eSpark-Backup/colebenson-smartmotors/Design-Files-v3.4/LSS_Bottom_Board_v3.4/Renderings/Isometric_View.PNG

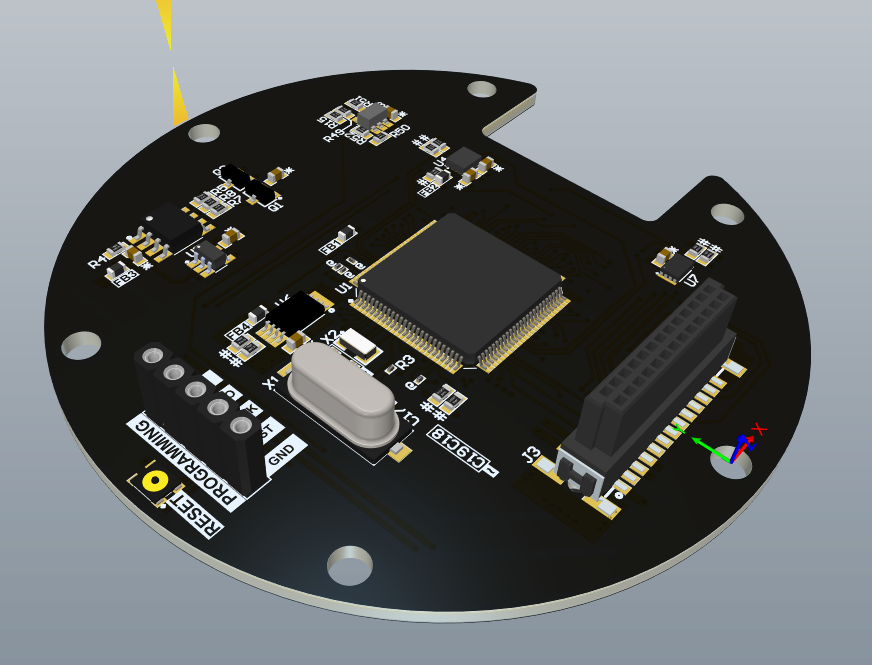
Design-Files-v3.4/LSS_Bottom_Board_v3.4/Renderings/Isometric_View.PNG
