eSpark-Backup/colebenson-smartmotors/Documents/Client-Shared-Files/Sharing-13042021/LSS Pro Board - CAN ICs Selection.pdf

Manufacturer Part Number | Manufacturer | Number of
| | Drivers/Receivers | DuplexData Rate | Voltage - Supply | Receiver Hysteresis | Supplier Device Package | Link
SN65HVD230DR | Texas Instruments | 1/1 | Half | 3V ~ 3.6V | 100mV | 8-SOIC | https://www.digikey.com/product-detail/en/texas-instruments/SN65HVD230DR/296-11654-1-ND/404366
L9616-TR | STMicroelectronics | 1/1 | Half | 4.5V ~ 5.5V | 150mV | 8-SOIC | https://www.digikey.ca/en/products/detail/stmicroelectronics/L9616-TR/715975
TJA1050T/CM,118 | NXP USA Inc. | 1/1 | Half | 4.75V ~ 5.25V | 70mV | 8-SOIC | https://www.digikey.com/products/en/integrated-circuits-ics/interface-drivers-receivers-transceivers/710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
MCP2551-E/SN | Microchip Technology | 1/1 | Half | 4.5V ~ 5.5V | 200mV | 8-SOIC | https://www.digikey.ca/en/products/detail/microchip-technology/MCP2551-E%2FSN/509446?productid=509446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
MAX3051ESA+T | Maxim Integrated | 1/1 | Half | 3.14V ~ 3.47V | 20mV | 8-SOIC | https://www.digikey.ca/en/products/detail/maxim-integrated/MAX3051ESA%2BT/5402433?productid=5402433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
