eSpark-Backup/colebenson-smartmotors/Documents/Client-Shared-Files/Sharing-04042021/JK42HS34-1334 PPM graph .pdf

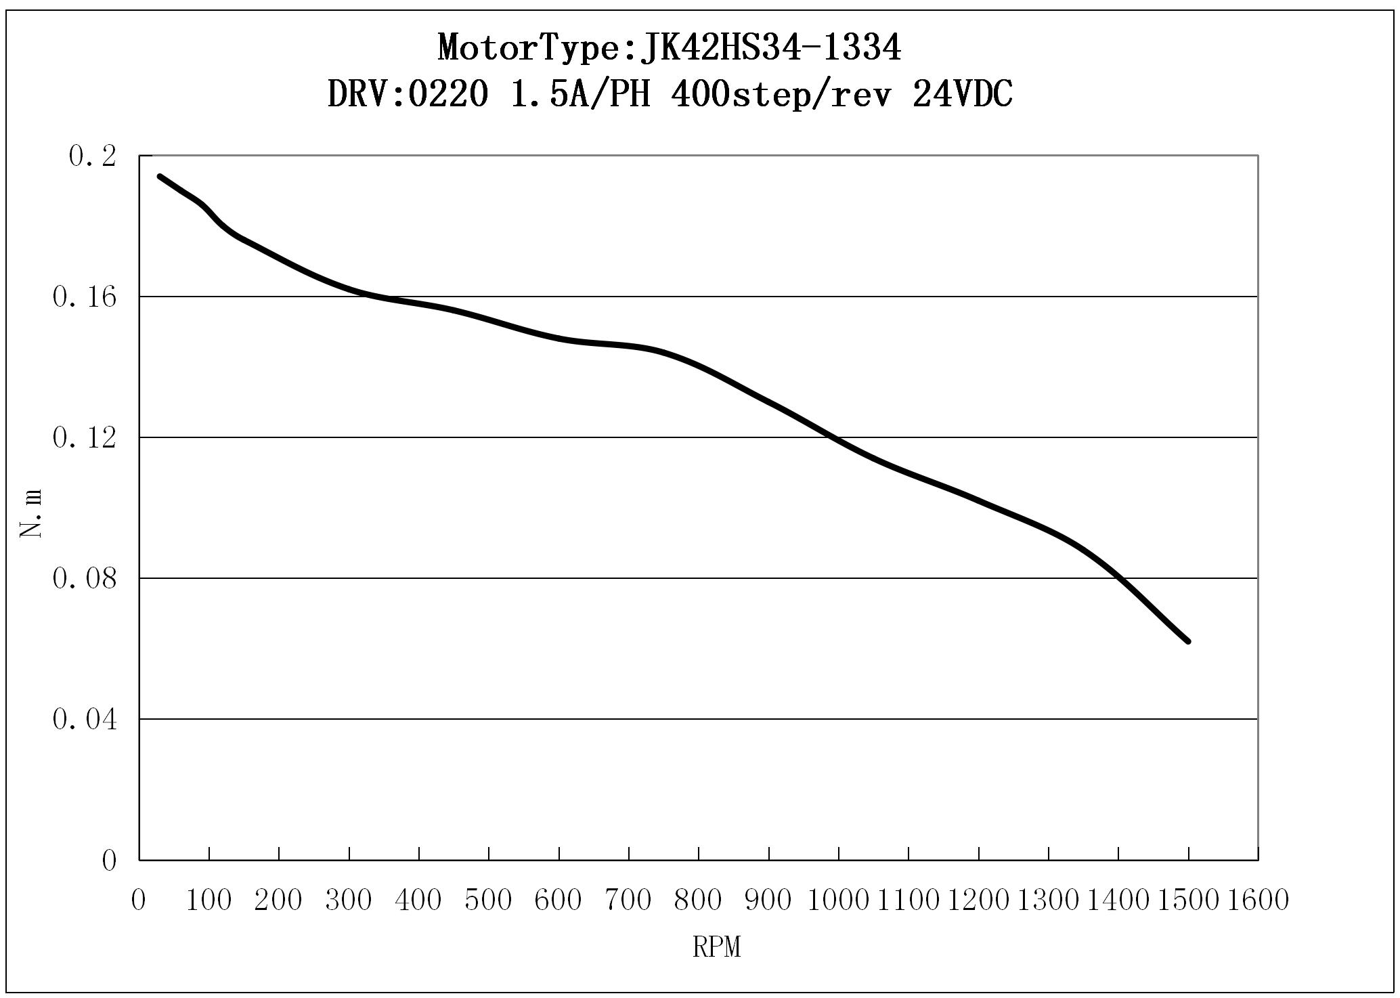
[picture p9: page 1]
