eSpark-Backup/colebenson-smartmotors/Documents/Client-Shared-Files/Sharing-04042021/JK42HS34-1334 torque graph.pdf

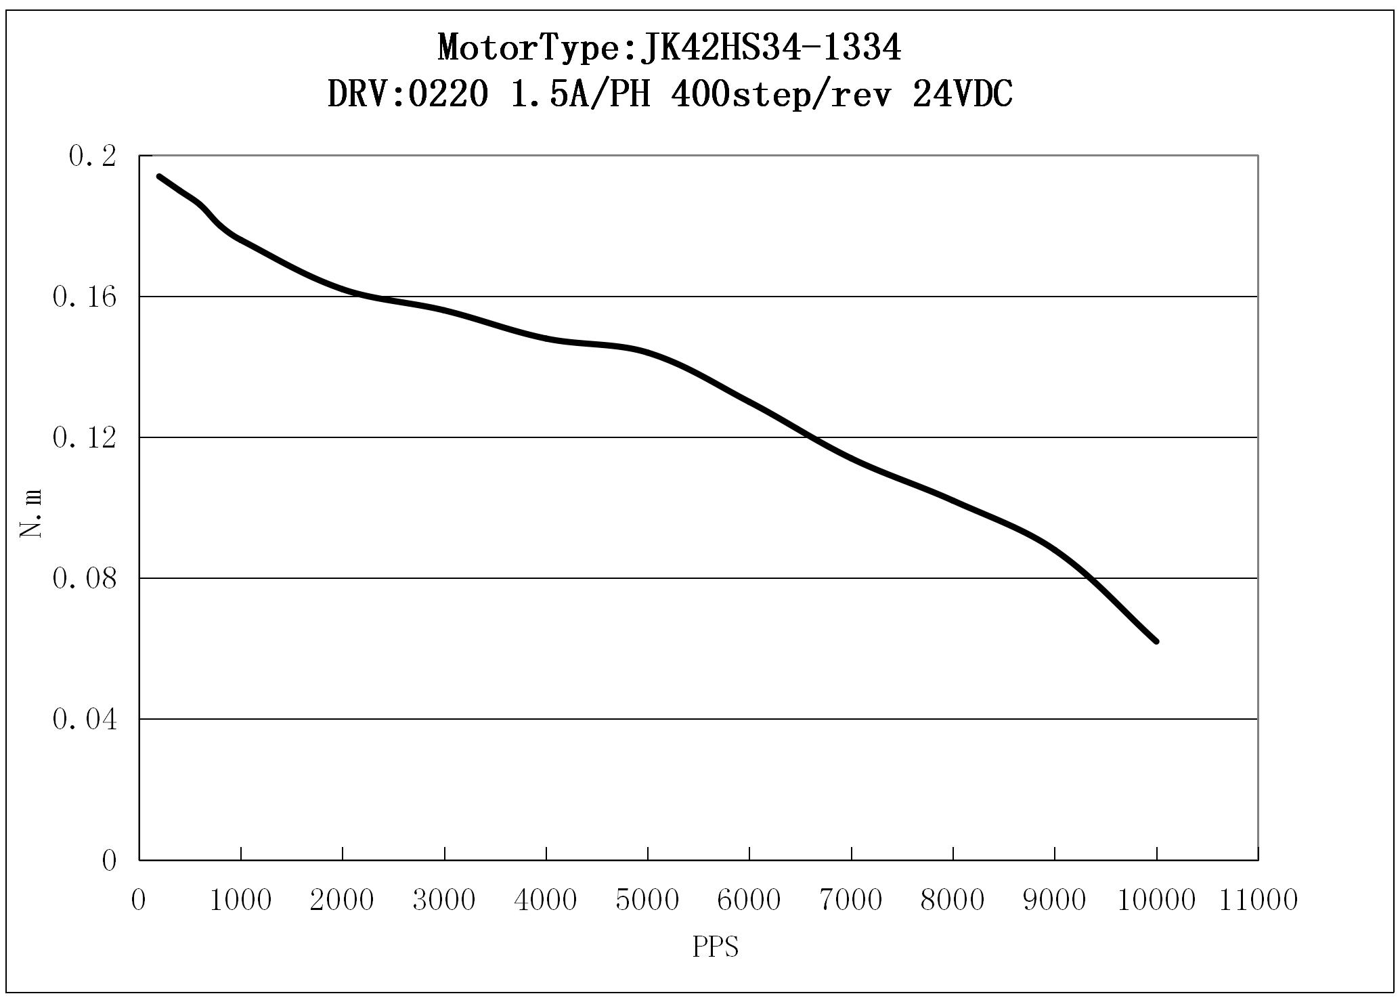
[picture p10: page 1]
