eSpark-Backup/colebenson-smartmotors/Deliverables/SM_Bottom Board/_Renderings/2D_Top_View.PNG

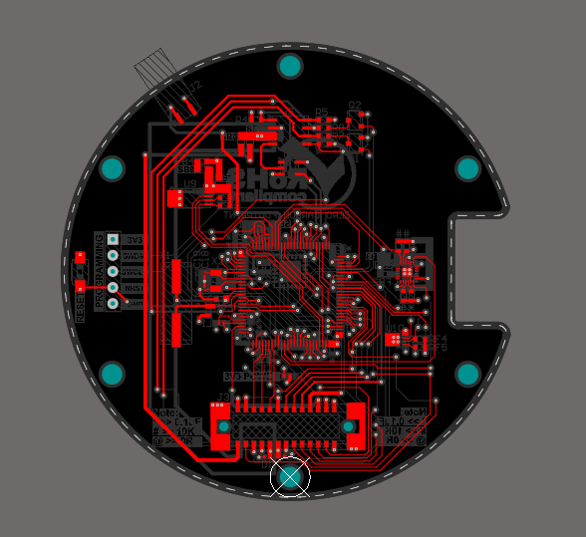
Deliverables/SM_Bottom Board/_Renderings/2D_Top_View.PNG
