eSpark-Backup/colebenson-smartmotors/Deliverables/SM_Bottom Board/_Renderings/3D_Bottom_View.PNG

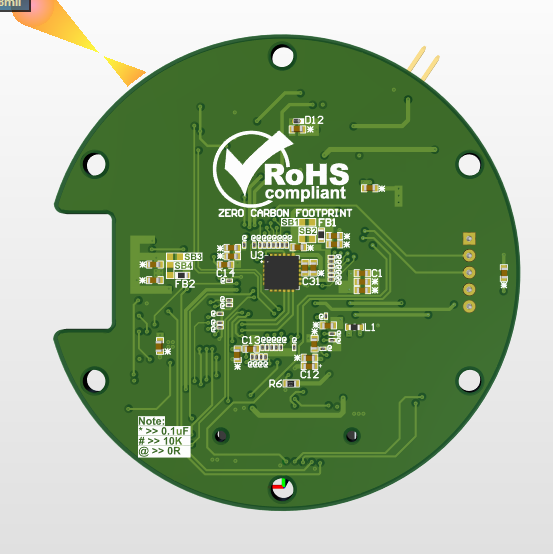
Deliverables/SM_Bottom Board/_Renderings/3D_Bottom_View.PNG
