eSpark-Backup/colebenson-smartmotors/Deliverables/SM_Bottom Board/_Renderings/3D_Isometric.jpg

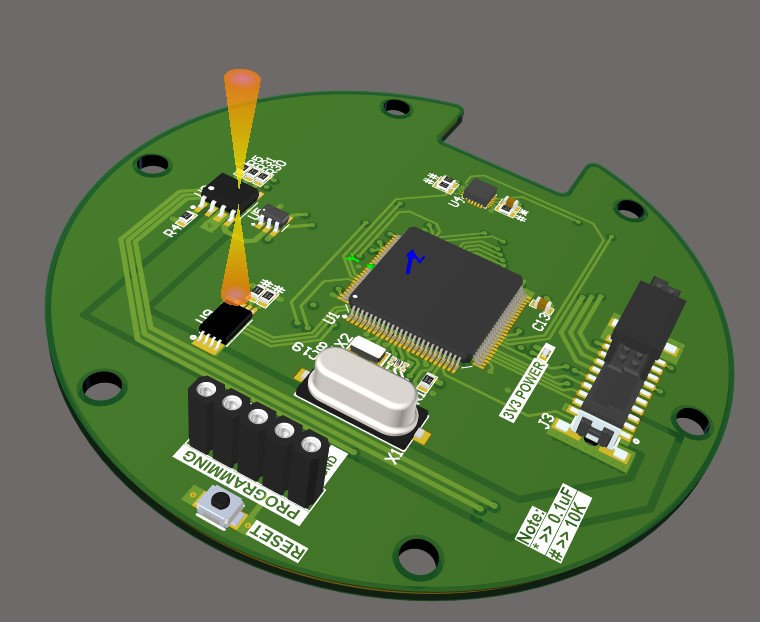
Deliverables/SM_Bottom Board/_Renderings/3D_Isometric.jpg
