eSpark-Backup/colebenson-smartmotors/Deliverables/SM_Bottom Board/_Renderings/3D_Top_View.PNG

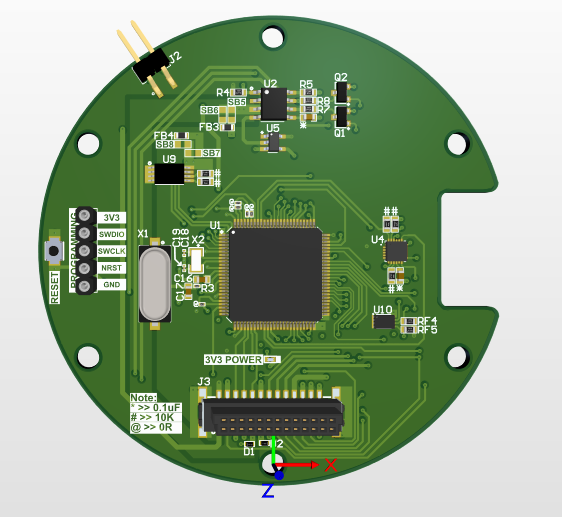
Deliverables/SM_Bottom Board/_Renderings/3D_Top_View.PNG
