eSpark-Backup/colebenson-smartmotors/Deliverables/SM_Bottom Board/_Renderings/GND Plane.jpg

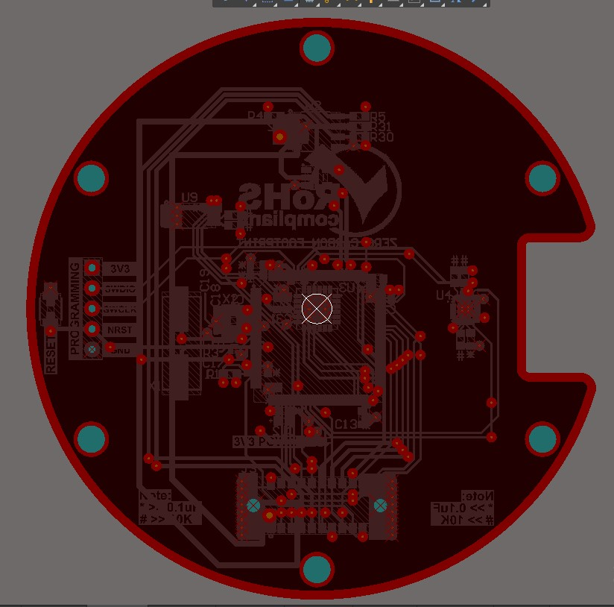
Deliverables/SM_Bottom Board/_Renderings/GND Plane.jpg
