eSpark-Backup/colebenson-smartmotors/Deliverables/SM_Bottom Board/_Renderings/Isometric_View.PNG

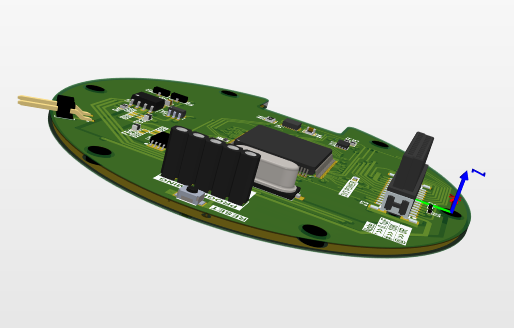
Deliverables/SM_Bottom Board/_Renderings/Isometric_View.PNG
