eSpark-Backup/colebenson-smartmotors/Deliverables/SM_Bottom Board/_Renderings/Top Layer.jpg

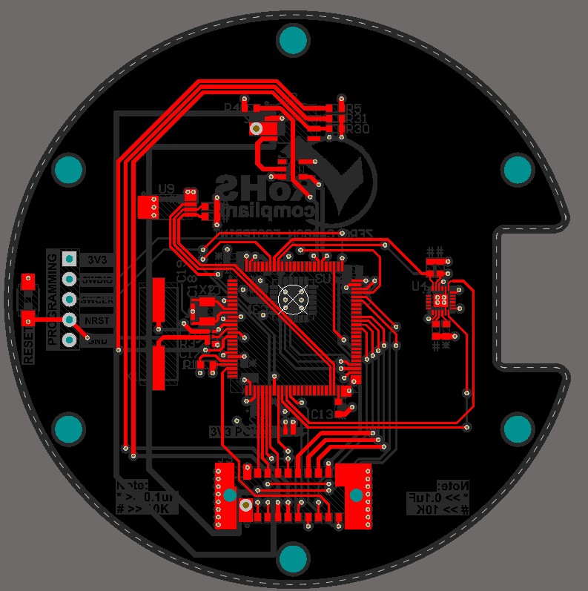
Deliverables/SM_Bottom Board/_Renderings/Top Layer.jpg
