eSpark-Backup/colebenson-smartmotors/Deliverables/SM_Top Board/_Renderings/2D_Top.jpg

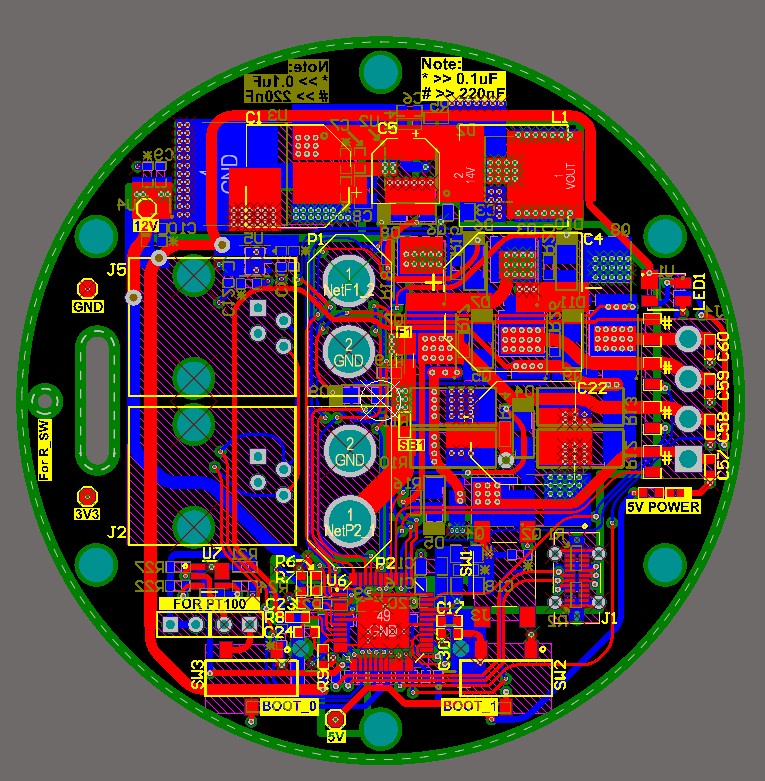
Deliverables/SM_Top Board/_Renderings/2D_Top.jpg
