eSpark-Backup/colebenson-smartmotors/Deliverables/SM_Top Board/_Renderings/3D_Back Edge.jpg

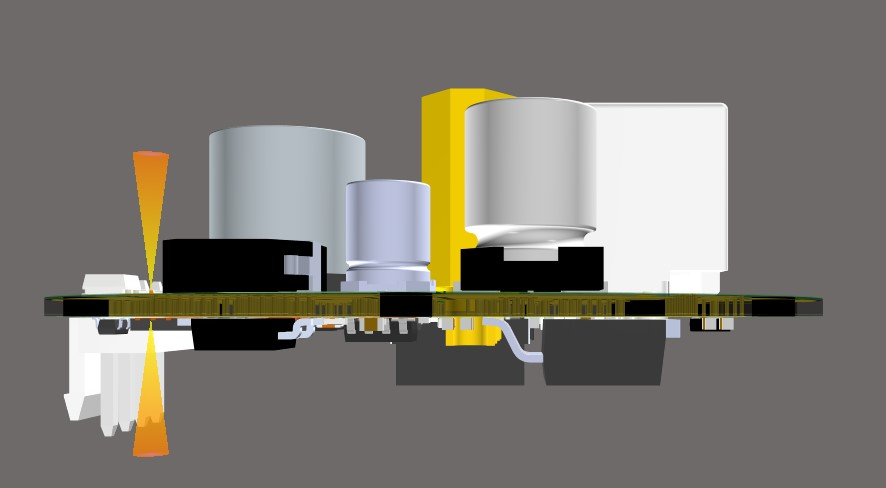
Deliverables/SM_Top Board/_Renderings/3D_Back Edge.jpg
