eSpark-Backup/colebenson-smartmotors/Deliverables/SM_Top Board/_Renderings/3D_Bottom_View.PNG

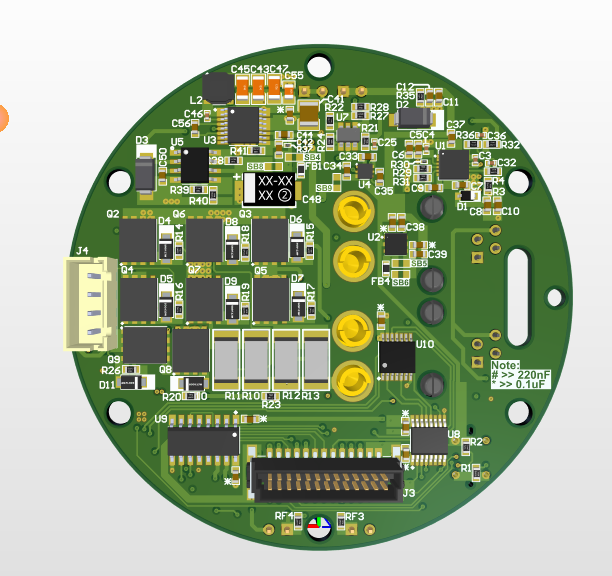
Deliverables/SM_Top Board/_Renderings/3D_Bottom_View.PNG
