eSpark-Backup/colebenson-smartmotors/Deliverables/SM_Top Board/_Renderings/3D_Isometric.jpg

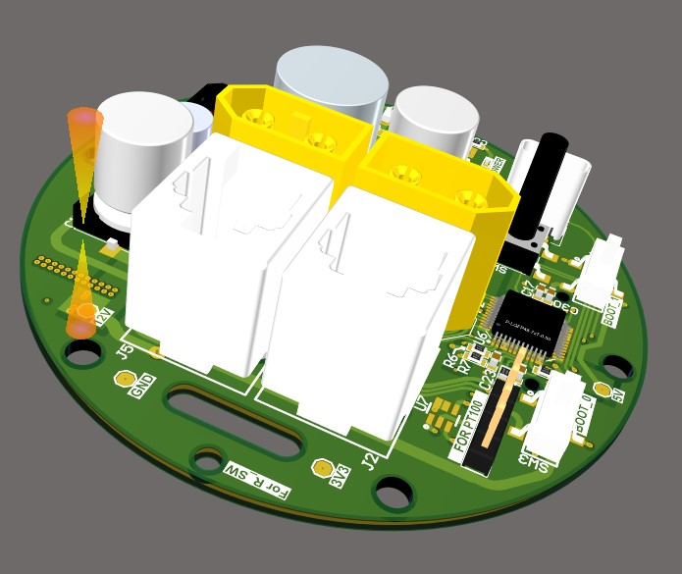
Deliverables/SM_Top Board/_Renderings/3D_Isometric.jpg
