eSpark-Backup/colebenson-smartmotors/Deliverables/SM_Top Board/_Renderings/Bottom_Layer.jpg

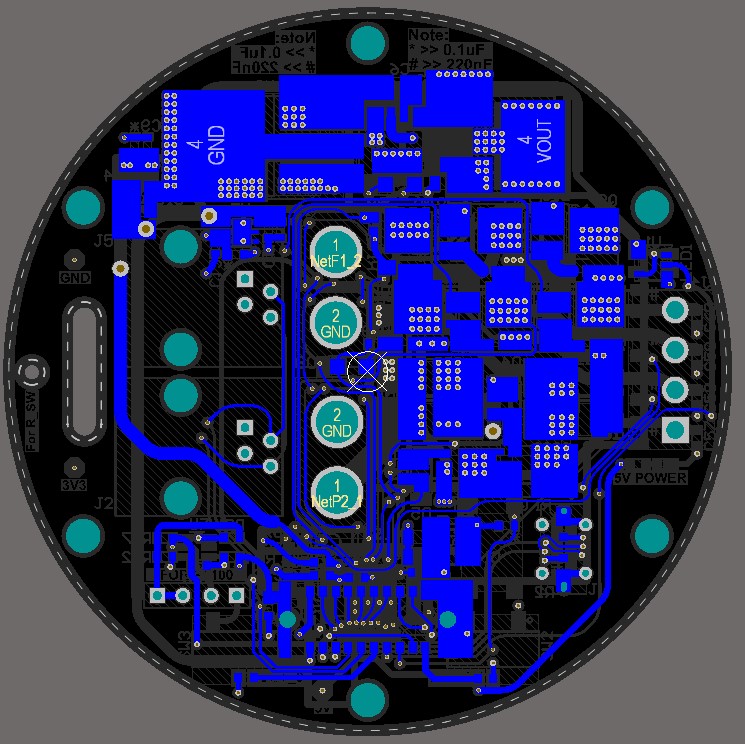
Deliverables/SM_Top Board/_Renderings/Bottom_Layer.jpg
