eSpark-Backup/colebenson-smartmotors/Deliverables/SM_Top Board/_Renderings/Power Plane.jpg

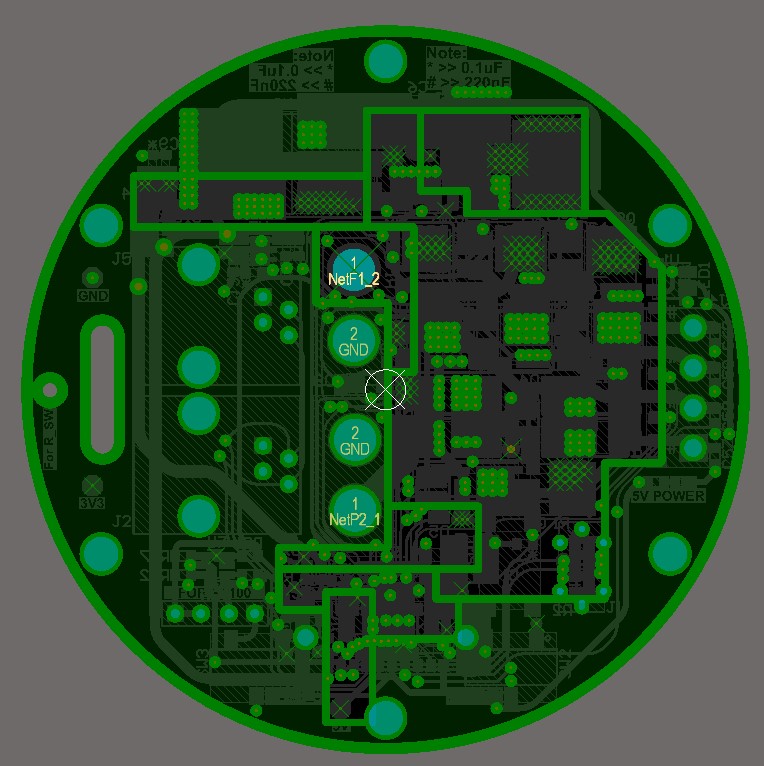
Deliverables/SM_Top Board/_Renderings/Power Plane.jpg
