eSpark-Backup/colebenson-smartmotors/Deliverables/SM_Top Board/_Renderings/Top_Layer.jpg

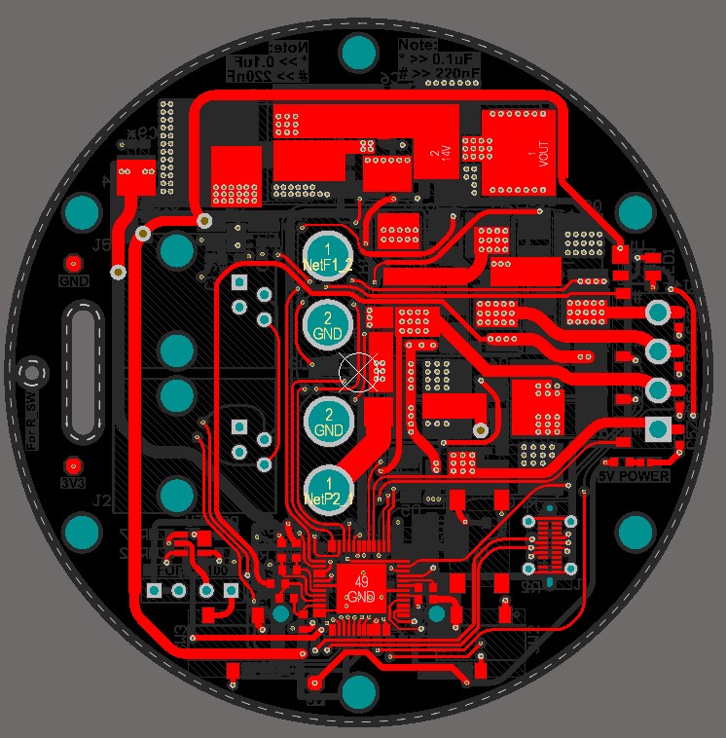
Deliverables/SM_Top Board/_Renderings/Top_Layer.jpg
