eSpark-Backup/colebenson-smartmotors/Design-Files-v3.4/LSS_Sub_Board_v1.1/Renderings/3D_Bottom_View.PNG.png

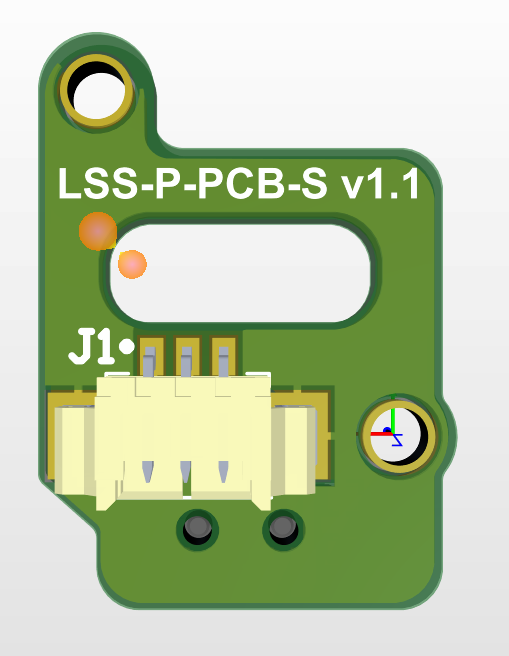
Design-Files-v3.4/LSS_Sub_Board_v1.1/Renderings/3D_Bottom_View.PNG.png
