eSpark-Backup/colebenson-smartmotors/Design-Files-v3.4/LSS_Top_Board_v3.4/Renderings/2D_Bottom_Layer.PNG

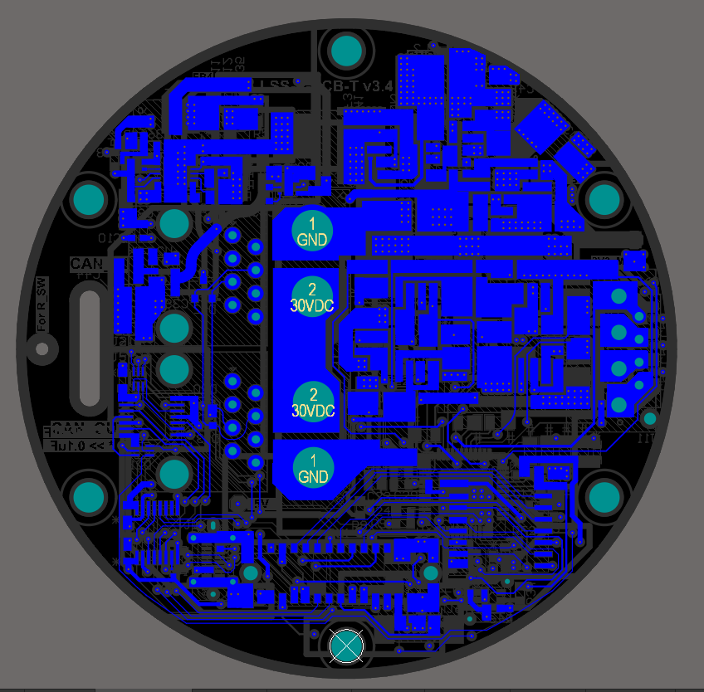
Design-Files-v3.4/LSS_Top_Board_v3.4/Renderings/2D_Bottom_Layer.PNG
