eSpark-Backup/colebenson-smartmotors/Design-Files-v3.4/LSS_Top_Board_v3.4/Renderings/2D_Ground Layer.PNG

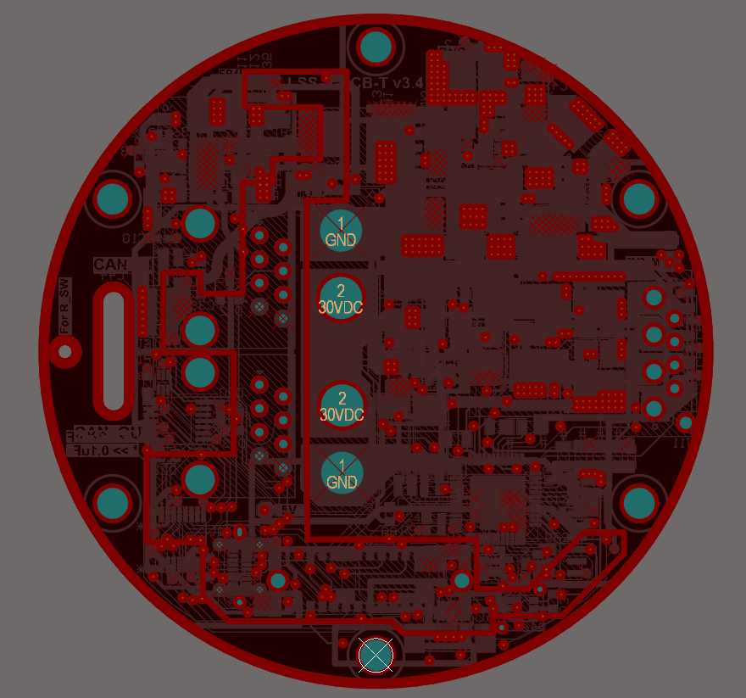
Design-Files-v3.4/LSS_Top_Board_v3.4/Renderings/2D_Ground Layer.PNG
