eSpark-Backup/colebenson-smartmotors/Documents/Client-Shared-Files/Encoder-NoiseCharts/encoder_graph_30V.jpg

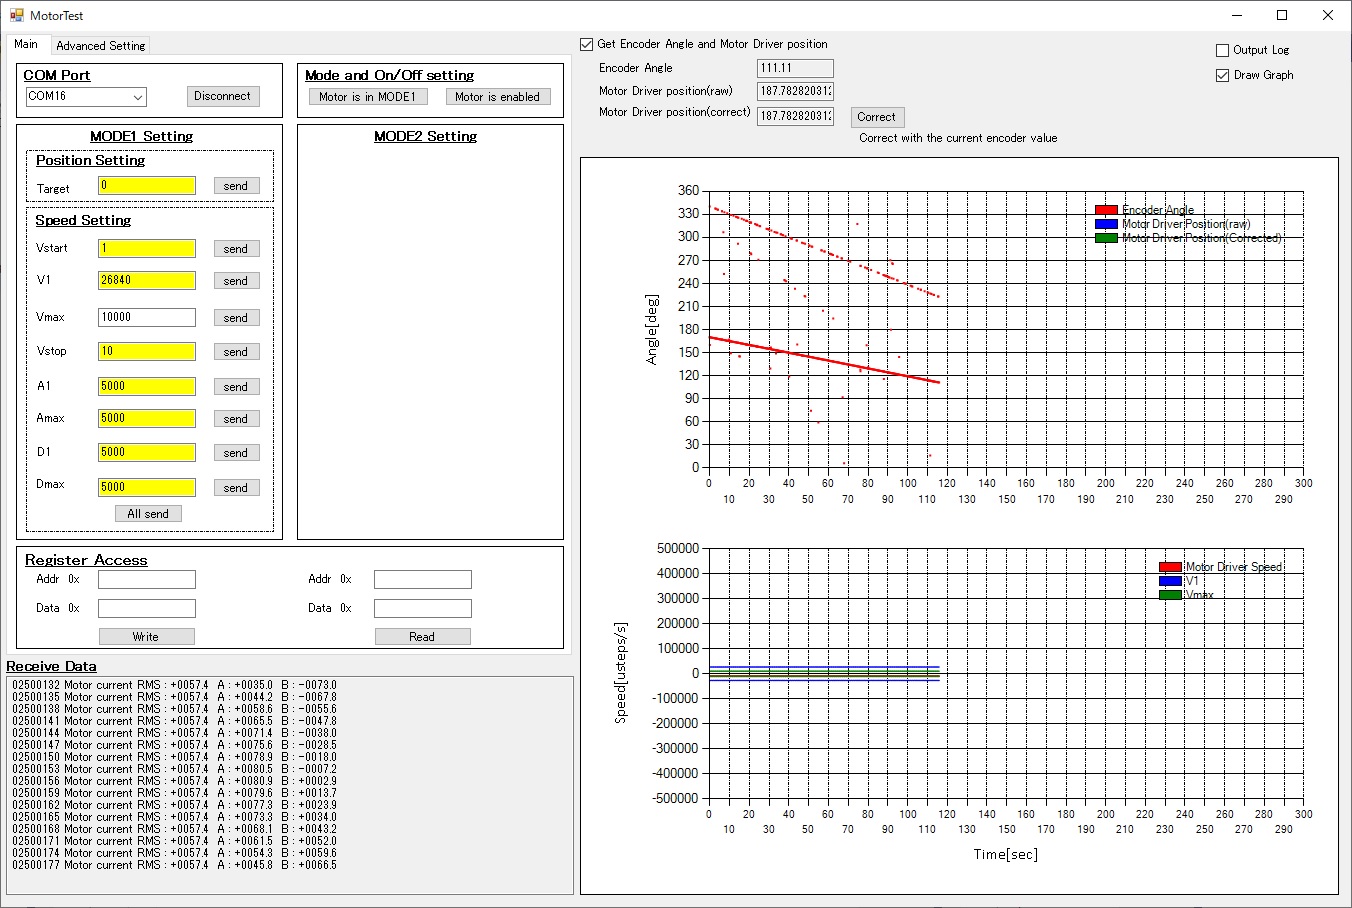
Documents/Client-Shared-Files/Encoder-NoiseCharts/encoder_graph_30V.jpg
