eSpark-Backup/colebenson-smartmotors/Documents/Client-Shared-Files/Sharing-13042021/PRO-PCB-V2 - Incomplete/ele-side-view.png

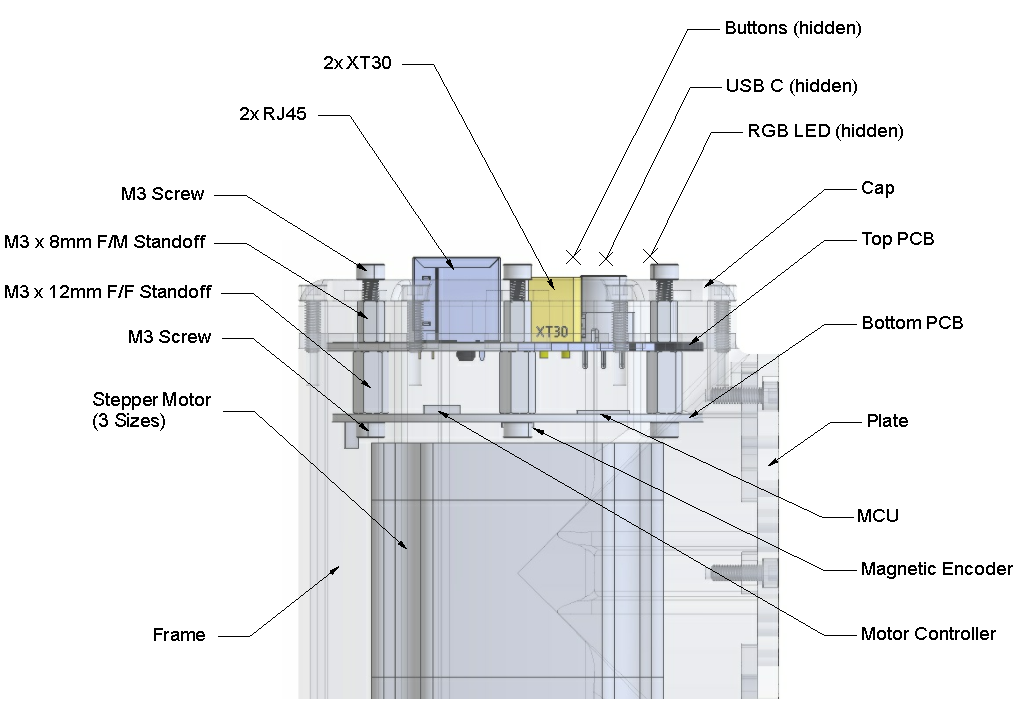
Documents/Client-Shared-Files/Sharing-13042021/PRO-PCB-V2 - Incomplete/ele-side-view.png
