eSpark-Backup/colebenson-smartmotors/Documents/Dev-Shared-Files/Datasheets_Mars/Gyroscoope/Supply voltage query..jpg

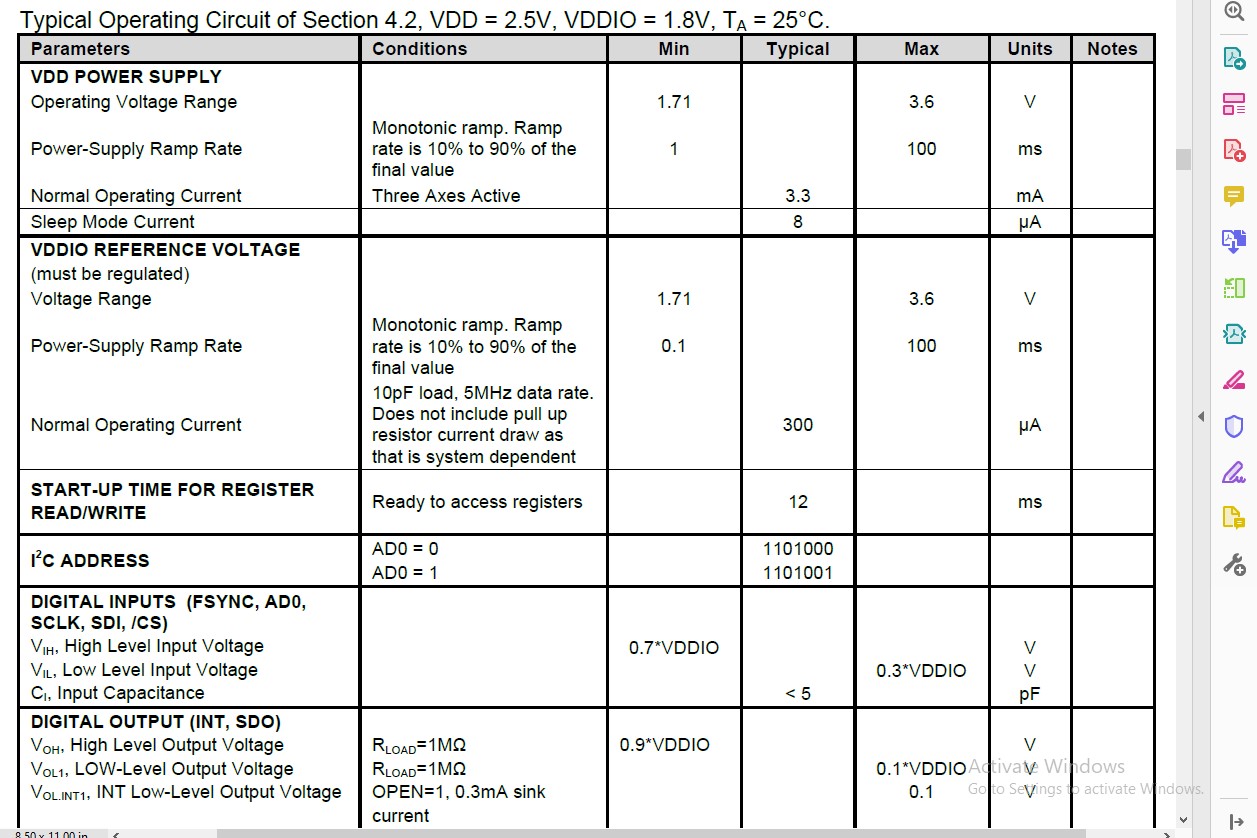
Documents/Dev-Shared-Files/Datasheets_Mars/Gyroscoope/Supply voltage query..jpg
