eSpark-Backup/colebenson-smartmotors/Deliverables/SM_Bottom Board/_BOM/SM_Bottom_PCB.xlsx

Comment | Description | Designator | Footprint | LibRef | Quantity | Case/Package | Manufacturer | Manufacturer Part Number | Package
4.7UF | CAP CER 4.7UF 25V X5R 0603 | C1 | Cap0603 | CL10A475KA8NQNC | 1 | 0603 | Samsung | CL10A475KA8NQNC
0.1UF | Cap Ceramic 0.1uF 50VDC X7R 10% SMD 0603 Paper T/R | C2, C3, C4, C5, C6, C7, C8, C9, C10, C11, C15, C20, C32, C33, C34, C35, C36, C37, C50 | Cap0603 | CL10B104KB8NNNC | 19 | 0603 | Samsung | CL10B104KB8NNNC
1uF | CAP TANT 1UF 20% 25V 0603 | C12 | F981E105MMA | F981E105MMA | 1 | 0603 | Kyocera AVX | F981E105MMA
2.2uF | CAP, 2.2µF, 35V, 10%, X5R, 0603 | C13, C14 | Cap 0603 | GRM188R6YA225KA12D | 2 | 0603 | Murata | GRM188R6YA225KA12D
10pF | CAP CER 10PF 25V C0G 0201 | C16, C17, C18, C19 | CAP 0201 | CGA1A2C0G1E100D030BA | 4 | 0201 | TDK | CGA1A2C0G1E100D030BA
10uF' | CAP CER 10UF 25V X5R 0603 | C31 | Cap0603 | CL10A106MA8NRNC | 1 | 0603 | Samsung | CL10A106MA8NRNC
ESD9L5.0ST5G | TVS DIODE 5V 9.8V SOD923 | D12 | SOD-923 | ESD9L5.0ST5G | 1 | SOD-923-2 | ON Semiconductor | ESD9L5.0ST5G
M55-6012042R | CONN RCPT 1.27MM DUAL SMD 20POS | J3 | M55-6012042R | M55-6012042R | 1 |  | Harwin | M55-6012042R
FBMH1608HL121-TV | Ferrite Beads 120Ohm 25% 100MHz 1.2A 0.13Ohm DCR 0603 Automotive T/R | L1 | IND 0603 | FBMH1608HL121-TV | 1 | 0603 | Taiyo Yuden | FBMH1608HL121-TV
XZVG68W-2 | LED GREEN CLEAR CHIP SMD | LED1 | LED 0402 | XZVG68W-2 | 1 | 0402 | SunLED | XZVG68W-2
TSW-105-17-T-S | CONN HEADER VERT 5POS 2.54MM | P1 | Header 5 | Header 5 pin | 1 |  | Samtec | TSW-105-17-T-S
100R | RES SMD 100 OHM 1% 1/10W 0603 | R1 | Res0603 | RC0603FR-07100RL | 1 | 0603 | Yageo | RC0603FR-07100RL
10K | RES SMD 10K Ohm 1% 1/10W 0603 | R2, R27, RF1, RF2, RF3 | Res0603 | RC0603FR-0710KL | 5 | 0603 | Yageo | RC0603FR-0710KL
806R | Res Thick Film 0201 806 Ohm 1% 1/20W ±200ppm/°C Molded SMD SMD Paper T/R | R3 | Res-0201 | RMCF0201FT806R | 1 | 0201 | Stackpole Electronics | RMCF0201FT806R
1K | RES SMD 1K 0.1W 0603 75 V, Thick Film | R4, R5 | Res0603 | RC0603JR-071KL | 2 | 0603 | Yageo | RC0603JR-071KL
470R | RES SMD 470 OHM 50 V, 0603 100 mW, 1%, | R6 | Res0603 | RC0603FR-07470RL | 1 | 0603 | Yageo | RC0603FR-07470RL
120R | RES SMD 120OHM 0.1W 0603 5%( | R30, R31 | Res0603 | RC0603JR-07120RL | 2 | 0603 | Yageo | RC0603JR-07120RL
K2-1827SR-A3DW-06 | ? EasyEDA Model Description SPST 50mA @ 12VDC Vertical Round Button 3*2.1mm Tactile Switches RoHS | SW1 | K2-1827SR-A3DW-06 | K2-1827SR-A3DW-06 | 1 |  | Korean Hroparts Elec |  | 3*2.1mm
STM32F407VGT7TR | IC MCU 32BIT 1MB FLASH 100LQFP | U1 | LQFP-100 | STM32F407VGT7TR | 1 | LQFP | STMicroelectronics | STM32F407VGT7TR
SN65HVDA1040BQDRQ1 | IC TRANSCEIVER 1/1 8SOIC | U2 | SOIC-8 | SN65HVDA1040BQDRQ1 | 1 |  | Texas Instruments | SN65HVDA1040BQDRQ1
AEAT-8800-Q24 | ROTARY ENCODER MAGNETIC 4096PPR | U3 | QFN-24 | AEAT-8800-Q24 | 1 |  | Broadcom Avago | AEAT-8800-Q24
ICM-20649 | WIDE-FULL SCALE RANGE 6-AXIS MEM | U4 | 24-QFN (3x3) | ICM-20649 | 1 | QFN | TDK InvenSense | ICM-20649
SN74LV1T34DBVR | IC BUF NON-INVERT 5.5V SOT23-5 | U5 | SOT-23-5 | SN74LV1T34DBVR | 1 | SOT-23-5 | Texas Instruments | SN74LV1T34DBVR
MCP9805-BE/ST | IC SENSOR THERMAL 3.0V 8TSSOP | U9 | 8-TSSOP | MCP9805-BE/ST | 1 | TSSOP | Microchip | MCP9805-BE/ST
20MHz | CRYSTAL 20.0000MHZ 18PF SMD | X1 | HCM4920000000ABJT | HCM4920000000ABJT | 1 |  | CITIZEN | HCM4920000000ABJT
ECS-.327-7-34B-C-TR | Crystals 32.768KHz 7pF | X2 | ECS-.327-7-34B-C-TR | ECS-.327-7-34B-C-TR | 1 | SMD/SMT | ECS International | ECS-.327-7-34B-C-TR
