eSpark-Backup/colebenson-smartmotors/Deliverables/SM_Bottom Board/_BOM/Altium_Generated_BOM.xlsx

Comment | Description | Designator | Footprint | LibRef | Quantity | Manufacturer
4.7UF | CAP CER 4.7UF 25V X5R 0603 | C1 | Cap0603 | CL10A475KA8NQNC | 1 | Samsung
0.1UF | Cap Ceramic 0.1uF 50VDC X7R 10% SMD 0603 Paper T/R | C2, C3, C4, C5, C6, C7, C8, C9, C10, C11, C15, C20, C32, C33, C34, C35, C36, C37, C50 | Cap0603 | CL10B104KB8NNNC | 19 | Samsung | same parts
1uF | CAP TANT 1UF 20% 25V 0603 | C12 | F981E105MMA | F981E105MMA | 1 | Kyocera AVX
2.2uF | CAP, 2.2µF, 35V, 10%, X5R, 0603 | C13, C14 | Cap 0603 | GRM188R6YA225KA12D | 2 | Murata
30pF | CAP 30pF NP0 0603 50 V ±5 % SMD | C16, C17 | Cap 0603 | CC0603JRNPO9BN300 | 2 | Yageo
10pF | CAP CER 10PF 25V C0G 0201 | C18, C19 | CAP 0201 | CGA1A2C0G1E100D030BA | 2 | TDK
10uF | CAP CER 10UF 25V X5R 0603 | C31 | Cap0603 | CL10A106MA8NRNC | 1 | Samsung
0.1uF | Cap Ceramic 0.1uF 50VDC X7R 10% SMD 0603 Paper T/R | CF1 | Cap 0603 | CL10B104KB8NNNC | 1 | Samsung
AZ6225-01F.R7GR | Bidirectional 2.5V 3.5V 5V 20A (8/20us) DFN1006P2E TVS RoHS | D1, D2 | AZ6225-01F.R7GR | AZ6225-01F.R7GR | 2 | AMAZING
ESD9L5.0ST5G | TVS DIODE 5V 9.8V SOD923 | D12 | SOD-923 | ESD9L5.0ST5G | 1 | ON Semiconductor
MPZ1608S121ATDH5 | Ferrite Beads Multi-Layer 120Ohm 25% 100MHz 2A 45mOhm DCR 0603 Automotive T/R | FB1, FB2, FB3, FB4 | MPZ1608S121ATDH5 | MPZ1608S121ATDH5 | 4 | TDK
MH254RS-11-02-1000 | 3A Surface Mount Header 1x2 SMD,P=2.54mm Pin Headers ROHS | J2 | MH254RS-11-02-1000 | MH254RS-11-02-1000 | 1 | XFCN
M55-6012642R | CONN RCPT 26POS 0.05 GOLD SMD | J3 | M55-6012642R | M55-6012642R | 1 | Harwin
FBMH1608HL121-TV | Ferrite Beads 120Ohm 25% 100MHz 1.2A 0.13Ohm DCR 0603 Automotive T/R | L1 | IND 0603 | FBMH1608HL121-TV | 1 | Taiyo Yuden
XZVG68W-2 | LED GREEN CLEAR CHIP SMD | LED1 | LED 0402 | XZVG68W-2 | 1 | SunLED
SMC-1-05-1-GT | MACHINE PIN SOCKET 5P 2.54MM PIT | P1 | SMC-1-05-1-GT | SMC-1-05-1-GT | 1 | Adam Equipment
MMBT2222A-7-F | TRANS NPN 40V 0.6A SMD SOT23-3 | Q1, Q2 | SOT-23 | MMBT2222A-7-F | 2 | Diodes
0R | RES SMD 0 OHM JUMPER 1/20W 0201 | R1, R9, R10, R11, R12, R13, R14, R15, R16, R17, R18, R19, R20, R21, R22, R23, R24, R25, R26, R28, R29, R30, R31, R32, R33, R34, R35, R36, R37, R38, R39, R40, R41, R42, R43, R44, R45, R46, R47, R48 | Res-0201 | RC0201JR-070RL | 40 | Yageo
10K | RES SMD 10K Ohm 1% 1/10W 0603 | R2, R27, RF1, RF2, RF3, RF4, RF5 | Res0603 | RC0603FR-0710KL | 7 | Yageo
806R | Res Thick Film 0201 806 Ohm 1% 1/20W ±200ppm/°C Molded SMD SMD Paper T/R | R3 | Res-0201 | RMCF0201FT806R | 1 | Stackpole Electronics
1K | RES SMD 1K 0.1W 0603 75 V, Thick Film | R4, R5 | Res0603 | RC0603JR-071KL | 2 | Yageo
470R | RES SMD 470 OHM 50 V, 0603 100 mW, 1%, | R6 | Res0603 | RC0603FR-07470RL | 1 | Yageo
57R6 | RES SMD 57.6 OHM 1% 1/10W 0603 | R7, R8 | Res0603 | RC0603FR-0757R6L | 2 | Yageo
Solder Bridge | Solder Bridge ON | SB1, SB2, SB3, SB4, SB5, SB6, SB7, SB8 | Solder Bridge | Solder Bridge | 8
B3U-1000P | SWITCH TACTILE SPST-NO 0.05A 12V | SW1 | B3U-1000P | B3U-1000P | 1 | Omron
STM32F407VGT7TR | IC MCU 32BIT 1MB FLASH 100LQFP | U1 | LQFP-100 | STM32F407VGT7TR | 1 | STMicroelectronics
SN65HVDA1040BQDRQ1 | IC TRANSCEIVER 1/1 8SOIC | U2 | SOIC-8 | SN65HVDA1040BQDRQ1 | 1 | Texas Instruments
AEAT-8800-Q24 | ROTARY ENCODER MAGNETIC 4096PPR | U3 | QFN-24 | AEAT-8800-Q24 | 1 | Broadcom Avago
ICM-20649 | WIDE-FULL SCALE RANGE 6-AXIS MEM | U4 | 24-QFN (3x3) | ICM-20649 | 1 | TDK InvenSense
SN74LV1T34DBVR | IC BUF NON-INVERT 5.5V SOT23-5 | U5 | SOT-23-5 | SN74LV1T34DBVR | 1 | Texas Instruments
MCP9805-BE/ST | IC SENSOR THERMAL 3.0V 8TSSOP | U9 | 8-TSSOP | MCP9805-BE/ST | 1 | Microchip
CAT24C32HU4I-GT3 | IC EEPROM 32KBIT I2C 1MHZ 8UDFN | U10 | 8-UDFN-EP (2x3) | CAT24C32HU4I-GT3 | 1 | ON Semiconductor
20MHz | CRYSTAL 20.0000MHZ 18PF SMD | X1 | HCM4920000000ABJT | HCM4920000000ABJT | 1 | CITIZEN
ECS-.327-7-34B-C-TR | Crystals 32.768KHz 7pF | X2 | ECS-.327-7-34B-C-TR | ECS-.327-7-34B-C-TR | 1 | ECS International
