eSpark-Backup/colebenson-smartmotors/Deliverables/SM_Top Board/_BOM/Altium_Generated_BOM.xlsx

Comment | Description | Designator | Footprint | Quantity | Manufacturer | LibRef
220uF | CAP ALUM 220UF 20% 50V SMD | C1 | UCD1H221MNL1GS | 1 | Nichicon | UCD1H221MNL1GS
0.1uF | Cap Ceramic 0.1uF 50VDC X7R 10% SMD 0603 Paper T/R | C2, C13, C51, C52, C53, C54, C61, CF1, CF2 | Cap 0603 | 9 | Samsung | CL10B104KB8NNNC
10nF | CAP CER 10000PF 25V X7R 0402 | C3 | Cap 0402 | 1 | Yageo | CC0402KRX7R8BB103
0.47uF | CAP CER 0.47UF 50V X5R 0402 | C4, C46 | Cap 0402 | 2 | Taiyo Yuden | UMK105ABJ474KV-F
2.2uF | CAP, 2.2µF, 35V, 10%, X5R, 0603 | C5, C6, C14, C23, C24, C29, C34, C35, C56 | Cap 0603 | 9 | Murata | GRM188R6YA225KA12D
1uF | CAP CER 1UF 25V X5R 0603 | C7 | Cap 0603 | 1 | Yageo | CC0603KRX5R8BB105
10uF | CAP CER 10UF 25V X5R 0603 | C8, C10, C11, C12 | Cap 0603 | 4 | Samsung | CL10A106MA8NRNC
82nF | CAP CER 0.082UF 50V X7R 0603 | C9 | Cap 0603 | 1 | Yageo | CC0603KRX7R9BB823
0.1uF | CAP CER 0.1UF 100V X7R 0603 | C15, C20, C40 | Cap 0603 | 3 | Yageo | CC0603KRX7R0BB104
220nF | Cap Ceramic 0.22uF 100V X7R 10% SMD 0805 125°C Embossed T/R | C16, C18, C19, C21 | Cap0805 | 4 | Kyocera AVX | 08051C224K4T2A
22nF | 0603 .022uF 100volts X7R 10% T=0.8mm | C17 | Cap 0603 | 1 | TDK | CGA3E2X7R2A223K080AA
220uF | 220uF ±20% 63V 10mm 14.5mm 1.2A 100kHz 10000hrs 105℃ -55℃~+105℃ SMD,10x14.5mm Aluminum Electrolytic Capacitors - SMD RoHS | C22 | VKME1451J221MV | 1 | Ymin | VKME1451J221MV
0.1UF | CAP CER 0.1UF 50V X7R 0402 | C25, C32 | Cap 0402 | 2 | Samsung | CL05B104KB54PNC
220nF | CAP CER 220nF 35V 0805 | C26, C27, C28, C31 | Cap0805 | 4 | Taiyo Yuden | GMK212BJ224KGHT
0.47uF | CAP CER 0.47uF 50V X7R 0603 | C30 | Cap 0603 | 1 | Taiyo Yuden | UMK107B7474KA-TR
4.7UF | CAP CER 4.7UF 25V X5R 0603 | C33, C38, C39 | Cap 0603 | 3 | Samsung | CL10A475KA8NQNC
1000pF | CAP CER 1000PF 100V X7R 0402 | C36 | Cap 0402 | 1 | Wurth Electronics | 885012205080
2.2nF | CAP CER 2200PF 50V X7R 0603 | C37 | Cap 0603 | 1 | Yageo | CC0603KRX7R9BB222
4.7uF | CAP CER 4.7UF 100V X7S 1210 | C41 | Cap1210 | 1 | Taiyo Yuden | HMK325C7475KN-TE
68pF | Surface Mount Ceramic Multilayer Capacitor 68pF 5% C0G 50V 0603 Paper T/R | C42 | Cap 0603 | 1 | Yageo | CC0603JRNPO9BN680
47uF | CAP CER 1206 47 uF 25 V ±20 % Tol. X5R | C43, C45, C47 | Cap1206 | 3 | Murata | GRM31CR61E476ME44L
20nF | CAP CER 0.02uF 50V X7R 10% SMD 0603 125°C Paper T/R | C44 | Cap 0603 | 1 | Yageo | CC0603KRX7R9BB203
100uF | CAP TANT 100UF 20% 25V 2917 | C48 | CAP- 2917 | 1 | Kyocera AVX | TAJE107M025RNJ
470uF | 470uF ±20% 50V 12.5mm 13.5mm 1000hrs 105℃ -40℃~+105℃ SMD,12.5x13.5mm Aluminum Electrolytic Capacitors - SMD RoHS | C49 | VT1H471MI135000CE0 | 1 | Changzhou Huawei Elec | VT1H471MI135000CE0
470pF | CAP CER 470pF 10% X7R 50V 0603 SMD | C50 | Cap 0603 | 1 | Yageo | CC0603KRX7R9BB471
1uF | CAP CER 1UF 100V X7S 0805 | C55 | Cap0805 | 1 | TDK | C2012X7S2A105K125AB
1nF | CAP CER 1nF 100V X7R 0603 | C57, C58, C59, C60 | Cap 0603 | 4 | Samsung | CL10B102KC8NNNC
CUS10S30,H3F | Diode Schottky 30V 1A Surface Mount USC | D1 | CUS10S30,H3F | 1 | Toshiba | CUS10S30,H3F
SSL110A | 500μA@100V 100V Single 600mV@1A 1A SMA Schottky Barrier Diodes (SBD) ROHS | D2 | SMA | 1 | Yangzhou | SSL110A
SS24A | 40V 500mV@2A 2A SMA(DO-214AC) Schottky Barrier Diodes (SBD) ROHS | D3 | SMA | 1 | Yangzhou | SS24A
PMEG3010ER,115 | DIODE SCHOTTKY 30V 1A SOD123W | D4, D5, D6, D7, D8, D9, D10, D11 | SOD-123W | 8 | Nexperia | PMEG3010ER,115
0685H9150-01 | FUSE BOARD MNT 15A 125VAC 32VDC | F1 | 0685H9150-01 | 1 | Bel | 0685H9150-01
MPZ1608S121ATDH5 | Ferrite Beads Multi-Layer 120Ohm 25% 100MHz 2A 45mOhm DCR 0603 Automotive T/R | FB1, FB2, FB3, FB4 | MPZ1608S121ATDH5 | 4 | TDK | MPZ1608S121ATDH5
MC-318 | Receptacle USB - Type C 24 - SMD USB Connectors ROHS | J1 | MC-318 | 1 | SOFNG | MC-318
5520425-2 | Conn RJ-25 F 6 POS 2.54mm Solder ST Thru-Hole 4 Terminal 1 Port Tray Cat 3 | J2, J5 | 5520425-2 | 2 | TE Connectivity | 5520425-2
M55-7012642R | CONN HEADER SMD 26POS 1.27MM | J3 | M55-7012642R | 1 | Harwin | M55-7012642R
B4B-XH-A(LF)(SN) | CONN HEADER VERT 4POS 2.5MM | J4 | B4B-XH-A(LF)(SN) | 1 | JST | B4B-XH-A(LF)(SN)
220uH | Inductor Power Shielded Wirewound 220uH 20% 1KHz Ferrite 1.3A 310mOhm DCR Blister T/R | L1 | SLF12575T-221M1R3-PF | 1 | TDK | SLF12575T-221M1R3-PF
15uH | 1A 15uH ±20% 190mΩ SMD Power Inductors ROHS | L2 | MPIT4018-150M-LF | 1 | microgate | MPIT4018-150M-LF
LTST-G683GEBW | Standard LEDs - SMD SMD LED Red/Grn/Blue 625/1550/260 mcd | LED1 | LTST-G683GEBW | 1 | Vishay Lite-On | LTST-G683GEBW
XZVG68W-2 | LED GREEN CLEAR CHIP SMD | LED2 | LED 0402 | 1 | SunLED | XZVG68W-2
PRT-10474 | XT60 CONNECTORS MALE/FEMALE PAIR | P1, P2 | PRT-10474 | 2 | SparkFun | PRT-10474
Test Point | Test Point ON | P3, P4, P5, P6 | TEST POINT | 4 |  | TEST POINT
61300211121 | CONN HEADER VERT 2POS 2.54MM | P7, P8, P9, P10 | HDR1X2 | 4 | Wurth Electronics | Header 1x2
BSC072N08NS5ATMA1 | MOSFET N-CH 80V 74A 8TDSON | Q2, Q3, Q4, Q5, Q6, Q7, Q8, Q9 | 8-PowerTDFN | 8 | Infineon | BSC072N08NS5ATMA1
5.1K | RES SMD 5.1K OHM 5% 1/10W 0603 | R1, R2 | Res0603 | 2 | Yageo | RC0603JR-075K1L
3.9K | Res 0603 3.9K Ohm 1% 0.1W(1/10W) ±100ppm/°C Pad SMD T/R | R3 | Res0603 | 1 | Yageo | RC0603FR-073K9L
2K | RES SMD 2K OHM 1% 1/10W 0603 | R4, R35, R39 | Res0603 | 3 | Yageo | RC0603FR-072KL
0R | RES SMD 0R, 1%, 0.1W, 0603 | R5, R32 | Res0603 | 2 | Yageo | RC0603FR-070RL
47R | RES SMD 47OHM 0.1W 0603 | R6, R7, R8, R9 | Res0603 | 4 | Yageo | RC0603FR-0747RL
33m | 0.033Ω ±1% 2W ±1800ppm/°C 2512 Low Resistors & Current Sense Resistors - Surface Mount RoHS | R10, R11, R12, R13 | RES 2512 | 4 | Ever Ohms Tech | CRH2512FR033E04Z
150R | RES SMD 150OHM 1/10W 0603 | R14, R15, R16, R17, R18, R19, R20, R26 | Res0603 | 8 | Yageo | RC0603FR-07150RL
3.01K | RES SMD 3.01K OHM 1% 1/10W 0603 | R21 | Res0603 | 1 | Panasonic | ERJ3EKF3011V
11K | RES SMD 11K, 1%, 0.1W, 0603 | R22 | Res0603 | 1 | Yageo | RC0603FR-0711KL
2R2 | RES SMD 2.2OHM 0603 | R23 | Res0603 | 1 | Panasonic | ERJ3GEYJ2R2V
12.4K | RES SMD 12.4K OHM 1% 1/10W 0603 | R24 | Res0603 | 1 | Yageo | RC0603FR-0712K4L
143R | RES SMD 143 OHM 1% 1/10W 0603 | R25 | Res0603 | 1 | Panasonic | ERJ-3EKF1430V
11.8K | RES SMD 11.8K OHM 1% 1/10W 0603 | R27 | Res0603 | 1 | Yageo | AC0603FR-0711K8L
105K | RES SMD 105K OHM 1% 1/10W 0603 | R28 | Res0603 | 1 | Yageo | RC0603FR-07105KL
127K | RES SMD 127K OHM 1% 1/10W 0603 | R29 | Res0603 | 1 | Yageo | RT0603FRE07127KL
10K | RES SMD 10K OHM 1% 1/20W 0201 | R30 | Res-0201 | 1 | Yageo | RC0201FR-0710KL
301K | RES SMD 301K OHM 0.1% 1/10W 0603 | R31 | Res0603 | 1 | Yageo | RT0603BRE07301KL
240R | Res Thick Film 0603 240 Ohm 1% 1/10W +/-100ppm/ßC Molded SMD Paper T/R | R33, R34 | Res0603 | 2 | Yageo | RC0603FR-07240RL
51.1K | Res SMD 0603 51.1K Ohm 0.1% 1/10W | R36 | Res0603 | 1 | Panasonic | ERA3AEB5112V
1M | RES SMD 1M OHM 1% 1/20W 0201 | R37 | Res-0201 | 1 | Yageo | RC0201FR-071ML
90.9K | Res SMD 0603 90.9K Ohm 1% 1/10W | R38 | Res0603 | 1 | Panasonic | ERJ3EKF9092V
1.2K | ±1% 1/10W Thick Film Resistors 75V ±100ppm/℃ -55℃~+155℃ 1.2kΩ 0603 Chip Resistor - Surface Mount ROHS | R40 | Res0603 | 1 | UNI-ROYAL | 0603WAF1201T5E
0.33R | ±1% 1/10W Thick Film Resistors 75V ±600ppm/℃ -55℃~+155℃ 0.33Ω 0603 Chip Resistor - Surface Mount ROHS | R41 | Res0603 | 1 | RALEC | RTT03R330FTP
10K | RES SMD 10K Ohm 1% 1/10W 0603 | RF1, RF2, RF3, RF4 | Res0603 | 4 | Yageo | RC0603FR-0710KL
Solder Bridge | Solder Bridge ON | SB1, SB2, SB3, SB4, SB5, SB6, SB7, SB8, SB9, SB10, SB11 | Solder Bridge | 11 |  | Solder Bridge
Tactile Switch 13mm Actuator | Memontary Tactile Push Button Switch 6X6X4.3 / 4.5 / 5/6/7/8/9/10 / 13mm SMD | SW1 | Tactile Switch 13mm Actuator | 1 | WIN ELEC-TECH CO., LTD | Tactile Switch 13mm Actuator
750314597 | XFRMR ISOL BUCK DC/DC CONV SMD | T1 | 750314597 | 1 | Wurth Electronics Midcom | 750314597
LM5160ADNTR | IC REG BUCK FLYBCK ADJ 12WSON | U1 | LM5160ADNTR | 1 | Texas Instruments | LM5160ADNTR
NCP708MU330TAG | IC REG LINEAR 3.3V 1A 6UDFN | U2 | 6-UDFN (3x3) | 1 | ON Semiconductor | NCP708MU330TAG
LM43603PWPR | 3.5V to 36V, 3A Synchronous Step-Down Voltage Converter 16-HTSSOP -40 to 125 | U3 | HTSSOP-16 | 1 | Texas Instruments | LM43603PWPR
TPS60150DRVR | IC REG CHARGE PUMP 5V 140MA 6SON | U4 | TPS60150DRVR | 1 | Texas Instruments | TPS60150DRVR
MC34063ADR | 1.5-A boost, buck, inverting switching regulator, operation from 0°C to 70°C 8-SOIC 0 to 70 | U5 | SOIC-8 | 1 | Texas Instruments | MC34063ADR
TMC5160A-TA-T | IC MTR DRVR BIPOLAR 8-60V 48TQFP | U6 | 48-tqfp-ep (7x7) | 1 | Trinamic | TMC5160A-TA-T
MAX4236EUT+T | IC OPAMP GP 1.7MHZ RRO SOT23-6 | U7 | SOT-23-6 | 1 | Maxim | MAX4236EUT+T
ISO7741QDBQQ1 | DGTL ISO 3000VRMS 4CH 16SSOP | U8 | ISO7741QDBQQ1 | 1 | Texas Instruments | ISO7741QDBQQ1
MAX14850ASE+ | DGTL ISO 600VRMS 6CH GP 16SOIC | U9 | MAX14850ASE+ | 1 | Maxim | MAX14850ASE+
SN74LVTH125PWR | IC BUS BUFFER TRI-ST QD 14TSSOP | U10 | SN74LVTH125PWR | 1 | Texas Instruments | SN74LVTH125PWR
