eSpark-Backup/colebenson-smartmotors/Documents/Client-Shared-Files/Sharing-13042021/LSS Pro Board  - BOM & Cost-incomplete.xlsx

Sheet: LSS Pro V0.2 BOM DK vs LCSC (Wo
LSS Pro Board V0.2 |  |  |  |  |  |  |  |  | 1 | 100
Part | QTY/Bd | MF SKU | Digikey SKU | Value | Manufacturer | Package | Description | Digikey | Unit Price (USD) | 100qty Price (USD) | Total Unit Price (USD) | Total 100qty Price (USD) | LCSC | Unit Price (USD) | 100qty Price (USD) | Total Unit Price (USD) | Total 100qty Price (USD) | Diff (DK-LCSC) | Chosen Source | ROHS | 100qty Price (USD) | Total 100qty Price (USD) | Packaging | Qty ordered | Order Note
Top PCB
 | 2 | A-2014-2S-4-N-R | AE10399-ND | - | Assmann WSW Components | - | CONN MOD JACK 8P8C VERT SHIELDED | https://www.digikey.ca/en/products/detail/assmann-wsw-components/A-2014-2S-4-N-R/2183650
 | 1 | 10132328-10011LF | 609-5380-1-ND | - | Amphenol ICC (FCI) | - | CONN RCPT USB3.1 TYPEC 24POS SMD | https://www.digikey.ca/en/products/detail/amphenol-icc-fci/10132328-10011LF/8555651
 | 1 | D6R90 F2 LFS | 401-1995-ND | - | C&K | - | SWITCH PUSH SPST-NO 0.1A 32V | https://www.digikey.ca/en/products/detail/c-k/D6R90-F2-LFS/1466352
Bottom PCB
U1 | 1 | STM32F413VGT6 | 497-17009-ND | - | STMicroelectronics | LQFP-100 | IC MCU 32BIT 1MB FLASH 100LQFP | https://www.digikey.ca/product-detail/en/stmicroelectronics/STM32F413VGT6/497-17009-ND/6564701 | 11.15 | 8.34 | 11.15 | 834.00 | - | - | - | - | - | - | https://www.digikey.ca/product-detail/en/stmicroelectronics/STM32F413VGT6/497-17009-ND/6564701 | TRUE | 8.34 | 834.00 | Tray |  | 0 stock DK/LCSC
U2 | 1 | AEAT-8800-Q24 | 516-3787-ND | - | Broadcom Limited | QFN-24 | ROTARY ENCODER MAGNETIC 4096PPR | https://www.digikey.ca/product-detail/en/broadcom-limited/AEAT-8800-Q24/516-3787-ND/6681014 | 8.00 | 5.99 | 8.00 | 599.00 | - | - | - | - | - | - | https://www.digikey.ca/product-detail/en/broadcom-limited/AEAT-8800-Q24/516-3787-ND/6681014 | TRUE | 5.99 | 599.00 | CT
U3 | 1 | POWERSTEP01 | 497-15441-ND | - | STMicroelectronics | VFQFPN-89 | IC MTR DRV BIPLR 3.3/5V 89VFQFPN | https://www.digikey.ca/product-detail/en/stmicroelectronics/POWERSTEP01/497-15441-ND/5237153 | 10.71 | 7.65 | 10.71 | 765.00 | https://lcsc.com/product-detail/Motor-Drivers_STMicroelectronics-POWERSTEP01_C80192.html | 10.35 | 8.49 | 10.35 | 849.00 | -84.00 | https://www.digikey.ca/product-detail/en/stmicroelectronics/POWERSTEP01/497-15441-ND/5237153 | TRUE | 7.65 | 765.00 | Tray
U4 | 1 | ICM-20600 | 1428-1147-1-ND | - | TDK InvenSense | LGA-14 | LOW-POWER, HIGH-PERFORMANCE INTE | https://www.digikey.ca/product-detail/en/tdk-invensense/ICM-20600/1428-1147-1-ND/9602942 | 3.70 | 2.01 | 3.70 | 201.00 | https://lcsc.com/product-detail/Motion-Sensors-Accelerometers_TDK-InvenSense-ICM-20600_C124140.html | 1.42 | 0.93 | 1.42 | 93.00 | 108.00 | https://lcsc.com/product-detail/Motion-Sensors-Accelerometers_TDK-InvenSense-ICM-20600_C124140.html | TRUE | 0.93 | 93.00 | CT
U5, U6 | 2 | SN74LVC1G126DCKR | 296-11606-1-ND | - | Texas Instruments | SC-70-5 | IC BUF NON-INVERT 5.5V SC70-5 | https://www.digikey.ca/product-detail/en/texas-instruments/SN74LVC1G126DCKR/296-11606-1-ND/385745 | 0.29 | 0.12 | 0.58 | 25.00 | https://lcsc.com/product-detail/Logic-Buffers-Drivers-Receivers-Transceivers_Texas-Instruments-SN74LVC1G126DCKR_C88039.html | 0.07 | 0.05 | 0.14 | 10.48 | 14.52 | https://lcsc.com/product-detail/Logic-Buffers-Drivers-Receivers-Transceivers_Texas-Instruments-SN74LVC1G126DCKR_C88039.html | TRUE | 0.05 | 10.48 | CT
PS1 | 1 | TS30042-M050QFNR | TS30042-M050QFNRCT-ND | - | Semtech Corporation | VFQFN-16 | IC REG BUCK 5V 2A 16QFN | https://www.digikey.ca/product-detail/en/semtech-corporation/TS30042-M050QFNR/TS30042-M050QFNRCT-ND/6605537 | 1.51 | 1.03 | 1.51 | 102.60 | - | - | - | - | - | - | https://www.digikey.ca/product-detail/en/semtech-corporation/TS30042-M050QFNR/TS30042-M050QFNRCT-ND/6605537 | TRUE | 1.03 | 102.60 | CT
PS2, PS3 | 2 | AP7361C-33E-13 | AP7361C-33E-13DICT-ND | - | Diodes Incorporated | SOT-223 | IC REG LINEAR 3.3V 1A SOT223 | https://www.digikey.ca/product-detail/en/diodes-incorporated/AP7361C-33E-13/AP7361C-33E-13DICT-ND/5638331 | 0.58 | 0.34 | 1.16 | 68.28 | https://lcsc.com/product-detail/Linear-Voltage-Regulators_Diodes-Incorporated-AP7361C-33E-13_C500795.html | 0.64 | 0.60 | 1.29 | 120.59 | -52.31 | https://www.digikey.ca/product-detail/en/diodes-incorporated/AP7361C-33E-13/AP7361C-33E-13DICT-ND/5638331 | TRUE | 0.34 | 68.28 | CT
PS4 | 1 | REF3133AIDBZR | 296-41483-1-ND | - | Texas Instruments | SOT-23-3 | IC VREF SERIES 3.3V SOT23-3 | https://www.digikey.ca/product-detail/en/texas-instruments/REF3133AIDBZR/296-41483-1-ND/5222876 | 2.57 | 1.74 | 2.57 | 174.20 | - | - | - | - | - | - | https://www.digikey.ca/product-detail/en/texas-instruments/REF3133AIDBZR/296-41483-1-ND/5222876 | TRUE | 1.74 | 174.20 | CT
D1 | 1 | PMEG4030ER,115 | 1727-5313-1-ND | - | Nexperia USA Inc. | SOD-123W | DIODE SCHOTTKY 40V 3A SOD123W | https://www.digikey.ca/product-detail/en/nexperia-usa-inc/PMEG4030ER115/1727-5313-1-ND/2676789 | 0.45 | 0.16 | 0.45 | 15.95 | https://lcsc.com/product-detail/Schottky-Barrier-Diodes-SBD_Nexperia-PMEG4030ER-115_C389355.html | 0.09 | 0.07 | 0.09 | 6.86 | 9.09 | https://lcsc.com/product-detail/Schottky-Barrier-Diodes-SBD_Nexperia-PMEG4030ER-115_C389355.html | TRUE | 0.07 | 6.86 | CT
D2 | 1 | ESDA6V1BC6 | 497-6635-1-ND | - | STMicroelectronics | SOT-23-6 | TVS DIODE 5V SOT23-6 | https://www.digikey.ca/product-detail/en/stmicroelectronics/ESDA6V1BC6/497-6635-1-ND/1865413 | 0.37 | 0.17 | 0.37 | 17.23 | - | - | - | - | - | - | https://www.digikey.ca/product-detail/en/stmicroelectronics/ESDA6V1BC6/497-6635-1-ND/1865413 | TRUE | 0.17 | 17.23 | CT
D3 | 1 | BAR43SFILM | 497-2515-1-ND | - | STMicroelectronics | SOT-23-3 | DIODE ARRAY SCHOTTKY 30V SOT23-3 | https://www.digikey.ca/product-detail/en/stmicroelectronics/BAR43SFILM/497-2515-1-ND/603897 | 0.37 | 0.12 | 0.37 | 12.23 | - | - | - | - | - | - | https://www.digikey.ca/product-detail/en/stmicroelectronics/BAR43SFILM/497-2515-1-ND/603897 | TRUE | 0.12 | 12.23 | CT
Temp | 1 | NTCLE203E3472GB0 | BC2457-ND | 4.7k | Vishay BC Components | Bead | THERM NTC 4.7KOHM 3977K BEAD | https://www.digikey.ca/product-detail/en/vishay-bc-components/NTCLE203E3472GB0/BC2457-ND/2230785 | 1.45 | 0.77 | 1.45 | 77.02 | - | - | - | - | - | - | https://www.digikey.ca/product-detail/en/vishay-bc-components/NTCLE203E3472GB0/BC2457-ND/2230785 | TRUE | 0.77 | 77.02 | Bulk
BUSY | 1 | LTST-C191KRKT | 160-1447-1-ND | Red | Lite-On Inc. | LED0603 | LED RED CLEAR SMD | https://www.digikey.ca/product-detail/en/lite-on-inc/LTST-C191KRKT/160-1447-1-ND/386836 | 0.26 | 0.09 | 0.26 | 9.00 | https://lcsc.com/product-detail/Light-Emitting-Diodes-LED_Lite-On-LTST-C191KRKT_C125099.html | - | 0.02 | - | 1.70 | 7.30 | https://lcsc.com/product-detail/Light-Emitting-Diodes-LED_Lite-On-LTST-C191KRKT_C125099.html | TRUE | 0.02 | 1.70 | CT
FLAG | 1 | LTST-C194TBKT | 160-1837-1-ND | Blue | Lite-On Inc. | LED0603 | LED BLUE CLEAR SMD | https://www.digikey.ca/product-detail/en/lite-on-inc/LTST-C194TBKT/160-1837-1-ND/2356236 | 0.42 | 0.14 | 0.42 | 13.50 | https://lcsc.com/product-detail/Light-Emitting-Diodes-LED_blue_C99290.html | - | 0.02 | - | 2.32 | 11.18 | https://lcsc.com/product-detail/Light-Emitting-Diodes-LED_blue_C99290.html | TRUE | 0.02 | 2.32 | CT
PWR | 1 | 5988070107F | 350-2035-1-ND | Green | Dialight | LED0603 | LED GREEN CLEAR 0603 SMD | https://www.digikey.ca/product-detail/en/dialight/5988070107F/350-2035-1-ND/1291339 | 0.42 | 0.13 | 0.42 | 13.00 | https://lcsc.com/product-detail/Light-Emitting-Diodes-LED_Lite-On-LTST-C191KGKT_C125098.html | - | 0.02 | - | 1.85 | 11.15 | https://lcsc.com/product-detail/Light-Emitting-Diodes-LED_Lite-On-LTST-C191KGKT_C125098.html | TRUE | 0.02 | 1.85 | CT
LED1, LED2, LED3, LED4, LED5, LED6 | 6 | WS2812B | 1528-1104-ND | RGB | Worldsemi | LED5050 | ADDRESS LED DISCR SER RGB | https://www.digikey.ca/product-detail/en/sparkfun-electronics/COM-16346/1568-COM-16346-ND/11630211 | - | 0.50 | - | 300.00 | https://lcsc.com/product-detail/Light-Emitting-Diodes-LED_Worldsemi-WS2812B-B_C114586.html | 0.10 | 0.07 | 0.60 | 44.46 | 255.54 | https://lcsc.com/product-detail/Light-Emitting-Diodes-LED_Worldsemi-WS2812B-B_C114586.html | TRUE | 0.07 | 44.46 | CT
Q1 | 1 | BSS138 | BSS138CT-ND | - | ON Semiconductor | SOT-23-3 | MOSFET N-CH 50V 220MA SOT-23 | https://www.digikey.ca/product-detail/en/on-semiconductor/BSS138/BSS138CT-ND/244294 | 0.26 | 0.09 | 0.26 | 8.76 | https://lcsc.com/product-detail/MOSFET_MDD-Microdiode-Electronics-BSS138_C427380.html | 0.01 | 0.01 | 0.01 | 1.50 | 7.26 | https://lcsc.com/product-detail/MOSFET_MDD-Microdiode-Electronics-BSS138_C427380.html | TRUE | 0.01 | 1.50 | CT
S1 | 1 | TL3342F160QG/TR | EG2531CT-ND | - | E-Switch | - | SWITCH TACTILE SPST-NO 0.05A 12V | https://www.digikey.ca/product-detail/en/e-switch/TL3342F160QG-TR/EG2531CT-ND/379004 | 0.65 | 0.52 | 0.65 | 51.98 | https://lcsc.com/product-detail/Tactile-Switches_SOFNG-TS-1187-1816_C183614.html | - | 0.04 | - | 4.15 | 47.83 | https://lcsc.com/product-detail/Tactile-Switches_SOFNG-TS-1187-1816_C183614.html | TRUE | 0.04 | 4.15 | CT
Y1 | 1 | NX3215SA-32.768KHZ-EXS00A-MU00525 | 644-1386-1-ND | 32.768KHz | NDK America, Inc. | 2-SMD, No Lead | CRYSTAL 32.768KHZ 6PF SMD | https://www.digikey.ca/product-detail/en/ndk-america-inc/NX3215SA-32.768KHZ-EXS00A-MU00525/644-1386-1-ND/9172114 | 0.68 | 0.50 | 0.68 | 49.74 | - | - | - | - | - | - | https://www.digikey.ca/product-detail/en/ndk-america-inc/NX3215SA-32.768KHZ-EXS00A-MU00525/644-1386-1-ND/9172114 | TRUE | 0.50 | 49.74 | CT
Y2 | 1 | NX3225SA-16.000M-STD-CRS-2 | 644-1129-1-ND | 16MHz | NDK America, Inc. | 4-SMD, No Lead | CRYSTAL 16.0000MHZ 8PF SMD | https://www.digikey.ca/product-detail/en/ndk-america-inc/NX3225SA-16.000M-STD-CRS-2/644-1129-1-ND/1788484 | 1.06 | 0.77 | 1.06 | 77.33 | - | - | - | - | - | - | https://www.digikey.ca/product-detail/en/ndk-america-inc/NX3225SA-16.000M-STD-CRS-2/644-1129-1-ND/1788484 | TRUE | 0.77 | 77.33 | CT
J1, J2 | 2 | XT30-M | - | - | Amass | - | XT30 MALE CONN | https://www.tme.eu/en/details/xt30u-m/dc-power-connectors/amass/ | 0.78 | 0.45 | 1.56 | 90.00 | - | - | - | - | - | - | https://www.tme.eu/en/details/xt30u-m/dc-power-connectors/amass/ | TRUE | 0.45 | 90.00 | Bulk |  | Not available from DK
J3 | 1 | 651005136421 | 732-2735-ND | - | Wurth Electronics Inc. | - | CONN RCPT USB2.0 MINI B VERT | https://www.digikey.ca/products/en?keywords=651005136421 | 2.97 | 2.22 | 2.97 | 221.80 | - | - | - | - | - | - | https://www.digikey.ca/products/en?keywords=651005136421 | TRUE | 2.22 | 221.80 | Tray
J4 | 1 | JST-XH-4 | - | - | JST | - | JST XH 4PIN CONN 2.54MM PITCH |  |  |  |  |  |  |  |  |  |  |  |  | FALSE |  |  |  |  | 2.54mm version N/A
L1 | 1 | 744774047 | 732-1266-1-ND | 4.7µH | Wurth Electronics Inc. | - | FIXED IND 4.7UH 3A 71 MOHM SMD | https://www.digikey.ca/product-detail/en/wurth-electronics-inc/744774047/732-1266-1-ND/1639327 | 1.76 | 1.40 | 1.76 | 140.00 | https://lcsc.com/product-detail/Power-Inductors_COILMX-MSA54-4R7M_C396410.html | 0.10 | 0.07 | 0.10 | 7.05 | 132.95 | https://lcsc.com/product-detail/Power-Inductors_COILMX-MSA54-4R7M_C396410.html | TRUE | 0.07 | 7.05 | CT
L2 | 1 | MI0603L301R-10 | 240-2374-1-ND | 300 Ohms @ 100MHz | Laird-Signal Integrity Products | L0603 | FERRITE BEAD 300 OHM 0603 1LN | https://www.digikey.ca/product-detail/en/laird-signal-integrity-products/MI0603L301R-10/240-2374-1-ND/806734 | 0.19 | 0.09 | 0.19 | 8.55 | - | - | - | - | - | - | https://www.digikey.ca/product-detail/en/laird-signal-integrity-products/MI0603L301R-10/240-2374-1-ND/806734 | TRUE | 0.09 | 8.55 | CT
L3 | 1 | FBMH1608HL601-T | 587-1737-1-ND | 600 Ohms @ 100MHz | Taiyo Yuden | L0603 | FERRITE BEAD 600 OHM 0603 1LN | https://www.digikey.ca/product-detail/en/taiyo-yuden/FBMH1608HL601-T/587-1737-1-ND/1147062 | 0.11 | 0.05 | 0.11 | 5.23 | https://lcsc.com/product-detail/Ferrite-Beads_Murata-Electronics_BLM18AG601SN1D_Murata-Electronics-BLM18AG601SN1D_C19330.html | 0.01 | 0.01 | 0.01 | 0.83 | 4.40 | https://lcsc.com/product-detail/Ferrite-Beads_Murata-Electronics_BLM18AG601SN1D_Murata-Electronics-BLM18AG601SN1D_C19330.html | TRUE | 0.01 | 0.83 | CT
C1, C4, C21, C27, C28, C30, C37, C38, C42, C46, C47, C49, C50, C52, C53, C55, C56, C57, C59 | 19 | CC0603KRX7R7BB104 | 311-1088-1-ND | 100nF | Yageo | C0603 | CAP CER 0.1UF 16V X7R 0603 | https://www.digikey.ca/product-detail/en/yageo/CC0603KRX7R7BB104/311-1088-1-ND/302998 | 0.10 | 0.02 | 1.90 | 44.46 | https://lcsc.com/product-detail/Multilayer-Ceramic-Capacitors-MLCC-SMD-SMT_Walsin-Tech-Corp-0603B104K160CT_C80516.html | 0.01 | 0.01 | 0.10 | 9.50 | 34.96 | https://lcsc.com/product-detail/Multilayer-Ceramic-Capacitors-MLCC-SMD-SMT_Walsin-Tech-Corp-0603B104K160CT_C80516.html | TRUE | 0.01 | 9.50 | CT
C2 | 1 | C1608X7S0J106M080AC | 445-9104-1-ND | 10uF | TDK Corporation | C0603 | CAP CER 10UF 6.3V X7S 0603 | https://www.digikey.ca/product-detail/en/tdk-corporation/C1608X7S0J106M080AC/445-9104-1-ND/3661624 | 0.55 | 0.26 | 0.55 | 25.62 | https://lcsc.com/product-detail/Multilayer-Ceramic-Capacitors-MLCC-SMD-SMT_SAMSUNG_CL10A106MQ8NNNC_10uF-106-20-6-3V_C1691.html | 0.01 | 0.01 | 0.01 | 1.45 | 24.17 | https://lcsc.com/product-detail/Multilayer-Ceramic-Capacitors-MLCC-SMD-SMT_SAMSUNG_CL10A106MQ8NNNC_10uF-106-20-6-3V_C1691.html | TRUE | 0.01 | 1.45 | CT
C3 | 1 | GCM21BR72A473KA37L | 490-4969-1-ND | 47nF | Murata Electronics North America | C0805 | CAP CER 0.047UF 100V X7R 0805 | https://www.digikey.ca/product-detail/en/murata-electronics-north-america/GCM21BR72A473KA37L/490-4969-1-ND/1765288 | 0.29 | 0.11 | 0.29 | 11.42 | https://lcsc.com/product-detail/Others_TDK-C2012X7R2A473KT0L0U_C342507.html | 0.03 | 0.03 | 0.03 | 2.57 | 8.85 | https://lcsc.com/product-detail/Others_TDK-C2012X7R2A473KT0L0U_C342507.html | TRUE | 0.03 | 2.57 | CT
C5, C6, C19, C23 | 4 | LMK212AC6106MD-T | 587-6337-1-ND | 10uF | Taiyo Yuden | C0805 | CAP CER 10UF 10V X6S 0805 | https://www.digikey.ca/product-detail/en/taiyo-yuden/LMK212AC6106MD-T/587-6337-1-ND/9949923 | 0.26 | 0.10 | 1.04 | 40.00 | - | - | - | - | - | - | https://www.digikey.ca/product-detail/en/taiyo-yuden/LMK212AC6106MD-T/587-6337-1-ND/9949923 | TRUE | 0.10 | 40.00 | CT
C7,C14 | 2 | GRM188R71E474KA12D | 490-3291-1-ND | 0.47uF | Murata Electronics | C0603 | CAP CER 0.47UF 25V X7R 0603 | https://www.digikey.ca/product-detail/en/murata-electronics/GRM188R71E474KA12D/490-3291-1-ND/702832 | 0.27 | 0.09 | 0.54 | 18.40 | - | - | - | - | - | - | https://www.digikey.ca/product-detail/en/murata-electronics/GRM188R71E474KA12D/490-3291-1-ND/702832 | TRUE | 0.09 | 18.40 | CT
C8 | 1 | CL31A106MBHNNNE | 1276-6736-1-ND | 10uF | Samsung Electro-Mechanics | C1206 | CAP CER 10UF 50V X5R 1206 | https://www.digikey.ca/product-detail/en/samsung-electro-mechanics/CL31A106MBHNNNE/1276-6736-1-ND/5961595 | 0.34 | 0.13 | 0.34 | 13.00 | https://lcsc.com/product-detail/New-Arrivals_Taiyo-Yuden-UMK316BBJ106KL-T_C105175.html | 0.09 | 0.07 | 0.09 | 7.00 | 6.00 | https://lcsc.com/product-detail/New-Arrivals_Taiyo-Yuden-UMK316BBJ106KL-T_C105175.html | TRUE | 0.07 | 7.00 | CT
C9, C25 | 2 | CC0603KPX7R9BB104 | 311-3567-1-ND | 0.1uF | Yageo | C0603 | CAP CER 0.1UF 50V X7R 0603 | https://www.digikey.ca/product-detail/en/yageo/CC0603KPX7R9BB104/311-3567-1-ND/7648494 | 0.10 | 0.01 | 0.20 | 2.96 | - | - | - | - | - | - | https://www.digikey.ca/product-detail/en/yageo/CC0603KPX7R9BB104/311-3567-1-ND/7648494 | TRUE | 0.01 | 2.96 | CT
C10, C11 | 2 | EEE-FK1J680UP | PCE4307CT-ND | 68uF | Panasonic Electronic Components | Radial, Can - SMD | CAP ALUM 68UF 20% 63V SMD | https://www.digikey.ca/product-detail/en/panasonic-electronic-components/EEE-FK1J680UP/PCE4307CT-ND/949813 | 0.72 | 0.36 | 1.44 | 72.48 | https://lcsc.com/product-detail/Others_PANASONIC-EEEFK1J680UP_C336251.html | 0.36 | 0.23 | 0.72 | 45.80 | 26.68 | https://lcsc.com/product-detail/Others_PANASONIC-EEEFK1J680UP_C336251.html | TRUE | 0.23 | 45.80 | CT
C12, C29, C36, C39 | 4 | C2012X5R1A226K125AB | 445-7664-1-ND | 22uF | TDK Corporation | C0805 | CAP CER 22UF 10V X5R 0805 | https://www.digikey.ca/product-detail/en/tdk-corporation/C2012X5R1A226K125AB/445-7664-1-ND/2733736 | 0.57 | 0.27 | 2.28 | 106.56 | https://lcsc.com/product-detail/Multilayer-Ceramic-Capacitors-MLCC-SMD-SMT_TDK_C2012X5R1A226KT000N_22uF-226-10-10V_C76634.html | 0.26 | 0.16 | 1.03 | 65.55 | 41.01 | https://lcsc.com/product-detail/Multilayer-Ceramic-Capacitors-MLCC-SMD-SMT_TDK_C2012X5R1A226KT000N_22uF-226-10-10V_C76634.html | TRUE | 0.16 | 65.55 | CT
C13, C18, C20, C24 | 4 | C0805C224K1RACAUTO | 399-6946-1-ND | 220nF | KEMET | C0805 | CAP CER 0.22UF 100V X7R 0805 | https://www.digikey.ca/product-detail/en/kemet/C0805C224K1RACAUTO/399-6946-1-ND/3314454 | 0.37 | 0.15 | 1.48 | 61.60 | https://lcsc.com/product-detail/Multilayer-Ceramic-Capacitors-MLCC-SMD-SMT_PSA-Prosperity-Dielectrics-FM21X224K101ECG_C382241.html | 0.04 | 0.03 | 0.16 | 11.62 | 49.98 | https://lcsc.com/product-detail/Multilayer-Ceramic-Capacitors-MLCC-SMD-SMT_PSA-Prosperity-Dielectrics-FM21X224K101ECG_C382241.html | TRUE | 0.03 | 11.62 | CT
C15 | 1 | GCJ188R72A104KA01D | 490-13420-1-ND | 0.1uF | Murata Electronics | C0603 | CAP CER 0.1UF 100V X7R 0603 | https://www.digikey.ca/product-detail/en/murata-electronics/GCJ188R72A104KA01D/490-13420-1-ND/6012292 | 0.24 | 0.09 | 0.24 | 9.30 | - | - | - | - | - | - | https://www.digikey.ca/product-detail/en/murata-electronics/GCJ188R72A104KA01D/490-13420-1-ND/6012292 | TRUE | 0.09 | 9.30 | CT
C16 | 1 | CL31B226KQHNNNE | 1276-3146-1-ND | 22uF | Samsung Electro-Mechanics | C1206 | CAP CER 22UF 6.3V X7R 1206 | https://www.digikey.ca/product-detail/en/samsung-electro-mechanics/CL31B226KQHNNNE/1276-3146-1-ND/3891232 | 0.46 | 0.22 | 0.46 | 21.60 | https://lcsc.com/product-detail/Others_Taiyo-Yuden_JMK316AB7226KLHT_Taiyo-Yuden-JMK316AB7226KLHT_C268007.html | 0.12 | 0.09 | 0.12 | 8.94 | 12.66 | https://lcsc.com/product-detail/Others_Taiyo-Yuden_JMK316AB7226KLHT_Taiyo-Yuden-JMK316AB7226KLHT_C268007.html | TRUE | 0.09 | 8.94 | CT
C17, C22 | 2 | C0603C104K9RAC7867 | 399-15351-1-ND | 100nF | KEMET | C0603 | CAP CER 0.1UF 6.3V X7R 0603 | https://www.digikey.ca/product-detail/en/kemet/C0603C104K9RAC7867/399-15351-1-ND/7386749 | 0.18 | 0.06 | 0.36 | 11.88 | - | - | - | - | - | - | https://www.digikey.ca/product-detail/en/kemet/C0603C104K9RAC7867/399-15351-1-ND/7386749 | TRUE | 0.06 | 11.88 | CT
C26 | 1 | C0402C223J4RAC7867 | 399-14435-1-ND | 0.022µF | KEMET | C0402 | CAP CER 0.022UF 16V X7R 0402 | https://www.digikey.ca/product-detail/en/kemet/C0402C223J4RAC7867/399-14435-1-ND/7103727 | 0.50 | 0.23 | 0.50 | 23.33 | - | - | - | - | - | - | https://www.digikey.ca/product-detail/en/kemet/C0402C223J4RAC7867/399-14435-1-ND/7103727 | TRUE | 0.23 | 23.33 | CT
C31, C41 | 2 | LMK212BJ105MD-T | 587-4918-1-ND | 1uF | Taiyo Yuden | C0805 | CAP CER 1UF 10V X5R 0805 | https://www.digikey.ca/product-detail/en/taiyo-yuden/LMK212BJ105MD-T/587-4918-1-ND/6563761 | 0.17 | 0.06 | 0.34 | 11.34 | - | - | - | - | - | - | https://www.digikey.ca/product-detail/en/taiyo-yuden/LMK212BJ105MD-T/587-4918-1-ND/6563761 | TRUE | 0.06 | 11.34 | CT
C32, C33 | 2 | CC0603BRNPO9BN2R0 | 311-3827-1-ND | 2pF | Yageo | C0603 | CAP CER 2PF 50V NPO 0603 | https://www.digikey.ca/product-detail/en/yageo/CC0603BRNPO9BN2R0/311-3827-1-ND/8024916 | 0.11 | 0.04 | 0.22 | 7.68 | - | - | - | - | - | - | https://www.digikey.ca/product-detail/en/yageo/CC0603BRNPO9BN2R0/311-3827-1-ND/8024916 | TRUE | 0.04 | 7.68 | CT
C34, C35 | 2 | CC0603BRNPO9BN4R7 | 399-16185-1-ND | 4.3pF | KEMET | C0603 | CAP CER RF 4.3PF 50V +/-0.1 PF C | https://www.digikey.ca/product-detail/en/kemet/CBR06C439B5GAC/399-16185-1-ND/7649770 | 0.26 | 0.10 | 0.52 | 20.48 | - | - | - | - | - | - | https://www.digikey.ca/product-detail/en/kemet/CBR06C439B5GAC/399-16185-1-ND/7649770 | TRUE | 0.10 | 20.48 | CT
C40, C43, C48 | 3 | JMK107B7105KA-T | 587-2834-1-ND | 1uF | Taiyo Yuden | C0603 | CAP CER 1UF 6.3V X7R 0603 | https://www.digikey.ca/product-detail/en/taiyo-yuden/JMK107B7105KA-T/587-2834-1-ND/2607801 | 0.11 | 0.04 | 0.33 | 11.16 | - | - | - | - | - | - | https://www.digikey.ca/product-detail/en/taiyo-yuden/JMK107B7105KA-T/587-2834-1-ND/2607801 | TRUE | 0.04 | 11.16 | CT
C44 | 1 | TAJA106K010RNJ | 478-1654-1-ND | 10uF | AVX Corporation | C1206 | CAP TANT 10UF 10% 10V 1206 | https://www.digikey.ca/product-detail/en/avx-corporation/TAJA106K010RNJ/478-1654-1-ND/564686 | 0.38 | 0.16 | 0.38 | 15.80 | - | - | - | - | - | - | https://www.digikey.ca/product-detail/en/avx-corporation/TAJA106K010RNJ/478-1654-1-ND/564686 | TRUE | 0.16 | 15.80 | CT
C45 | 1 | CC0603KRX7R9BB103 | 311-1085-1-ND | 10nF | Yageo | C0603 | CAP CER 10000PF 50V X7R 0603 | https://www.digikey.ca/product-detail/en/yageo/CC0603KRX7R9BB103/311-1085-1-ND/302995 | 0.10 | 0.02 | 0.10 | 1.81 | - | - | - | - | - | - | https://www.digikey.ca/product-detail/en/yageo/CC0603KRX7R9BB103/311-1085-1-ND/302995 | TRUE | 0.02 | 1.81 | CT
C51, C54, C58 | 3 | CL31B225KAHNNNE | 1276-1072-1-ND | 2.2uF | Samsung Electro-Mechanics | C1206 | CAP CER 2.2UF 25V X7R 1206 | https://www.digikey.ca/product-detail/en/samsung-electro-mechanics/CL31B225KAHNNNE/1276-1072-1-ND/3889158 | 0.24 | 0.08 | 0.72 | 25.08 | https://lcsc.com/product-detail/Multilayer-Ceramic-Capacitors-MLCC-SMD-SMT_Samsung-Electro-Mechanics-CL31B225KAHNNNE_C170102.html | 0.05 | 0.04 | 0.16 | 11.88 | 13.20 | https://lcsc.com/product-detail/Multilayer-Ceramic-Capacitors-MLCC-SMD-SMT_Samsung-Electro-Mechanics-CL31B225KAHNNNE_C170102.html | TRUE | 0.04 | 11.88 | CT
R1 | 1 | RNCP0603FTD10K0 | RNCP0603FTD10K0CT-ND | 10K | Stackpole Electronics Inc | R0603 | RES 10K OHM 1% 1/8W 0603 | https://www.digikey.ca/product-detail/en/stackpole-electronics-inc/RNCP0603FTD10K0/RNCP0603FTD10K0CT-ND/2240478 | 0.10 | 0.03 | 0.10 | 2.73 | - | - | - | - | - | - | https://www.digikey.ca/product-detail/en/stackpole-electronics-inc/RNCP0603FTD10K0/RNCP0603FTD10K0CT-ND/2240478 | TRUE | 0.03 | 2.73 | CT
R4, R6 | 2 | CRA2512-FZ-R100ELF | CRA2512-FZ-R100ELFCT-ND | 0.1 | Bourns Inc. | R2512 | RES 0.1 OHM 1% 3W 2512 | https://www.digikey.ca/product-detail/en/bourns-inc/CRA2512-FZ-R100ELF/CRA2512-FZ-R100ELFCT-ND/1775059 | 0.60 | 0.34 | 1.20 | 67.12 | - | - | - | - | - | - | https://www.digikey.ca/product-detail/en/bourns-inc/CRA2512-FZ-R100ELF/CRA2512-FZ-R100ELFCT-ND/1775059 | TRUE | 0.34 | 67.12 | CT
R5, R17, R18, R23 | 4 | RT0603BRD0710KL | YAG1236CT-ND | 10K | Yageo | R0603 | RES SMD 10K OHM 0.1% 1/10W 0603 | https://www.digikey.ca/product-detail/en/yageo/RT0603BRD0710KL/YAG1236CT-ND/4340589 | 0.36 | 0.12 | 1.44 | 47.64 | https://lcsc.com/product-detail/High-Precision-Low-TCR-SMD-Resistors_Resistor-Today-PTFR0603B10K0P9_C328421.html | 0.09 | 0.07 | 0.35 | 27.41 | 20.23 | https://lcsc.com/product-detail/High-Precision-Low-TCR-SMD-Resistors_Resistor-Today-PTFR0603B10K0P9_C328421.html | TRUE | 0.07 | 27.41 | CT
R7, R8 | 2 | ESR03EZPJ102 | RHM1.0KDCT-ND | 1K | Rohm Semiconductor | R0603 | RES SMD 1K OHM 5% 1/4W 0603 | https://www.digikey.ca/product-detail/en/rohm-semiconductor/ESR03EZPJ102/RHM1.0KDCT-ND/1762924 | 0.10 | 0.03 | 0.20 | 6.00 | https://lcsc.com/product-detail/Chip-Resistor-Surface-Mount_ROHM-Semicon-ESR03EZPJ102_C253329.html | - | 0.02 | - | 3.02 | 2.98 | https://lcsc.com/product-detail/Chip-Resistor-Surface-Mount_ROHM-Semicon-ESR03EZPJ102_C253329.html | TRUE | 0.02 | 3.02 | CT
R9, R10, R12, R25, R29, R30 | 6 | RC0603JR-070RL | 311-0.0GRCT-ND | 0 Ohms | Yageo | R0603 | RES SMD 0 OHM JUMPER 1/10W 0603 | https://www.digikey.ca/product-detail/en/yageo/RC0603JR-070RL/311-0.0GRCT-ND/729622 | 0.10 | 0.01 | 0.60 | 4.62 | - | - | - | - | - | - | https://www.digikey.ca/product-detail/en/yageo/RC0603JR-070RL/311-0.0GRCT-ND/729622 | TRUE | 0.01 | 4.62 | CT
R15 | 1 | RN73H1JTTD1003B25 | 2019-RN73H1JTTD1003B25CT-ND | 100K | KOA Speer Electronics, Inc. | R0603 | RES 100K OHM 0.1% 1/10W 0603 | https://www.digikey.ca/product-detail/en/koa-speer-electronics-inc/RN73H1JTTD1003B25/2019-RN73H1JTTD1003B25CT-ND/10706978 | 0.55 | 0.21 | 0.55 | 20.60 | https://lcsc.com/product-detail/High-Precision-Low-TCR-SMD-Resistors_YAGEO-RT0603BRD07100KL_C122538.html | - | 0.03 | - | 2.93 | 17.67 | https://lcsc.com/product-detail/High-Precision-Low-TCR-SMD-Resistors_YAGEO-RT0603BRD07100KL_C122538.html | TRUE | 0.03 | 2.93 | CT
R16 | 1 | RT0603BRD0722KL | YAG1592CT-ND | 22K | Yageo | R0603 | RES SMD 22K OHM 0.1% 1/10W 0603 | https://www.digikey.ca/product-detail/en/yageo/RT0603BRD0722KL/YAG1592CT-ND/5139040 | 0.36 | 0.12 | 0.36 | 11.91 | https://lcsc.com/product-detail/Chip-Resistor-Surface-Mount_YAGEO-RT0603BRD0722KL_C469656.html | - | 0.03 | - | 2.59 | 9.32 | https://lcsc.com/product-detail/Chip-Resistor-Surface-Mount_YAGEO-RT0603BRD0722KL_C469656.html | TRUE | 0.03 | 2.59 | CT
R19, R20 | 2 | CPF0603B22RE | A119957CT-ND | 22 | TE Connectivity Passive Product | R0603 | RES SMD 22 OHM 0.1% 1/16W 0603 | https://www.digikey.ca/product-detail/en/te-connectivity-passive-product/CPF0603B22RE/A119957CT-ND/4966555 | 0.49 | 0.18 | 0.98 | 36.66 | - | - | - | - | - | - | https://www.digikey.ca/product-detail/en/te-connectivity-passive-product/CPF0603B22RE/A119957CT-ND/4966555 | TRUE | 0.18 | 36.66 | CT
R21 | 1 | RC0603FR-07430KL | 311-430KHRCT-ND | 430K | Yageo | R0603 | RES SMD 430K OHM 1% 1/10W 0603 | https://www.digikey.ca/product-detail/en/yageo/RC0603FR-07430KL/311-430KHRCT-ND/730184 | 0.10 | 0.01 | 0.10 | 0.94 | - | - | - | - | - | - | https://www.digikey.ca/product-detail/en/yageo/RC0603FR-07430KL/311-430KHRCT-ND/730184 | TRUE | 0.01 | 0.94 | CT
R22 | 1 | RC0603FR-07620KL | 311-620KHRCT-ND | 620K | Yageo | R0603 | RES SMD 620K OHM 1% 1/10W 0603 | https://www.digikey.ca/product-detail/en/yageo/RC0603FR-07620KL/311-620KHRCT-ND/730285 | 0.10 | 0.01 | 0.10 | 0.94 | - | - | - | - | - | - | https://www.digikey.ca/product-detail/en/yageo/RC0603FR-07620KL/311-620KHRCT-ND/730285 | TRUE | 0.01 | 0.94 | CT
R24 | 1 | NTCS0805E3472JMT | BC2296DKR-ND | 4.7k | Vishay BC Components | R0805 | THERM NTC 4.7KOHM 3500K 0805 | https://www.digikey.ca/product-detail/en/vishay-bc-components/NTCS0805E3472JMT/BC2296DKR-ND/1801657 | 0.55 | 0.28 | 0.55 | 28.31 | - | - | - | - | - | - | https://www.digikey.ca/product-detail/en/vishay-bc-components/NTCS0805E3472JMT/BC2296DKR-ND/1801657 | TRUE | 0.28 | 28.31 | CT
R26, R28 | 2 | ERJ-2RKF4700X | P470LCT-ND | 470 | Panasonic Electronic Components | R0402 | RES SMD 470 OHM 1% 1/10W 0402 | https://www.digikey.ca/product-detail/en/panasonic-electronic-components/ERJ-2RKF4700X/P470LCT-ND/1746691 | 0.10 | 0.02 | 0.20 | 3.36 | - | - | - | - | - | - | https://www.digikey.ca/product-detail/en/panasonic-electronic-components/ERJ-2RKF4700X/P470LCT-ND/1746691 | TRUE | 0.02 | 3.36 | CT
R27 | 1 | MCS0402MC1001FE000 | MCS0402-1.00K-MFCT-ND | 1K | Vishay Beyschlag | R0402 | RES SMD 1K OHM 1% 1/10W 0402 | https://www.digikey.ca/product-detail/en/vishay-beyschlag/MCS0402MC1001FE000/MCS0402-1.00K-MFCT-ND/3883095 | 0.29 | 0.09 | 0.29 | 9.46 | - | - | - | - | - | - | https://www.digikey.ca/product-detail/en/vishay-beyschlag/MCS0402MC1001FE000/MCS0402-1.00K-MFCT-ND/3883095 | TRUE | 0.09 | 9.46 | CT
R31, R32 | 2 | RC0603FR-07137RL | 311-137HRCT-ND | 137 | Yageo | R0603 | RES SMD 137 OHM 1% 1/10W 0603 | https://www.digikey.ca/product-detail/en/yageo/RC0603FR-07137RL/311-137HRCT-ND/729885 | 0.10 | 0.01 | 0.20 | 1.88 | - | - | - | - | - | - | https://www.digikey.ca/product-detail/en/yageo/RC0603FR-07137RL/311-137HRCT-ND/729885 | TRUE | 0.01 | 1.88 | CT
 |  |  |  |  |  |  |  | Total Comp |  |  | 73.46 | 4678.53 |  |  |  |  |  |  | Total Comp |  |  | 3801.61
 |  |  |  |  |  |  |  | Total Comp/board |  |  | 73.46 | 46.79 |  |  |  |  |  |  | Total Comp/board |  |  | 38.02
 |  |  |  |  |  |  |  | PCB |  |  | 38.50 | 4.00 |  |  |  |  |  |  | PCB |  |  | 4.00
 |  |  |  |  |  |  |  | Total Cost |  |  | 111.96 | 50.79 |  |  |  |  |  |  | Total Cost |  |  | 42.02

Sheet: LSS Pro Programmer V0.2 BOM
LSS Pro Programmer V0.2 (CAN)
Part | QTY/Bd | MF SKU | Digikey SKU | Value | Manufacturer | Package | Description | Example
U1 | 1 | SN65HVD230DR | 296-11654-1-ND | - | Texas Instruments | 8-SOIC | IC TRANSCEIVER HALF 1/1 8SOIC | https://www.digikey.ca/en/products/detail/texas-instruments/SN65HVD230DR/404366
U2 | 1 | SN74CB3Q3306APWR | 296-15102-2-ND | - | Texas Instruments | 8-TSSOP | IC DUAL FET BUS SWITCH 8-TSSOP | https://www.digikey.ca/en/products/detail/texas-instruments/SN74CB3Q3306APWR/565601
D1 | 1 | NUP2105LT1G | NUP2105LT1GOSTR-ND | - | ON Semiconductor | SOT-23-3 | TVS DIODE 24V 44V SOT23-3 | https://www.digikey.ca/en/products/detail/on-semiconductor/NUP2105LT1G/1485001
R1, R2, R3 | 3 | RNCP0603FTD10K0 | RNCP0603FTD10K0CT-ND | 10K | Stackpole Electronics Inc | R0603 | RES 10K OHM 1% 1/8W 0603 | https://www.digikey.ca/product-detail/en/stackpole-electronics-inc/RNCP0603FTD10K0/RNCP0603FTD10K0CT-ND/2240478
R4, R5 | 2 | ERJ-3EKF3300V | P330HTR-ND | 330 | Panasonic Electronic Components | R0603 | RES SMD 330 OHM 1% 1/10W 0603 | https://www.digikey.ca/en/products/detail/panasonic-electronic-components/ERJ-3EKF3300V/1746374
R6 | 1 | RK73H2ATTD1100F | 2019-RK73H2ATTD1100FCT-ND | 110 | KOA Speer Electronics, Inc. | R0805 | RES 110 OHM 1% 1/4W 0805 | https://www.digikey.ca/product-detail/en/koa-speer-electronics-inc/RK73H2ATTD1100F/2019-RK73H2ATTD1100FCT-ND/10235449
R7 | 1 | RK73H2ATTD1200F | 2019-RK73H2ATTD1200FTR-ND | 120 | KOA Speer Electronics, Inc. | R0805 | RES 120 OHM 1% 1/4W 0805 | https://www.digikey.ca/en/products/detail/koa-speer-electronics-inc/RK73H2ATTD1200F/10233612
R8 | 1 | ESR03EZPF1001 | RHM1.00KADTR-ND | 1K | Rohm Semiconductor | R0603 | RES SMD 1K OHM 1% 1/4W 0603 | https://www.digikey.ca/en/products/detail/rohm-semiconductor/ESR03EZPF1001/1983428
C1, C2, C3, C4, C5 | 5 | CC0603KRX7R7BB104 | 311-1088-2-ND | 100nF | Yageo | C0603 | CAP CER 0.1UF 16V X7R 0603 | https://www.digikey.ca/en/products/detail/yageo/CC0603KRX7R7BB104/302998
J1 | 1 | PH2-06-UA | 2057-PH2-06-UA-ND | - | Adam Tech | - | CONN HEADER VERT 6POS 2.54MM | https://www.digikey.ca/en/products/detail/adam-tech/PH2-06-UA/9830396
J2 | 1 | 22035045 | WM18888-ND | - | Molex | - | CONN HEADER VERT 4POS 2.5MM | https://www.digikey.ca/en/products/detail/molex-llc/0022035045/403303
JTAG | 1 | 3020-20-0100-00 | 1175-1612-ND | - | CNC Tech | - | CONN HEADER VERT 20POS 2.54MM | https://www.digikey.ca/en/products/detail/cnc-tech/3020-20-0100-00/3441738
SW1 | 1 | 204-211ST | CT204211ST-ND | - | CTS Electrocomponents | - | SWITCH SLIDE DIP DPST 50MA 24V | https://www.digikey.ca/en/products/detail/cts-electrocomponents/204-211ST/267310
3V3/1, 3V3/2, 3V3/REF, 5V, AGND, CAN-RX, CAN-TX, GND1, GND2, JTDI, NRST, PST-SCK, PST-SDI, PST-SDO, RST, RX, SWCLK, SWDIO, SWO, TX | 20 | 0905-0-15-20-75-14-11-0 | ED9009-ND | - | Mill-Max Manufacturing Corp. | - | CONTACT SPRING LOADED SMD GOLD | https://www.digikey.ca/products/en?keywords=ED9009-ND
Black Test Point | 3 | 5001 | 36-5001-ND | - | Keystone Electronics | - | PC TEST POINT MINIATURE BLACK | https://www.digikey.ca/product-detail/en/keystone-electronics/5001/36-5001-ND/255327
Red Test Point | 17 | 5000 | 36-5000-ND | - | Keystone Electronics | - | PC TEST POINT MINIATURE RED | https://www.digikey.ca/product-detail/en/keystone-electronics/5000/36-5000-ND/255326

Sheet: LSS Pro V0.1 BOM DK vs LCSC
LSS Pro Board V0.1 |  |  |  |  |  |  |  |  | 1 | 100
Part | QTY/Bd | MF SKU | Digikey SKU | Value | Manufacturer | Package | Description | Digikey | Unit Price (USD) | 100qty Price (USD) | Total Unit Price (USD) | Total 100qty Price (USD) | LCSC | Unit Price (USD) | 100qty Price (USD) | Total Unit Price (USD) | Total 100qty Price (USD) | Diff (DK-LCSC) | Chosen Source | ROHS | 100qty Price (USD) | Total 100qty Price (USD) | Packaging | Qty ordered | Order Note
U1 | 1 | STM32F413VGT6 | 497-17009-ND | - | STMicroelectronics | LQFP-100 | IC MCU 32BIT 1MB FLASH 100LQFP | https://www.digikey.ca/product-detail/en/stmicroelectronics/STM32F413VGT6/497-17009-ND/6564701 | 11.15 | 8.34 | 11.15 | 834.00 | - | - | - | - | - | - | https://www.digikey.ca/product-detail/en/stmicroelectronics/STM32F413VGT6/497-17009-ND/6564701 | TRUE | 8.34 | 834.00 | Tray |  | 0 stock DK/LCSC
U2 | 1 | AEAT-8800-Q24 | 516-3787-ND | - | Broadcom Limited | QFN-24 | ROTARY ENCODER MAGNETIC 4096PPR | https://www.digikey.ca/product-detail/en/broadcom-limited/AEAT-8800-Q24/516-3787-ND/6681014 | 8.00 | 5.99 | 8.00 | 599.00 | - | - | - | - | - | - | https://www.digikey.ca/product-detail/en/broadcom-limited/AEAT-8800-Q24/516-3787-ND/6681014 | TRUE | 5.99 | 599.00 | CT
U3 | 1 | POWERSTEP01 | 497-15441-ND | - | STMicroelectronics | VFQFPN-89 | IC MTR DRV BIPLR 3.3/5V 89VFQFPN | https://www.digikey.ca/product-detail/en/stmicroelectronics/POWERSTEP01/497-15441-ND/5237153 | 10.71 | 7.65 | 10.71 | 765.00 | https://lcsc.com/product-detail/Motor-Drivers_STMicroelectronics-POWERSTEP01_C80192.html | 10.35 | 8.49 | 10.35 | 849.00 | -84.00 | https://www.digikey.ca/product-detail/en/stmicroelectronics/POWERSTEP01/497-15441-ND/5237153 | TRUE | 7.65 | 765.00 | Tray
U4 | 1 | ICM-20600 | 1428-1147-1-ND | - | TDK InvenSense | LGA-14 | LOW-POWER, HIGH-PERFORMANCE INTE | https://www.digikey.ca/product-detail/en/tdk-invensense/ICM-20600/1428-1147-1-ND/9602942 | 3.70 | 2.01 | 3.70 | 201.00 | https://lcsc.com/product-detail/Motion-Sensors-Accelerometers_TDK-InvenSense-ICM-20600_C124140.html | 1.42 | 0.93 | 1.42 | 93.00 | 108.00 | https://lcsc.com/product-detail/Motion-Sensors-Accelerometers_TDK-InvenSense-ICM-20600_C124140.html | TRUE | 0.93 | 93.00 | CT
U5, U6 | 2 | SN74LVC1G126DCKR | 296-11606-1-ND | - | Texas Instruments | SC-70-5 | IC BUF NON-INVERT 5.5V SC70-5 | https://www.digikey.ca/product-detail/en/texas-instruments/SN74LVC1G126DCKR/296-11606-1-ND/385745 | 0.29 | 0.12 | 0.58 | 25.00 | https://lcsc.com/product-detail/Logic-Buffers-Drivers-Receivers-Transceivers_Texas-Instruments-SN74LVC1G126DCKR_C88039.html | 0.07 | 0.05 | 0.14 | 10.48 | 14.52 | https://lcsc.com/product-detail/Logic-Buffers-Drivers-Receivers-Transceivers_Texas-Instruments-SN74LVC1G126DCKR_C88039.html | TRUE | 0.05 | 10.48 | CT
PS1 | 1 | TS30042-M050QFNR | TS30042-M050QFNRCT-ND | - | Semtech Corporation | VFQFN-16 | IC REG BUCK 5V 2A 16QFN | https://www.digikey.ca/product-detail/en/semtech-corporation/TS30042-M050QFNR/TS30042-M050QFNRCT-ND/6605537 | 1.51 | 1.03 | 1.51 | 102.60 | - | - | - | - | - | - | https://www.digikey.ca/product-detail/en/semtech-corporation/TS30042-M050QFNR/TS30042-M050QFNRCT-ND/6605537 | TRUE | 1.03 | 102.60 | CT
PS2, PS3 | 2 | AP7361C-33E-13 | AP7361C-33E-13DICT-ND | - | Diodes Incorporated | SOT-223 | IC REG LINEAR 3.3V 1A SOT223 | https://www.digikey.ca/product-detail/en/diodes-incorporated/AP7361C-33E-13/AP7361C-33E-13DICT-ND/5638331 | 0.58 | 0.34 | 1.16 | 68.28 | https://lcsc.com/product-detail/Linear-Voltage-Regulators_Diodes-Incorporated-AP7361C-33E-13_C500795.html | 0.64 | 0.60 | 1.29 | 120.59 | -52.31 | https://www.digikey.ca/product-detail/en/diodes-incorporated/AP7361C-33E-13/AP7361C-33E-13DICT-ND/5638331 | TRUE | 0.34 | 68.28 | CT
PS4 | 1 | REF3133AIDBZR | 296-41483-1-ND | - | Texas Instruments | SOT-23-3 | IC VREF SERIES 3.3V SOT23-3 | https://www.digikey.ca/product-detail/en/texas-instruments/REF3133AIDBZR/296-41483-1-ND/5222876 | 2.57 | 1.74 | 2.57 | 174.20 | - | - | - | - | - | - | https://www.digikey.ca/product-detail/en/texas-instruments/REF3133AIDBZR/296-41483-1-ND/5222876 | TRUE | 1.74 | 174.20 | CT
D1 | 1 | PMEG4030ER,115 | 1727-5313-1-ND | - | Nexperia USA Inc. | SOD-123W | DIODE SCHOTTKY 40V 3A SOD123W | https://www.digikey.ca/product-detail/en/nexperia-usa-inc/PMEG4030ER115/1727-5313-1-ND/2676789 | 0.45 | 0.16 | 0.45 | 15.95 | https://lcsc.com/product-detail/Schottky-Barrier-Diodes-SBD_Nexperia-PMEG4030ER-115_C389355.html | 0.09 | 0.07 | 0.09 | 6.86 | 9.09 | https://lcsc.com/product-detail/Schottky-Barrier-Diodes-SBD_Nexperia-PMEG4030ER-115_C389355.html | TRUE | 0.07 | 6.86 | CT
D2 | 1 | ESDA6V1BC6 | 497-6635-1-ND | - | STMicroelectronics | SOT-23-6 | TVS DIODE 5V SOT23-6 | https://www.digikey.ca/product-detail/en/stmicroelectronics/ESDA6V1BC6/497-6635-1-ND/1865413 | 0.37 | 0.17 | 0.37 | 17.23 | - | - | - | - | - | - | https://www.digikey.ca/product-detail/en/stmicroelectronics/ESDA6V1BC6/497-6635-1-ND/1865413 | TRUE | 0.17 | 17.23 | CT
D3 | 1 | BAR43SFILM | 497-2515-1-ND | - | STMicroelectronics | SOT-23-3 | DIODE ARRAY SCHOTTKY 30V SOT23-3 | https://www.digikey.ca/product-detail/en/stmicroelectronics/BAR43SFILM/497-2515-1-ND/603897 | 0.37 | 0.12 | 0.37 | 12.23 | - | - | - | - | - | - | https://www.digikey.ca/product-detail/en/stmicroelectronics/BAR43SFILM/497-2515-1-ND/603897 | TRUE | 0.12 | 12.23 | CT
Temp | 1 | NTCLE203E3472GB0 | BC2457-ND | 4.7k | Vishay BC Components | Bead | THERM NTC 4.7KOHM 3977K BEAD | https://www.digikey.ca/product-detail/en/vishay-bc-components/NTCLE203E3472GB0/BC2457-ND/2230785 | 1.45 | 0.77 | 1.45 | 77.02 | - | - | - | - | - | - | https://www.digikey.ca/product-detail/en/vishay-bc-components/NTCLE203E3472GB0/BC2457-ND/2230785 | TRUE | 0.77 | 77.02 | Bulk
BUSY | 1 | LTST-C191KRKT | 160-1447-1-ND | Red | Lite-On Inc. | LED0603 | LED RED CLEAR SMD | https://www.digikey.ca/product-detail/en/lite-on-inc/LTST-C191KRKT/160-1447-1-ND/386836 | 0.26 | 0.09 | 0.26 | 9.00 | https://lcsc.com/product-detail/Light-Emitting-Diodes-LED_Lite-On-LTST-C191KRKT_C125099.html | - | 0.02 | - | 1.70 | 7.30 | https://lcsc.com/product-detail/Light-Emitting-Diodes-LED_Lite-On-LTST-C191KRKT_C125099.html | TRUE | 0.02 | 1.70 | CT
FLAG | 1 | LTST-C194TBKT | 160-1837-1-ND | Blue | Lite-On Inc. | LED0603 | LED BLUE CLEAR SMD | https://www.digikey.ca/product-detail/en/lite-on-inc/LTST-C194TBKT/160-1837-1-ND/2356236 | 0.42 | 0.14 | 0.42 | 13.50 | https://lcsc.com/product-detail/Light-Emitting-Diodes-LED_blue_C99290.html | - | 0.02 | - | 2.32 | 11.18 | https://lcsc.com/product-detail/Light-Emitting-Diodes-LED_blue_C99290.html | TRUE | 0.02 | 2.32 | CT
PWR | 1 | 5988070107F | 350-2035-1-ND | Green | Dialight | LED0603 | LED GREEN CLEAR 0603 SMD | https://www.digikey.ca/product-detail/en/dialight/5988070107F/350-2035-1-ND/1291339 | 0.42 | 0.13 | 0.42 | 13.00 | https://lcsc.com/product-detail/Light-Emitting-Diodes-LED_Lite-On-LTST-C191KGKT_C125098.html | - | 0.02 | - | 1.85 | 11.15 | https://lcsc.com/product-detail/Light-Emitting-Diodes-LED_Lite-On-LTST-C191KGKT_C125098.html | TRUE | 0.02 | 1.85 | CT
LED1, LED2, LED3, LED4, LED5, LED6 | 6 | WS2812B | 1528-1104-ND | RGB | Worldsemi | LED5050 | ADDRESS LED DISCR SER RGB | https://www.digikey.ca/product-detail/en/sparkfun-electronics/COM-16346/1568-COM-16346-ND/11630211 | - | 0.50 | - | 300.00 | https://lcsc.com/product-detail/Light-Emitting-Diodes-LED_Worldsemi-WS2812B-B_C114586.html | 0.10 | 0.07 | 0.60 | 44.46 | 255.54 | https://lcsc.com/product-detail/Light-Emitting-Diodes-LED_Worldsemi-WS2812B-B_C114586.html | TRUE | 0.07 | 44.46 | CT
Q1 | 1 | BSS138 | BSS138CT-ND | - | ON Semiconductor | SOT-23-3 | MOSFET N-CH 50V 220MA SOT-23 | https://www.digikey.ca/product-detail/en/on-semiconductor/BSS138/BSS138CT-ND/244294 | 0.26 | 0.09 | 0.26 | 8.76 | https://lcsc.com/product-detail/MOSFET_MDD-Microdiode-Electronics-BSS138_C427380.html | 0.01 | 0.01 | 0.01 | 1.50 | 7.26 | https://lcsc.com/product-detail/MOSFET_MDD-Microdiode-Electronics-BSS138_C427380.html | TRUE | 0.01 | 1.50 | CT
S1 | 1 | TL3342F160QG/TR | EG2531CT-ND | - | E-Switch | - | SWITCH TACTILE SPST-NO 0.05A 12V | https://www.digikey.ca/product-detail/en/e-switch/TL3342F160QG-TR/EG2531CT-ND/379004 | 0.65 | 0.52 | 0.65 | 51.98 | https://lcsc.com/product-detail/Tactile-Switches_SOFNG-TS-1187-1816_C183614.html | - | 0.04 | - | 4.15 | 47.83 | https://lcsc.com/product-detail/Tactile-Switches_SOFNG-TS-1187-1816_C183614.html | TRUE | 0.04 | 4.15 | CT
Y1 | 1 | NX3215SA-32.768KHZ-EXS00A-MU00525 | 644-1386-1-ND | 32.768KHz | NDK America, Inc. | 2-SMD, No Lead | CRYSTAL 32.768KHZ 6PF SMD | https://www.digikey.ca/product-detail/en/ndk-america-inc/NX3215SA-32.768KHZ-EXS00A-MU00525/644-1386-1-ND/9172114 | 0.68 | 0.50 | 0.68 | 49.74 | - | - | - | - | - | - | https://www.digikey.ca/product-detail/en/ndk-america-inc/NX3215SA-32.768KHZ-EXS00A-MU00525/644-1386-1-ND/9172114 | TRUE | 0.50 | 49.74 | CT
Y2 | 1 | NX3225SA-16.000M-STD-CRS-2 | 644-1129-1-ND | 16MHz | NDK America, Inc. | 4-SMD, No Lead | CRYSTAL 16.0000MHZ 8PF SMD | https://www.digikey.ca/product-detail/en/ndk-america-inc/NX3225SA-16.000M-STD-CRS-2/644-1129-1-ND/1788484 | 1.06 | 0.77 | 1.06 | 77.33 | - | - | - | - | - | - | https://www.digikey.ca/product-detail/en/ndk-america-inc/NX3225SA-16.000M-STD-CRS-2/644-1129-1-ND/1788484 | TRUE | 0.77 | 77.33 | CT
J1, J2 | 2 | XT30-M | - | - | Amass | - | XT30 MALE CONN | https://www.tme.eu/en/details/xt30u-m/dc-power-connectors/amass/ | 0.78 | 0.45 | 1.56 | 90.00 | - | - | - | - | - | - | https://www.tme.eu/en/details/xt30u-m/dc-power-connectors/amass/ | TRUE | 0.45 | 90.00 | Bulk |  | Not available from DK
J3 | 1 | 651005136421 | 732-2735-ND | - | Wurth Electronics Inc. | - | CONN RCPT USB2.0 MINI B VERT | https://www.digikey.ca/products/en?keywords=651005136421 | 2.97 | 2.22 | 2.97 | 221.80 | - | - | - | - | - | - | https://www.digikey.ca/products/en?keywords=651005136421 | TRUE | 2.22 | 221.80 | Tray
J4 | 1 | JST-XH-4 | - | - | JST | - | JST XH 4PIN CONN 2.54MM PITCH |  |  |  |  |  |  |  |  |  |  |  |  | FALSE |  |  |  |  | 2.54mm version N/A
L1 | 1 | 744774047 | 732-1266-1-ND | 4.7µH | Wurth Electronics Inc. | - | FIXED IND 4.7UH 3A 71 MOHM SMD | https://www.digikey.ca/product-detail/en/wurth-electronics-inc/744774047/732-1266-1-ND/1639327 | 1.76 | 1.40 | 1.76 | 140.00 | https://lcsc.com/product-detail/Power-Inductors_COILMX-MSA54-4R7M_C396410.html | 0.10 | 0.07 | 0.10 | 7.05 | 132.95 | https://lcsc.com/product-detail/Power-Inductors_COILMX-MSA54-4R7M_C396410.html | TRUE | 0.07 | 7.05 | CT
L2 | 1 | MI0603L301R-10 | 240-2374-1-ND | 300 Ohms @ 100MHz | Laird-Signal Integrity Products | L0603 | FERRITE BEAD 300 OHM 0603 1LN | https://www.digikey.ca/product-detail/en/laird-signal-integrity-products/MI0603L301R-10/240-2374-1-ND/806734 | 0.19 | 0.09 | 0.19 | 8.55 | - | - | - | - | - | - | https://www.digikey.ca/product-detail/en/laird-signal-integrity-products/MI0603L301R-10/240-2374-1-ND/806734 | TRUE | 0.09 | 8.55 | CT
L3 | 1 | FBMH1608HL601-T | 587-1737-1-ND | 600 Ohms @ 100MHz | Taiyo Yuden | L0603 | FERRITE BEAD 600 OHM 0603 1LN | https://www.digikey.ca/product-detail/en/taiyo-yuden/FBMH1608HL601-T/587-1737-1-ND/1147062 | 0.11 | 0.05 | 0.11 | 5.23 | https://lcsc.com/product-detail/Ferrite-Beads_Murata-Electronics_BLM18AG601SN1D_Murata-Electronics-BLM18AG601SN1D_C19330.html | 0.01 | 0.01 | 0.01 | 0.83 | 4.40 | https://lcsc.com/product-detail/Ferrite-Beads_Murata-Electronics_BLM18AG601SN1D_Murata-Electronics-BLM18AG601SN1D_C19330.html | TRUE | 0.01 | 0.83 | CT
C1, C4, C21, C27, C28, C30, C37, C38, C42, C46, C47, C49, C50, C52, C53, C55, C56, C57, C59 | 19 | CC0603KRX7R7BB104 | 311-1088-1-ND | 100nF | Yageo | C0603 | CAP CER 0.1UF 16V X7R 0603 | https://www.digikey.ca/product-detail/en/yageo/CC0603KRX7R7BB104/311-1088-1-ND/302998 | 0.10 | 0.02 | 1.90 | 44.46 | https://lcsc.com/product-detail/Multilayer-Ceramic-Capacitors-MLCC-SMD-SMT_Walsin-Tech-Corp-0603B104K160CT_C80516.html | 0.01 | 0.01 | 0.10 | 9.50 | 34.96 | https://lcsc.com/product-detail/Multilayer-Ceramic-Capacitors-MLCC-SMD-SMT_Walsin-Tech-Corp-0603B104K160CT_C80516.html | TRUE | 0.01 | 9.50 | CT
C2 | 1 | C1608X7S0J106M080AC | 445-9104-1-ND | 10uF | TDK Corporation | C0603 | CAP CER 10UF 6.3V X7S 0603 | https://www.digikey.ca/product-detail/en/tdk-corporation/C1608X7S0J106M080AC/445-9104-1-ND/3661624 | 0.55 | 0.26 | 0.55 | 25.62 | https://lcsc.com/product-detail/Multilayer-Ceramic-Capacitors-MLCC-SMD-SMT_SAMSUNG_CL10A106MQ8NNNC_10uF-106-20-6-3V_C1691.html | 0.01 | 0.01 | 0.01 | 1.45 | 24.17 | https://lcsc.com/product-detail/Multilayer-Ceramic-Capacitors-MLCC-SMD-SMT_SAMSUNG_CL10A106MQ8NNNC_10uF-106-20-6-3V_C1691.html | TRUE | 0.01 | 1.45 | CT
C3 | 1 | GCM21BR72A473KA37L | 490-4969-1-ND | 47nF | Murata Electronics North America | C0805 | CAP CER 0.047UF 100V X7R 0805 | https://www.digikey.ca/product-detail/en/murata-electronics-north-america/GCM21BR72A473KA37L/490-4969-1-ND/1765288 | 0.29 | 0.11 | 0.29 | 11.42 | https://lcsc.com/product-detail/Others_TDK-C2012X7R2A473KT0L0U_C342507.html | 0.03 | 0.03 | 0.03 | 2.57 | 8.85 | https://lcsc.com/product-detail/Others_TDK-C2012X7R2A473KT0L0U_C342507.html | TRUE | 0.03 | 2.57 | CT
C5, C6, C19, C23 | 4 | LMK212AC6106MD-T | 587-6337-1-ND | 10uF | Taiyo Yuden | C0805 | CAP CER 10UF 10V X6S 0805 | https://www.digikey.ca/product-detail/en/taiyo-yuden/LMK212AC6106MD-T/587-6337-1-ND/9949923 | 0.26 | 0.10 | 1.04 | 40.00 | - | - | - | - | - | - | https://www.digikey.ca/product-detail/en/taiyo-yuden/LMK212AC6106MD-T/587-6337-1-ND/9949923 | TRUE | 0.10 | 40.00 | CT
C7,C14 | 2 | GRM188R71E474KA12D | 490-3291-1-ND | 0.47uF | Murata Electronics | C0603 | CAP CER 0.47UF 25V X7R 0603 | https://www.digikey.ca/product-detail/en/murata-electronics/GRM188R71E474KA12D/490-3291-1-ND/702832 | 0.27 | 0.09 | 0.54 | 18.40 | - | - | - | - | - | - | https://www.digikey.ca/product-detail/en/murata-electronics/GRM188R71E474KA12D/490-3291-1-ND/702832 | TRUE | 0.09 | 18.40 | CT
C8 | 1 | CL31A106MBHNNNE | 1276-6736-1-ND | 10uF | Samsung Electro-Mechanics | C1206 | CAP CER 10UF 50V X5R 1206 | https://www.digikey.ca/product-detail/en/samsung-electro-mechanics/CL31A106MBHNNNE/1276-6736-1-ND/5961595 | 0.34 | 0.13 | 0.34 | 13.00 | https://lcsc.com/product-detail/New-Arrivals_Taiyo-Yuden-UMK316BBJ106KL-T_C105175.html | 0.09 | 0.07 | 0.09 | 7.00 | 6.00 | https://lcsc.com/product-detail/New-Arrivals_Taiyo-Yuden-UMK316BBJ106KL-T_C105175.html | TRUE | 0.07 | 7.00 | CT
C9, C25 | 2 | CC0603KPX7R9BB104 | 311-3567-1-ND | 0.1uF | Yageo | C0603 | CAP CER 0.1UF 50V X7R 0603 | https://www.digikey.ca/product-detail/en/yageo/CC0603KPX7R9BB104/311-3567-1-ND/7648494 | 0.10 | 0.01 | 0.20 | 2.96 | - | - | - | - | - | - | https://www.digikey.ca/product-detail/en/yageo/CC0603KPX7R9BB104/311-3567-1-ND/7648494 | TRUE | 0.01 | 2.96 | CT
C10, C11 | 2 | EEE-FK1J680UP | PCE4307CT-ND | 68uF | Panasonic Electronic Components | Radial, Can - SMD | CAP ALUM 68UF 20% 63V SMD | https://www.digikey.ca/product-detail/en/panasonic-electronic-components/EEE-FK1J680UP/PCE4307CT-ND/949813 | 0.72 | 0.36 | 1.44 | 72.48 | https://lcsc.com/product-detail/Others_PANASONIC-EEEFK1J680UP_C336251.html | 0.36 | 0.23 | 0.72 | 45.80 | 26.68 | https://lcsc.com/product-detail/Others_PANASONIC-EEEFK1J680UP_C336251.html | TRUE | 0.23 | 45.80 | CT
C12, C29, C36, C39 | 4 | C2012X5R1A226K125AB | 445-7664-1-ND | 22uF | TDK Corporation | C0805 | CAP CER 22UF 10V X5R 0805 | https://www.digikey.ca/product-detail/en/tdk-corporation/C2012X5R1A226K125AB/445-7664-1-ND/2733736 | 0.57 | 0.27 | 2.28 | 106.56 | https://lcsc.com/product-detail/Multilayer-Ceramic-Capacitors-MLCC-SMD-SMT_TDK_C2012X5R1A226KT000N_22uF-226-10-10V_C76634.html | 0.26 | 0.16 | 1.03 | 65.55 | 41.01 | https://lcsc.com/product-detail/Multilayer-Ceramic-Capacitors-MLCC-SMD-SMT_TDK_C2012X5R1A226KT000N_22uF-226-10-10V_C76634.html | TRUE | 0.16 | 65.55 | CT
C13, C18, C20, C24 | 4 | C0805C224K1RACAUTO | 399-6946-1-ND | 220nF | KEMET | C0805 | CAP CER 0.22UF 100V X7R 0805 | https://www.digikey.ca/product-detail/en/kemet/C0805C224K1RACAUTO/399-6946-1-ND/3314454 | 0.37 | 0.15 | 1.48 | 61.60 | https://lcsc.com/product-detail/Multilayer-Ceramic-Capacitors-MLCC-SMD-SMT_PSA-Prosperity-Dielectrics-FM21X224K101ECG_C382241.html | 0.04 | 0.03 | 0.16 | 11.62 | 49.98 | https://lcsc.com/product-detail/Multilayer-Ceramic-Capacitors-MLCC-SMD-SMT_PSA-Prosperity-Dielectrics-FM21X224K101ECG_C382241.html | TRUE | 0.03 | 11.62 | CT
C15 | 1 | GCJ188R72A104KA01D | 490-13420-1-ND | 0.1uF | Murata Electronics | C0603 | CAP CER 0.1UF 100V X7R 0603 | https://www.digikey.ca/product-detail/en/murata-electronics/GCJ188R72A104KA01D/490-13420-1-ND/6012292 | 0.24 | 0.09 | 0.24 | 9.30 | - | - | - | - | - | - | https://www.digikey.ca/product-detail/en/murata-electronics/GCJ188R72A104KA01D/490-13420-1-ND/6012292 | TRUE | 0.09 | 9.30 | CT
C16 | 1 | CL31B226KQHNNNE | 1276-3146-1-ND | 22uF | Samsung Electro-Mechanics | C1206 | CAP CER 22UF 6.3V X7R 1206 | https://www.digikey.ca/product-detail/en/samsung-electro-mechanics/CL31B226KQHNNNE/1276-3146-1-ND/3891232 | 0.46 | 0.22 | 0.46 | 21.60 | https://lcsc.com/product-detail/Others_Taiyo-Yuden_JMK316AB7226KLHT_Taiyo-Yuden-JMK316AB7226KLHT_C268007.html | 0.12 | 0.09 | 0.12 | 8.94 | 12.66 | https://lcsc.com/product-detail/Others_Taiyo-Yuden_JMK316AB7226KLHT_Taiyo-Yuden-JMK316AB7226KLHT_C268007.html | TRUE | 0.09 | 8.94 | CT
C17, C22 | 2 | C0603C104K9RAC7867 | 399-15351-1-ND | 100nF | KEMET | C0603 | CAP CER 0.1UF 6.3V X7R 0603 | https://www.digikey.ca/product-detail/en/kemet/C0603C104K9RAC7867/399-15351-1-ND/7386749 | 0.18 | 0.06 | 0.36 | 11.88 | - | - | - | - | - | - | https://www.digikey.ca/product-detail/en/kemet/C0603C104K9RAC7867/399-15351-1-ND/7386749 | TRUE | 0.06 | 11.88 | CT
C26 | 1 | C0402C223J4RAC7867 | 399-14435-1-ND | 0.022µF | KEMET | C0402 | CAP CER 0.022UF 16V X7R 0402 | https://www.digikey.ca/product-detail/en/kemet/C0402C223J4RAC7867/399-14435-1-ND/7103727 | 0.50 | 0.23 | 0.50 | 23.33 | - | - | - | - | - | - | https://www.digikey.ca/product-detail/en/kemet/C0402C223J4RAC7867/399-14435-1-ND/7103727 | TRUE | 0.23 | 23.33 | CT
C31, C41 | 2 | LMK212BJ105MD-T | 587-4918-1-ND | 1uF | Taiyo Yuden | C0805 | CAP CER 1UF 10V X5R 0805 | https://www.digikey.ca/product-detail/en/taiyo-yuden/LMK212BJ105MD-T/587-4918-1-ND/6563761 | 0.17 | 0.06 | 0.34 | 11.34 | - | - | - | - | - | - | https://www.digikey.ca/product-detail/en/taiyo-yuden/LMK212BJ105MD-T/587-4918-1-ND/6563761 | TRUE | 0.06 | 11.34 | CT
C32, C33 | 2 | CC0603BRNPO9BN2R0 | 311-3827-1-ND | 2pF | Yageo | C0603 | CAP CER 2PF 50V NPO 0603 | https://www.digikey.ca/product-detail/en/yageo/CC0603BRNPO9BN2R0/311-3827-1-ND/8024916 | 0.11 | 0.04 | 0.22 | 7.68 | - | - | - | - | - | - | https://www.digikey.ca/product-detail/en/yageo/CC0603BRNPO9BN2R0/311-3827-1-ND/8024916 | TRUE | 0.04 | 7.68 | CT
C34, C35 | 2 | CC0603BRNPO9BN4R7 | 399-16185-1-ND | 4.3pF | KEMET | C0603 | CAP CER RF 4.3PF 50V +/-0.1 PF C | https://www.digikey.ca/product-detail/en/kemet/CBR06C439B5GAC/399-16185-1-ND/7649770 | 0.26 | 0.10 | 0.52 | 20.48 | - | - | - | - | - | - | https://www.digikey.ca/product-detail/en/kemet/CBR06C439B5GAC/399-16185-1-ND/7649770 | TRUE | 0.10 | 20.48 | CT
C40, C43, C48 | 3 | JMK107B7105KA-T | 587-2834-1-ND | 1uF | Taiyo Yuden | C0603 | CAP CER 1UF 6.3V X7R 0603 | https://www.digikey.ca/product-detail/en/taiyo-yuden/JMK107B7105KA-T/587-2834-1-ND/2607801 | 0.11 | 0.04 | 0.33 | 11.16 | - | - | - | - | - | - | https://www.digikey.ca/product-detail/en/taiyo-yuden/JMK107B7105KA-T/587-2834-1-ND/2607801 | TRUE | 0.04 | 11.16 | CT
C44 | 1 | TAJA106K010RNJ | 478-1654-1-ND | 10uF | AVX Corporation | C1206 | CAP TANT 10UF 10% 10V 1206 | https://www.digikey.ca/product-detail/en/avx-corporation/TAJA106K010RNJ/478-1654-1-ND/564686 | 0.38 | 0.16 | 0.38 | 15.80 | - | - | - | - | - | - | https://www.digikey.ca/product-detail/en/avx-corporation/TAJA106K010RNJ/478-1654-1-ND/564686 | TRUE | 0.16 | 15.80 | CT
C45 | 1 | CC0603KRX7R9BB103 | 311-1085-1-ND | 10nF | Yageo | C0603 | CAP CER 10000PF 50V X7R 0603 | https://www.digikey.ca/product-detail/en/yageo/CC0603KRX7R9BB103/311-1085-1-ND/302995 | 0.10 | 0.02 | 0.10 | 1.81 | - | - | - | - | - | - | https://www.digikey.ca/product-detail/en/yageo/CC0603KRX7R9BB103/311-1085-1-ND/302995 | TRUE | 0.02 | 1.81 | CT
C51, C54, C58 | 3 | CL31B225KAHNNNE | 1276-1072-1-ND | 2.2uF | Samsung Electro-Mechanics | C1206 | CAP CER 2.2UF 25V X7R 1206 | https://www.digikey.ca/product-detail/en/samsung-electro-mechanics/CL31B225KAHNNNE/1276-1072-1-ND/3889158 | 0.24 | 0.08 | 0.72 | 25.08 | https://lcsc.com/product-detail/Multilayer-Ceramic-Capacitors-MLCC-SMD-SMT_Samsung-Electro-Mechanics-CL31B225KAHNNNE_C170102.html | 0.05 | 0.04 | 0.16 | 11.88 | 13.20 | https://lcsc.com/product-detail/Multilayer-Ceramic-Capacitors-MLCC-SMD-SMT_Samsung-Electro-Mechanics-CL31B225KAHNNNE_C170102.html | TRUE | 0.04 | 11.88 | CT
R1 | 1 | RNCP0603FTD10K0 | RNCP0603FTD10K0CT-ND | 10K | Stackpole Electronics Inc | R0603 | RES 10K OHM 1% 1/8W 0603 | https://www.digikey.ca/product-detail/en/stackpole-electronics-inc/RNCP0603FTD10K0/RNCP0603FTD10K0CT-ND/2240478 | 0.10 | 0.03 | 0.10 | 2.73 | - | - | - | - | - | - | https://www.digikey.ca/product-detail/en/stackpole-electronics-inc/RNCP0603FTD10K0/RNCP0603FTD10K0CT-ND/2240478 | TRUE | 0.03 | 2.73 | CT
R4, R6 | 2 | CRA2512-FZ-R100ELF | CRA2512-FZ-R100ELFCT-ND | 0.1 | Bourns Inc. | R2512 | RES 0.1 OHM 1% 3W 2512 | https://www.digikey.ca/product-detail/en/bourns-inc/CRA2512-FZ-R100ELF/CRA2512-FZ-R100ELFCT-ND/1775059 | 0.60 | 0.34 | 1.20 | 67.12 | - | - | - | - | - | - | https://www.digikey.ca/product-detail/en/bourns-inc/CRA2512-FZ-R100ELF/CRA2512-FZ-R100ELFCT-ND/1775059 | TRUE | 0.34 | 67.12 | CT
R5, R17, R18, R23 | 4 | RT0603BRD0710KL | YAG1236CT-ND | 10K | Yageo | R0603 | RES SMD 10K OHM 0.1% 1/10W 0603 | https://www.digikey.ca/product-detail/en/yageo/RT0603BRD0710KL/YAG1236CT-ND/4340589 | 0.36 | 0.12 | 1.44 | 47.64 | https://lcsc.com/product-detail/High-Precision-Low-TCR-SMD-Resistors_Resistor-Today-PTFR0603B10K0P9_C328421.html | 0.09 | 0.07 | 0.35 | 27.41 | 20.23 | https://lcsc.com/product-detail/High-Precision-Low-TCR-SMD-Resistors_Resistor-Today-PTFR0603B10K0P9_C328421.html | TRUE | 0.07 | 27.41 | CT
R7, R8 | 2 | ESR03EZPJ102 | RHM1.0KDCT-ND | 1K | Rohm Semiconductor | R0603 | RES SMD 1K OHM 5% 1/4W 0603 | https://www.digikey.ca/product-detail/en/rohm-semiconductor/ESR03EZPJ102/RHM1.0KDCT-ND/1762924 | 0.10 | 0.03 | 0.20 | 6.00 | https://lcsc.com/product-detail/Chip-Resistor-Surface-Mount_ROHM-Semicon-ESR03EZPJ102_C253329.html | - | 0.02 | - | 3.02 | 2.98 | https://lcsc.com/product-detail/Chip-Resistor-Surface-Mount_ROHM-Semicon-ESR03EZPJ102_C253329.html | TRUE | 0.02 | 3.02 | CT
R9, R10, R12, R25, R29, R30 | 6 | RC0603JR-070RL | 311-0.0GRCT-ND | 0 Ohms | Yageo | R0603 | RES SMD 0 OHM JUMPER 1/10W 0603 | https://www.digikey.ca/product-detail/en/yageo/RC0603JR-070RL/311-0.0GRCT-ND/729622 | 0.10 | 0.01 | 0.60 | 4.62 | - | - | - | - | - | - | https://www.digikey.ca/product-detail/en/yageo/RC0603JR-070RL/311-0.0GRCT-ND/729622 | TRUE | 0.01 | 4.62 | CT
R15 | 1 | RN73H1JTTD1003B25 | 2019-RN73H1JTTD1003B25CT-ND | 100K | KOA Speer Electronics, Inc. | R0603 | RES 100K OHM 0.1% 1/10W 0603 | https://www.digikey.ca/product-detail/en/koa-speer-electronics-inc/RN73H1JTTD1003B25/2019-RN73H1JTTD1003B25CT-ND/10706978 | 0.55 | 0.21 | 0.55 | 20.60 | https://lcsc.com/product-detail/High-Precision-Low-TCR-SMD-Resistors_YAGEO-RT0603BRD07100KL_C122538.html | - | 0.03 | - | 2.93 | 17.67 | https://lcsc.com/product-detail/High-Precision-Low-TCR-SMD-Resistors_YAGEO-RT0603BRD07100KL_C122538.html | TRUE | 0.03 | 2.93 | CT
R16 | 1 | RT0603BRD0722KL | YAG1592CT-ND | 22K | Yageo | R0603 | RES SMD 22K OHM 0.1% 1/10W 0603 | https://www.digikey.ca/product-detail/en/yageo/RT0603BRD0722KL/YAG1592CT-ND/5139040 | 0.36 | 0.12 | 0.36 | 11.91 | https://lcsc.com/product-detail/Chip-Resistor-Surface-Mount_YAGEO-RT0603BRD0722KL_C469656.html | - | 0.03 | - | 2.59 | 9.32 | https://lcsc.com/product-detail/Chip-Resistor-Surface-Mount_YAGEO-RT0603BRD0722KL_C469656.html | TRUE | 0.03 | 2.59 | CT
R19, R20 | 2 | CPF0603B22RE | A119957CT-ND | 22 | TE Connectivity Passive Product | R0603 | RES SMD 22 OHM 0.1% 1/16W 0603 | https://www.digikey.ca/product-detail/en/te-connectivity-passive-product/CPF0603B22RE/A119957CT-ND/4966555 | 0.49 | 0.18 | 0.98 | 36.66 | - | - | - | - | - | - | https://www.digikey.ca/product-detail/en/te-connectivity-passive-product/CPF0603B22RE/A119957CT-ND/4966555 | TRUE | 0.18 | 36.66 | CT
R21 | 1 | RC0603FR-07430KL | 311-430KHRCT-ND | 430K | Yageo | R0603 | RES SMD 430K OHM 1% 1/10W 0603 | https://www.digikey.ca/product-detail/en/yageo/RC0603FR-07430KL/311-430KHRCT-ND/730184 | 0.10 | 0.01 | 0.10 | 0.94 | - | - | - | - | - | - | https://www.digikey.ca/product-detail/en/yageo/RC0603FR-07430KL/311-430KHRCT-ND/730184 | TRUE | 0.01 | 0.94 | CT
R22 | 1 | RC0603FR-07620KL | 311-620KHRCT-ND | 620K | Yageo | R0603 | RES SMD 620K OHM 1% 1/10W 0603 | https://www.digikey.ca/product-detail/en/yageo/RC0603FR-07620KL/311-620KHRCT-ND/730285 | 0.10 | 0.01 | 0.10 | 0.94 | - | - | - | - | - | - | https://www.digikey.ca/product-detail/en/yageo/RC0603FR-07620KL/311-620KHRCT-ND/730285 | TRUE | 0.01 | 0.94 | CT
R24 | 1 | NTCS0805E3472JMT | BC2296DKR-ND | 4.7k | Vishay BC Components | R0805 | THERM NTC 4.7KOHM 3500K 0805 | https://www.digikey.ca/product-detail/en/vishay-bc-components/NTCS0805E3472JMT/BC2296DKR-ND/1801657 | 0.55 | 0.28 | 0.55 | 28.31 | - | - | - | - | - | - | https://www.digikey.ca/product-detail/en/vishay-bc-components/NTCS0805E3472JMT/BC2296DKR-ND/1801657 | TRUE | 0.28 | 28.31 | CT
R26, R28 | 2 | ERJ-2RKF4700X | P470LCT-ND | 470 | Panasonic Electronic Components | R0402 | RES SMD 470 OHM 1% 1/10W 0402 | https://www.digikey.ca/product-detail/en/panasonic-electronic-components/ERJ-2RKF4700X/P470LCT-ND/1746691 | 0.10 | 0.02 | 0.20 | 3.36 | - | - | - | - | - | - | https://www.digikey.ca/product-detail/en/panasonic-electronic-components/ERJ-2RKF4700X/P470LCT-ND/1746691 | TRUE | 0.02 | 3.36 | CT
R27 | 1 | MCS0402MC1001FE000 | MCS0402-1.00K-MFCT-ND | 1K | Vishay Beyschlag | R0402 | RES SMD 1K OHM 1% 1/10W 0402 | https://www.digikey.ca/product-detail/en/vishay-beyschlag/MCS0402MC1001FE000/MCS0402-1.00K-MFCT-ND/3883095 | 0.29 | 0.09 | 0.29 | 9.46 | - | - | - | - | - | - | https://www.digikey.ca/product-detail/en/vishay-beyschlag/MCS0402MC1001FE000/MCS0402-1.00K-MFCT-ND/3883095 | TRUE | 0.09 | 9.46 | CT
R31, R32 | 2 | RC0603FR-07137RL | 311-137HRCT-ND | 137 | Yageo | R0603 | RES SMD 137 OHM 1% 1/10W 0603 | https://www.digikey.ca/product-detail/en/yageo/RC0603FR-07137RL/311-137HRCT-ND/729885 | 0.10 | 0.01 | 0.20 | 1.88 | - | - | - | - | - | - | https://www.digikey.ca/product-detail/en/yageo/RC0603FR-07137RL/311-137HRCT-ND/729885 | TRUE | 0.01 | 1.88 | CT
 |  |  |  |  |  |  |  | Total Comp |  |  | 73.46 | 4678.53 |  |  |  |  |  |  | Total Comp |  |  | 3801.61
 |  |  |  |  |  |  |  | Total Comp/board |  |  | 73.46 | 46.79 |  |  |  |  |  |  | Total Comp/board |  |  | 38.02
 |  |  |  |  |  |  |  | PCB |  |  | 38.50 | 4.00 |  |  |  |  |  |  | PCB |  |  | 4.00
 |  |  |  |  |  |  |  | Total Cost |  |  | 111.96 | 50.79 |  |  |  |  |  |  | Total Cost |  |  | 42.02

Sheet: LSS Pro V0.1 PnP
LSS Pro Board V0.1
Part | Description | Package | Location | Tape Width (mm) | Tape Pitch (mm) | Tape Height (mm) | Cartridge Output Height (mm) | Head | Feeder Number |  | #Used feeders | #Available feeders | #Remaining feeders
U1 | IC MCU 32BIT 1MB FLASH 100LQFP | LQFP-100 | Top | Tray | - | - | - | 2 | 60 | # Top | 79
U3 | IC MTR DRV BIPLR 3.3/5V 89VFQFPN | VFQFPN-89 | Top | Tray | - | - | - | 2 | 61 | # Top 8mm | 22 | 22 | 0
L1 | FIXED IND 4.7UH 3A 71 MOHM SMD | - | Top | Tray | - | - | - | 2 | 63 | # Top 12mm | 4 | 4 | 0
U4 | LOW-POWER, HIGH-PERFORMANCE INTE | LGA-14 | Top | 12 | 8 | 1.1 | 1.5 | 1 | 24 | # Top 16mm | 1 | 2 | 1
U5 | IC BUF NON-INVERT 5.5V SC70-5 | SC-70-5 | Top | 8 | 4 | 1.4 | 2.5 | 1 | 1 | # Top 24mm | 0 | 1 | 1
U6 | IC BUF NON-INVERT 5.5V SC70-5 | SC-70-5 | Top |  |  |  |  |  | 1 | # Bottom | 6
PS1 | IC REG BUCK 5V 2A 16QFN | VFQFN-16 | Top | 12 | 8 | 1 | 1.5 | 1 | 23 | # Bottom 8mm | 0
PS2 | IC REG LINEAR 3.3V 1A SOT223 | SOT-223 | Top | 12 | 12 | 1.6 | 2.5 | 1 | 25 | # Bottom 12mm | 0
PS3 | IC REG LINEAR 3.3V 1A SOT223 | SOT-224 | Top |  |  |  |  |  | 25 | # Bottom 16mm | 0
PS4 | IC VREF SERIES 3.3V SOT23-3 | SOT-23-3 | Top | 8 | 4 | 1 | 1.5 | 1 | 2 | # Bottom 24mm | 0
D1 | DIODE SCHOTTKY 40V 3A SOD123W | SOD-123W | Top | 8 | 4 | 1.1 | 1.5 | 1 | 3 | Head 1 | 503
D2 | TVS DIODE 5V SOT23-6 | SOT-23-6 | Top | 8 | 4 | 1.45 | 1.5 | 1 | 4 | Head 2 | 506
D3 | DIODE ARRAY SCHOTTKY 30V SOT23-3 | SOT-23-3 | Top | 8 | 4 | 1.4 | 1.5 | 1 | 5
BUSY | LED RED CLEAR SMD | LED0603 | Top | 8 | 4 | 0.85 | 1.5 | 1 | 6
FLAG | LED BLUE CLEAR SMD | LED0603 | Top | 8 | 4 | 0.85 | 1.5 | 1 | 7
PWR | LED GREEN CLEAR 0603 SMD | LED0603 | Top | 8 | 4 | 0.85 | 1.5 | 1 | 8
LED1 | ADDRESS LED DISCR SER RGB | LED5050 | Top | 16 | 8 | 1.6 | 2.5 | 2 | 27
LED2 | ADDRESS LED DISCR SER RGB | LED5050 | Top |  |  |  |  |  | 27 |  |  | Resistor
LED3 | ADDRESS LED DISCR SER RGB | LED5050 | Top |  |  |  |  |  | 27 |  |  | Capacitor
LED4 | ADDRESS LED DISCR SER RGB | LED5050 | Top |  |  |  |  |  | 27 |  |  | IC's
LED5 | ADDRESS LED DISCR SER RGB | LED5050 | Top |  |  |  |  |  | 27 |  |  | Diodes
LED6 | ADDRESS LED DISCR SER RGB | LED5050 | Top |  |  |  |  |  | 27 |  |  | Other
Q1 | MOSFET N-CH 50V 220MA SOT-23 | SOT-23-3 | Top | 8 | 4 | 1 | 1.5 | 1 | 9
Y1 | CRYSTAL 32.768KHZ 6PF SMD | 2-SMD, No Lead | Top | 12 | 4 | 1 | 1.5 | 1 | 26
Y2 | CRYSTAL 16.0000MHZ 8PF SMD | 4-SMD, No Lead | Top | 8 | 4 | 1 | 1.5 | 1 | 10
C4 | CAP CER 0.1UF 16V X7R 0603 | C0603 | Top | 8 | 4 | 1.1 | 1.5 | 1 | 11
C21 | CAP CER 0.1UF 16V X7R 0603 | C0603 | Top |  |  |  |  |  | 11
C27 | CAP CER 0.1UF 16V X7R 0603 | C0603 | Top |  |  |  |  |  | 11
C28 | CAP CER 0.1UF 16V X7R 0603 | C0603 | Top |  |  |  |  |  | 11
C30 | CAP CER 0.1UF 16V X7R 0603 | C0603 | Top |  |  |  |  |  | 11
C37 | CAP CER 0.1UF 16V X7R 0603 | C0603 | Top |  |  |  |  |  | 11
C38 | CAP CER 0.1UF 16V X7R 0603 | C0603 | Top |  |  |  |  |  | 11
C42 | CAP CER 0.1UF 16V X7R 0603 | C0603 | Top |  |  |  |  |  | 11
C46 | CAP CER 0.1UF 16V X7R 0603 | C0603 | Top |  |  |  |  |  | 11
C47 | CAP CER 0.1UF 16V X7R 0603 | C0603 | Top |  |  |  |  |  | 11
C49 | CAP CER 0.1UF 16V X7R 0603 | C0603 | Top |  |  |  |  |  | 11
C50 | CAP CER 0.1UF 16V X7R 0603 | C0603 | Top |  |  |  |  |  | 11
C52 | CAP CER 0.1UF 16V X7R 0603 | C0603 | Top |  |  |  |  |  | 11
C53 | CAP CER 0.1UF 16V X7R 0603 | C0603 | Top |  |  |  |  |  | 11
C55 | CAP CER 0.1UF 16V X7R 0603 | C0603 | Top |  |  |  |  |  | 11
C56 | CAP CER 0.1UF 16V X7R 0603 | C0603 | Top |  |  |  |  |  | 11
C57 | CAP CER 0.1UF 16V X7R 0603 | C0603 | Top |  |  |  |  |  | 11
C59 | CAP CER 0.1UF 16V X7R 0603 | C0603 | Top |  |  |  |  |  | 11
C5 | CAP CER 10UF 10V X6S 0805 | C0805 | Top | 8 | 4 | 2 | 2.5 | 1 | 12
C6 | CAP CER 10UF 10V X6S 0805 | C0805 | Top |  |  |  |  |  | 12
C19 | CAP CER 10UF 10V X6S 0805 | C0805 | Top |  |  |  |  |  | 12
C23 | CAP CER 10UF 10V X6S 0805 | C0805 | Top |  |  |  |  |  | 12
C12 | CAP CER 22UF 10V X5R 0805 | C0805 | Top | 8 | 4 | 2 | 2.5 | 1 | 13
C29 | CAP CER 22UF 10V X5R 0805 | C0805 | Top |  |  |  |  |  | 13
C36 | CAP CER 22UF 10V X5R 0805 | C0805 | Top |  |  |  |  |  | 13
C39 | CAP CER 22UF 10V X5R 0805 | C0805 | Top |  |  |  |  |  | 13
C13 | CAP CER 0.22UF 100V X7R 0805 | C0805 | Top | 8 | 4 | 2 | 2.5 | 1 | 14
C18 | CAP CER 0.22UF 100V X7R 0805 | C0805 | Top |  |  |  |  |  | 14
C20 | CAP CER 0.22UF 100V X7R 0805 | C0805 | Top |  |  |  |  |  | 14
C24 | CAP CER 0.22UF 100V X7R 0805 | C0805 | Top |  |  |  |  |  | 14
C40 | CAP CER 1UF 6.3V X7R 0603 | C0603 | Top | 8 | 4 | 1.1 | 1.5 | 1 | 15
C43 | CAP CER 1UF 6.3V X7R 0603 | C0603 | Top |  |  |  |  |  | 15
C48 | CAP CER 1UF 6.3V X7R 0603 | C0603 | Top |  |  |  |  |  | 15
C51 | CAP CER 2.2UF 25V X7R 1206 | C1206 | Top | 8 | 4 | 2.05 | 2.5 | 1 | 16
C54 | CAP CER 2.2UF 25V X7R 1206 | C1206 | Top |  |  |  |  |  | 16
C58 | CAP CER 2.2UF 25V X7R 1206 | C1206 | Top |  |  |  |  |  | 16
R5 | RES SMD 10K OHM 0.1% 1/10W 0603 | R0603 | Top | 8 | 4 | 0.95 | 1.5 | 1 | 17
R17 | RES SMD 10K OHM 0.1% 1/10W 0603 | R0603 | Top |  |  |  |  |  | 17
R18 | RES SMD 10K OHM 0.1% 1/10W 0603 | R0603 | Top |  |  |  |  |  | 17
R23 | RES SMD 10K OHM 0.1% 1/10W 0603 | R0603 | Top |  |  |  |  |  | 17
R7 | RES SMD 1K OHM 5% 1/4W 0603 | R0603 | Top | 8 | 4 | 0.95 | 1.5 | 1 | 18
R8 | RES SMD 1K OHM 5% 1/4W 0603 | R0603 | Top |  |  |  |  |  | 18
R9 | RES SMD 0 OHM JUMPER 1/10W 0603 | R0603 | Top | 8 | 4 | 0.95 | 1.5 | 1 | 19
R10 | RES SMD 0 OHM JUMPER 1/10W 0603 | R0603 | Top |  |  |  |  |  | 19
R12 | RES SMD 0 OHM JUMPER 1/10W 0603 | R0603 | Top |  |  |  |  |  | 19
R25 | RES SMD 0 OHM JUMPER 1/10W 0603 | R0603 | Top |  |  |  |  |  | 19
R29 | RES SMD 0 OHM JUMPER 1/10W 0603 | R0603 | Top |  |  |  |  |  | 19
R30 | RES SMD 0 OHM JUMPER 1/10W 0603 | R0603 | Top |  |  |  |  |  | 19
R31 | RES SMD 137 OHM 1% 1/10W 0603 | R0603 | Top | 8 | 4 | 0.95 | 1.5 | 1 | 20
R32 | RES SMD 137 OHM 1% 1/10W 0603 | R0603 | Top |  |  |  |  |  | 20
R19 | RES SMD 22 OHM 0.1% 1/16W 0603 | R0603 | Top | 8 | 4 | 0.95 | 1.5 | 1 | 21
R20 | RES SMD 22 OHM 0.1% 1/16W 0603 | R0603 | Top |  |  |  |  |  | 21
C31 | CAP CER 1UF 10V X5R 0805 | C0805 | Top | 8 | 4 | 2 | 2.5 |  | 22
C41 | CAP CER 1UF 10V X5R 0805 | C0805 | Top |  |  |  |  |  | 22
U2 | ROTARY ENCODER MAGNETIC 4096PPR | QFN-24 | Bottom | - | - | - | - | 1 | 62
C1 | CAP CER 0.1UF 16V X7R 0603 | C0603 | Bottom |  |  |  |  |  | 11
C46 | CAP CER 0.1UF 16V X7R 0603 | C0603 | Bottom |  |  |  |  |  | 11
C47 | CAP CER 0.1UF 16V X7R 0603 | C0603 | Bottom |  |  |  |  |  | 11
C59 | CAP CER 0.1UF 16V X7R 0603 | C0603 | Bottom |  |  |  |  |  | 11
C48 | CAP CER 1UF 6.3V X7R 0603 | C0603 | Bottom |  |  |  |  |  | 15

Sheet: LSS Pro Programmer V0.1 BOM
LSS Pro Programmer V0.1
Part | QTY/Bd | MF SKU | Digikey SKU | Value | Manufacturer | Package | Description | Example
JTAG | 1 | 302-S201 | ED10524-ND | - | On Shore Technology Inc | - | CONN HEADER VERT 20POS 2.54MM | https://www.digikey.ca/product-detail/en/on-shore-technology-inc/302-S201/ED10524-ND/2794235
3V3/1, 3V3/2, 3V3/REF, 5V, AGND, CAN-RX, CAN-TX, GND1, GND2, JTDI, NRST, PST-SCK, PST-SDI, PST-SDO, RST, RX, SWCLK, SWDIO, SWO, TX | 20 | 0905-0-15-20-75-14-11-0 | ED9009-ND | - | Mill-Max Manufacturing Corp. | - | CONTACT SPRING LOADED SMD GOLD | https://www.digikey.ca/products/en?keywords=ED9009-ND
R1, R2, R3 | 3 | RNCP0603FTD10K0 | RNCP0603FTD10K0CT-ND | 10K | Stackpole Electronics Inc | C0603 | RES 10K OHM 1% 1/8W 0603 | https://www.digikey.ca/product-detail/en/stackpole-electronics-inc/RNCP0603FTD10K0/RNCP0603FTD10K0CT-ND/2240478
 | 3 | 5001 | 36-5001-ND | - | Keystone Electronics | - | PC TEST POINT MINIATURE BLACK | https://www.digikey.ca/product-detail/en/keystone-electronics/5001/36-5001-ND/255327
 | 17 | 5000 | 36-5000-ND | - | Keystone Electronics | - | PC TEST POINT MINIATURE RED | https://www.digikey.ca/product-detail/en/keystone-electronics/5000/36-5000-ND/255326

Sheet: Pro Skin Prototype V0.1 BOM
Pro Skin Prototype V0.1
Part | QTY/Bd | MF SKU | Digikey SKU | Value | Manufacturer | Package | Description | Example
IC1 | 1 | 74HC595D | 74HC595DCT-ND | - | Toshiba Semiconductor and Storage | SO-16 | IC SHIFT REGISTER 8BIT 16SOP | https://www.digikey.ca/product-detail/en/toshiba-semiconductor-and-storage/74HC595D/74HC595DCT-ND/5879972
IC2 | 1 | 74HC4051D | 74HC4051DCT-ND | - | Toshiba Semiconductor and Storage | SO-16 | IC MUX 8:1 4 OHM 16SOIC | https://www.digikey.ca/product-detail/en/toshiba-semiconductor-and-storage/74HC4051D/74HC4051DCT-ND/6109125
R1, R2, R3, R4 | 4 | ERJ-3EKF2000V | P200HCT-ND | 200 | Panasonic Electronic Components | R0603 | RES SMD 200 OHM 1% 1/10W 0603 | https://www.digikey.ca/product-detail/en/panasonic-electronic-components/ERJ-3EKF2000V/P200HCT-ND/198240
C1, C2, C3, C4, C5, C6, C7 | 7 | CC0603KRX7R7BB104 | 311-1088-1-ND | 100nF | Yageo | C0603 | CAP CER 0.1UF 16V X7R 0603 | https://www.digikey.ca/product-detail/en/yageo/CC0603KRX7R7BB104/311-1088-1-ND/302998
D1, D2, D3, D4 | 4 | MMSD4148T1G | MMSD4148T1GOSCT-ND | - | ON Semiconductor | SOD-123 | DIODE GEN PURP 100V 200MA SOD123 | https://www.digikey.ca/product-detail/en/on-semiconductor/MMSD4148T1G/MMSD4148T1GOSCT-ND/1121611
J1, J2 | 2 | 527460671 | WM7977CT-ND | - | Molex | - | CONN FFC BOTTOM 6POS 0.50MM R/A | https://www.digikey.ca/product-detail/en/molex/0527460671/WM7977CT-ND/2074166

Sheet: 4.5-40V to 5V3.3V Breakout BOM
4.5-40V to 5V/3.3V Breakout BOM
Part | QTY/Bd | MF SKU | Digikey SKU | Value | Manufacturer | Package | Description | Example
IC1,IC2 | 2 | XC6222B331MR-G | 893-1143-1-ND | - | Torex Semiconductor Ltd | SOT-25 | IC REG LINEAR 3.3V 700MA SOT25 | https://www.digikey.ca/product-detail/en/torex-semiconductor-ltd/XC6222B331MR-G/893-1143-1-ND/2138334
C3 | 1 | CL10B104KB8NNNC | 1276-1000-1-ND | 0.1uF | TDK Corporation | C0603 | CAP CER 0.1UF 50V X7R 0603 | https://www.digikey.ca/product-detail/en/samsung-electro-mechanics/CL10B104KB8NNNC/1276-1000-1-ND/3889086
C1,C8 | 2 | GRJ155R60J106ME11D | 490-13211-1-ND | 10uF | Murata Electronics | C0402 | CAP CER 10UF 6.3V X5R 0402 | https://www.digikey.com/product-detail/en/murata-electronics-north-america/GRJ155R60J106ME11D/490-13211-1-ND/5877419
C4 | 1 | CL31A106MBHNNNE | 1276-6736-1-ND | 10uF | Samsung Electro-Mechanics | C1206 | CAP CER 10UF 50V X5R 1206 | https://www.digikey.com/product-detail/en/samsung-electro-mechanics/CL31A106MBHNNNE/1276-6736-1-ND/5961595
C7 | 1 | C0402C223J4RAC7867 | 399-14435-1-ND | 0.022µF | KEMET | C0402 | CAP CER 0.022UF 16V X7R 0402 | https://www.digikey.ca/product-detail/en/kemet/C0402C223J4RAC7867/399-14435-1-ND/7103727
C5,C6 | 2 | C2012X5R1A226K125AB | 445-7664-1-ND | 22uF | TDK Corporation | C0805 | CAP CER 22UF 10V X5R 0805 | https://www.digikey.ca/product-detail/en/tdk-corporation/C2012X5R1A226K125AB/445-7664-1-ND/2733736
C2,C9 | 2 | GRM155R60J475ME47D | 490-5915-1-ND | 4.7uF | Murata Electronics | C0402 | CAP CER 4.7UF 6.3V X5R 0402 | https://www.digikey.com/product-detail/en/murata-electronics-north-america/GRM155R60J475ME47D/490-5915-1-ND/3719860
L1 | 1 | 744774047 | 732-1266-1-ND | 4.7µH | Wurth Electronics Inc. | - | FIXED IND 4.7UH 3A 71 MOHM SMD | https://www.digikey.ca/product-detail/en/wurth-electronics-inc/744774047/732-1266-1-ND/1639327
D1 | 1 | PMEG4030ER,115 | 1727-5313-1-ND | - | Nexperia USA Inc | SW-123W | DIODE SCHOTTKY 40V 3A SOD123W | https://www.digikey.ca/product-detail/en/nexperia-usa-inc/PMEG4030ER115/1727-5313-1-ND/2676789
U1 | 1 | TS30042-M050QFNR | TS30042-M050QFNRCT-ND | - | Semtech Corporation | QFN-16 | IC REG BUCK 5V 2A 16QFN | https://www.digikey.ca/product-detail/en/semtech-corporation/TS30042-M050QFNR/TS30042-M050QFNRCT-ND/6605537

Sheet: Sheet8
4.5-40V to 5V/3.3V Breakout BOM
Part | QTY/Bd | MF SKU | Digikey SKU | Value | Manufacturer | Package | Description | Example
U1 | 1 | TS30042-M050QFNR | TS30042-M050QFNRCT-ND | - | Semtech Corporation | QFN-16 | IC REG BUCK 5V 2A 16QFN | https://www.digikey.ca/product-detail/en/semtech-corporation/TS30042-M050QFNR/TS30042-M050QFNRCT-ND/6605537
U2 | 1 | TLV75733PDBVR | 296-50414-1-ND | - | Texas Instruments | SOT-23-5 | IC REG LINEAR 3.3V 1A SOT23-5 | https://www.digikey.ca/product-detail/en/texas-instruments/TLV75733PDBVR/296-50414-1-ND/9685553
U3 | 1 | AP7361C-33E-13 | AP7361C-33E-13DICT-ND | - | Diodes Incorporated | SOT-223 | IC REG LINEAR 3.3V 1A SOT223 | https://www.digikey.ca/product-detail/en/diodes-incorporated/AP7361C-33E-13/AP7361C-33E-13DICT-ND/5638331
U4 | 1 | AP2114H-3.3TRG1 | AP2114H-3.3TRG1DICT-ND | - | Diodes Incorporated | SOT-223 | IC REG LINEAR 3.3V 1A SOT223 | https://www.digikey.ca/product-detail/en/diodes-incorporated/AP2114H-3.3TRG1/AP2114H-3.3TRG1DICT-ND/4505142
U5 | 1 | TLV1117LV33DCYR | 296-28778-1-ND | - | Texas Instruments | SOT-223-4 | IC REG LINEAR 3.3V 1A SOT223-4 | https://www.digikey.ca/product-detail/en/texas-instruments/TLV1117LV33DCYR/296-28778-1-ND/2666520
U6 | 1 | REF3133AIDBZR | 296-41483-1-ND | - | Texas Instruments | SOT-23-3 | IC VREF SERIES 3.3V SOT23-3 | https://www.digikey.ca/product-detail/en/texas-instruments/REF3133AIDBZR/296-41483-1-ND/5222876
D1 | 1 | PMEG4030ER,115 | 1727-5313-1-ND | - | Nexperia USA Inc | SW-123W | DIODE SCHOTTKY 40V 3A SOD123W | https://www.digikey.ca/product-detail/en/nexperia-usa-inc/PMEG4030ER115/1727-5313-1-ND/2676789
L1 | 1 | 744774047 | 732-1266-1-ND | 4.7µH | Wurth Electronics Inc. | - | FIXED IND 4.7UH 3A 71 MOHM SMD | https://www.digikey.ca/product-detail/en/wurth-electronics-inc/744774047/732-1266-1-ND/1639327
L2* | 1 | BLM18PG121SN1D | 490-1037-1-ND | 120 Ohms @ 100MHz | Murata Electronics | L0603 | FERRITE BEAD 120 OHM 0603 1LN | https://www.digikey.ca/product-detail/en/murata-electronics-north-america/BLM18PG121SN1D/490-1037-1-ND/584485
L2* | 1 | MI0603L301R-10 | 240-2374-1-ND | 300 Ohms @ 100MHz | Laird-Signal Integrity | L0603 | FERRITE BEAD 300 OHM 0603 1LN | https://www.digikey.ca/product-detail/en/laird-signal-integrity-products/MI0603L301R-10/240-2374-1-ND/806734
L2* | 1 | MPZ1608Y101BTD25 | 445-172899-1-ND | 100 Ohms @ 100MHz | TDK Corporation | L0603 | FERRITE BEAD 100 OHM 0603 1LN | https://www.digikey.ca/product-detail/en/tdk-corporation/MPZ1608Y101BTD25/445-172899-1-ND/5040530
C1 | 1 | CL31A106MBHNNNE | 1276-6736-1-ND | 10uF | Samsung Electro-Mechanics | C1206 | CAP CER 10UF 50V X5R 1206 | https://www.digikey.com/product-detail/en/samsung-electro-mechanics/CL31A106MBHNNNE/1276-6736-1-ND/5961595
C2 | 1 | CL10B104KB8NNNC | 1276-1000-1-ND | 0.1uF | TDK Corporation | C0603 | CAP CER 0.1UF 50V X7R 0603 | https://www.digikey.ca/product-detail/en/samsung-electro-mechanics/CL10B104KB8NNNC/1276-1000-1-ND/3889086
C3 | 1 | C0402C223J4RAC7867 | 399-14435-1-ND | 0.022µF | KEMET | C0402 | CAP CER 0.022UF 16V X7R 0402 | https://www.digikey.ca/product-detail/en/kemet/C0402C223J4RAC7867/399-14435-1-ND/7103727
C4, C5, C8, C9, C14, C17 | 6 | C2012X5R1A226K125AB | 445-7664-1-ND | 22uF | TDK Corporation | C0805 | CAP CER 22UF 10V X5R 0805 | https://www.digikey.ca/product-detail/en/tdk-corporation/C2012X5R1A226K125AB/445-7664-1-ND/2733736
C6, C7, C10, C11, C12, C13, C15, C16 | 8 | LMK212AC6106MD-T | 587-6337-1-ND | 10uF | Taiyo Yuden | C0805 | CAP CER 10UF 10V X6S 0805 | https://www.digikey.ca/product-detail/en/taiyo-yuden/LMK212AC6106MD-T/587-6337-1-ND/9949923
C18, C19 | 2 | LMK212BJ105MD-T | 587-4918-1-ND | 1uF | Taiyo Yuden | C0805 | CAP CER 1UF 10V X5R 0805 | https://www.digikey.ca/product-detail/en/taiyo-yuden/LMK212BJ105MD-T/587-4918-1-ND/6563761
TP1, TP3, TP5, TP7, TP9, TP11, TP13 | 7 | 5000 | 36-5000-ND | - | Keystone Electronics | - | PC TEST POINT MINIATURE RED | https://www.digikey.ca/product-detail/en/keystone-electronics/5000/36-5000-ND/255326
TP2, TP4, TP6, TP8, TP10, TP12, TP14 | 7 | 5001 | 36-5001-ND | - | Keystone Electronics | - | PC TEST POINT MINIATURE BLACK | https://www.digikey.ca/product-detail/en/keystone-electronics/5001/36-5001-ND/255327

Sheet: ICs - Power
LSS Pro
Part | MF SKU | Digikey Link | Description | Operating Voltage (V) | Max Current Consumption
U1 | STM32F413VGT6 | https://www.digikey.ca/product-detail/en/stmicroelectronics/STM32F413VGT6/497-17009-ND/6564701 | IC MCU 32BIT 1MB FLASH 100LQFP | 3.3 | 200
U2 | AEAT-8800-Q24 | https://www.digikey.ca/product-detail/en/broadcom-limited/AEAT-8800-Q24/516-3787-ND/6681014 | ROTARY ENCODER MAGNETIC 4096PPR | 3.3 | 25
U3 | powerSTEP01 | https://www.digikey.ca/product-detail/en/stmicroelectronics/POWERSTEP01/497-15441-ND/5237153 | IC MTR DRV BIPLR 3.3/5V 89VFQFPN | 3.3 | 125
U4 | ICM-20600 | https://www.digikey.ca/product-detail/en/tdk-invensense/ICM-20600/1428-1147-1-ND/9602942 | LOW-POWER, HIGH-PERFORMANCE IMU | 3.3 | 2.79
IC1-IC2 | SN74LVC1G126DCKR | https://www.digikey.ca/product-detail/en/texas-instruments/SN74LVC1G126DCKR/296-11606-1-ND/385745 | IC BUF NON-INVERT 5.5V SC70-5 | 3.3 | 100
IC-3 | SN65HVD230DR | https://www.digikey.com/product-detail/en/texas-instruments/SN65HVD230DR/296-11654-1-ND/404366 | IC TXRX CAN 1MBPS 3.3V 8SOIC | 3.3 | 200
LED1-10 | LTST-E263CEGBK | https://www.digikey.ca/product-detail/en/lite-on-inc/LTST-E263CEGBK/160-2263-1-ND/9556408 | ADDRESSABLE LED DISCRETE SERIAL | 5 | 200
 |  |  |  |  | 852.79

Sheet: Components Example
CAN Connector | https://www.digikey.com/products/en?keywords=347920040
 | https://www.molex.com/molex/products/part-detail/pcb_headers/0347920040
 | https://www.lucidarme.me/can-bus-connector-normalization/
 | https://www.artekcable.com/products/M12-t-coding-4-pin-male-female-panel-mount-connector.html
 | http://en.yonggui-sc.com/product/250A80f/
