eSpark-Backup/colebenson-smartmotors/Documents/Dev-Shared-Files/Change_Log_v3b.xlsx

TOP PCB
Component Name | Part Number / Designator | Changed To | Notes
3.8V-3.3V Regulator | NCP708MU330TAG | TLV75733PDBVR | Change done due to stock shortage of the original part
30V-12V Regulator | LM43603PWPR | BD9876AEFJ-E2 | Change done due to very high cost of the original part.
Motor Driving MOSFETs | BSC072N08NS5ATMA1 | AO4882-MS | Change done due to huge difference in price and more compact part
Digital Signal Isolator | ISO7741QDBQQ1 | ISO7221ADR | Changed to 2 x smaller digital isolators of same specs due to very high cost and low stock of original part
SPI Isolator | MAX14850ASE+ | ISO6761FDWR | Changed due to no stock of the original part
USB C Connector | MC-318 | MC-318FB | Changed due to incorrect datasheet of original part that caused connection issues
BOTTOM PCB
Component Name | Part Number / Designator | Changed To | Notes
Encoder | AEAT-8800-Q24 | TLE5012BE1000 | Changed because of no stock of original part
Microcontroller | STM32F407VET6 | STM32F407VGT6 | Changed because of no stock / high price of original part
Motion Sensor | ICM-20649 | LSM6DSLTR | Changed because of no stock / high price of original part
CAN Transceiver | SN65HVDA1040BQDRQ1 | SN65HVDA1040AQDRQ1 | Changed because of no stock of original part
