eSpark-Backup/colebenson-smartmotors/Documents/Dev-Shared-Files/Part Selection Motor CB.xlsx

S.No | Item Name | Description | Manufacturer | Manufacturer Part No. | Supplier | Re Link - 1 | Ref Link - 2 | Value | Qty | Electron's Remarks | Cole's Remarks
1 | uController | IC MCU 32BIT 1MB FLASH 100LQFP Speed 100MHz RAM Size 320K x 8 | STMicroelectronics | STM32F413VGT6 | Digikey (https://www.digikey.sg/product-detail/en/stmicroelectronics/STM32F413VGT6/497-17009-ND/6564701) | Git Help |  | -- | -- | Was used in previous design, not currently being used as per Cole's remarks. We need Arduino Boot Loader Supported Controller.
2 |  | IC MCU 32BIT 1MB FLASH 100LQFP Speed 168MHz RAM Size 192K x 8 | STMicroelectronics | STM32F407VGT7TR | Digikey (https://www.digikey.sg/product-detail/en/stmicroelectronics/STM32F407VGT7TR/STM32F407VGT7TR-ND/5268288) |  |  | -- | -- | Recommend from my side but its price break is on 1,000 Pieces. Arduino Boot Loader Support available. | OK
3 |  | IC MCU 32BIT 1MB FLASH 64LQFP Speed 168MHz RAM Size 192K x 8 | STMicroelectronics | STM32F405RGT7TR | Digikey (https://www.digikey.com/en/products/detail/stmicroelectronics/STM32F405RGT7TR/5268283) | Adafruit (https://www.adafruit.com/product/4382) | WaveShare (https://www.waveshare.com/wiki/Open405R-C) | -- | -- | Recommend from Sir Cole Side and also mine, having price break on Digikey but costly on LCSC. Boot Support Available. Development Board Available.
4 | Stepper Driver | IC MOTOR DRIVER PAR 36POWERSO Voltage - Supply 8V ~ 52V Voltage - Load 8V ~ 52V | STMicroelectronics | L6207PD013TR | Digikey (https://www.digikey.com/en/products/detail/stmicroelectronics/L6207PD013TR/715913) | -- | -- | -- | -- | Very Powerfiul IC but due to current rating issue, I have to drop it out. Support available for Arduino - Rough Search
5 |  | BOOSTER PACK DRIVER | Texas Instruments | DRV8711 | Digikey (https://www.digikey.com/en/products/detail/texas-instruments/BOOST-DRV8711/4972135) | -- |  | -- | -- | Popular and Arduino Library avaialble. There is a current limitation issue i.e. 4A so wa can't use this.
6 |  | IC MTR DRVR BIPOLAR 0-5.5V 64QFN | Toshiba Semiconductor | TB67S128FTG | Digikey (https://www.digikey.com/en/products/detail/toshiba-semiconductor-and-storage/TB67S128FTG-OEL/9351608) | -- | -- | -- | -- | Popolar Stepper motor Driver, its current is 5A which is not our key requirement.
7 |  | IC MTR DRV BIPLR 3.3/5V 89VFQFPN Voltage - Supply 3.3V, 5V Voltage - Load 85V (Max) | STMicroelectronics | POWERSTEP01 | Digikey (https://www.digikey.com/en/products/detail/stmicroelectronics/POWERSTEP01/5237153) | Arduino (https://www.arduino.cc/reference/en/libraries/ponoor-powerstep01-library/) | Meguno Link (https://www.megunolink.com/exclusive/powerstep01-10a-stepper-driver/) | -- | -- | Awesome IC, high Current Less components Arduino Library Support is available. Costly but this is the best package we are getting as our motors needs 7+ Ampere. Development Board Available
8 |  | IC PHOTO FULL BRIDE DR 28SOIC Voltage - Supply 3V ~ 7V, 8V ~ 14V | Texas Instruments | SM72295 | Digikey (https://www.digikey.com/en/products/detail/texas-instruments/SM72295-NOPB/2623178) | TI Support (https://www.ti.com/tool/TIDA-01227?ds_k=DYNAMIC+SEARCH+ADS&DCM=yes&gclsrc=a) |  | -- | -- | Custom Design. A lot of components will be used. Need to use Power MOSFET for creating H-Bridge.
9 | Encoder | ROTARY ENCODER MAGNETIC PROG Voltage - Supply 3V ~ 3.6V, 4.5V ~ 5.5V | ams | AS5047D-ATST | Digikey (https://www.digikey.com/en/products/detail/ams/AS5047D-ATST/4896031) | -- | -- | -- | -- | Easily available. SOIC Package available. Less programming support. Costly.
10 |  | ROTARY ENCODER MAGNETIC 4096PPR | Broadcom Limited | AEAT-8800-Q24 | Digikey (https://www.digikey.com/en/products/detail/broadcom-limited/AEAT-8800-Q24/6681014) | DigiKey Link (https://www.digikey.com/en/products/detail/mikroelektronika/MIKROE-3130/9644672) | Arduino (https://forum.arduino.cc/index.php?topic=321433.0) | -- | -- | Easily available - Not on LCSC. Evaluation Board Available, also attaching MikroE link for reference. Arduino Library Support.
11 |  | ROTARY ENCODER MAGNETIC | ams | AS5215OM-HMFP | Digikey (https://www.digikey.com/en/products/detail/ams/AS5215OM-HMFP/2333811) | -- | -- | -- | -- | Taking so much time to arrange the parts.
12 |  | ROTARY ENCODER MAGNETIC | ams | AS5134-ZSSM | Digikey (https://www.digikey.at/product-detail/en/ams/AS5134-ZSSM/AS5134-ZSSMCT-ND/7793474) | -- | -- | -- | -- | Alternate of AS5047D-ATST
13 | Motion Tracking | MEMS GYROSCOPE 3AXIS 16QFN | TDK InvenSense | ITG-3701 | Digikey (https://www.digikey.com/en/products/detail/tdk-invensense/ITG-3701/5015523) | -- | -- | -- | -- | Can't use this, it was given as alternative in Sir Cole's Doc. ITG-3701 is EOL (End of Life) and we will be unable to receive support and part.
14 |  | MOTION SENSOR | TDK InvenSense | ICM-42688-P | Digikey (https://www.digikey.com/en/products/detail/tdk-invensense/IAM-20680/8544624) | -- | -- | -- | -- | Awesome Motion Tracking - IC for our Robotic and IoT application, and also to monitor normal operation. Low cost as compare to Automotive one.
15 |  | AUTOMOTIVE QUALIFIED 6-AXIS INTE | TDK InvenSense | IAM-20680 | Digikey (https://www.digikey.com/en/products/detail/tdk-invensense/IAM-20680/8544624) | -- | -- | -- | -- | Dedicated Motion Tracking IC for Automotive Application but costly. This one is expensive and I am not gonna recommend for our motors but it will save battery Juice.
16 |  |  |  | IIM-46230 |  | -- | -- | -- | -- | Ready made module, should be considered for bigger Robots
17 |  | LOW-POWER, HIGH-PERFORMANCE INTE | TDK InvenSense | ICM-20600 | Digikey (https://www.digikey.com/en/products/detail/tdk-invensense/ICM-20600/8544628) | -- | -- | -- | -- | Nice and simple. Do our needful. Low cost. Available on LCSC.
18 | IC || Power | 40V 2A SOP-8_150mail DC-DC Converters RoHS | XLSEMI | XL1509-5.0E1 | Lcsc (https://lcsc.com/product-detail/DC-DC-Converters_XLSEMI-XL1509-5-0E1_C61063.html) | -- | -- | -- | -- | First Stage will be Switching Regulator to drop down/ step down the voltage safely. Low Cost and Reliable, less parts. Also able to bear 40V.
19 |  | IC REG LINEAR 1.8V 200MA 4XDFN | ON Semiconductor | NCP707BMX180TCG | Digikey (https://www.digikey.com.au/product-detail/en/rochester-electronics-llc/NCP707BMX180TCG/2156-NCP707BMX180TCG-OS-ND/13441377) | -- | -- | -- | -- | As per requirement.
20 |  | IC REG LINEAR 3.3V 1A 6UDFN | ON Semiconductor | NCP708MU330TAG | Digikey (https://www.digikey.com/en/products/detail/on-semiconductor/NCP708MU330TAG/5404559) | -- | -- | -- | -- | 500mA output 3.3V Regulator, power will be calculated later and finalized as per need.
21 |  | IC REG LINEAR 3.3V 500MA 6DFN | STMicroelectronics | LD39050PU33R | Digikey (https://www.digikey.com/en/products/detail/stmicroelectronics/LD39050PU33R/2039876) | -- | -- | -- | -- | 1000mA output 3.3V Regulator, power will be calculated later and finalized as per need.
22 |  | IC REG LINEAR 5V 250MA 4XDFN | ON Semiconductor | NCP163AMX500TBG | Digikey (https://www.digikey.com/en/products/detail/on-semiconductor/NCP163AMX500TBG/6684806) | -- | -- | -- | -- | As per requirement.
23 |  | TBD | TBD | TBD | TBD | TBD | TBD | TBD | TBD | Smart Power Switch, was discussed on call with Sir Cole. Need final answer.
24 | IC || Sensor | SENSOR PRESSURE HUMIDITY TEMP | Bosch Sensortec | BME280 | Digikey (https://www.digikey.com/en/products/detail/bosch-sensortec/BME280/6136306) | -- | -- | -- | -- | For Monitoring PCB Temp and other parameters. | Why pressure and humidity? Should have two thermisters
25 | CAN Controllers | HIGH-SPEED CAN TRANSCEIVER WITH | NXP USA Inc. | TJA1441 | Digikey (https://www.digikey.bg/product-detail/en/nxp-usa-inc/TJA1441AT-0Z/568-TJA1441AT-0ZCT-ND/13691205) | -- | -- | -- | -- | CAN Transceiver IC, it has been decided that we go for uController but I am adding here for team review. | All info online indicates a separate CAN transceiver is needed
26 |  | IC TRANSCEIVER 1/1 8SOIC | Texas Instruments | SN65HVDA1040B-Q1 | Digikey (https://www.digikey.gr/product-detail/en/texas-instruments/SN65HVDA1040BQDRQ1/296-SN65HVDA1040BQDRQ1CT-ND/10715793) | -- | -- | -- | --
27 | Resistor | TBD | TBD | TBD | TBD | TBD | TBD | TBD | TBD | TBD
28 | Capacitor | TBD | TBD | TBD | TBD | TBD | TBD | TBD | TBD
29 | Inductor | TBD | TBD | TBD | TBD | TBD | TBD | TBD | TBD
30 | Ferrite Bead (Inductor) | TBD | TBD | TBD | TBD | TBD | TBD | TBD | TBD
31 | Transistor | TBD | TBD | TBD | TBD | TBD | TBD | TBD | TBD
32 | LED (Diode) | RGB LED | Gumstix | WS2812B-2020 | Mouser (https://eu.mouser.com/ProductDetail/Gumstix/PKG900000000994) | -- | -- | -- | -- | For Multipurpose Indication. | Gumstix is not an LED Mfr.
33 |  | Single Color LED | TBD | TBD | TBD | TBD | TBD | TBD | TBD | For power Display
34 | Button / Switch | TBD | TBD | TBD | TBD | TBD | TBD | TBD | 1 | Generic Switch for Multipurpose.
35 |  | TBD | TBD | TBD | TBD | TBD | TBD | TBD | 2 | It has to be decided whether we go for shorting Jumper or sliding switch for Boot Loading.
36 | Connector | XT30-Male | SparkFun Electronics | PRT-10474 | Digikey (https://www.digikey.in/product-detail/en/sparkfun-electronics/PRT-10474/1568-1816-ND/8258064) | -- | -- | -- | -- | For Power Input, Able to deliver 25A
37 |  | RJ45-Female | On Shore Technology Inc. | PJ012-8P8C1 | Digikey (https://www.digikey.com/en/products/detail/on-shore-technology-inc/PJ012-8P8C1/6566534) | -- | -- | -- | -- | We still have both options, can gor for JST, RJ45 or RJ11 for CAN Transmission. As per my understanding RJ45/RJ11 will be best. | RJ45
38 |  | JST- Male | JST Sales America Inc. | B6B-PH-K-S(LF)(SN) | Digikey (https://www.digikey.com/en/products/detail/jst-sales-america-inc/B6B-PH-K-S-LF-SN/926615) | -- | -- | -- | --
39 |  | USB C - Female | GCT | USB4151-GF-C | Digikey (https://www.digikey.com/en/products/detail/gct/USB4151-GF-C/12139043) | -- | -- | -- | 1 | For Programming Main controller using Arduino IDE.
40 | Motor | -- | -- | JK42HS34-1334TK-01A | -- | -- | -- | -- | -- | Already Decided by Core Team
41 |  | -- | -- | JK57HS51-4204 | -- | -- | -- | -- | --
42 |  | -- | -- | JK86HS100-7004 | -- | -- | -- | -- | --
