eSpark-Backup/colebenson-smartmotors/Documents/Client-Shared-Files/Sharing-13042021/LYN Pro - Electrical - 3D Parts-20210412T133957Z-001/LYN Pro - Electrical - 3D Parts/SKQGA.jpg

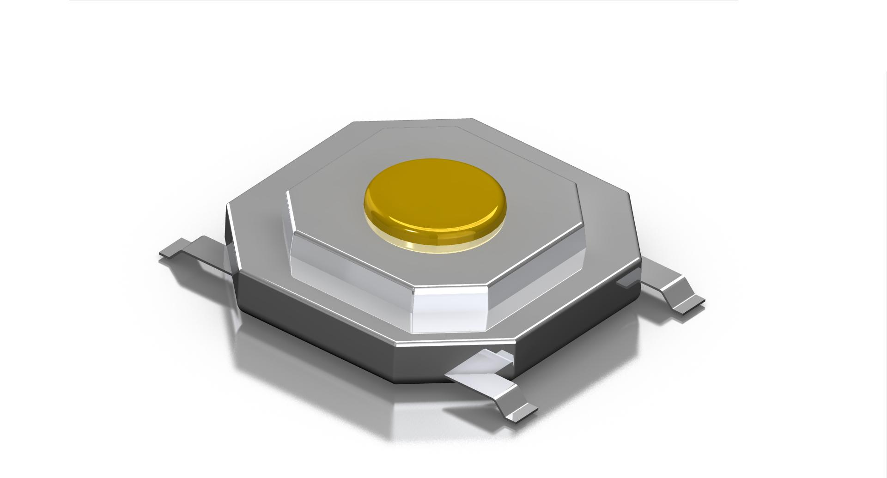
Documents/Client-Shared-Files/Sharing-13042021/LYN Pro - Electrical - 3D Parts-20210412T133957Z-001/LYN Pro - Electrical - 3D Parts/SKQGA.jpg
