eSpark-Backup/colebenson-smartmotors/Deliverables/SM_Bottom Board/_Suppoting Files/SM_Bottom_PCB.DXF

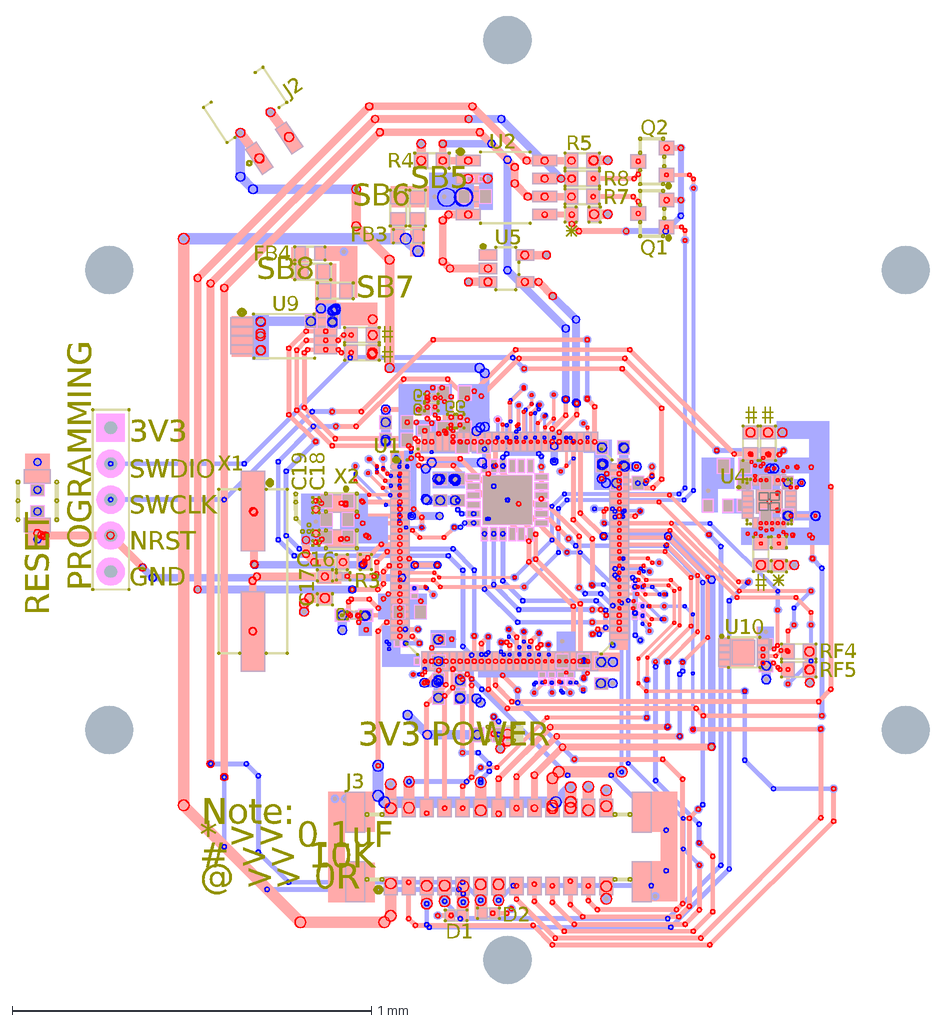
[picture p35: CAD file, 2022-04-01]
Deliverables/SM_Bottom Board/_Suppoting Files/SM_Bottom_PCB.DXF
@ >> 0R
NRST
SWCLK
* >> 0.1uF
# >> 10K
GND
PROGRAMMING
3V3
3V3 POWER
SWDIO
RESET
Note:
X2
X1
SB8
SB7
SB6
SB5
J3
FB4
FB3
J2
RF5
RF4
R7
R8
Q2
Q1
D2
D1
U10
U5
U2
U9
U4
U1
R5
R4
R3
C19
C18
C17
C16
