eSpark-Backup/colebenson-smartmotors/Deliverables/SM_Top Board/_Renderings/SM_Top_PCB.DXF

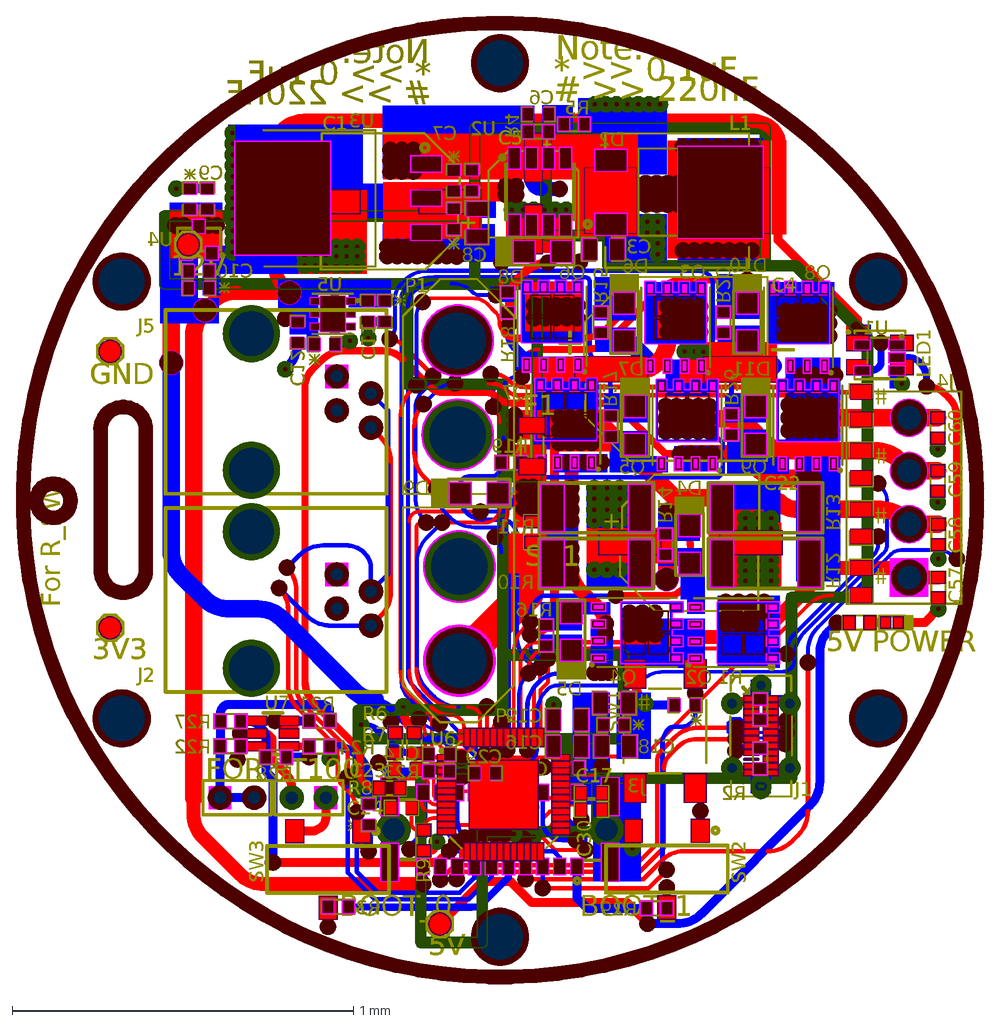
[picture p36: CAD file, 2022-04-07]
Deliverables/SM_Top Board/_Renderings/SM_Top_PCB.DXF
BOOT_0
5V
12V
3V3
FOR PT100
5V POWER
GND
# >> 220nF
* >> 0.1uF
For R_SW
BOOT_1
Note:
Q8
SW1
U5
J3
P2
R7
R6
C23
J4
C22
C1
U7
LED1
C5
C4
C3
C20
SW2
SW3
J5
J2
J1
L1
R29
U6
U4
U3
U2
U1
SB1
R28
R27
R26
R24
R23
R22
R21
R20
R19
R18
R17
R16
R15
R14
R13
R12
R11
R10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
