eSpark-Backup/colebenson-smartmotors/Deliverables/SM_Top Board/_Supporting Files/SM_Top_PCB.step

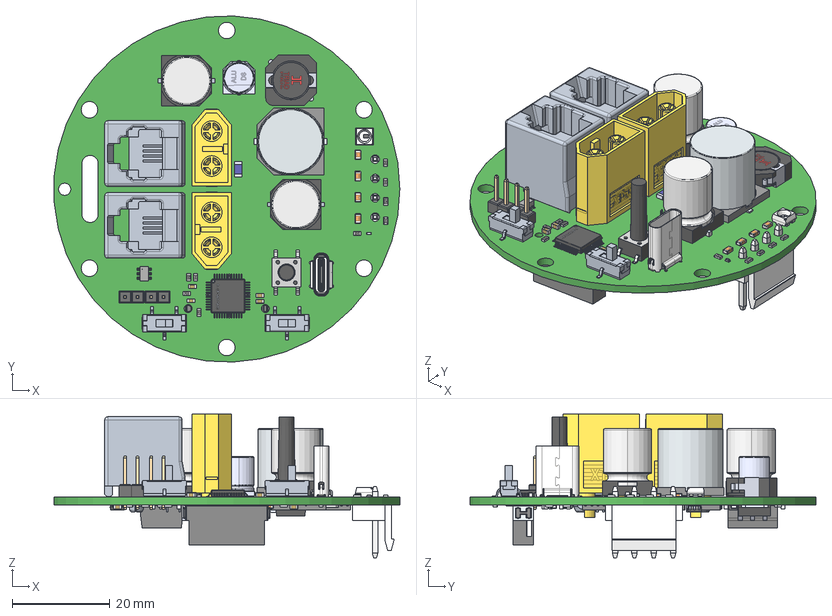
[picture p37: CAD file, 2021-07-02]
Deliverables/SM_Top Board/_Supporting Files/SM_Top_PCB.step
70.9 x 70.9 x 29.5 mm
Board
BODY-SON x 8
FRAME-DQH0008A x 8
switch
M55-70120_MOULD
M55-701_CONTACT x 20
M55-700_STRAP x 2
User_Library-XT60_male x 2
User_Library-RESC1608X05N x 29
User_Library-CAPC1608X09 x 22
PinVH x 4
B4P-body_white
vkme1451j221mv x 2
21-0058I_MXM
SMD_WS2812B_Mini
User_Library-CEL63D66S85H
Base
Pin1Fillet
Pin2Fillet
User_Library-0805_SMD_Capacitor x 10
User_Library-LED-0402
User_Library-Header1x2_Header1_1 x 4
c-5520425-2-c-3d x 2
Triad_Magnetics-AX104R-100
User_Library-P-LQFP48-7x7-0_50
CircuitWorks-SOT-23
NOPB
SOP-8L_DIO
SN74LV1T34DBVR
CircuitWorks-RESISTOR_2512 x 4
0685H9150-01
User_Library-SOD123W x 8
User_Library-TO252AA
