eSpark-Backup/colebenson-smartmotors/Design-Files-v3.4/LSS_Sub_Board_v1.1/Supporting Files/LSS-P-PCB-S v1.1.step

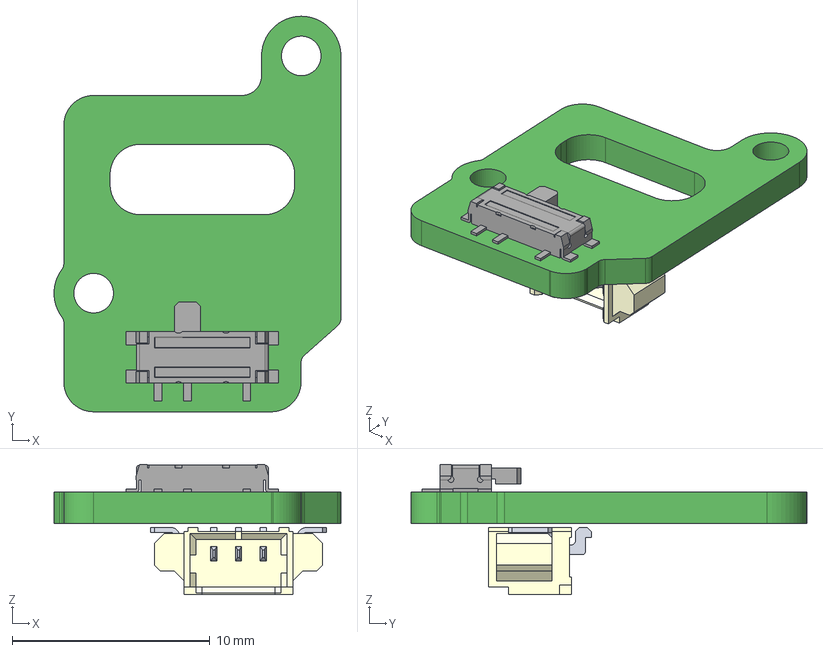
[picture p38: CAD file, 2024-06-21]
Design-Files-v3.4/LSS_Sub_Board_v1.1/Supporting Files/LSS-P-PCB-S v1.1.step
14.5 x 20.0 x 6.60 mm
asd
