eSpark-Backup/colebenson-smartmotors/Design-Files-v3.4/LSS_Top_Board_v3.4/Supporting Files/LSS-P-PCB-T v3.4.DXF

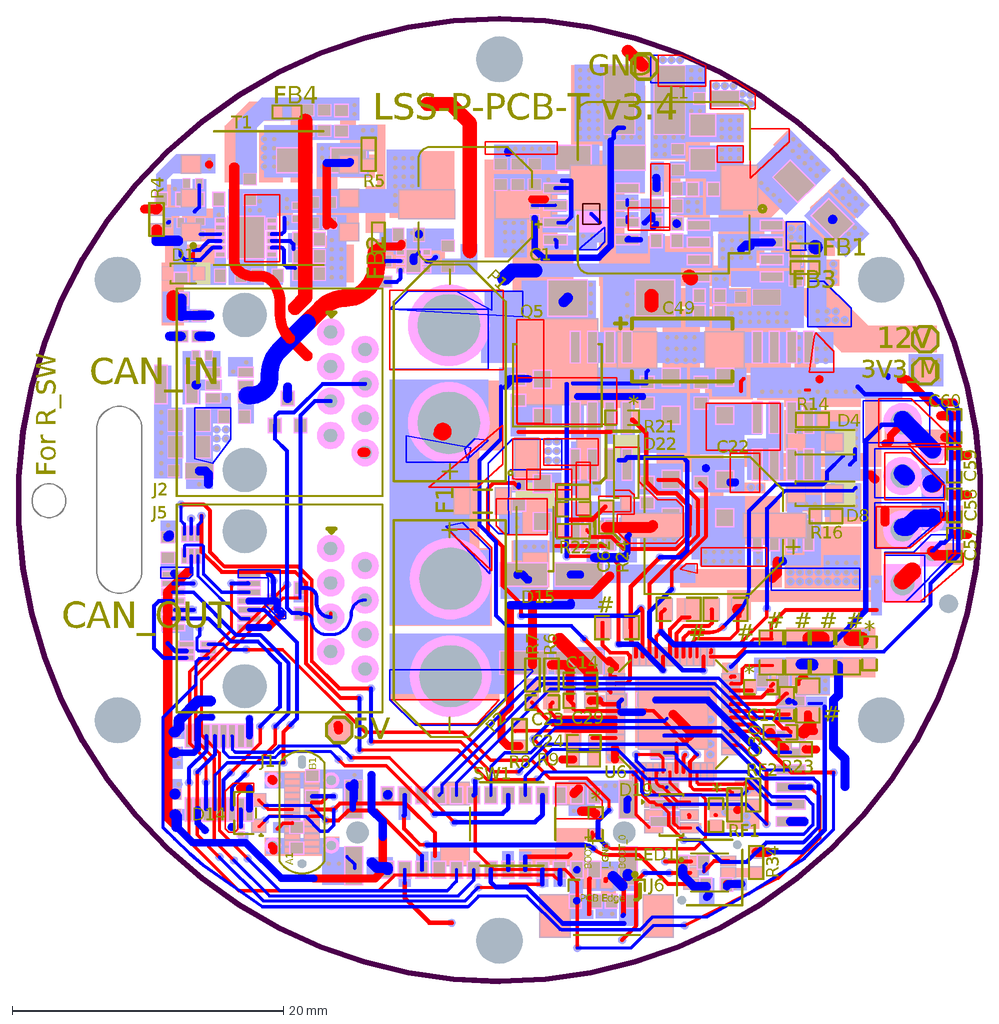
[picture p39: CAD file, 2024-06-21]
Design-Files-v3.4/LSS_Top_Board_v3.4/Supporting Files/LSS-P-PCB-T v3.4.DXF
For R_SW
I_GND
3V3_M
CAN_IN
5V
BOOT_1
GND
12V
CAN_OUT
BOOT_0
*
LSS-P-PCB-T v3.4
#
Q5
R21
R22
C62
D22
R24
D19
D15
D14
C49
PCB Edge
J6
D4
C1
LED1
SW1
R9
R34
R16
R14
J5
J2
A1
B1
J1
D8
F1
RF1
R6
R7
C14
C17
C22
C23
C24
C29
C30
C57
C58
C59
C60
D1
FB1
FB2
FB3
FB4
L1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
