eSpark-Backup/colebenson-smartmotors/Documents/Client-Shared-Files/PCB-Dimensions.dxf

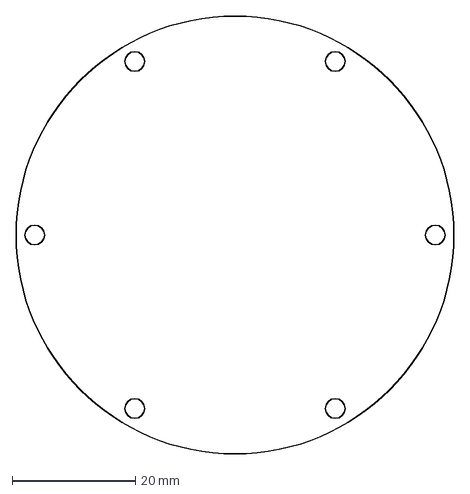
[picture p40: CAD file, 2021-07-02]
Documents/Client-Shared-Files/PCB-Dimensions.dxf
71.0 x 71.0 mm
