eSpark-Backup/colebenson-smartmotors/Documents/Client-Shared-Files/Sharing-04042021/Small-frame-v1.stp

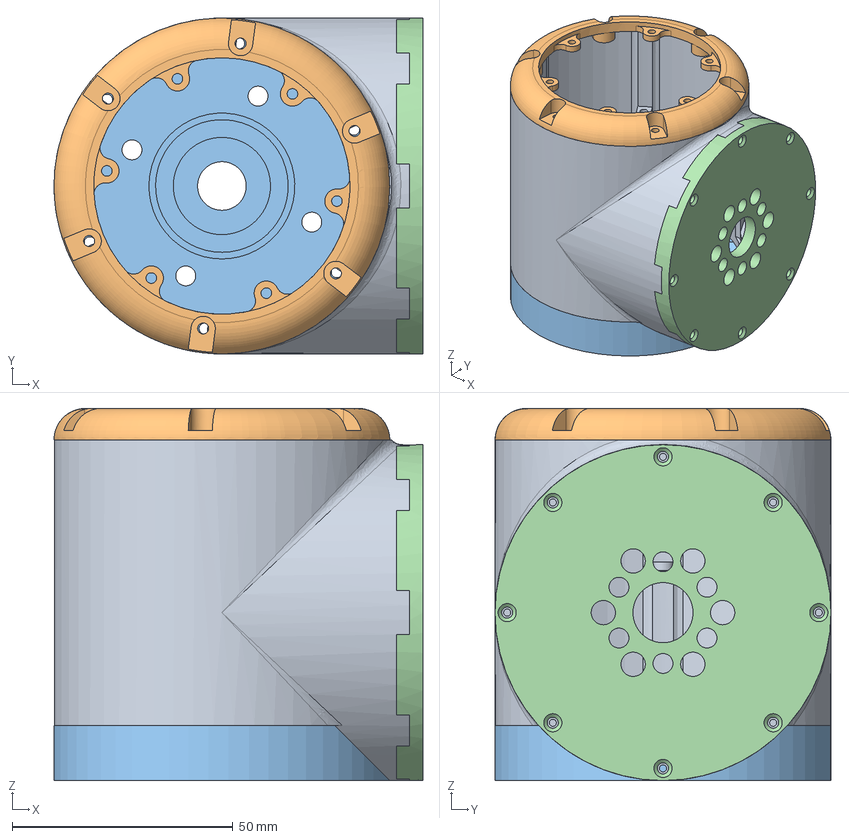
[picture p41: CAD file, 2021-07-02]
Documents/Client-Shared-Files/Sharing-04042021/Small-frame-v1.stp
83.5 x 76.0 x 84.2 mm
