eSpark-Backup/colebenson-smartmotors/Documents/Client-Shared-Files/Sharing-13042021/JK57HS51-4204TK.stp

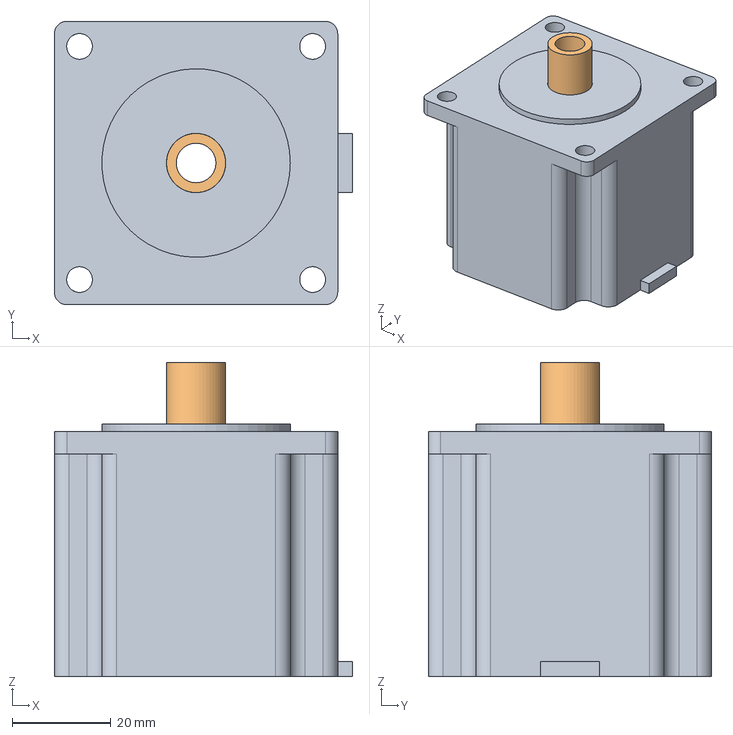
[picture p42: CAD file, 2021-07-02]
Documents/Client-Shared-Files/Sharing-13042021/JK57HS51-4204TK.stp
60.3 x 57.3 x 63.5 mm
