eSpark-Backup/colebenson-smartmotors/Documents/Client-Shared-Files/Sharing-04042021/Medium-frame-v1.stp

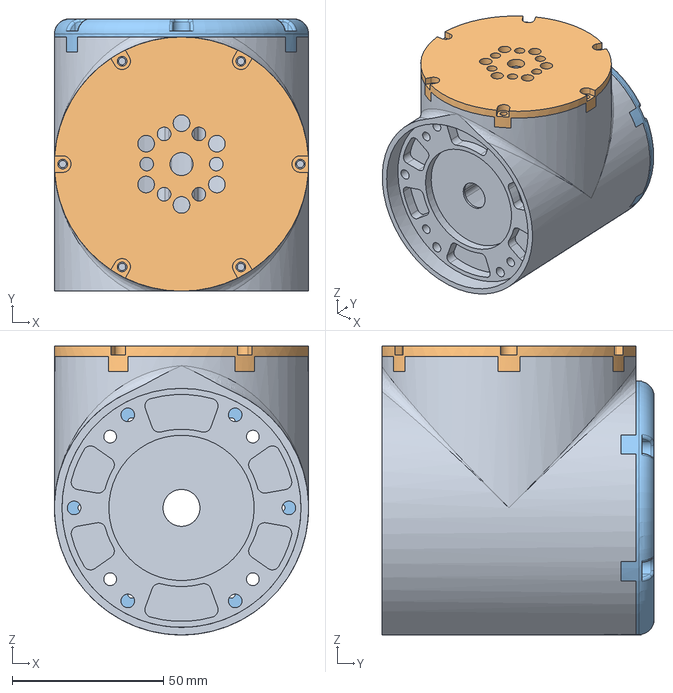
[picture p43: CAD file, 2021-07-02]
Documents/Client-Shared-Files/Sharing-04042021/Medium-frame-v1.stp
84.0 x 90.0 x 95.5 mm
