eSpark-Backup/colebenson-smartmotors/Documents/Client-Shared-Files/Sharing-13042021/JK86HS97-XXXX.stp

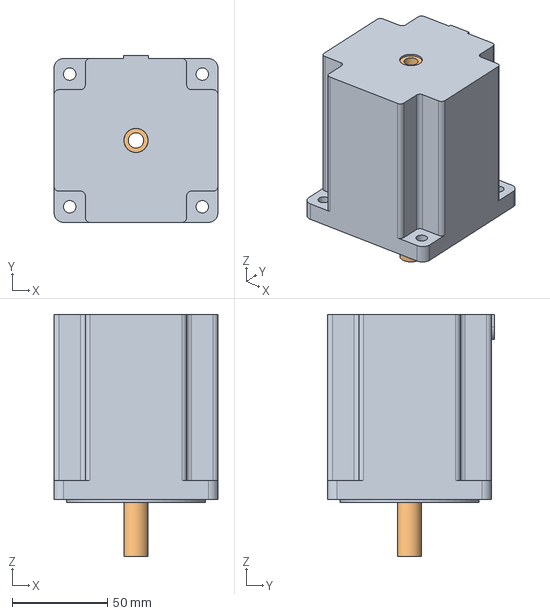
[picture p44: CAD file, 2021-07-02]
Documents/Client-Shared-Files/Sharing-13042021/JK86HS97-XXXX.stp
86.0 x 87.5 x 127.0 mm
