eSpark-Backup/colebenson-smartmotors/Documents/Client-Shared-Files/Sharing-13042021/LYN Pro - Electrical - 3D Parts-20210412T133957Z-001/LYN Pro - Electrical - 3D Parts/RESC0603 v2.step

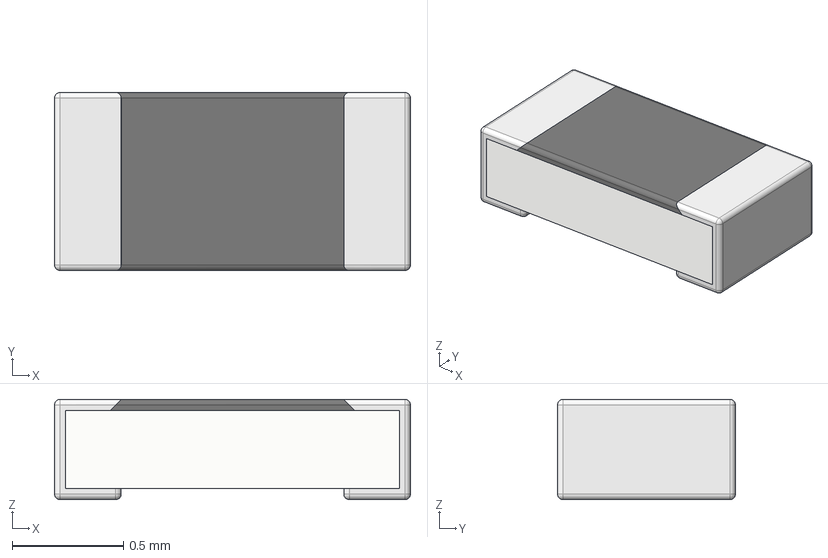
[picture p45: CAD file, 2021-07-02]
Documents/Client-Shared-Files/Sharing-13042021/LYN Pro - Electrical - 3D Parts-20210412T133957Z-001/LYN Pro - Electrical - 3D Parts/RESC0603 v2.step
1.60 x 0.8 x 0.45 mm
