eSpark-Backup/colebenson-smartmotors/Documents/Client-Shared-Files/Sharing-04042021/large-frame-v1.stp

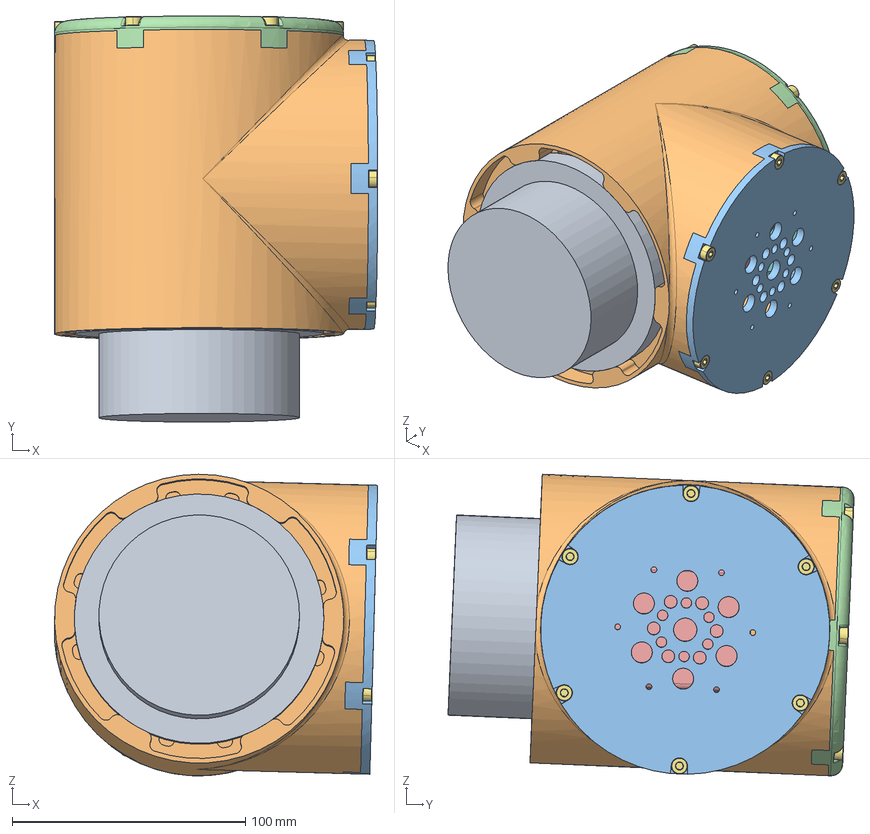
[picture p46: CAD file, 2021-07-02]
Documents/Client-Shared-Files/Sharing-04042021/large-frame-v1.stp
138.7 x 174.1 x 129.3 mm
