eSpark-Backup/colebenson-smartmotors/Documents/Client-Shared-Files/Sharing-13042021/JK42HS34-1334TK.stp

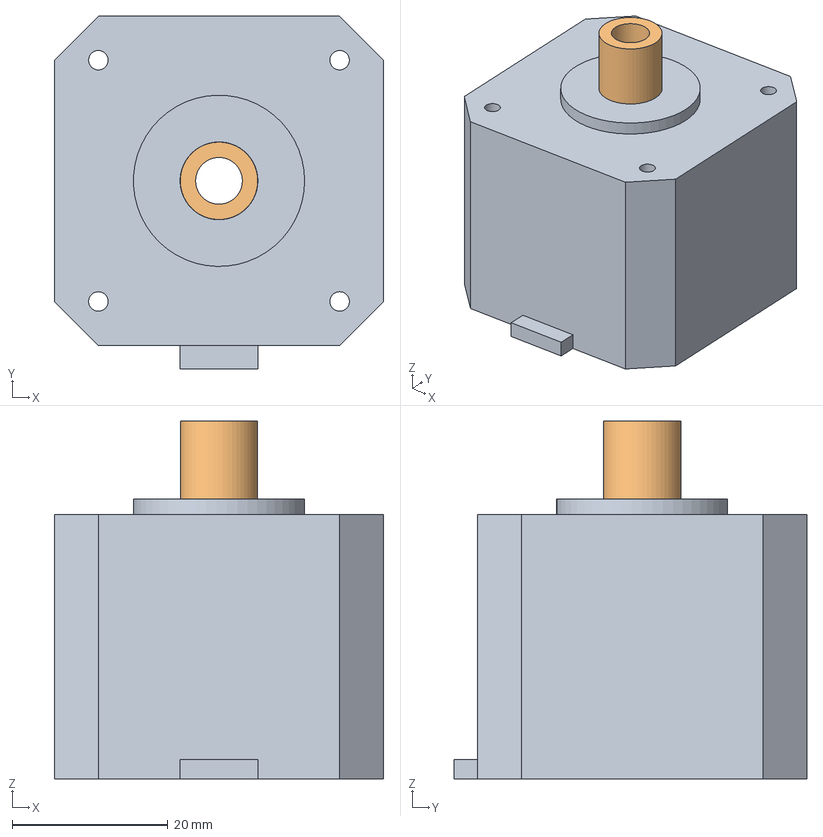
[picture p47: CAD file, 2021-07-02]
Documents/Client-Shared-Files/Sharing-13042021/JK42HS34-1334TK.stp
42.3 x 45.3 x 46.0 mm
