eSpark-Backup/colebenson-smartmotors/Documents/Client-Shared-Files/Sharing-13042021/LYN Pro - Electrical - 3D Parts-20210412T133957Z-001/LYN Pro - Electrical - 3D Parts/User Library-SOT23-3.step

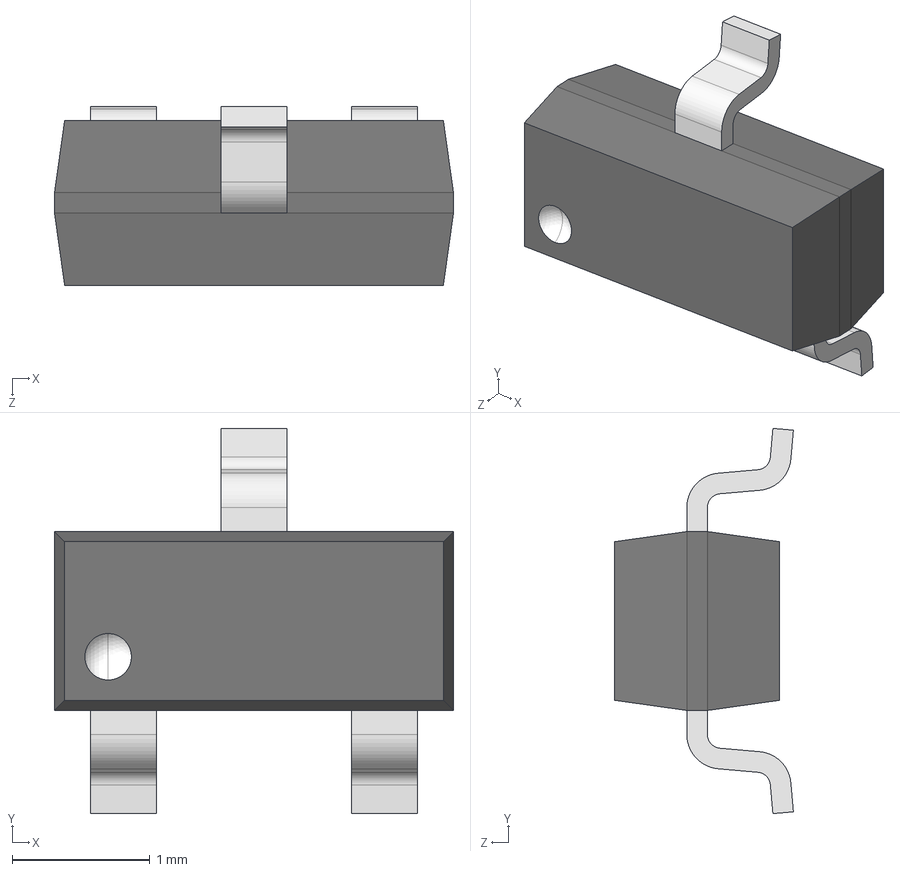
[picture p48: CAD file, 2021-07-02]
Documents/Client-Shared-Files/Sharing-13042021/LYN Pro - Electrical - 3D Parts-20210412T133957Z-001/LYN Pro - Electrical - 3D Parts/User Library-SOT23-3.step
2.90 x 2.80 x 1.30 mm
