eSpark-Backup/colebenson-smartmotors/Documents/Client-Shared-Files/Sharing-13042021/LYN Pro - Electrical - 3D Parts-20210412T133957Z-001/LYN Pro - Electrical - 3D Parts/skqga.stp

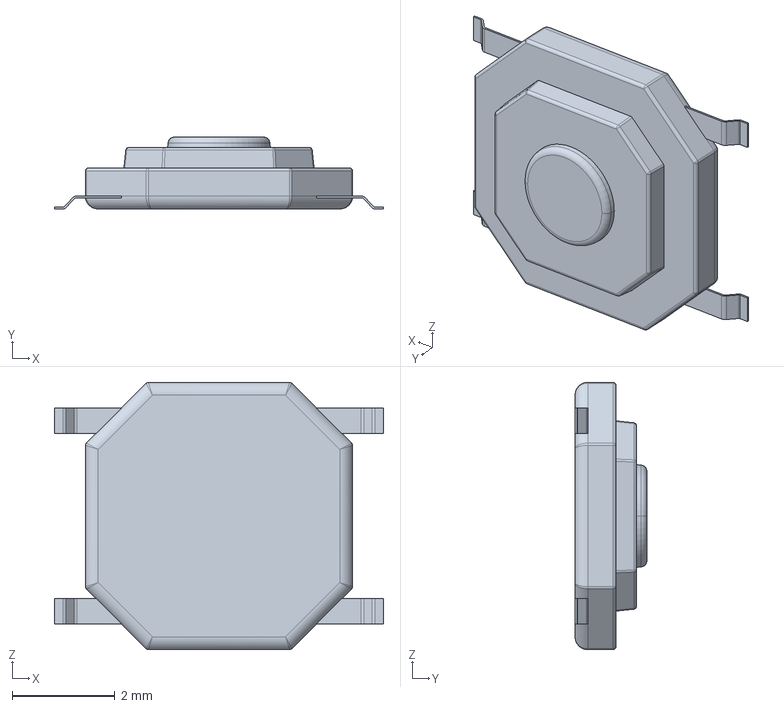
[picture p49: CAD file, 2021-07-02]
Documents/Client-Shared-Files/Sharing-13042021/LYN Pro - Electrical - 3D Parts-20210412T133957Z-001/LYN Pro - Electrical - 3D Parts/skqga.stp
6.40 x 1.40 x 5.20 mm
