eSpark-Backup/colebenson-smartmotors/Documents/Client-Shared-Files/Sharing-13042021/LYN Pro - Electrical - 3D Parts-20210412T133957Z-001/LYN Pro - Electrical - 3D Parts/Tactal Switch - SMD (12mmx12mmx6.0mm).stp

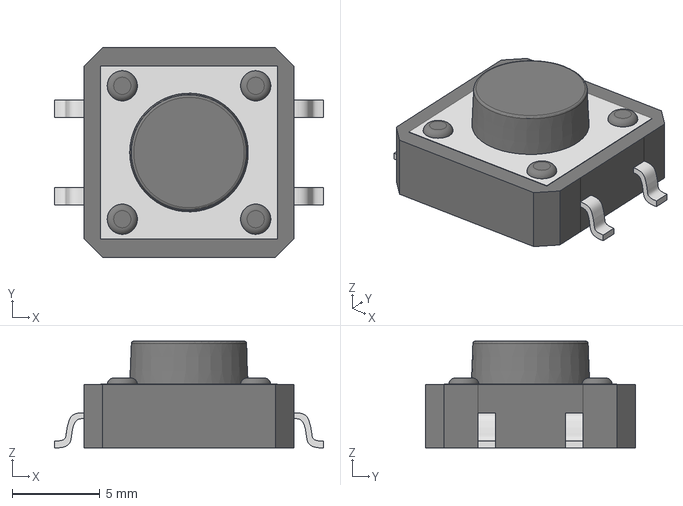
[picture p60: CAD file, 2021-07-02]
Documents/Client-Shared-Files/Sharing-13042021/LYN Pro - Electrical - 3D Parts-20210412T133957Z-001/LYN Pro - Electrical - 3D Parts/Tactal Switch - SMD (12mmx12mmx6.0mm).stp
15.4 x 12.0 x 6.10 mm
