eSpark-Backup/colebenson-smartmotors/Documents/Client-Shared-Files/Sharing-13042021/LYN Pro - Electrical - 3D Parts-20210412T133957Z-001/LYN Pro - Electrical - 3D Parts/User Library-POWERSTEP01.STEP

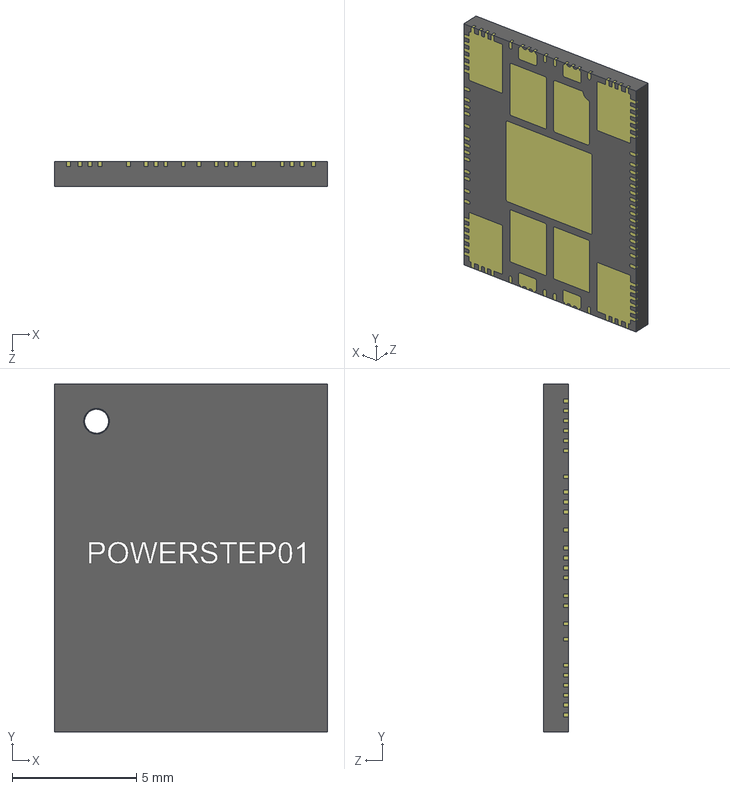
[picture p65: CAD file, 2021-07-02]
Documents/Client-Shared-Files/Sharing-13042021/LYN Pro - Electrical - 3D Parts-20210412T133957Z-001/LYN Pro - Electrical - 3D Parts/User Library-POWERSTEP01.STEP
11.0 x 14.0 x 1.00 mm
User Library-POWERSTEP01_Part_47178
User Library-POWERSTEP01_Part_47177
User Library-POWERSTEP01_Part_47176
User Library-POWERSTEP01_Part_47175
User Library-POWERSTEP01_Part_47174
User Library-POWERSTEP01_Part_47173
User Library-POWERSTEP01_Part_47172
User Library-POWERSTEP01_Part_47171
User Library-POWERSTEP01_Part_47170
User Library-POWERSTEP01_Part_47169
User Library-POWERSTEP01_Part_47168
User Library-POWERSTEP01_Part_47167
User Library-POWERSTEP01_Part_47166
User Library-POWERSTEP01_Part_47165
User Library-POWERSTEP01_Part_43539
User Library-POWERSTEP01_Part_43634
User Library-POWERSTEP01_Part_43728
User Library-POWERSTEP01_Part_43822
User Library-POWERSTEP01_Part_43916
User Library-POWERSTEP01_Part_44010
User Library-POWERSTEP01_Part_44104
User Library-POWERSTEP01_Part_44198
User Library-POWERSTEP01_Part_44292
User Library-POWERSTEP01_Part_44386
User Library-POWERSTEP01_Part_44480
User Library-POWERSTEP01_Part_44574
User Library-POWERSTEP01_Part_44668
User Library-POWERSTEP01_Part_44762
User Library-POWERSTEP01_Part_47164
User Library-POWERSTEP01_Part_44999
User Library-POWERSTEP01_Part_45094
User Library-POWERSTEP01_Part_45188
User Library-POWERSTEP01_Part_45282
User Library-POWERSTEP01_Part_45376
User Library-POWERSTEP01_Part_45470
User Library-POWERSTEP01_Part_45564
User Library-POWERSTEP01_Part_45658
User Library-POWERSTEP01_Part_45752
User Library-POWERSTEP01_Part_45846
User Library-POWERSTEP01_Part_45940
User Library-POWERSTEP01_Part_46128
User Library-POWERSTEP01_Part_47163
User Library-POWERSTEP01_Part_47162
User Library-POWERSTEP01_Part_47161
User Library-POWERSTEP01_Part_47160
User Library-POWERSTEP01_Part_47159
User Library-POWERSTEP01_Part_47158
User Library-POWERSTEP01_Part_47157
User Library-POWERSTEP01_Part_47156
User Library-POWERSTEP01_Part_167346
User Library-POWERSTEP01_Part_196605
