eSpark-Backup/colebenson-smartmotors/Documents/Client-Shared-Files/Sharing-13042021/LYN Pro - Electrical - 3D Parts-20210412T133957Z-001/LYN Pro - Electrical - 3D Parts/User Library-LQFP100-3.STEP

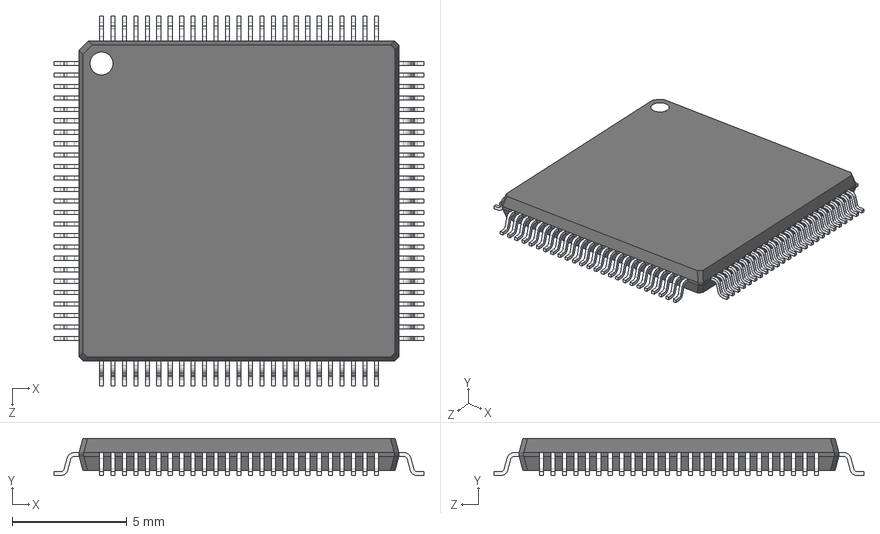
[picture p79: CAD file, 2021-07-02]
Documents/Client-Shared-Files/Sharing-13042021/LYN Pro - Electrical - 3D Parts-20210412T133957Z-001/LYN Pro - Electrical - 3D Parts/User Library-LQFP100-3.STEP
16.1 x 1.63 x 16.1 mm
User Library-LQFP100-3_case
User Library-LQFP100-3_pin x 100
User Library-LQFP100-3_circle
