eSpark-Backup/colebenson-smartmotors/(list of files, cad)

Other CAD files:
Deliverables/SM_Bottom Board/_Renderings/SM_Bottom_PCB.DWG
Documents/Client-Shared-Files/Sharing-13042021/LYN Pro - Electrical - 3D Parts-20210412T133957Z-001/LYN Pro - Electrical - 3D Parts/Keystone - 5001.FCStd
Documents/Client-Shared-Files/Sharing-13042021/LYN Pro - Electrical - 3D Parts-20210412T133957Z-001/LYN Pro - Electrical - 3D Parts/Keystone - 5000 (Red).step
Deliverables/SM_Top Board/_Supporting Files/SM_Top_PCB.DWG
Deliverables/SM_Top Board/_Supporting Files/SM_Top_PCB.DXF
Design-Files-v3.4/LSS_Sub_Board_v1.1/Supporting Files/LSS-P-PCB-S v1.1.DWG
Design-Files-v3.4/LSS_Sub_Board_v1.1/Supporting Files/LSS-P-PCB-S v1.1.DXF
Design-Files/LSS_Bottom_Board_v3.4/Supporting Files/LSS-P-PCB-B v3.4.step
Design-Files/LSS_Top_Board_v3.4/Supporting Files/LSS-P-PCB-T v3.4.DWG
Documents/Client-Shared-Files/PCB-dimensions.dwg
Documents/Client-Shared-Files/Sharing-13042021/LYN Pro - Electrical - 3D Parts-20210412T133957Z-001/LYN Pro - Electrical - 3D Parts/532611071.stp
Documents/Client-Shared-Files/Sharing-13042021/LYN Pro - Electrical - 3D Parts-20210412T133957Z-001/LYN Pro - Electrical - 3D Parts/533980371.stp
Documents/Client-Shared-Files/Sharing-13042021/LYN Pro - Electrical - 3D Parts-20210412T133957Z-001/LYN Pro - Electrical - 3D Parts/651005136421 (rev1).stp
Documents/Client-Shared-Files/Sharing-13042021/LYN Pro - Electrical - 3D Parts-20210412T133957Z-001/LYN Pro - Electrical - 3D Parts/M50-3530342.STEP
Documents/Client-Shared-Files/Sharing-13042021/LYN Pro - Electrical - 3D Parts-20210412T133957Z-001/LYN Pro - Electrical - 3D Parts/pogo_pin_P75-B1.x_t
