eSpark-Backup/colebenson-smartmotors/Documents/Client-Shared-Files/Fabrication Query/RB-Lci-17----EQ.xls

Sheet: 问客表
Engineer Questions
客户名称: | RB-Lci-17 |  | 制作人:
客户编号: |  |  | 工厂编号: | 1701A00963A0
 |  |  | 批准:
客户传真: |  |  | 日期:
项目 | Questions | Picture | Our suggestion |  | Answer
1 | As shown in Figure 1, the four holes at the arrow. There are no pads on the top line, but have copper on the bottom line. | FIG1 | A:Make TPH for these 4 holes, and add a pad with a single side 4MIL smaller than the hole in the top layer B :pls give the reasonable suggestion. |  | We don't need PTH for these 4 holes as these holes only provide mounting support for USB connector and 20-Pin Header. So don't add pad on top layer.
2 | Please check and confirm the working file . | FIG2
3 |  | FIG3
4 |  | FIG4
5 |  | FIG5
6 |  | FIG6
7 |  | FIG7
8 |  | FIG8
9 |  | FIG9
CUSTOMER SIGNATURE: DATE:

Sheet: Fig5
TOP层线路
inner1层
inner2层
BOT层线路
BOT层阻焊
