eSpark-Backup/colebenson-smartmotors/Documents/Dev-Shared-Files/Test Codes Information.xlsx

S.No | Test Conducted | Test Code Name | Description
1 | Power Testing of all Voltage Rails | Nil | Nil
2 | LED Testing | Nil | Basic GPIO Toggle Sketch
3 | UART over USB | Nil | Tested in all provided test codes for serial debugging
4 | EEPROM Communication Testing | CAT24C32HU4I-GT3_EEPROM.ino | EEPROM Read and Write Test
5 | Encoder Testing | AEAT-8800_magnetic_encoder.ino | Encoder data read and serial print
6 | Motion Sensor Testing | ICM20649_accel__gyro_and_temp.ino | Motion sensor data read and serial print
7 | Temperature Sensor Testing | MCP9805_Temperature_sensor_test.ino | Temperature read and serial print
8 | Stepper Drive Ramp Mode Testing | TMC5160-Ramp_Mode.ino | Stepper motor running in ramp mode using SPI
9 | Stepper Drive Step/Dir Mode Testing | TMC5160-Step_Dir.ino | Stepper motor running in step/dir mode
10 | CAN Bus Testing | STM32_CAN_Transceiver | CAN Bus basic data read/write using CAN to SPI External module as transceiver
