eSpark-Backup/colebenson-smartmotors/Deliverables/SM_Bottom Board/_Schematics/SM_Bottom_Board.pdf

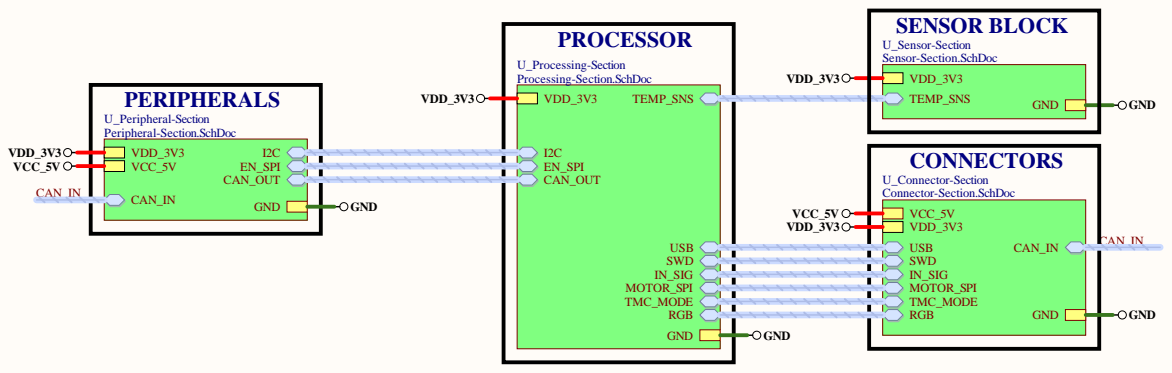
[picture p104: page 1]

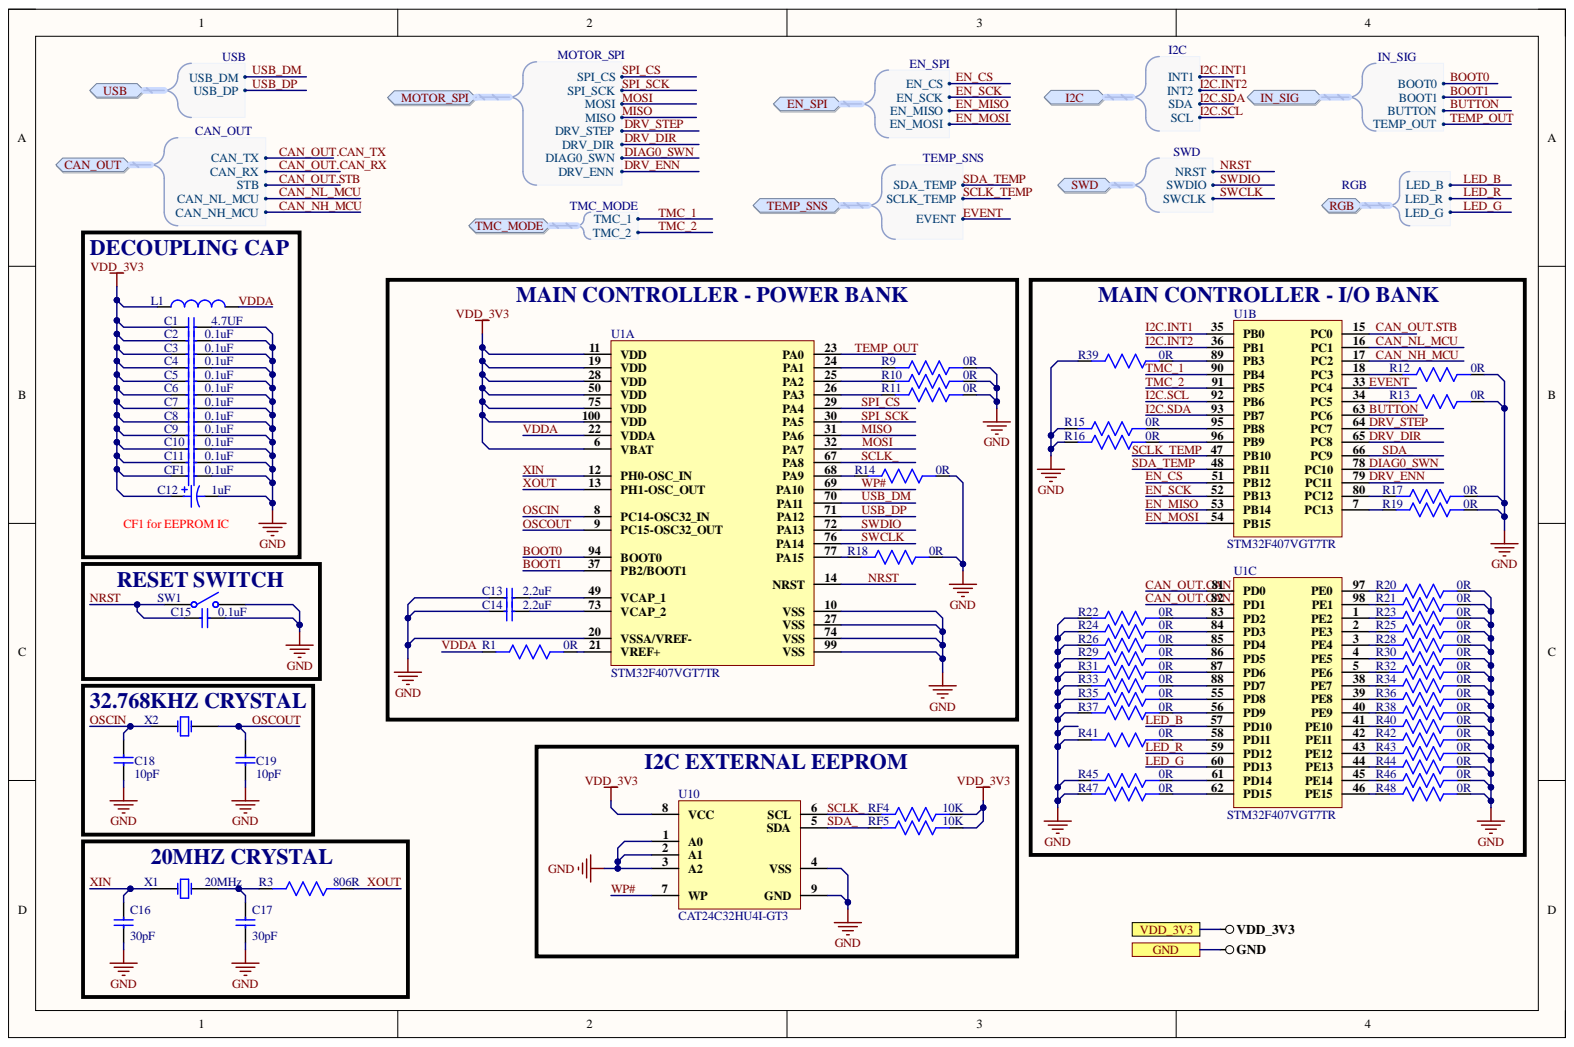
[picture p105: page 2]

USB USB USB_DP MOTOR_SPI TMC_MODE | I2C MOTOR_SPI IN_SIG EN_SPI EN_CS SPI_SCK EN_SCK INT2 IN_SIG BOOT1 MOSI EN_SCK I2C BOOT1 MOSI EN_SPI EN_MISO SDA BUTTON TMC_1 EVENT TMC_2

DECOUPLING CAP VDD_3V3 | L1 VDDA

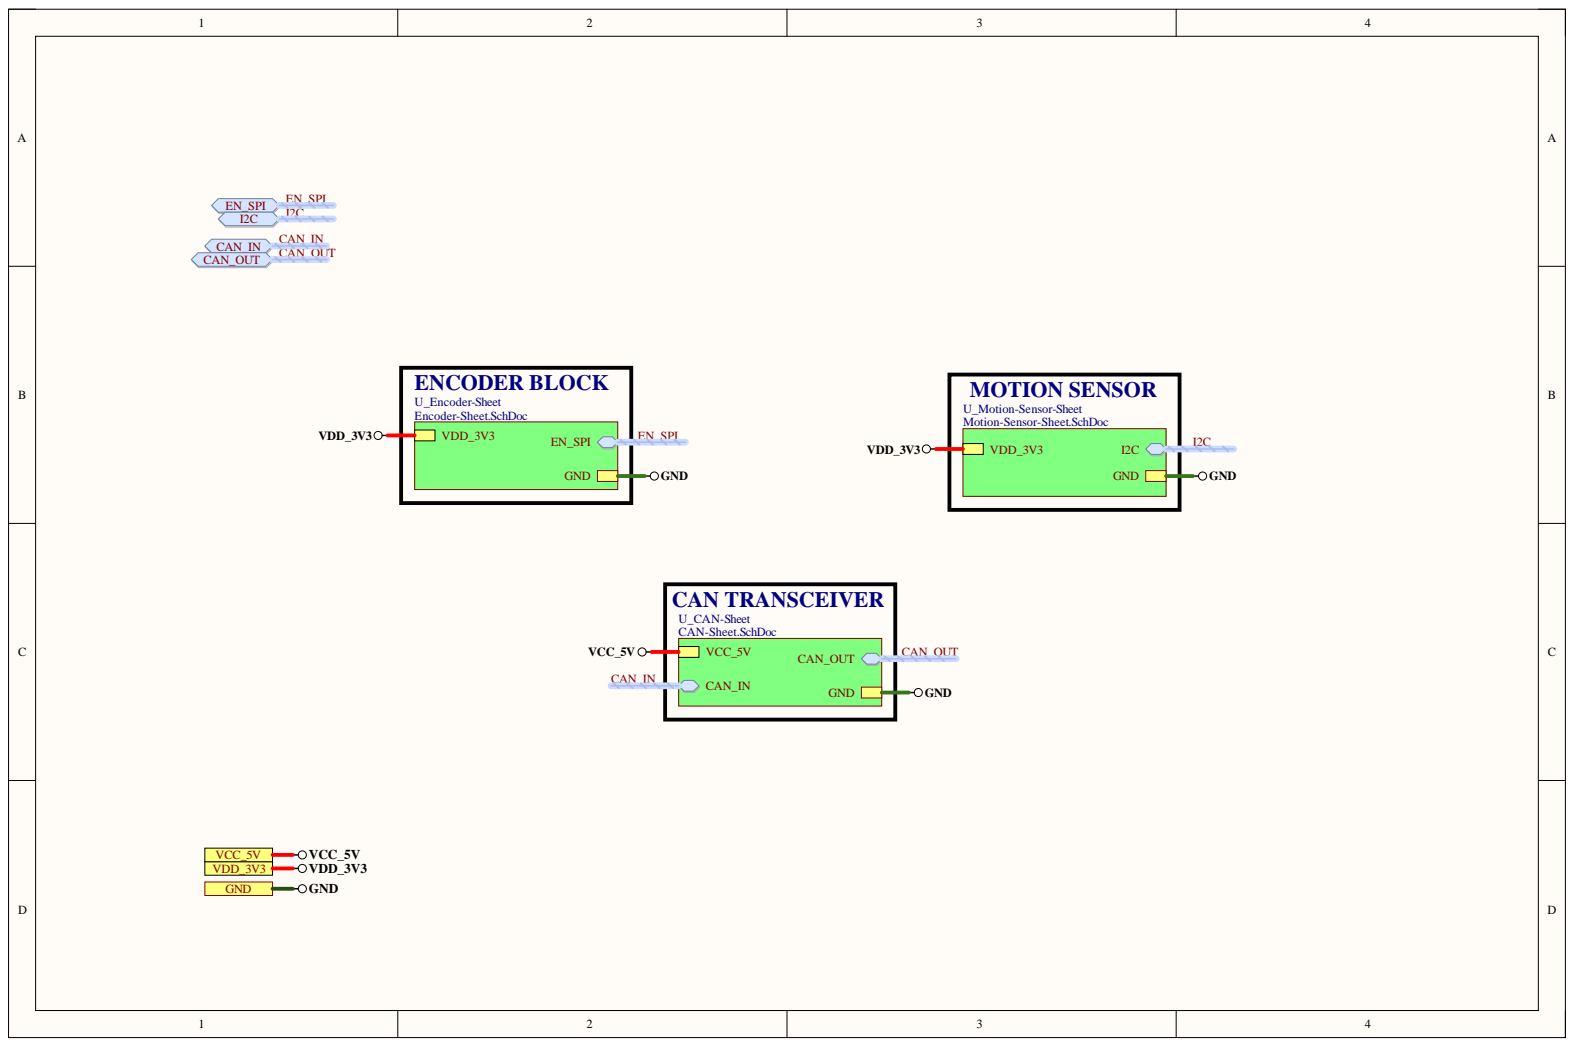
[picture p106: page 3]

U_Motion-Sensor-Sheet
Motion-Sensor-Sheet.SchDoc

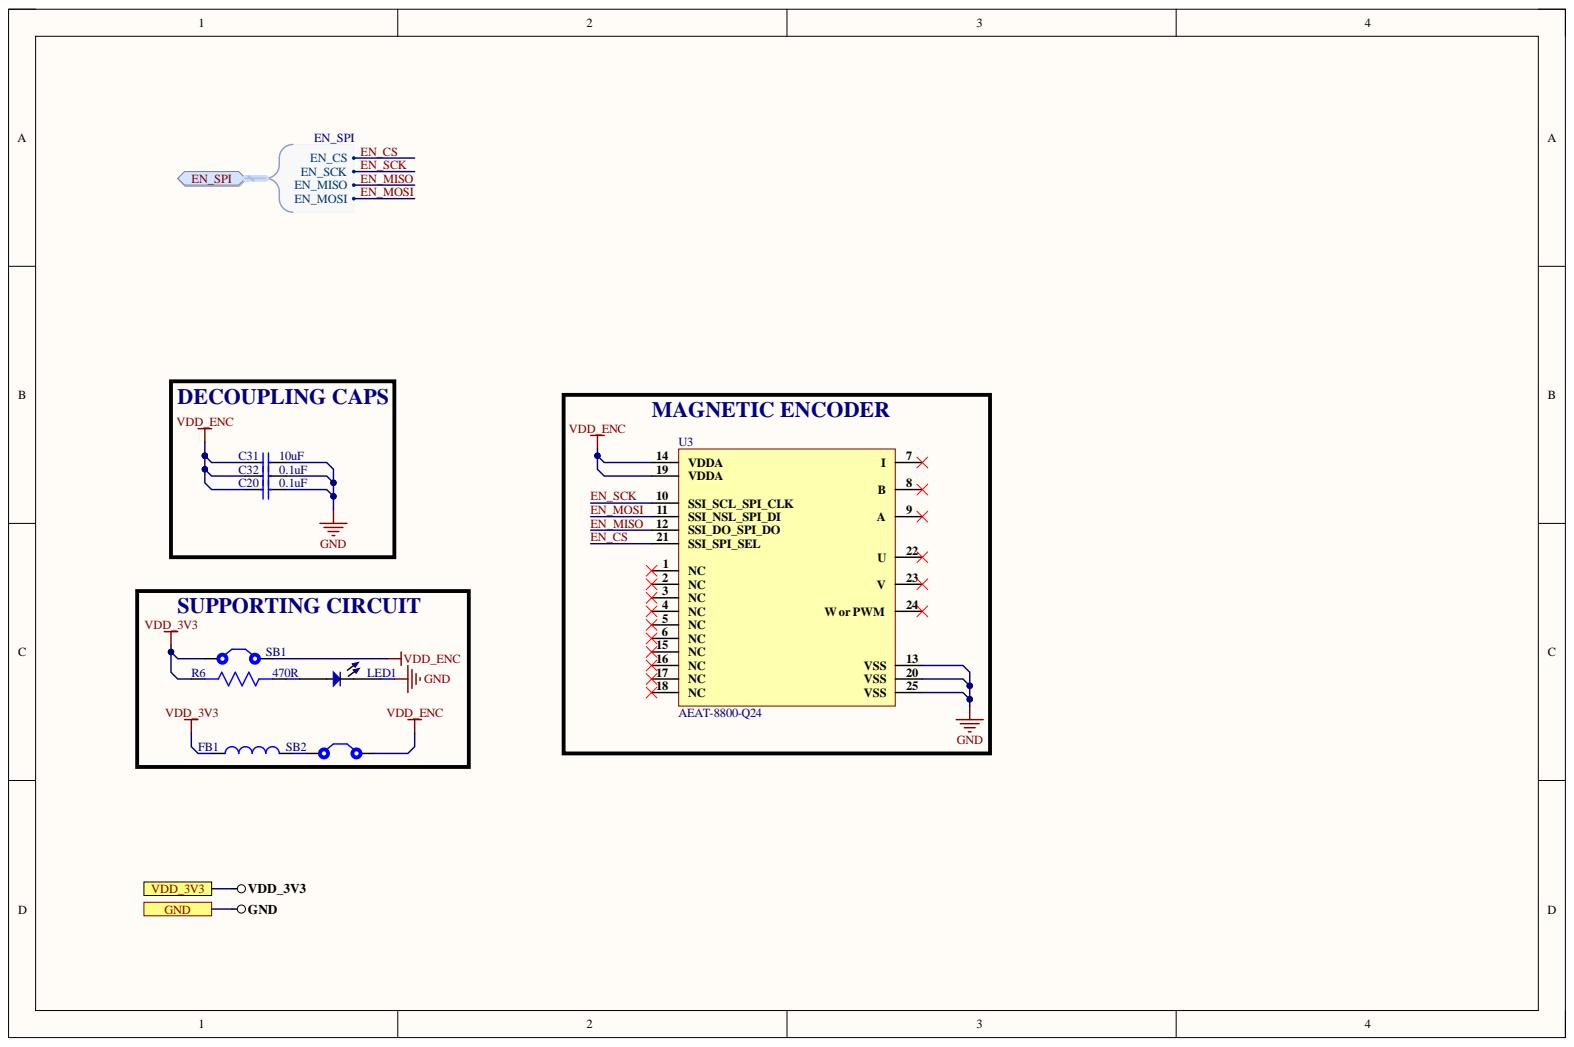
[picture p107: page 4]

MAGNETIC ENCODER DECOUPLING CAPS

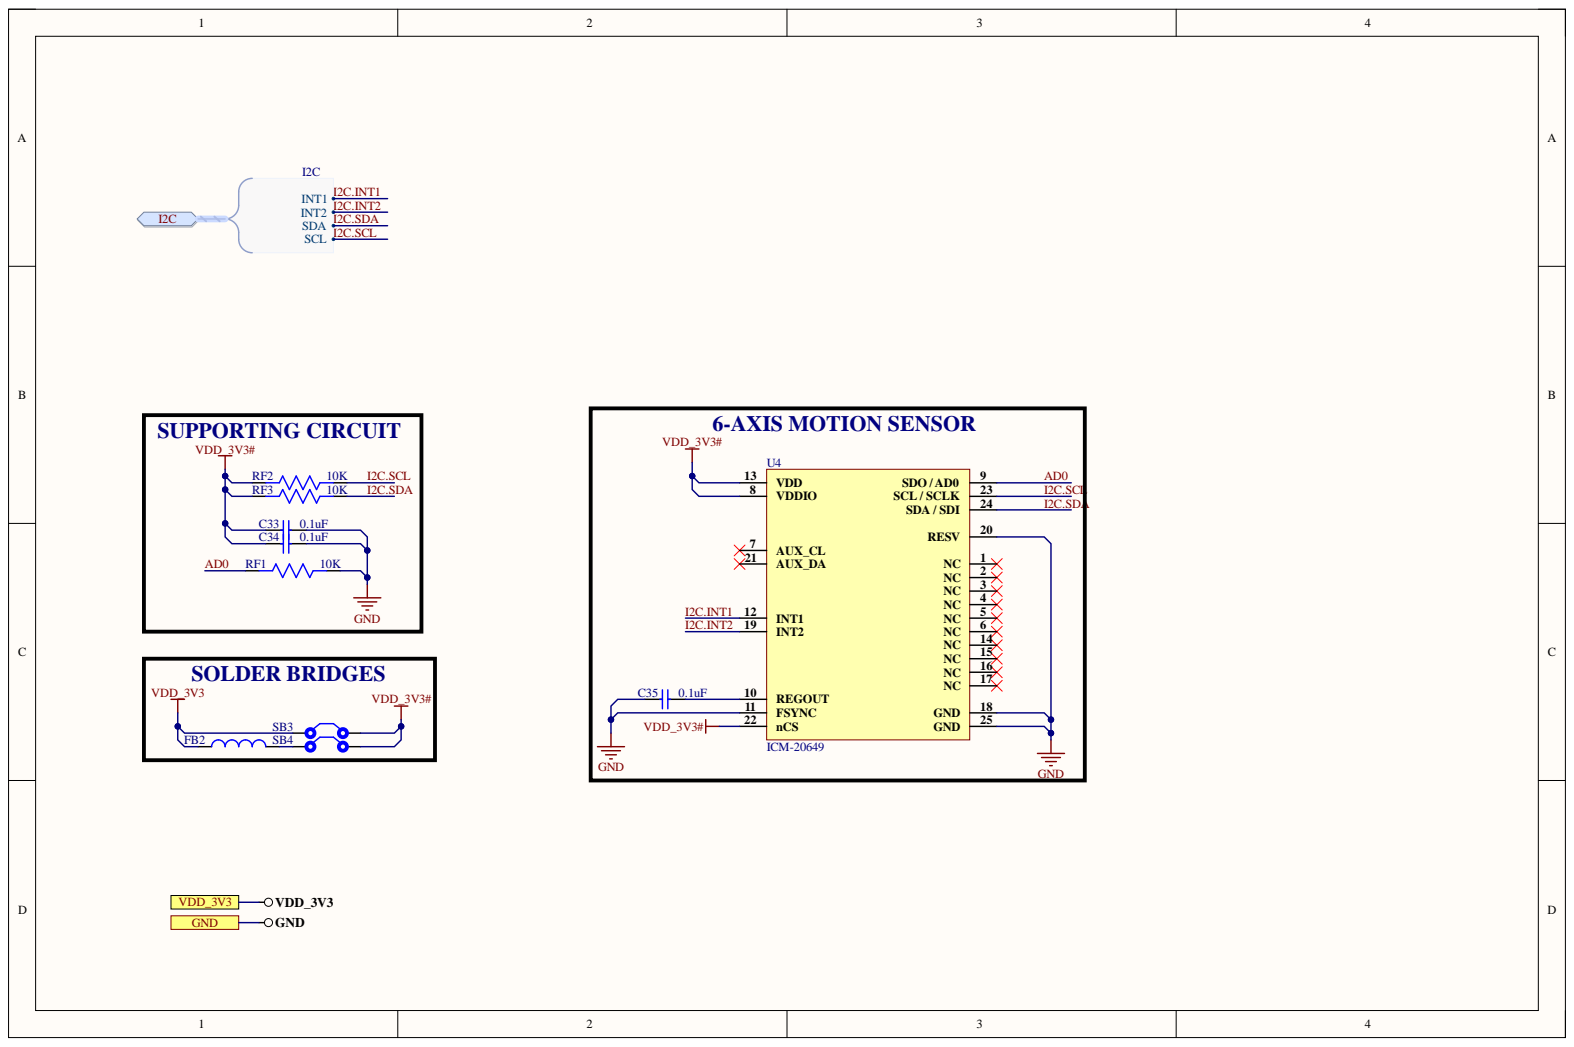
[picture p108: page 5]

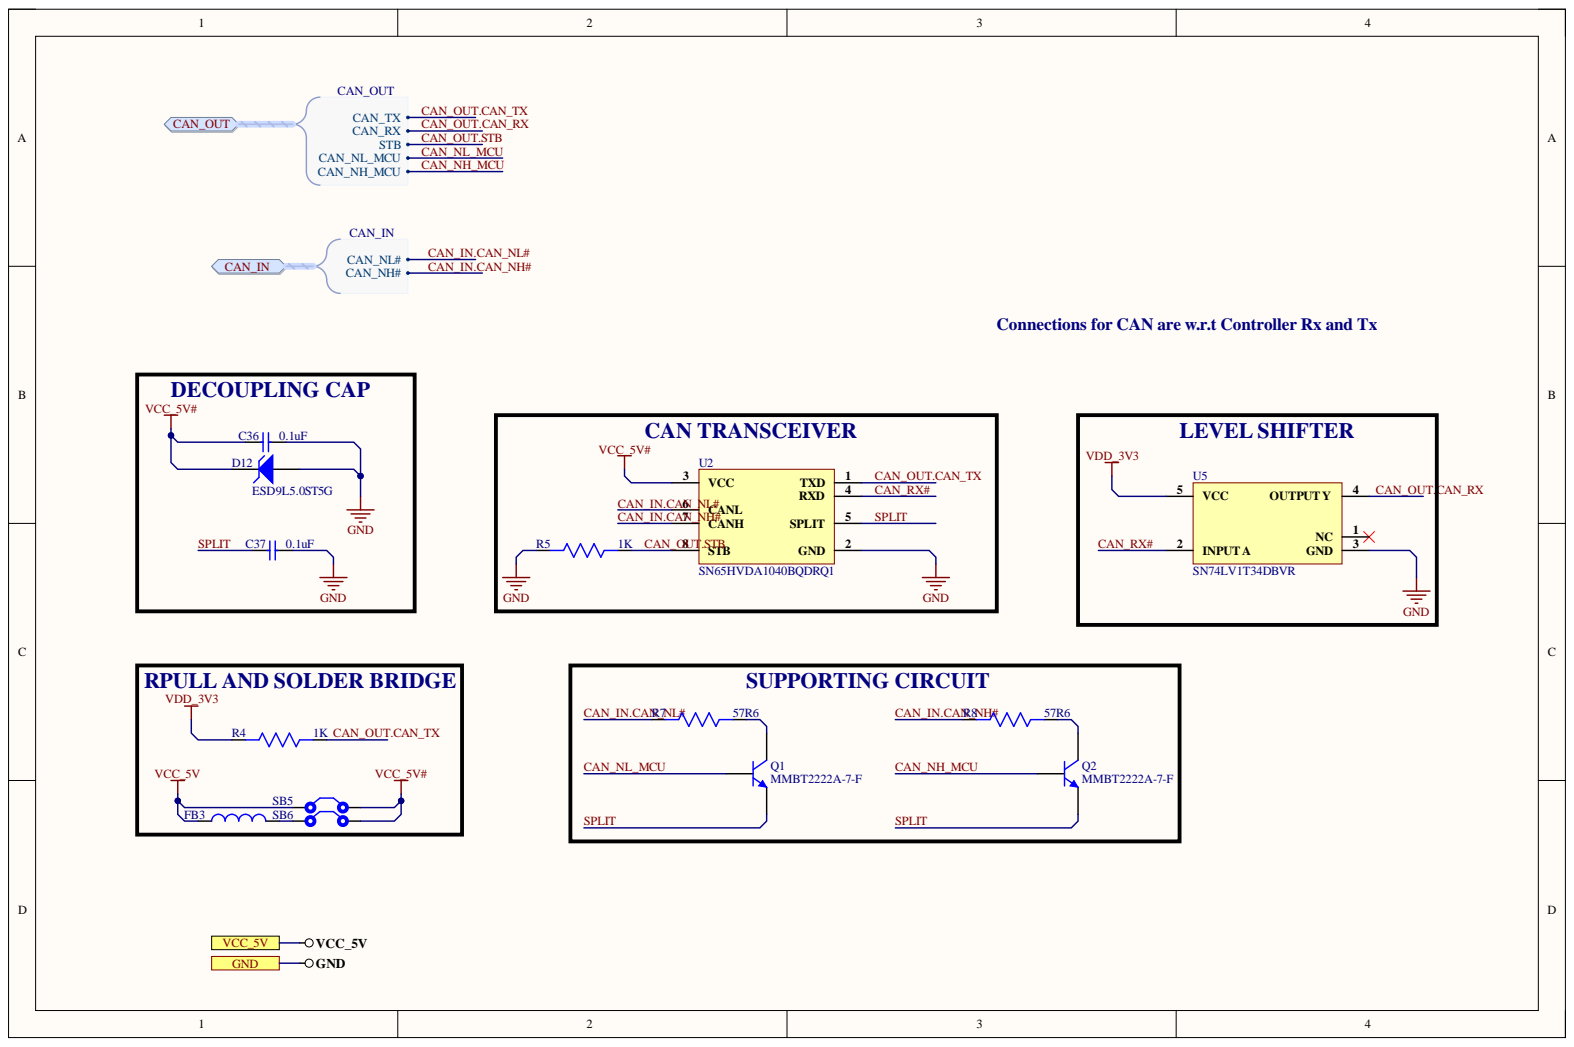
[picture p109: page 6]

Connections for CAN are w.r.t Controller Rx and Tx

RPULL AND SOLDER BRIDGE

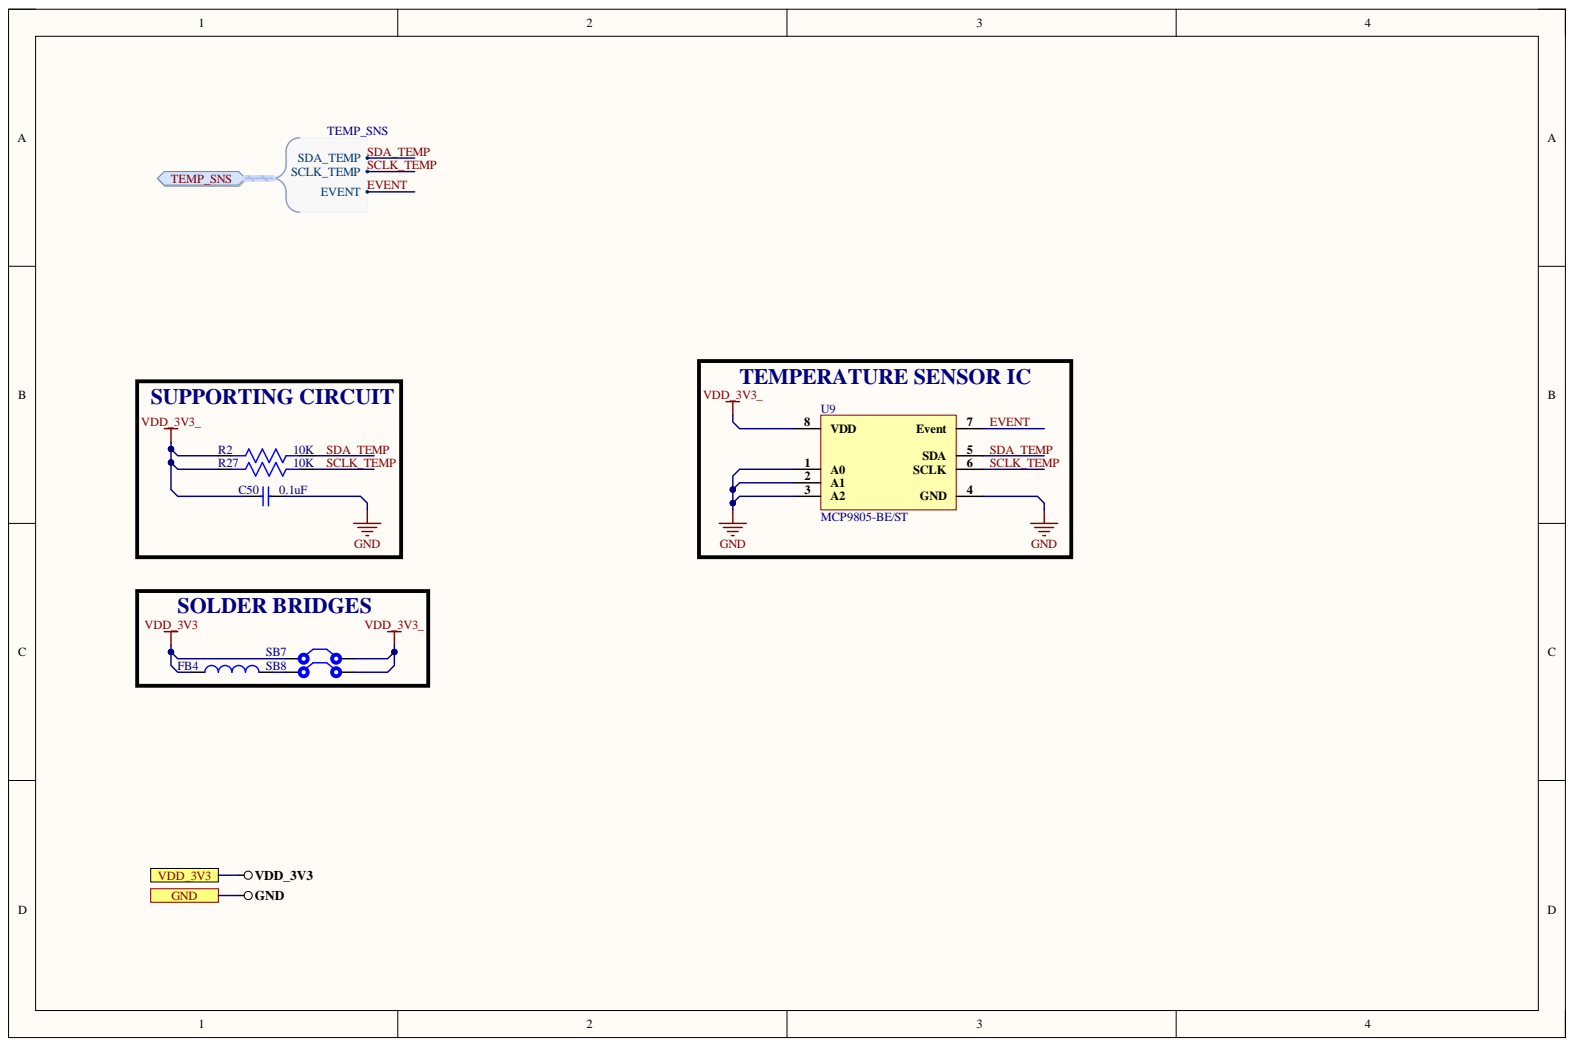
[picture p110: page 7]

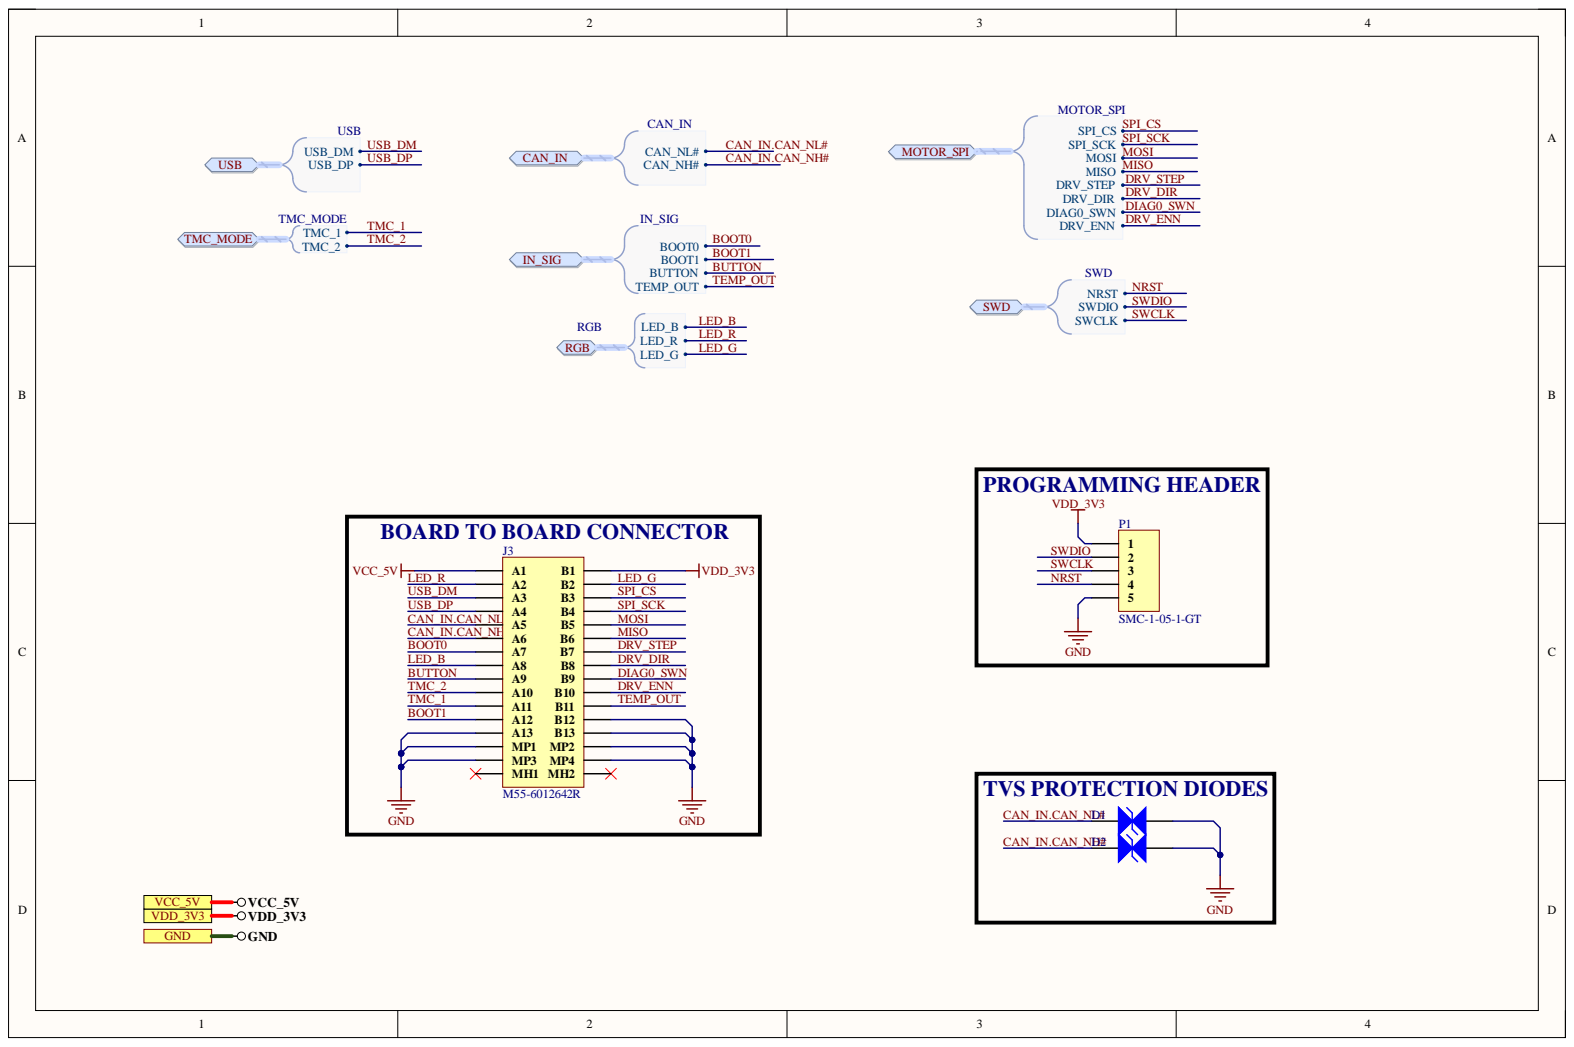
[picture p111: page 8]

BOARD TO BOARD CONNECTOR

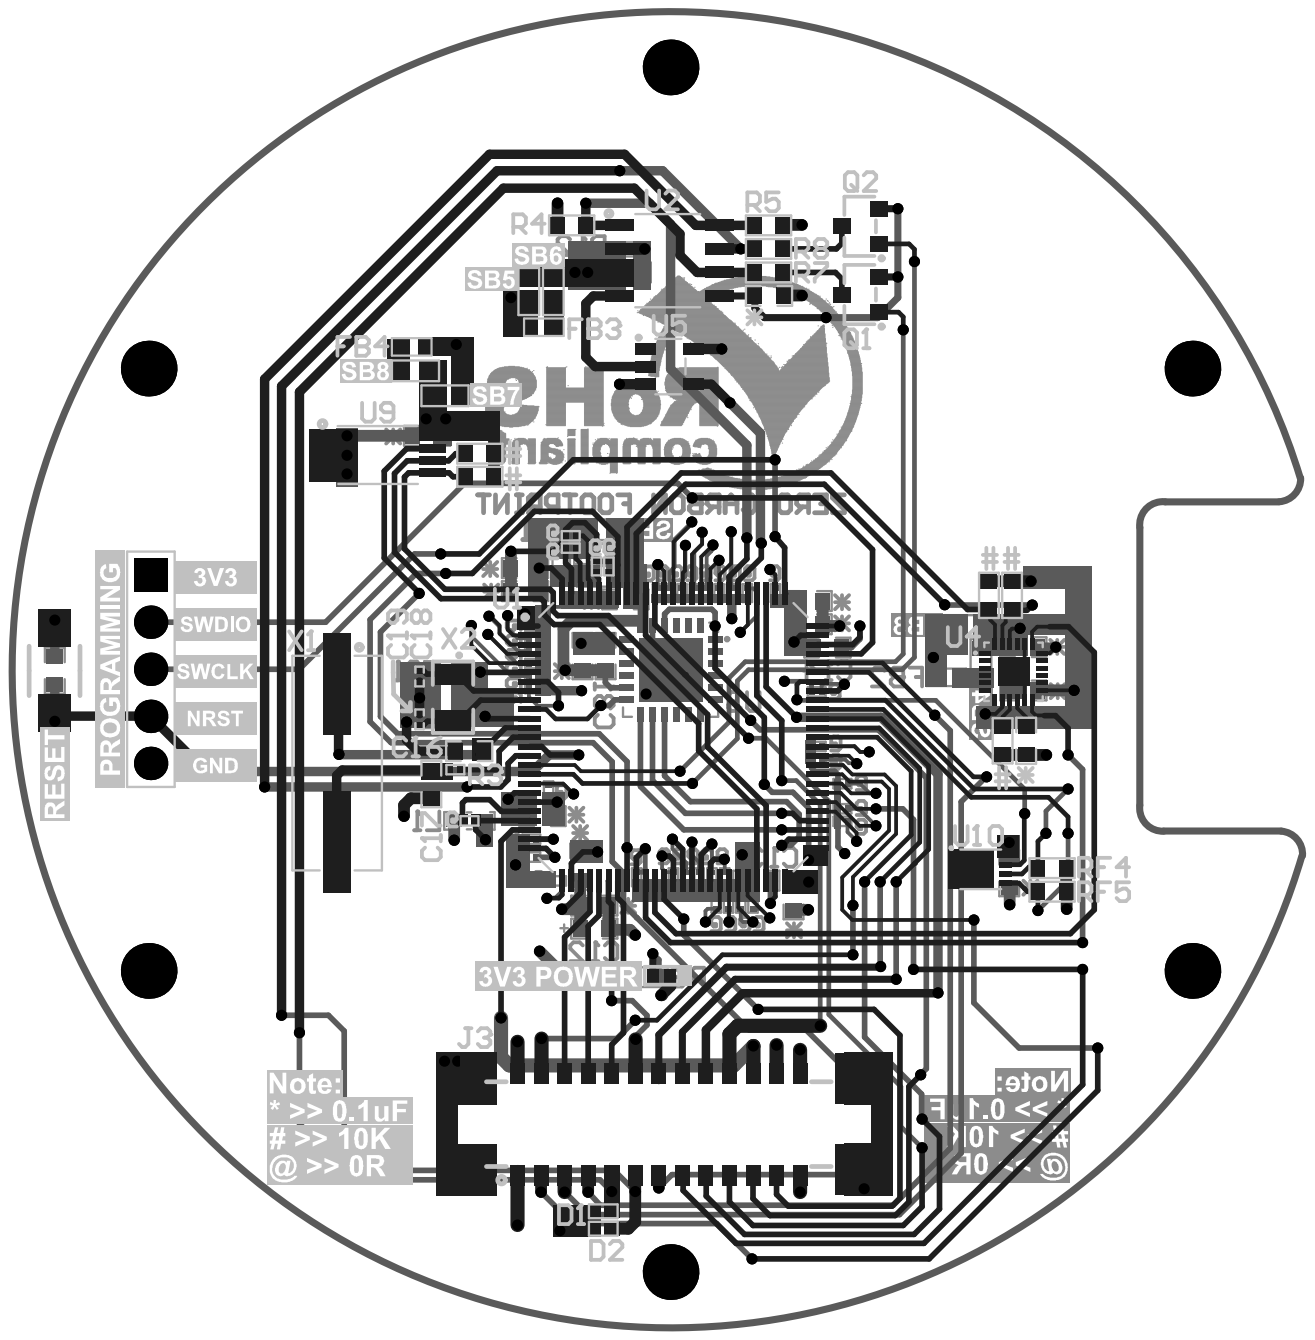
[picture p112: page 9]
