eSpark-Backup/colebenson-smartmotors/Deliverables/SM_Bottom Board/_Schematics/SM_Bottom_Board(Schematic).pdf

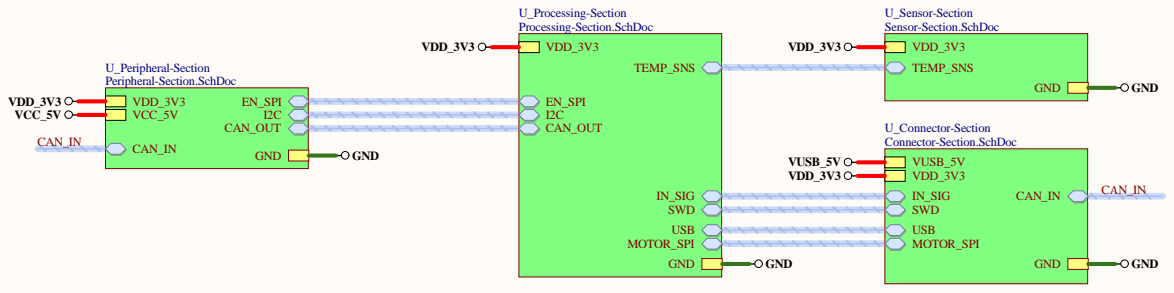
[picture p113: page 1]

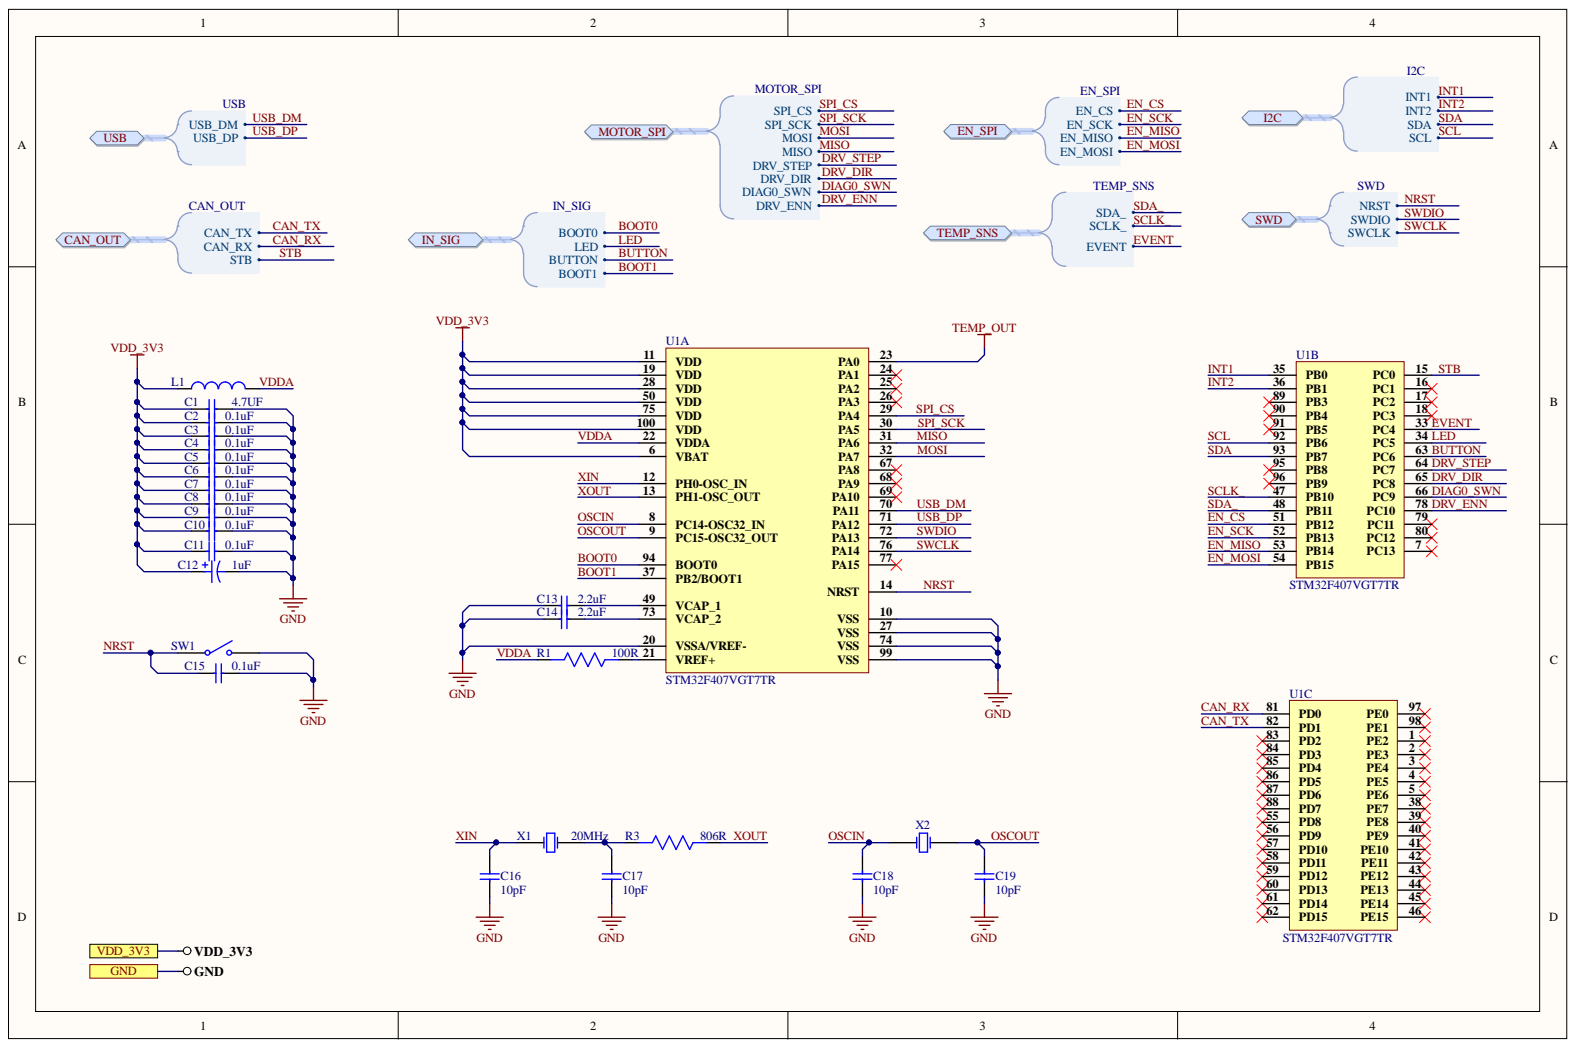
[picture p114: page 2]

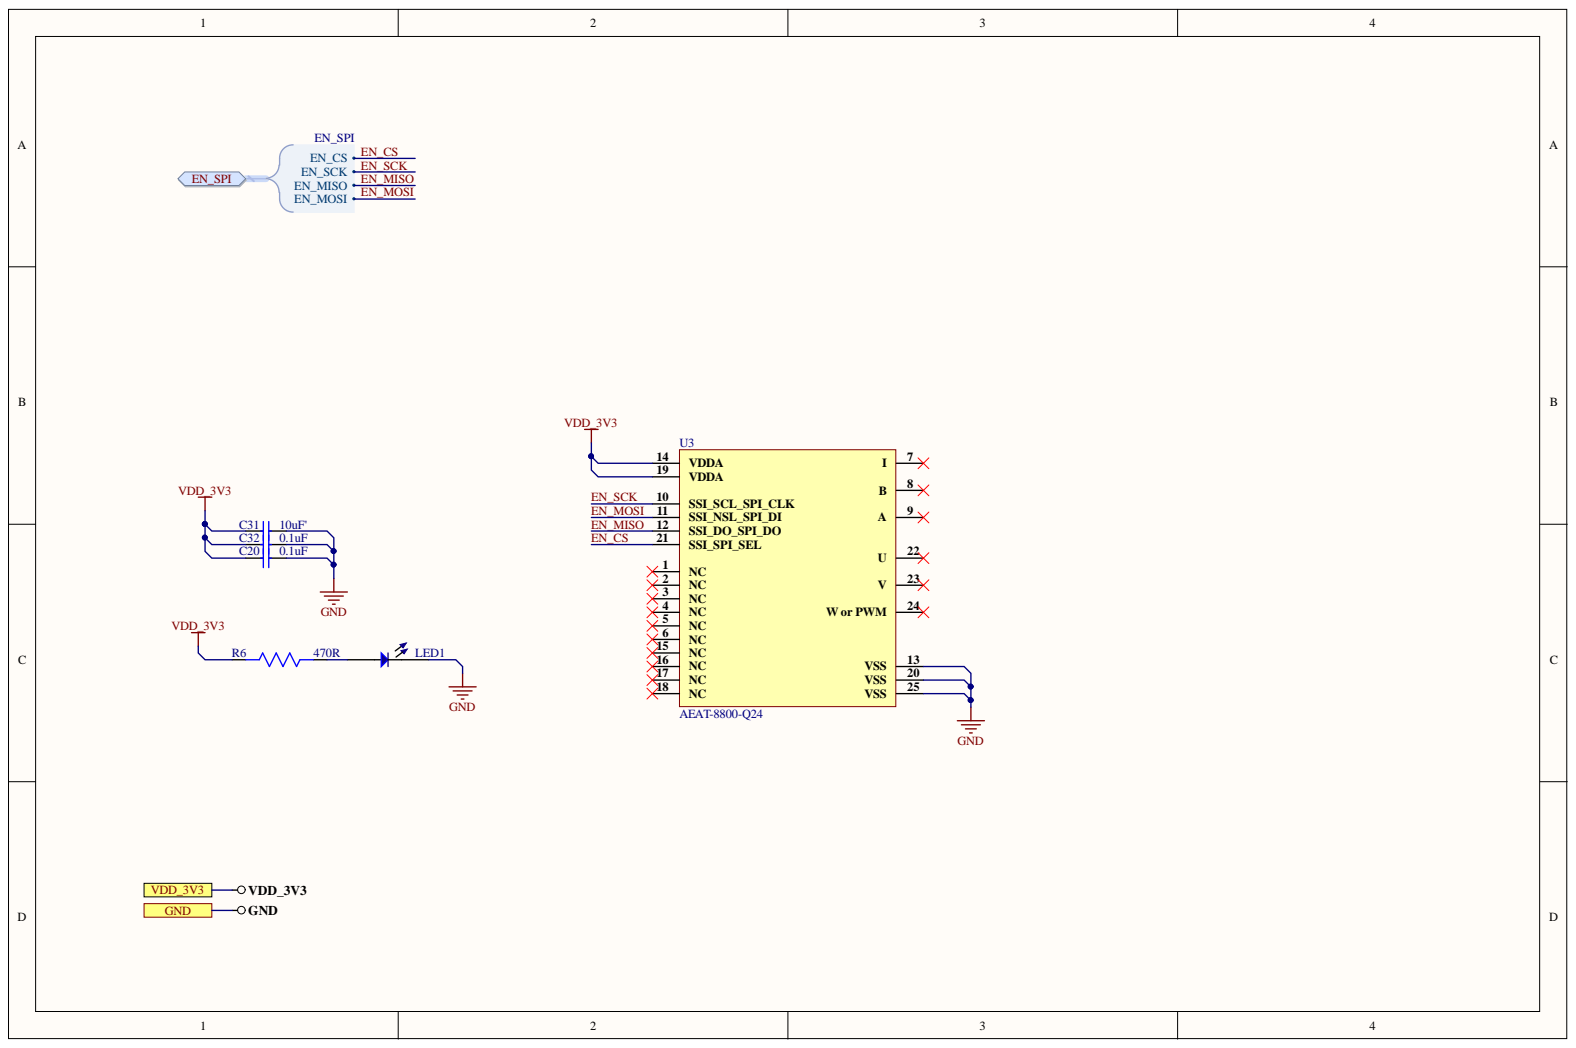
[picture p115: page 3]

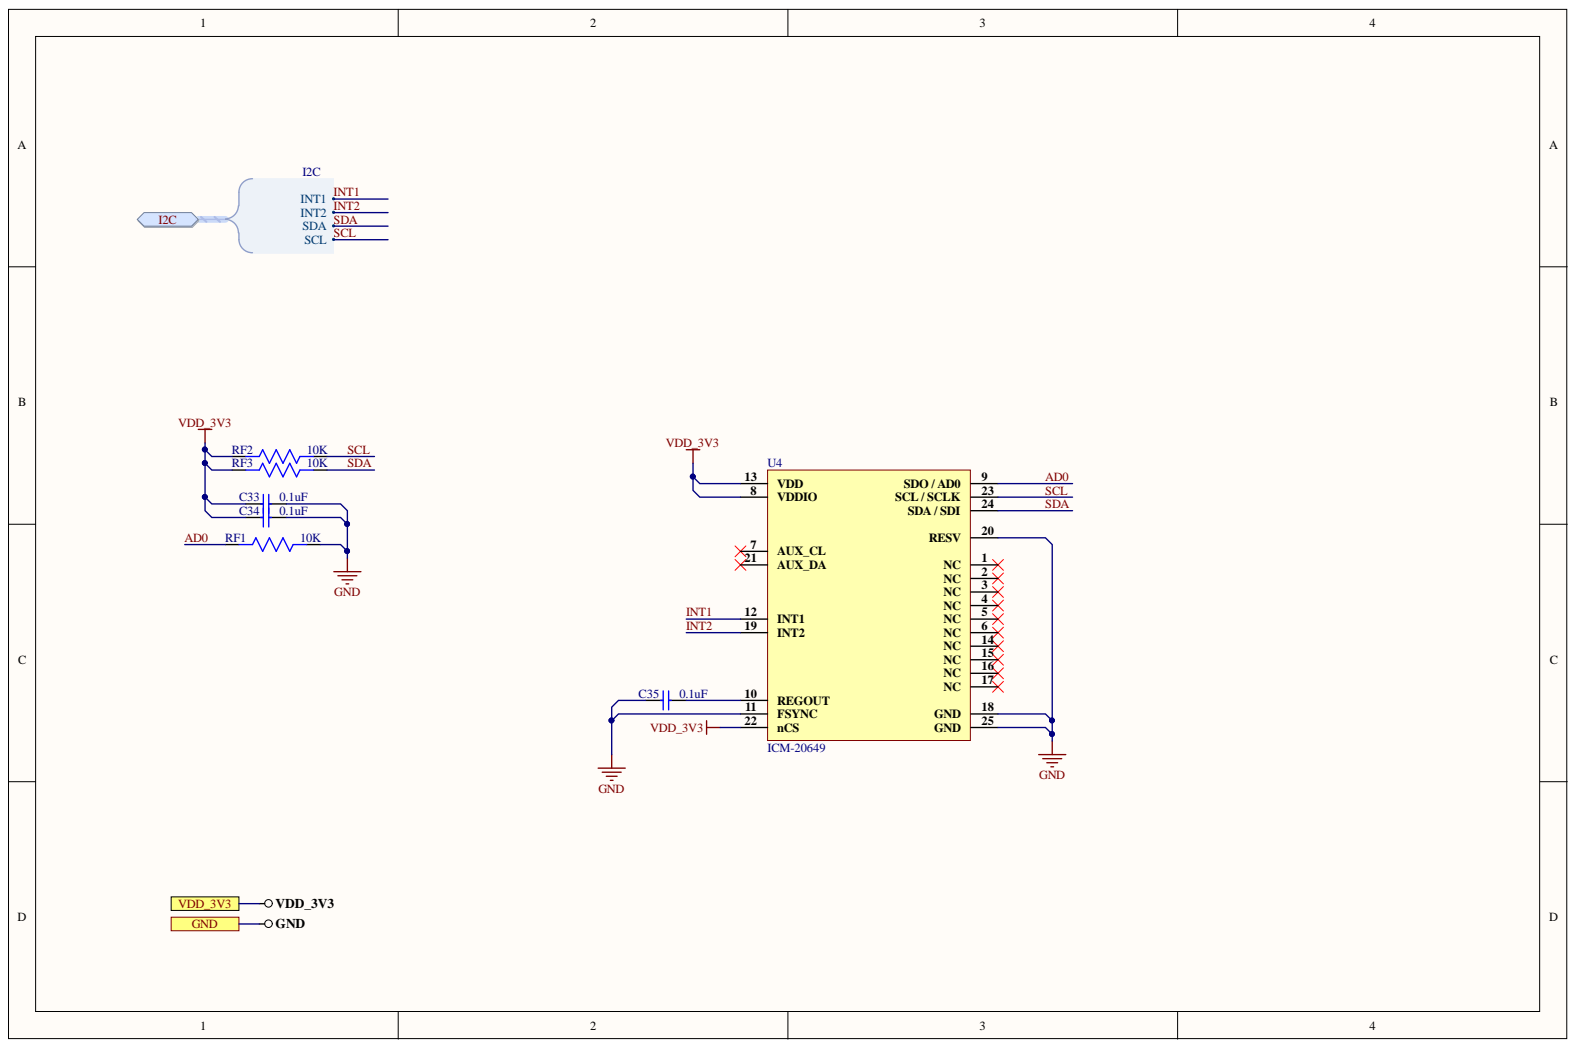
[picture p116: page 4]

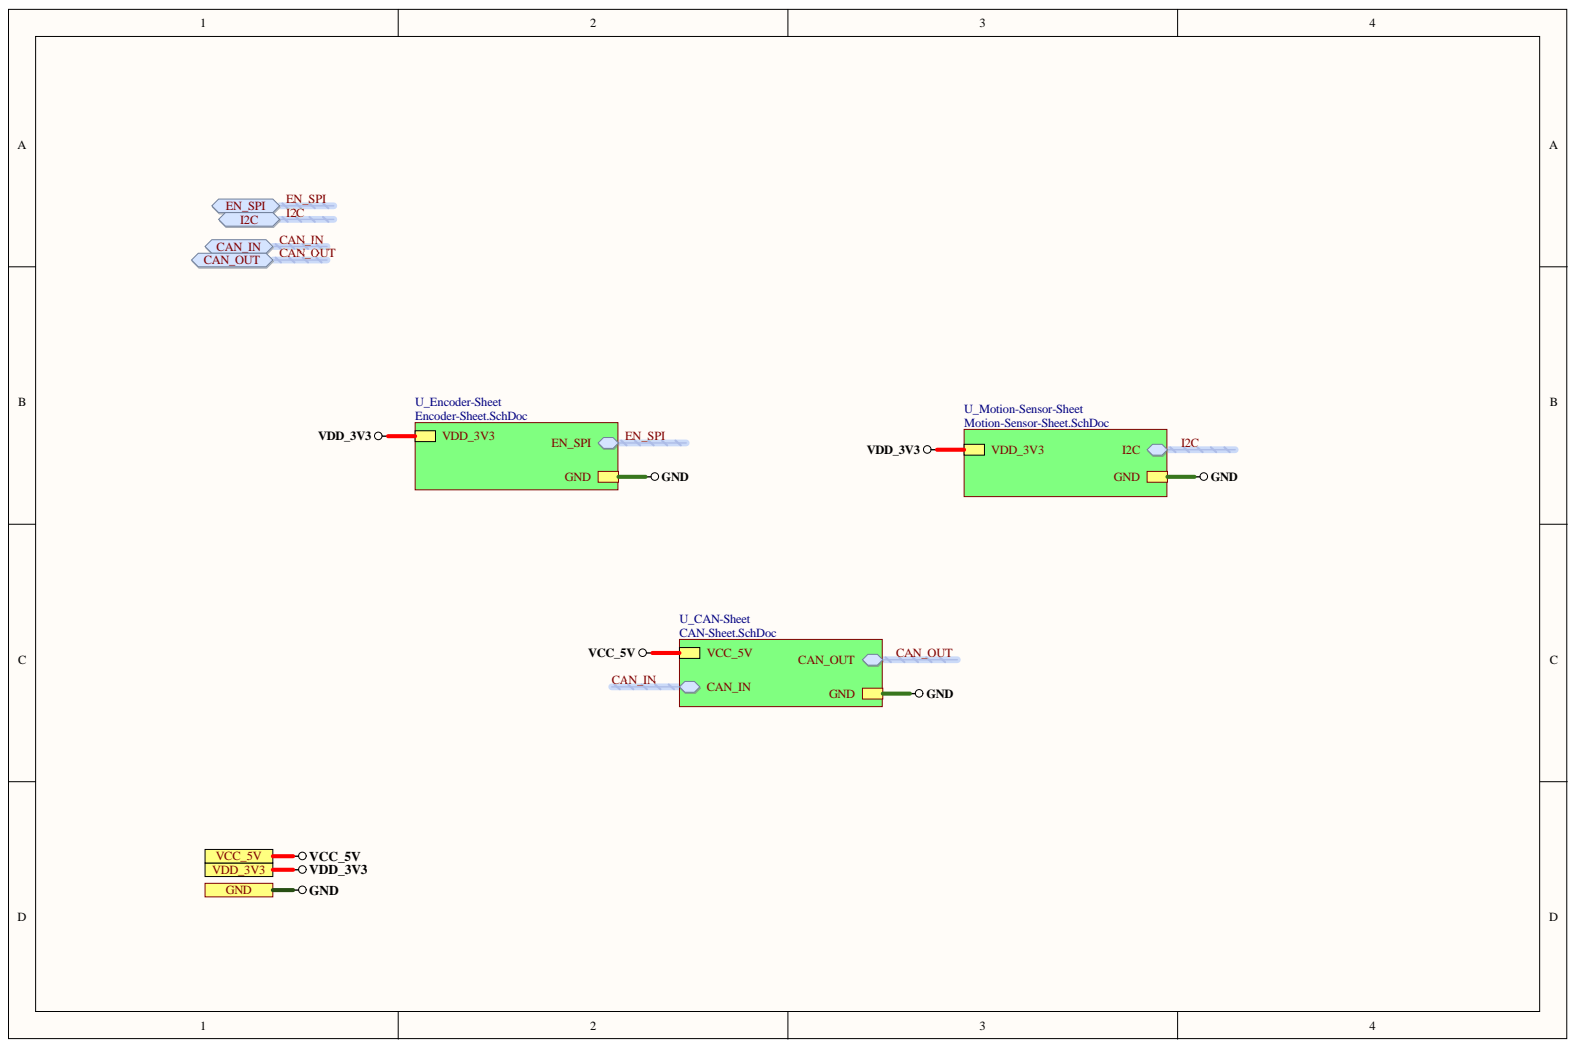
[picture p117: page 5]

U_Motion-Sensor-Sheet
Motion-Sensor-Sheet.SchDoc

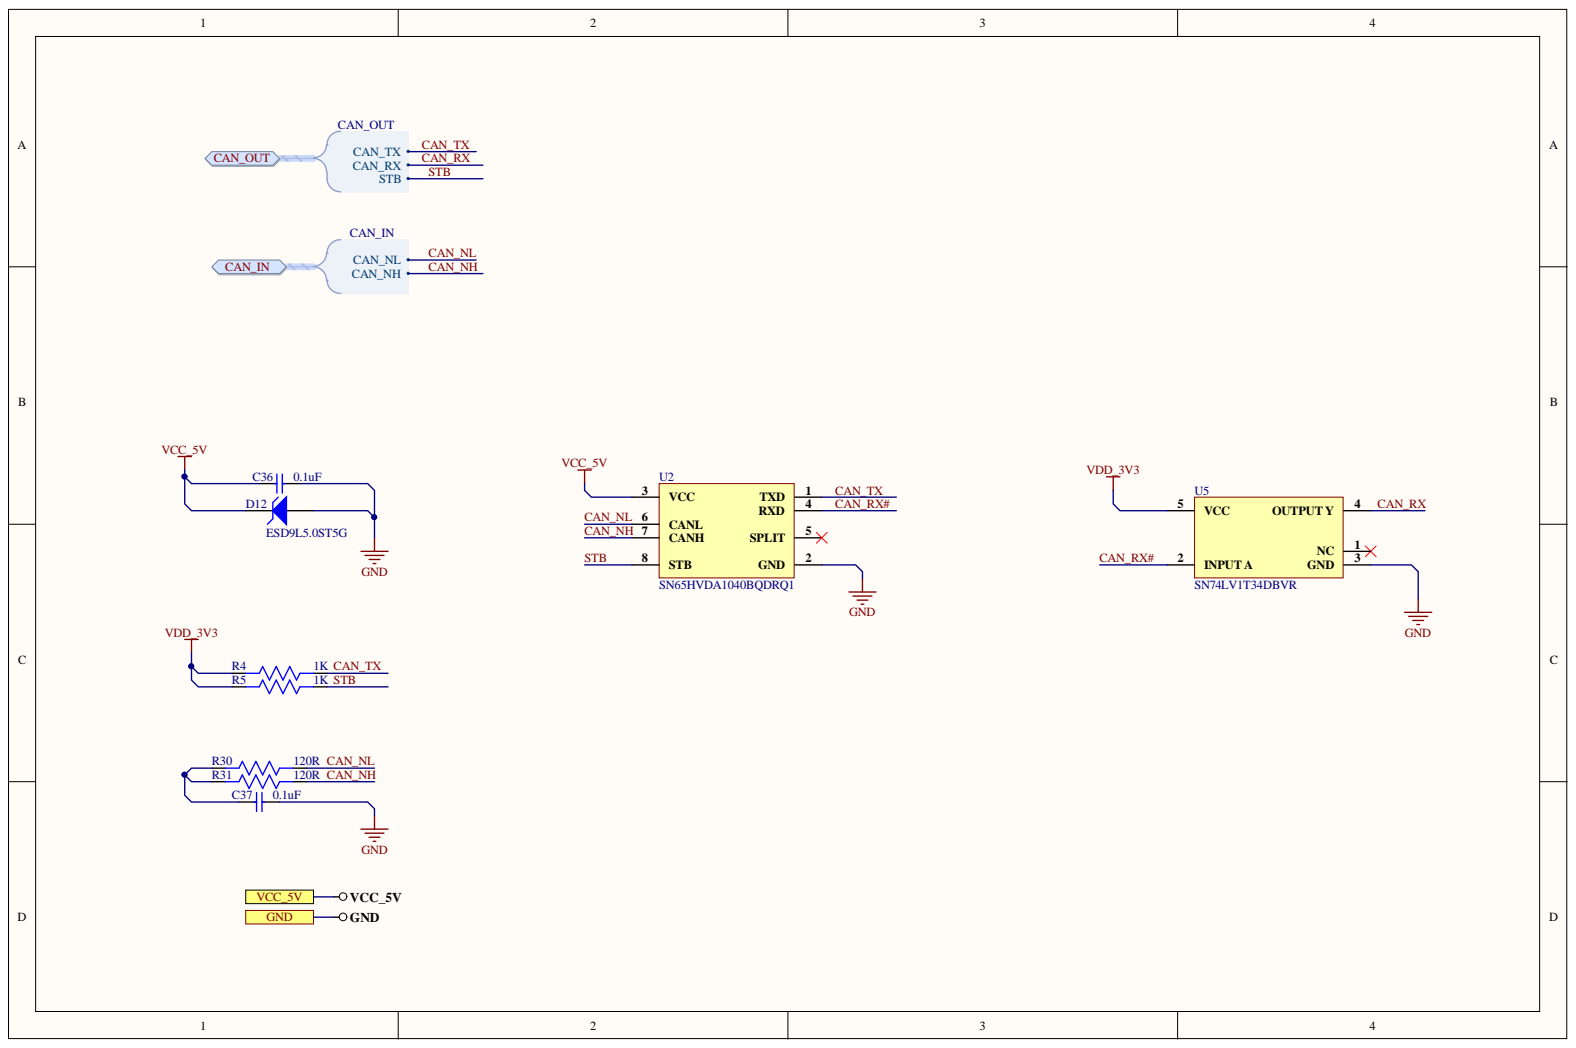
[picture p118: page 6]

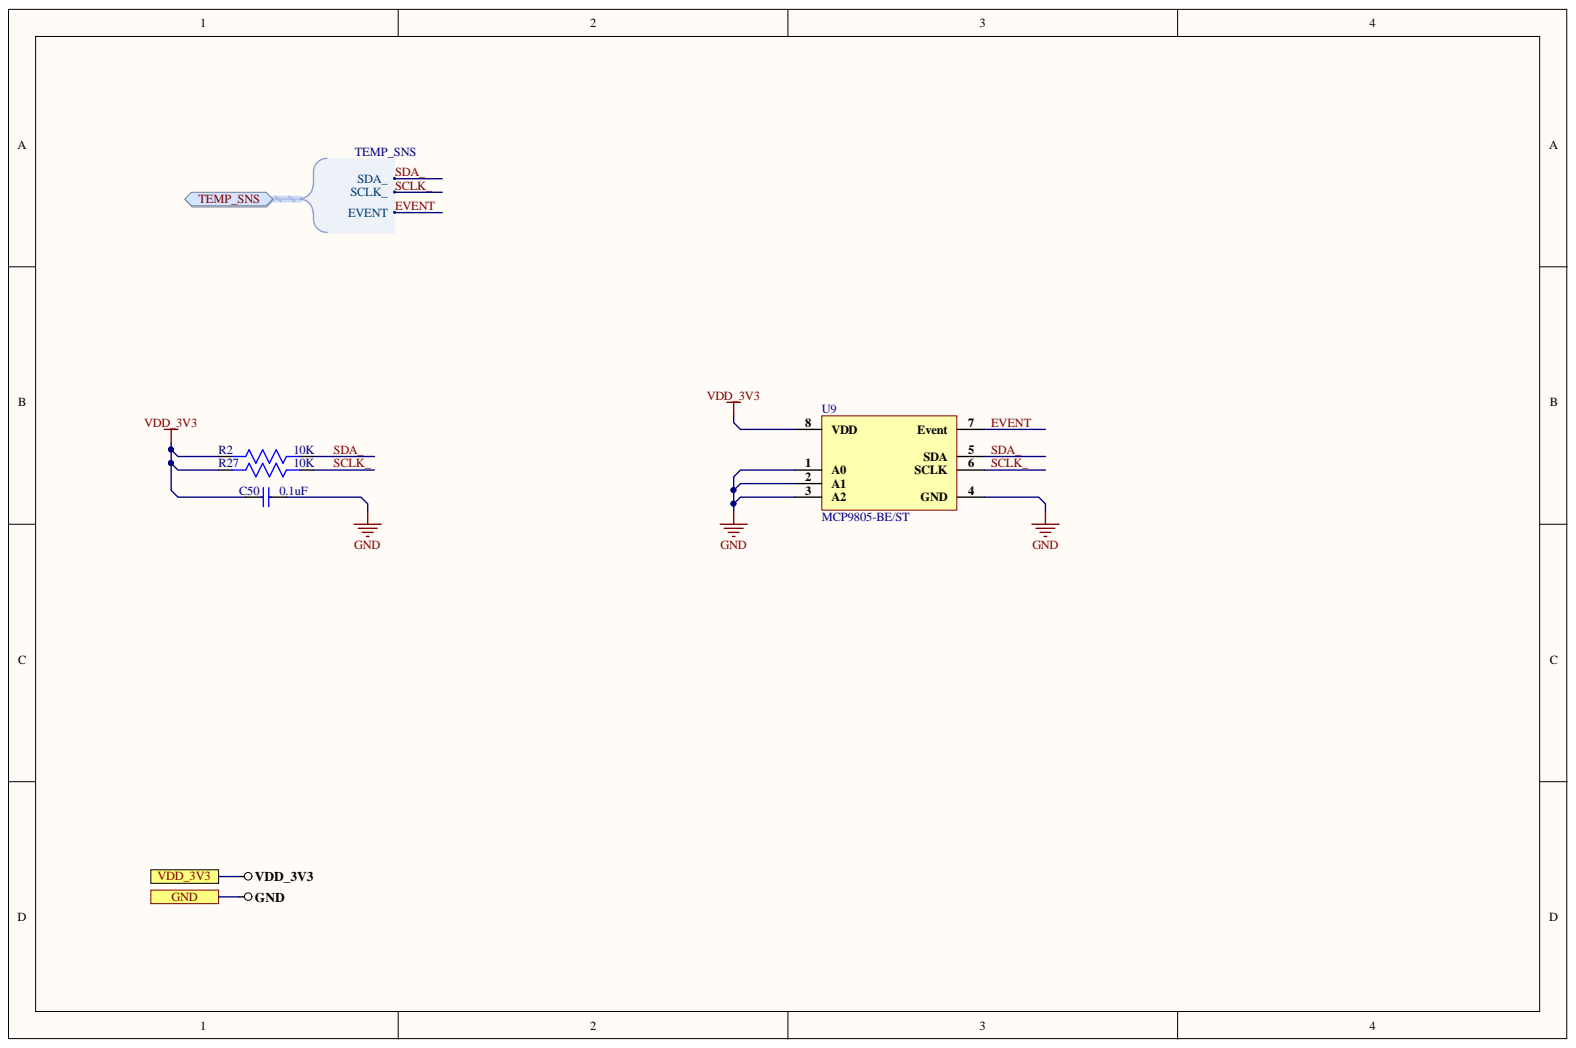
[picture p119: page 7]

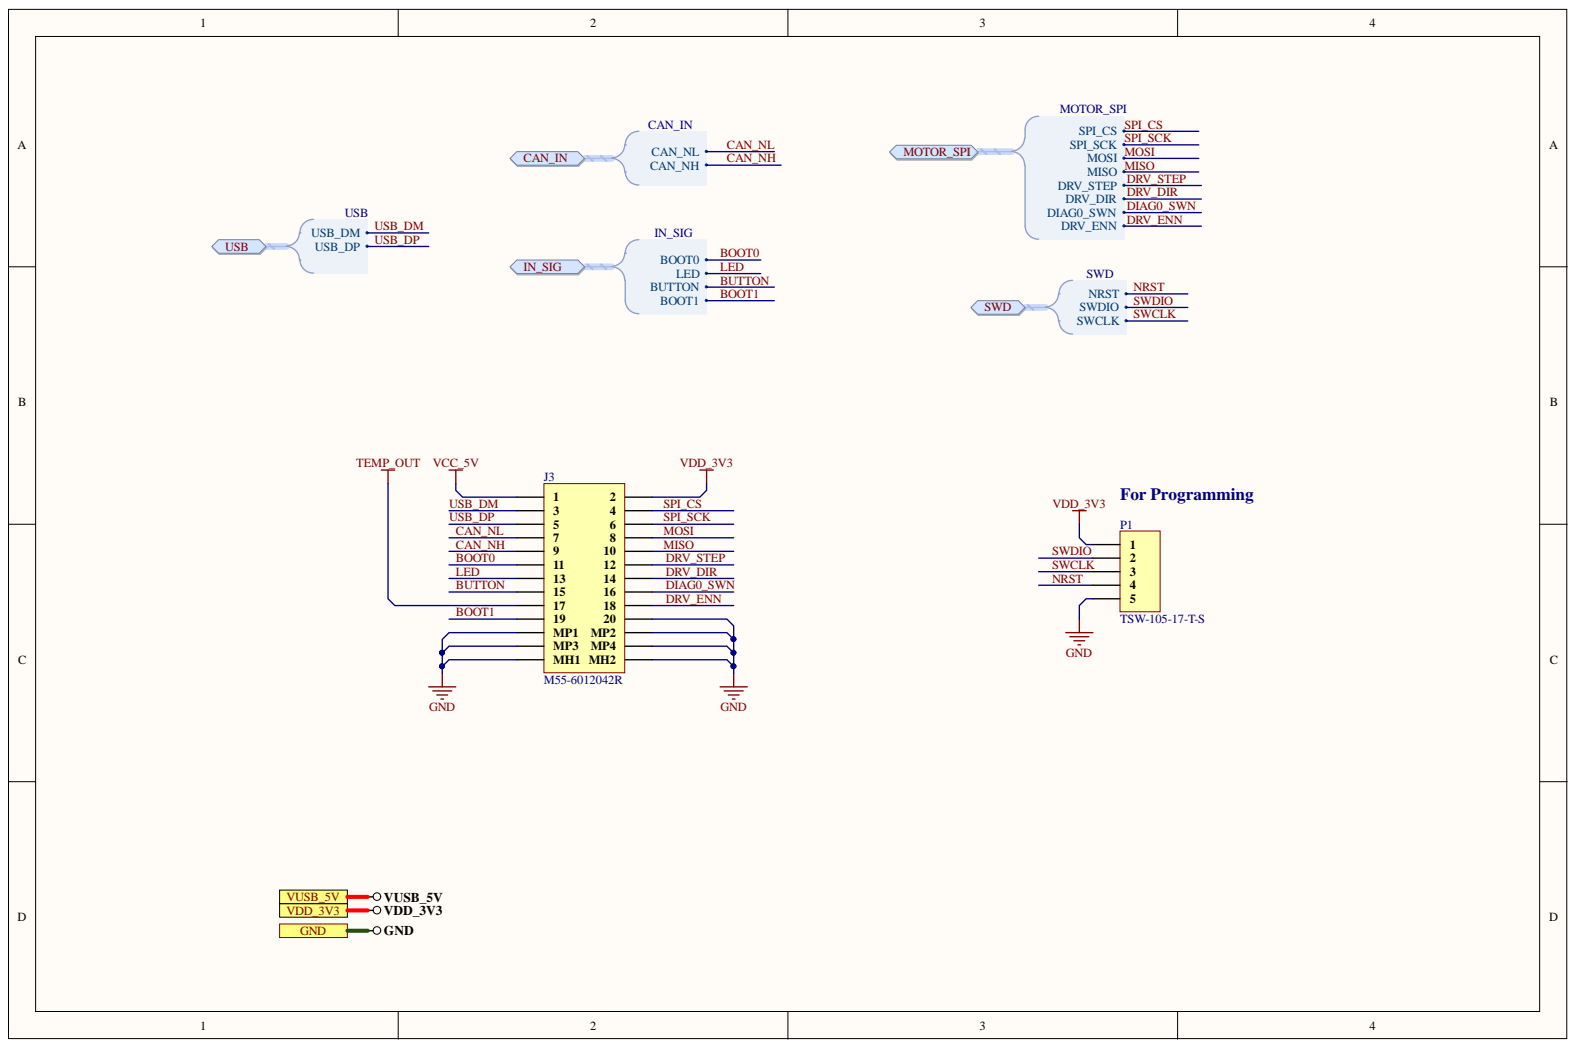
[picture p120: page 8]
