eSpark-Backup/colebenson-smartmotors/Documents/Client-Shared-Files/PRO-ELE-Issues-2021-11-16.pdf

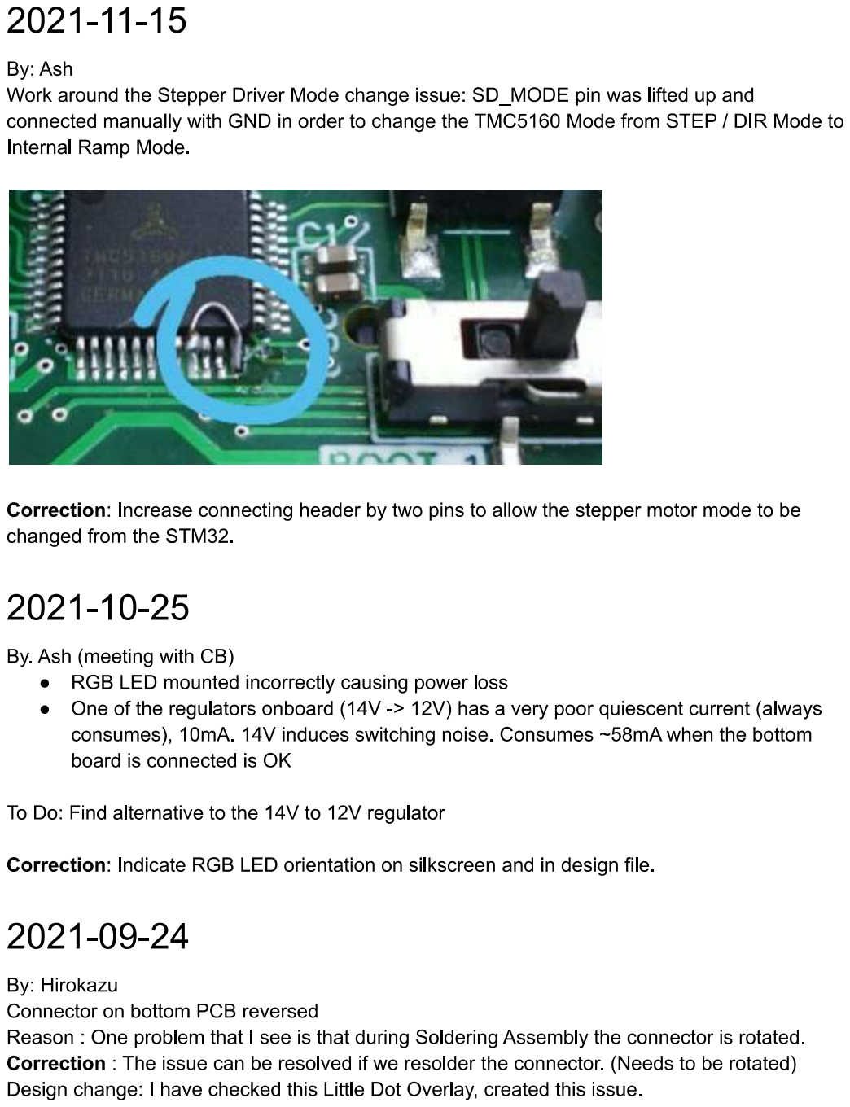
[picture p121: page 1]

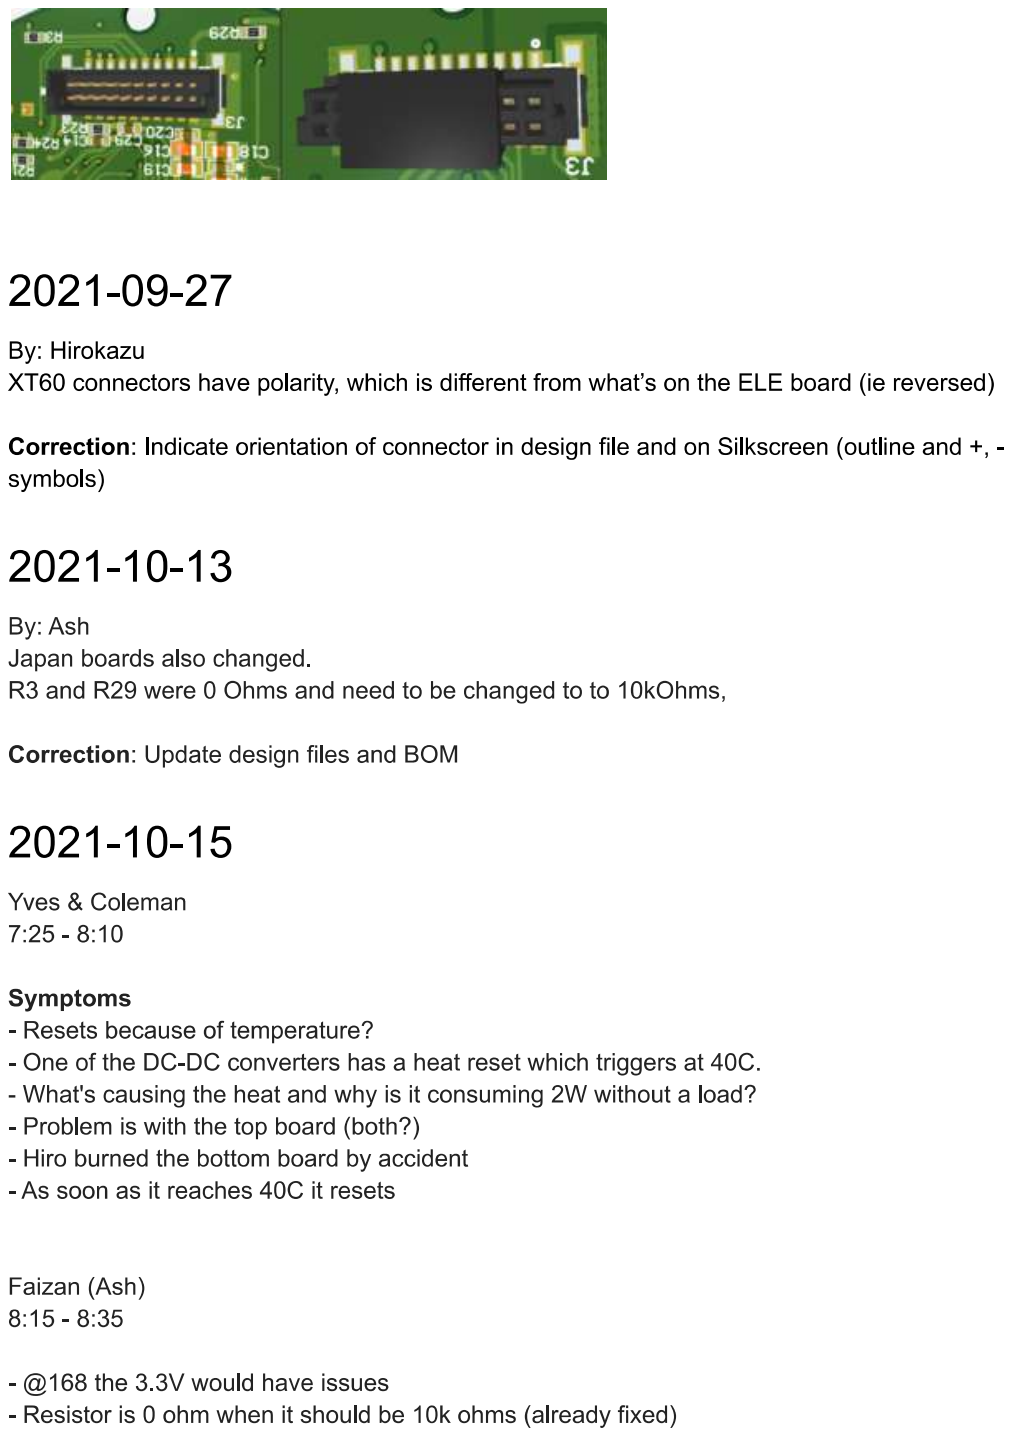
[picture p122: page 2]
