eSpark-Backup/colebenson-smartmotors/Design-Files-v3.4/LSS_Bottom_Board_v3.4/Schematics/Assembly_Drawings_v3.4.pdf

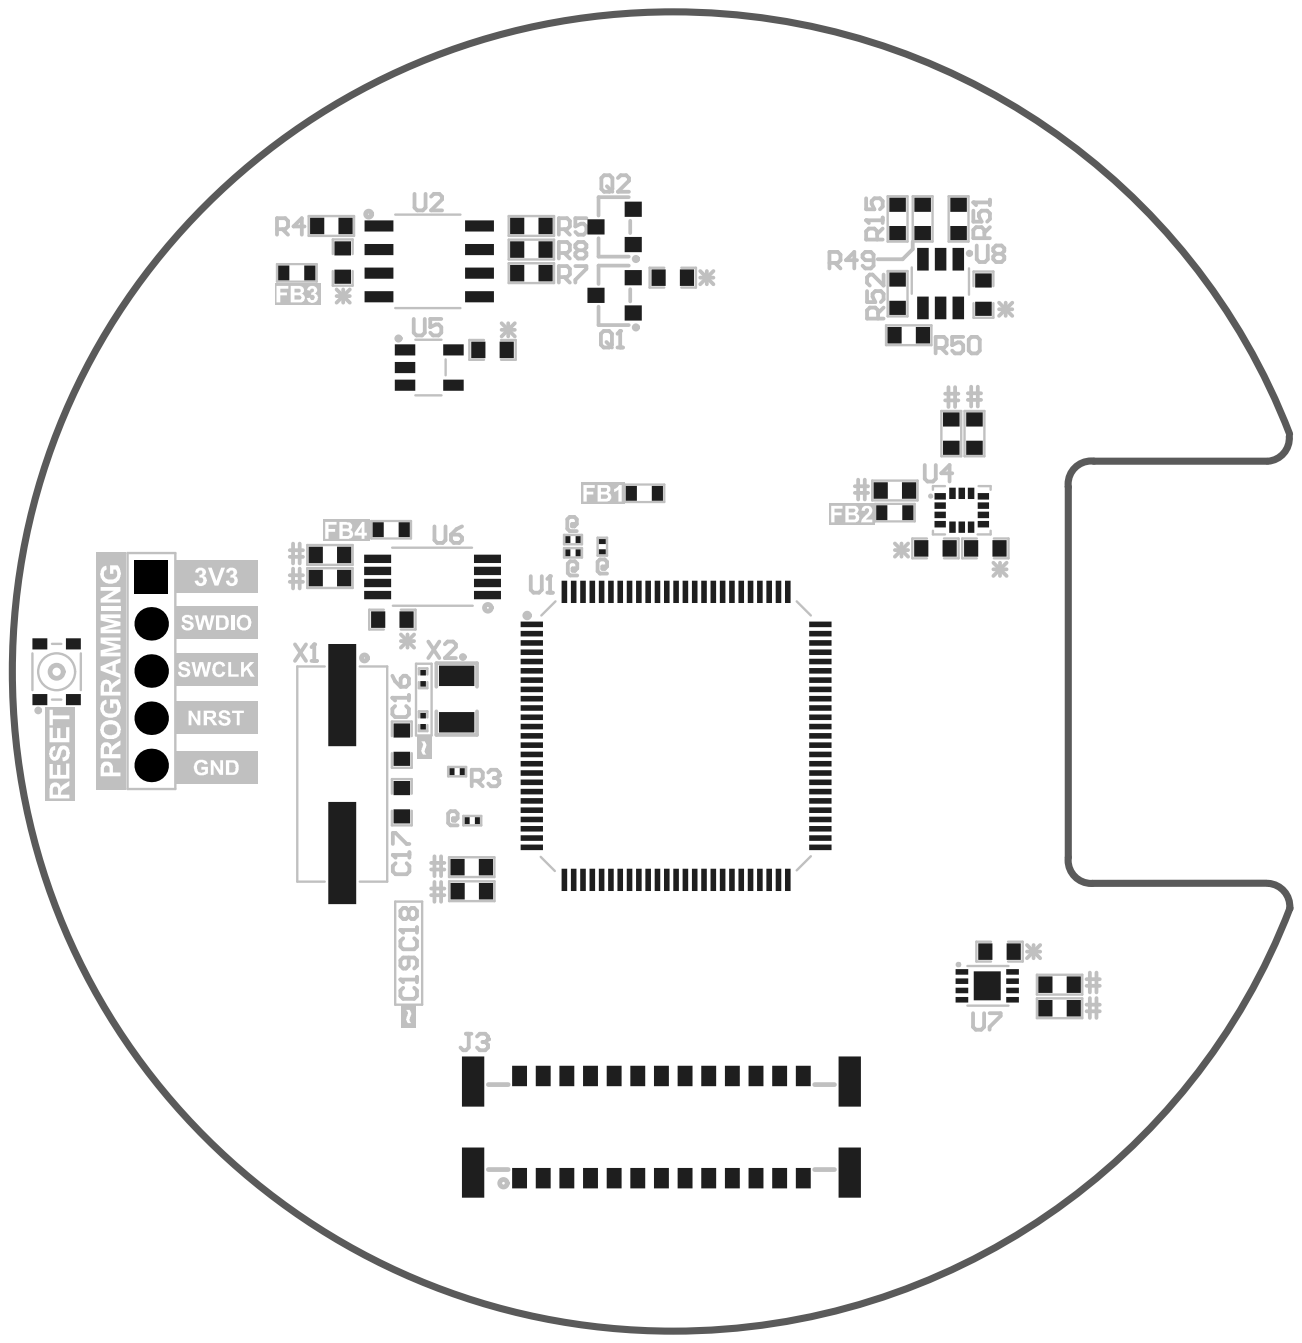
[picture p123: page 1]

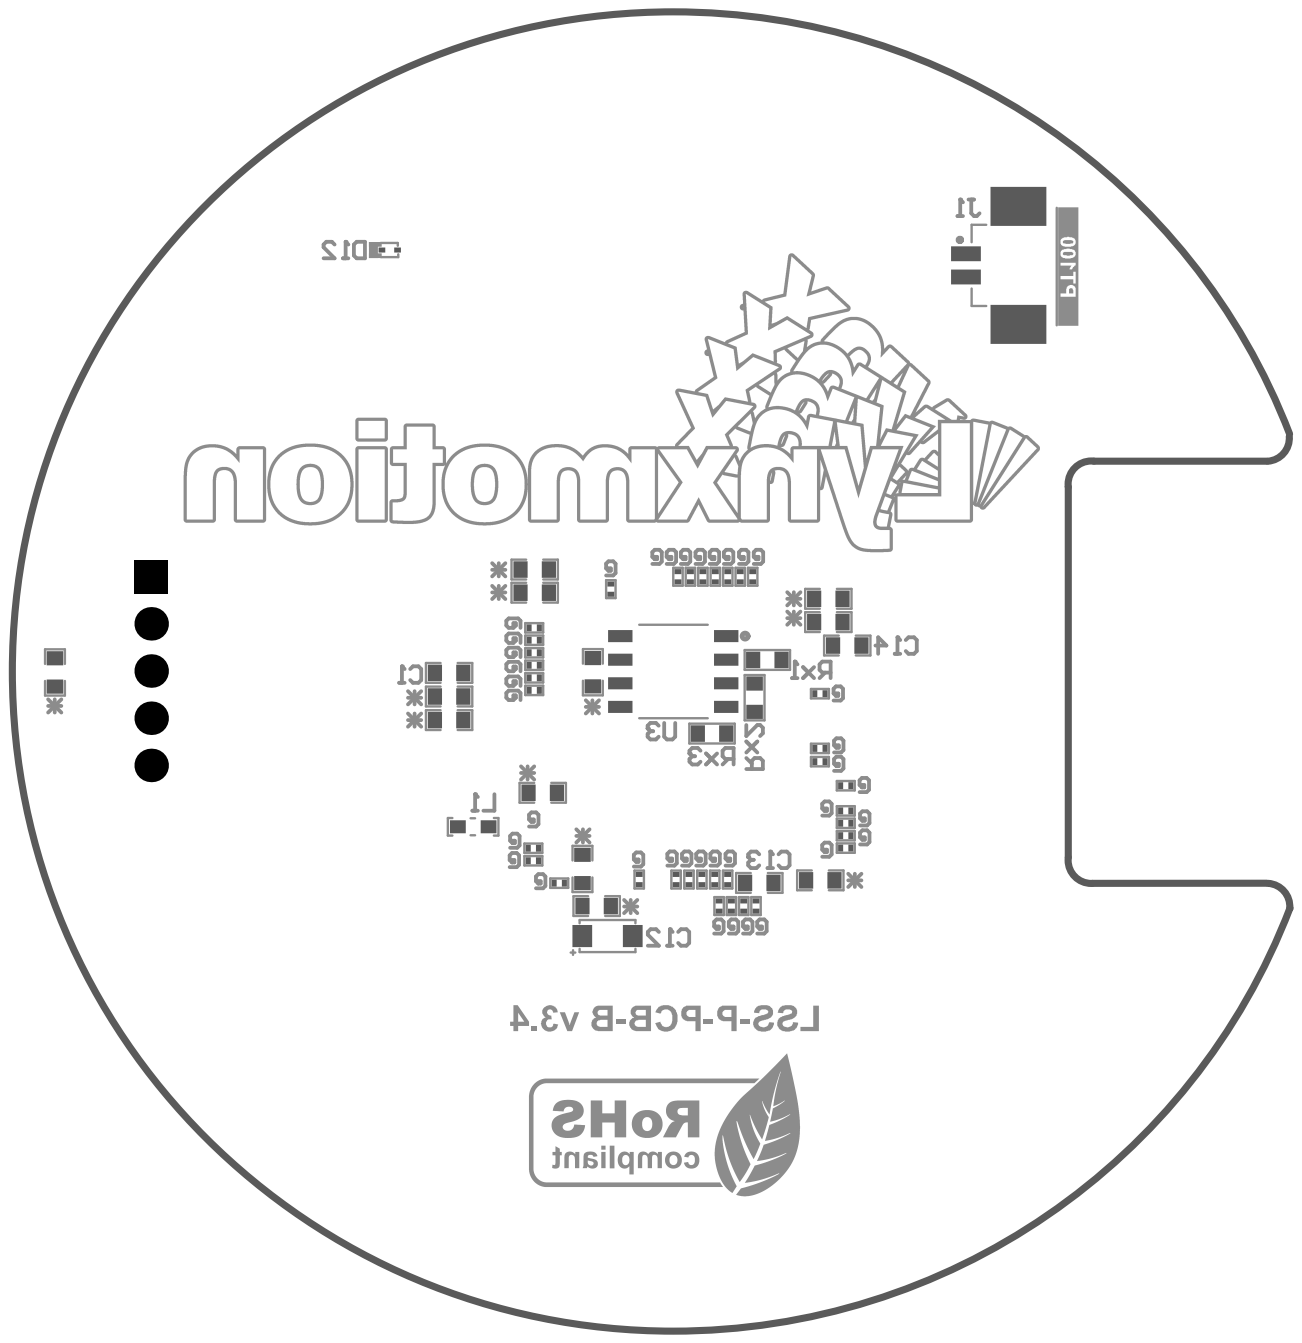
[picture p124: page 2]
