eSpark-Backup/colebenson-smartmotors/Design-Files-v3.4/LSS_Sub_Board_v1.1/Schematics/Assembly_Drawings_v1.1.pdf

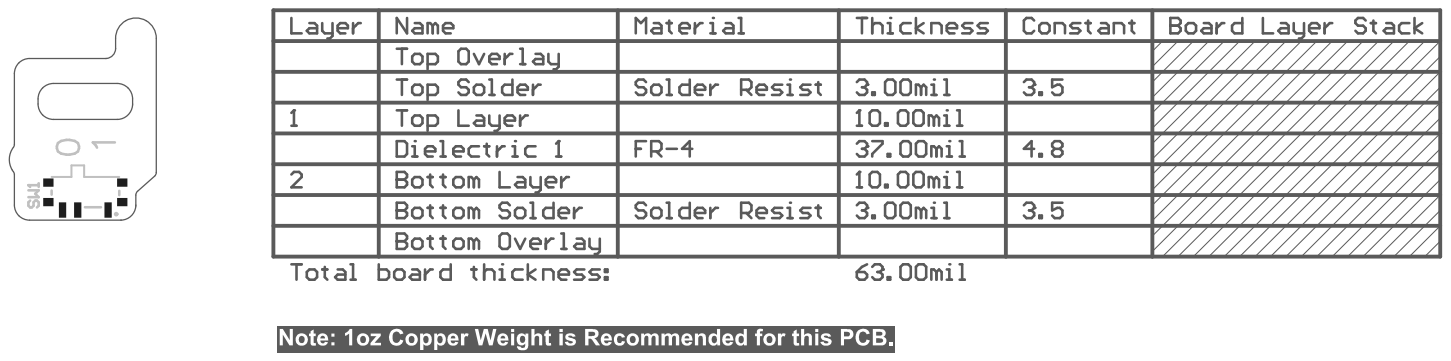
[picture p125: page 1]

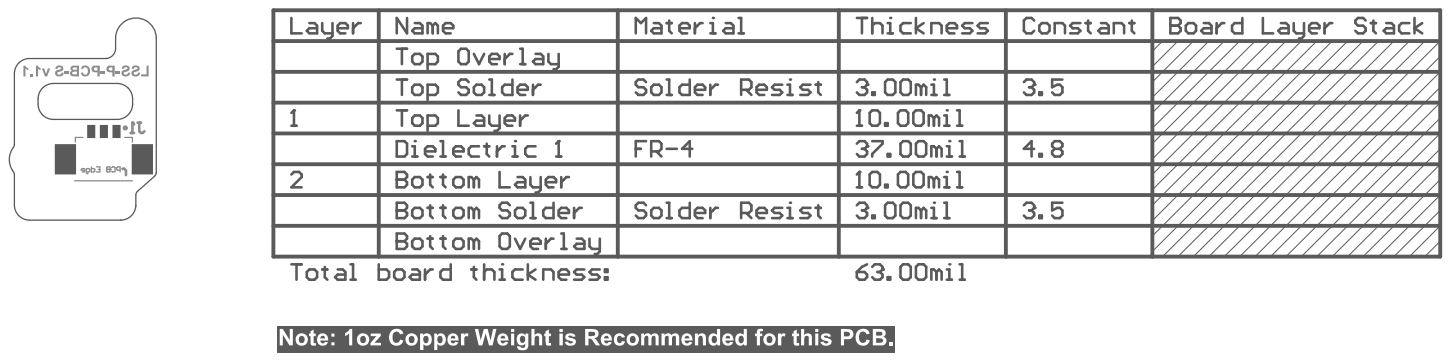
[picture p126: page 2]
