eSpark-Backup/colebenson-smartmotors/Design-Files-v3.4/LSS_Sub_Board_v1.1/Schematics/LSS_Sub_Board_v1.1.pdf

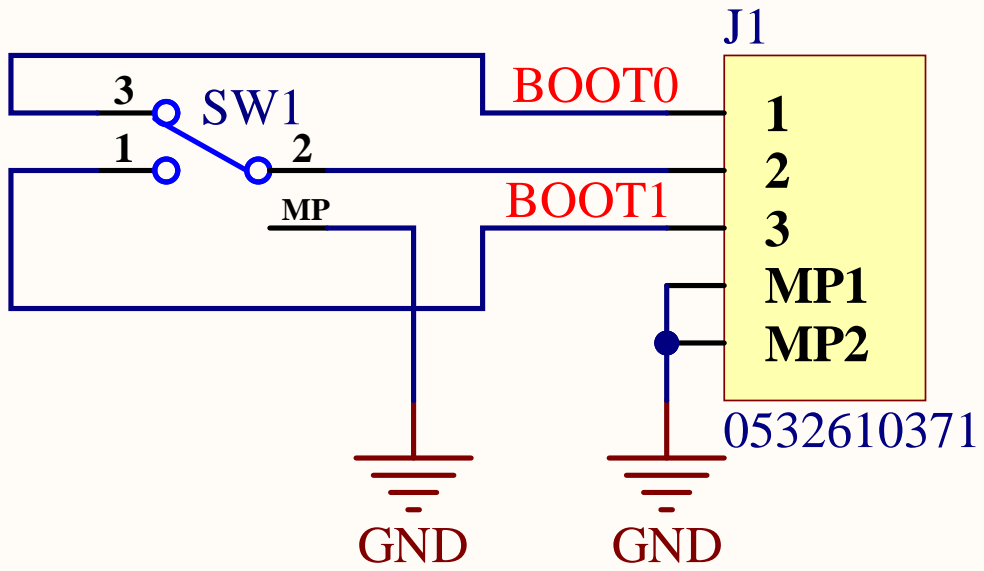
[picture p127: page 1]
