eSpark-Backup/colebenson-smartmotors/Deliverables/SM_Bottom Board/_Schematics/Assembly_Drawing.pdf

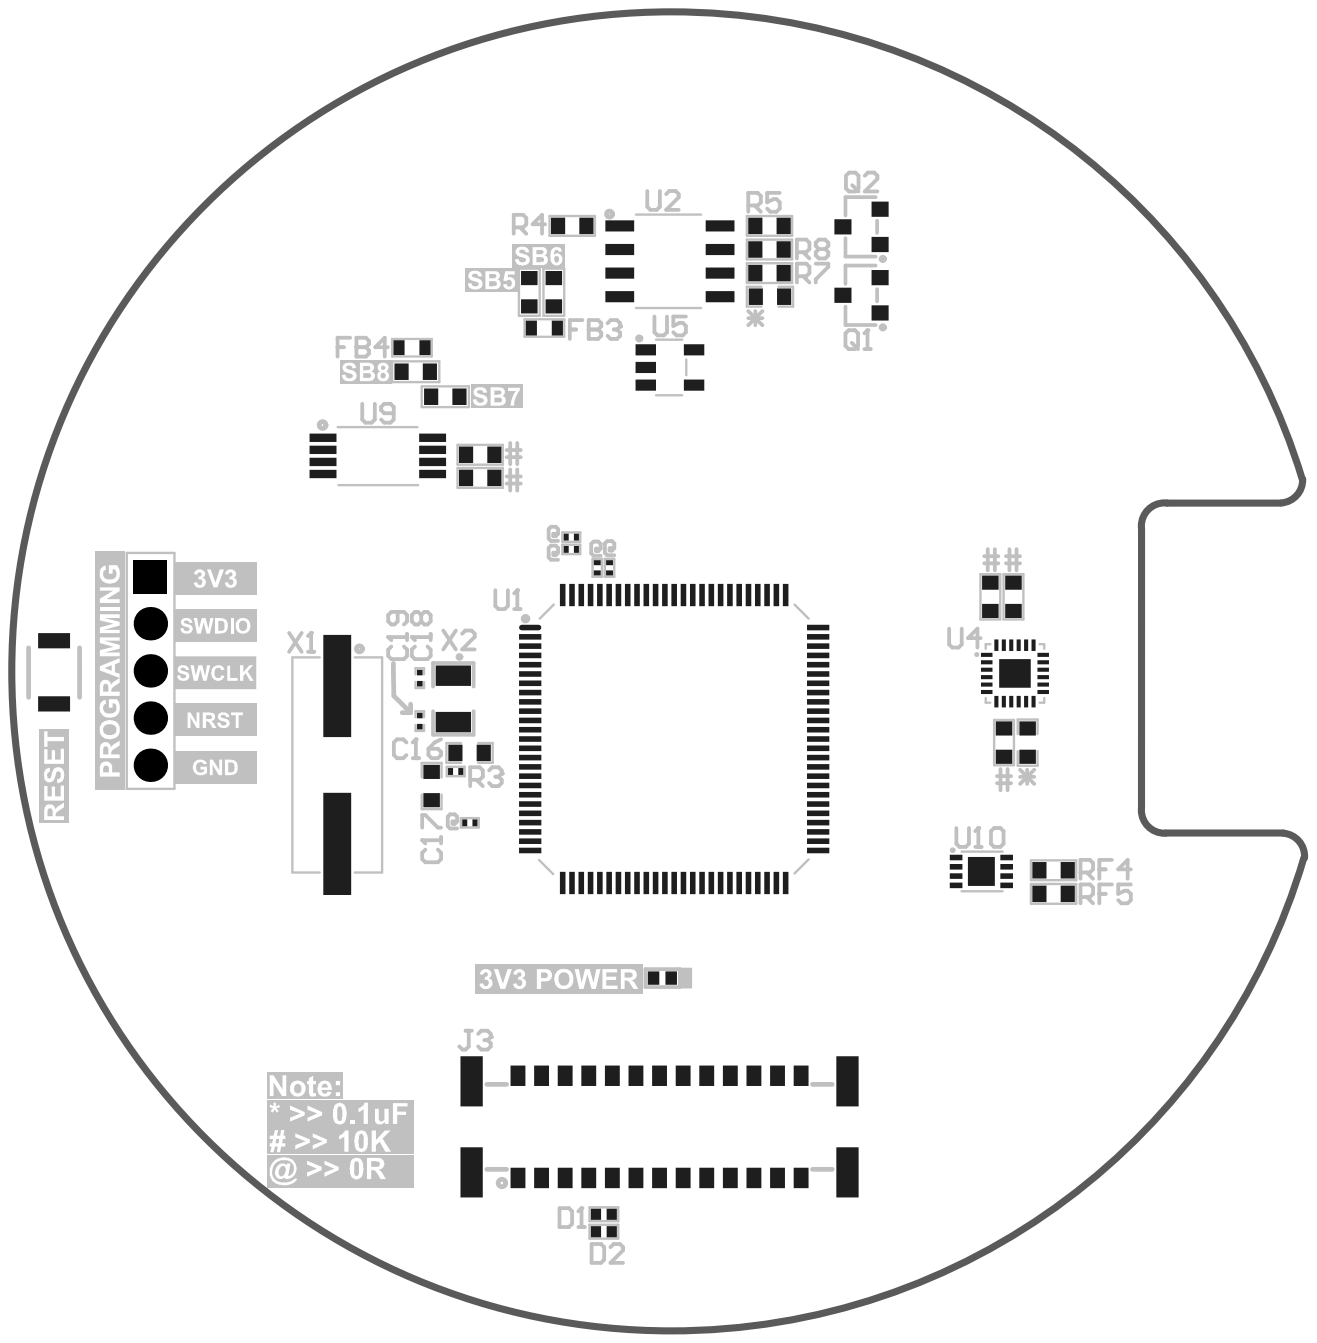
[picture p128: page 1]

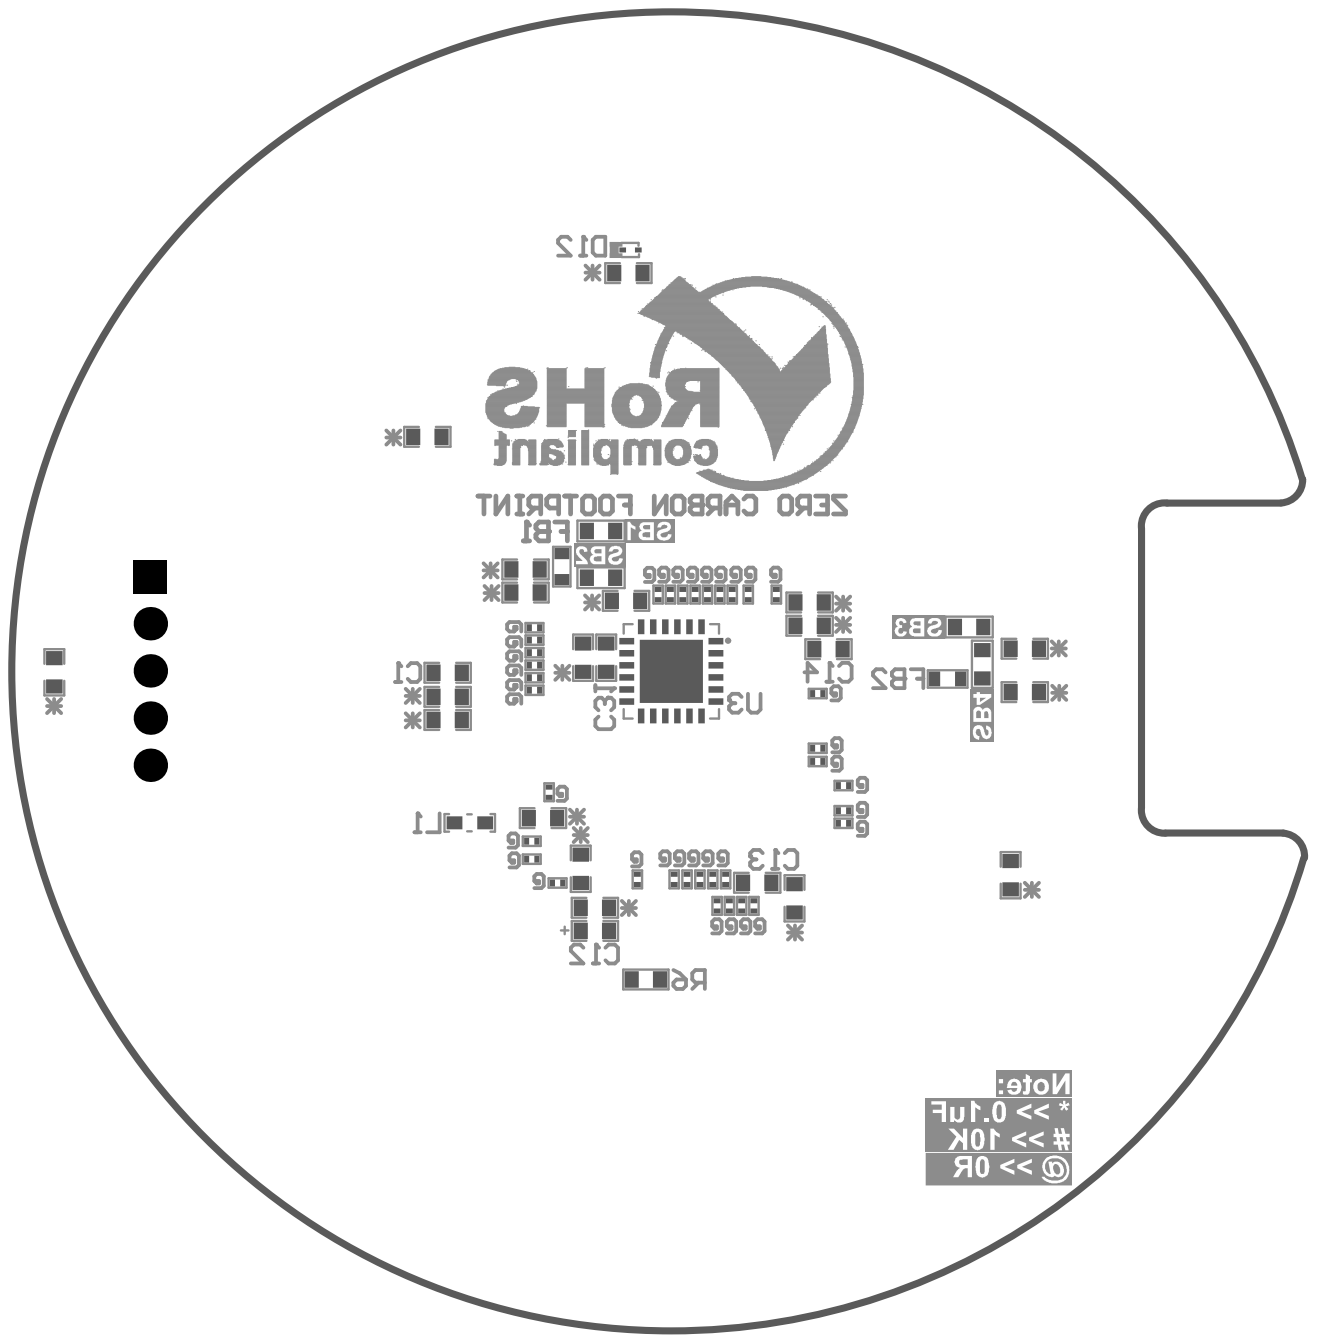
[picture p129: page 2]
