eSpark-Backup/colebenson-smartmotors/Deliverables/SM_Top Board/_Schematics/SM_Top_Board(Schematic).pdf

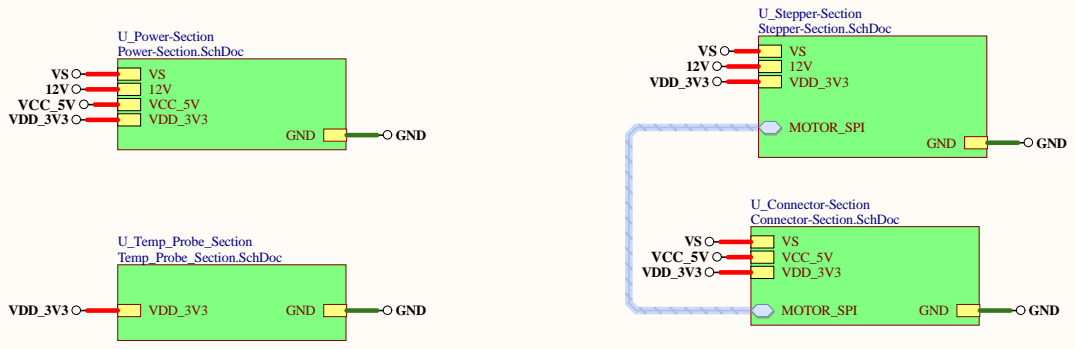
[picture p130: page 1]

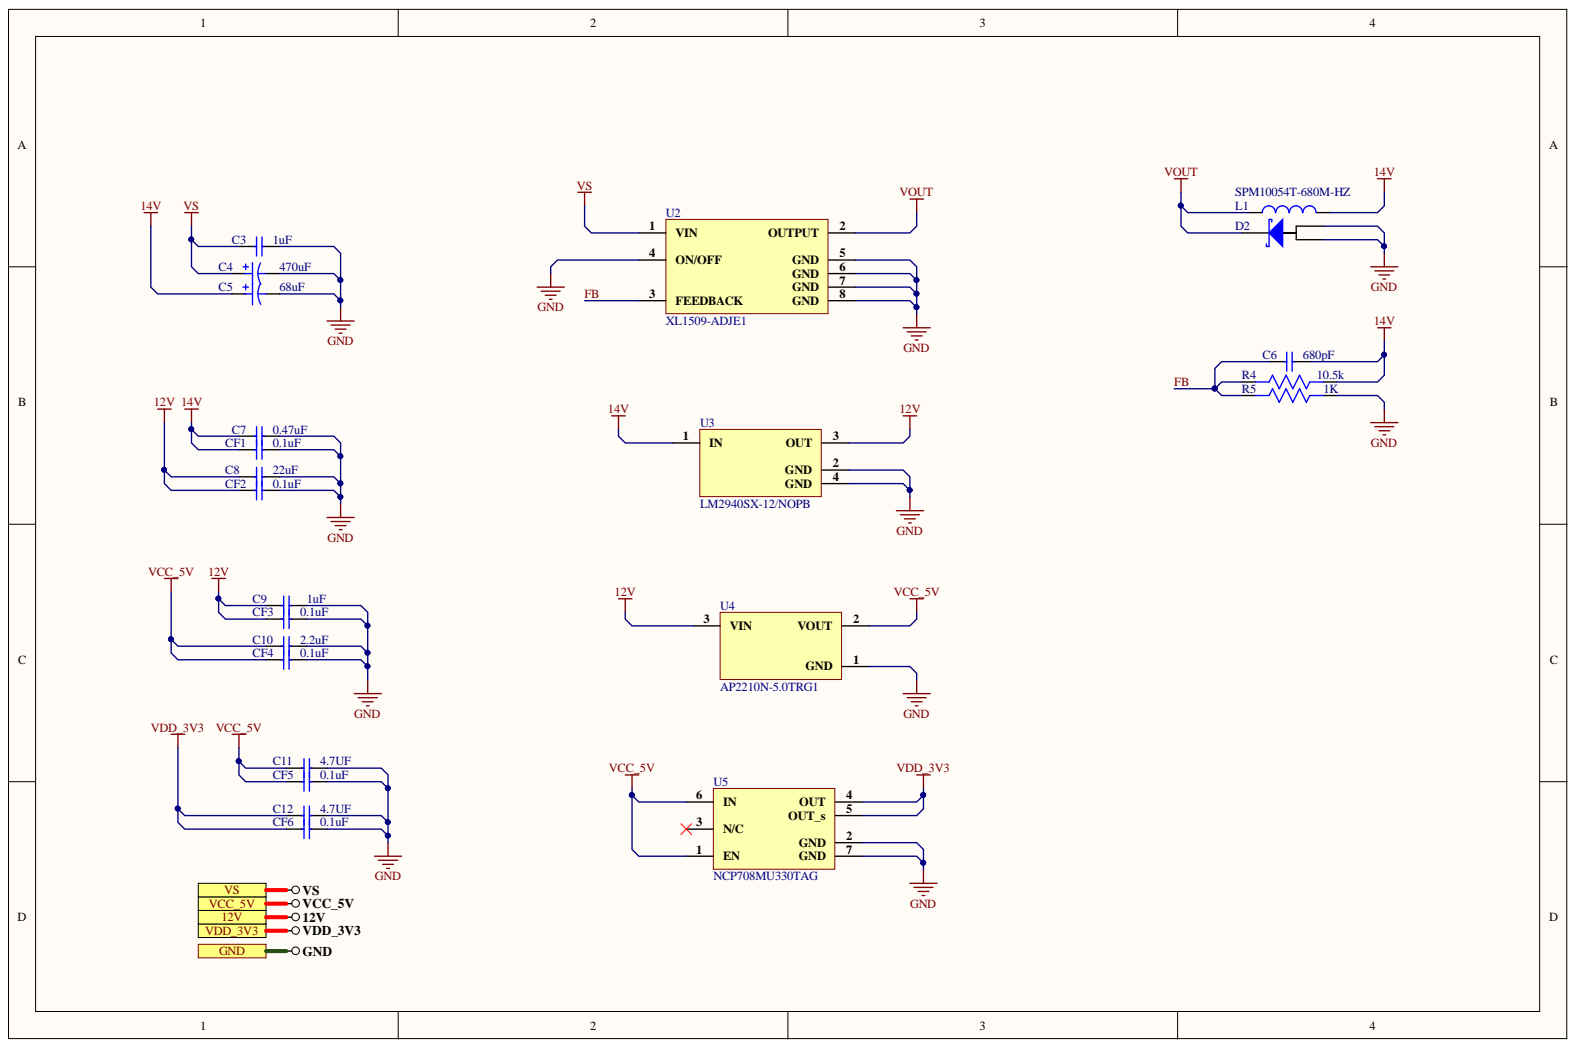
[picture p131: page 2]

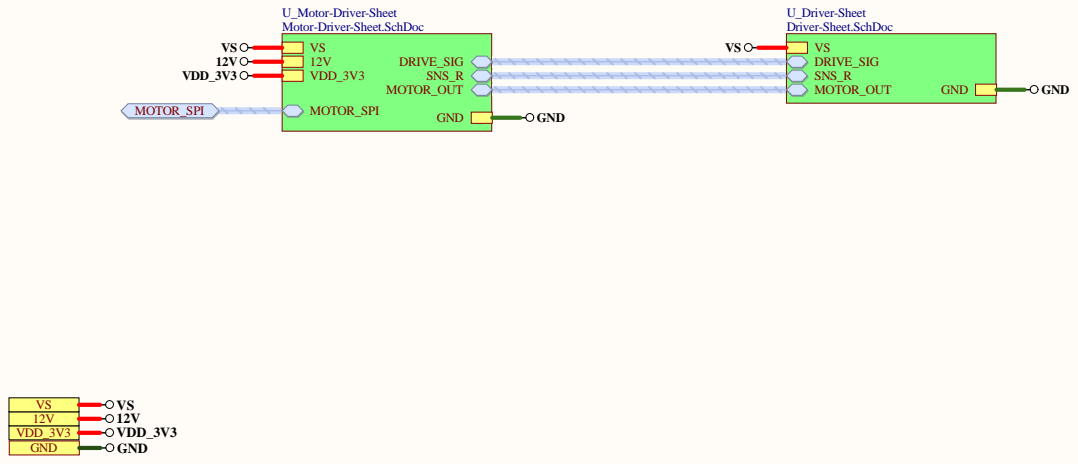
[picture p132: page 3]

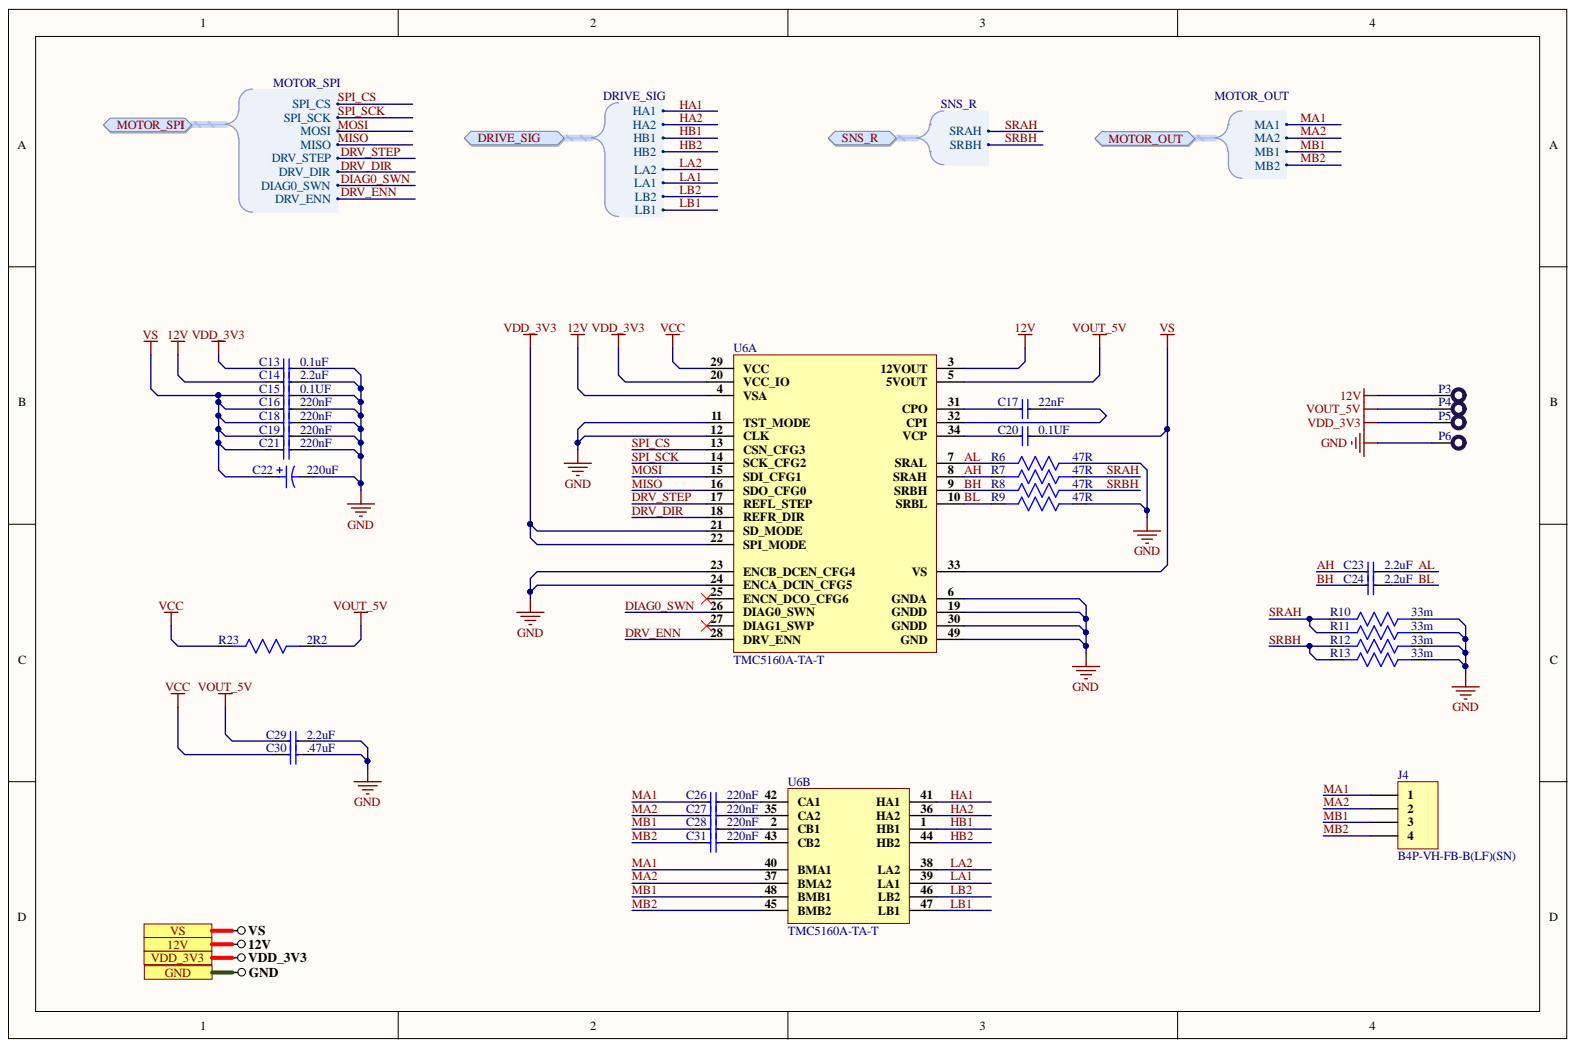
[picture p133: page 4]

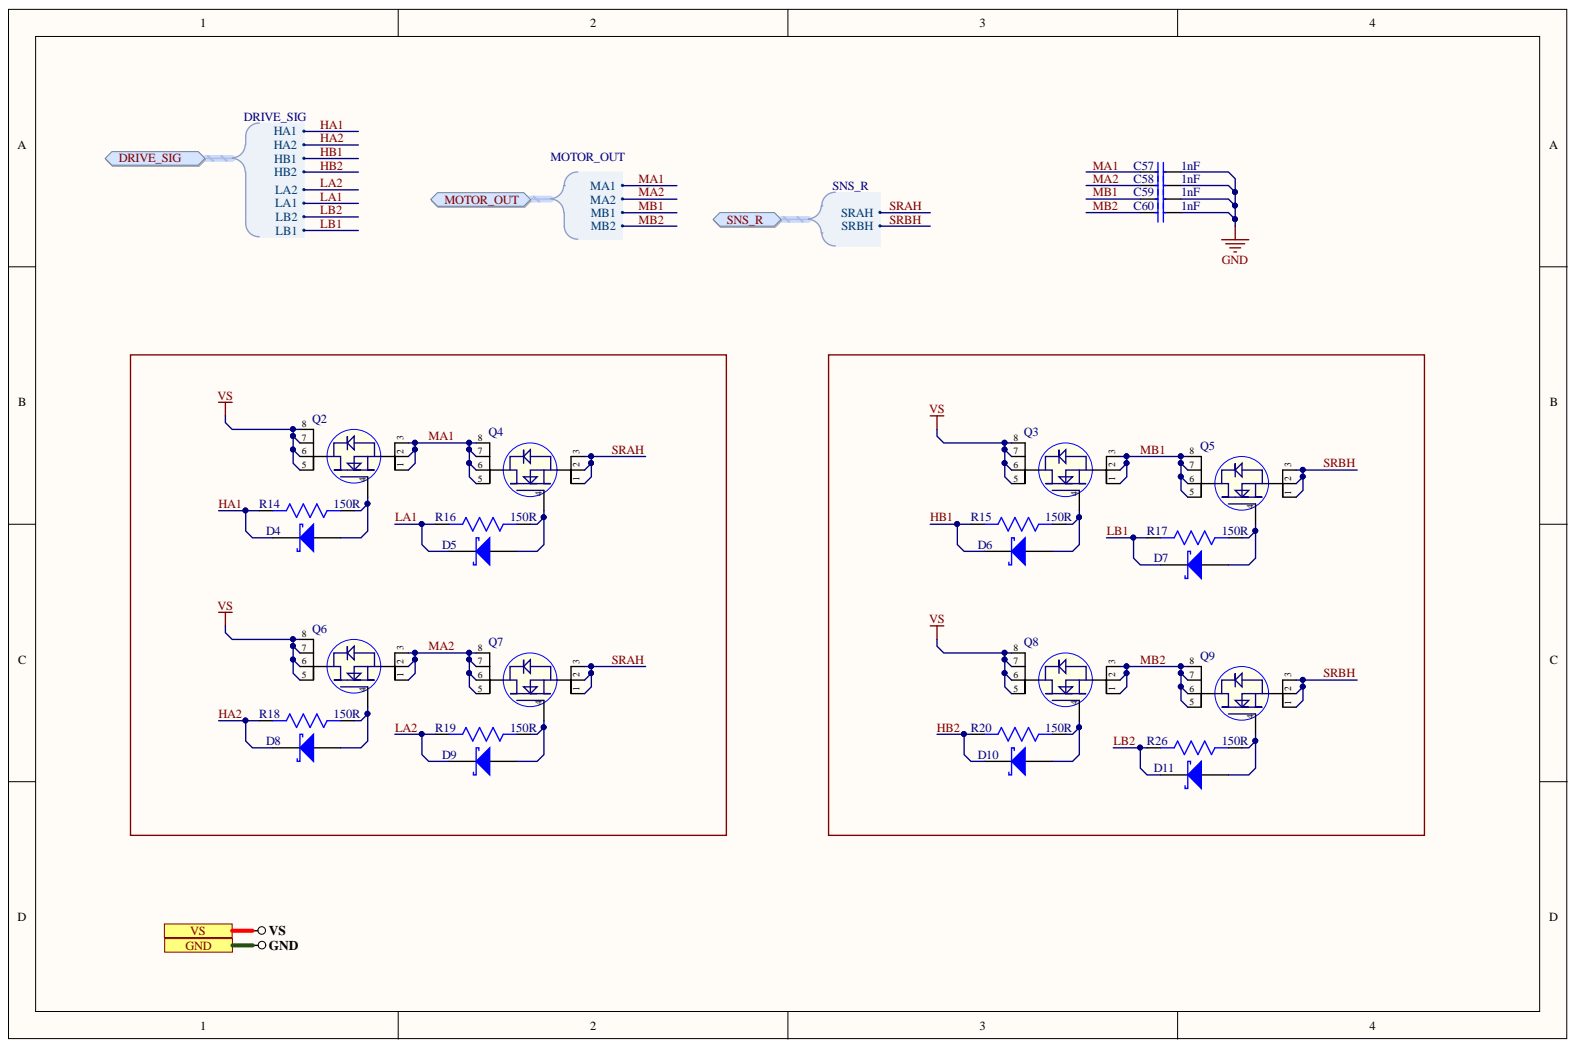
[picture p134: page 5]

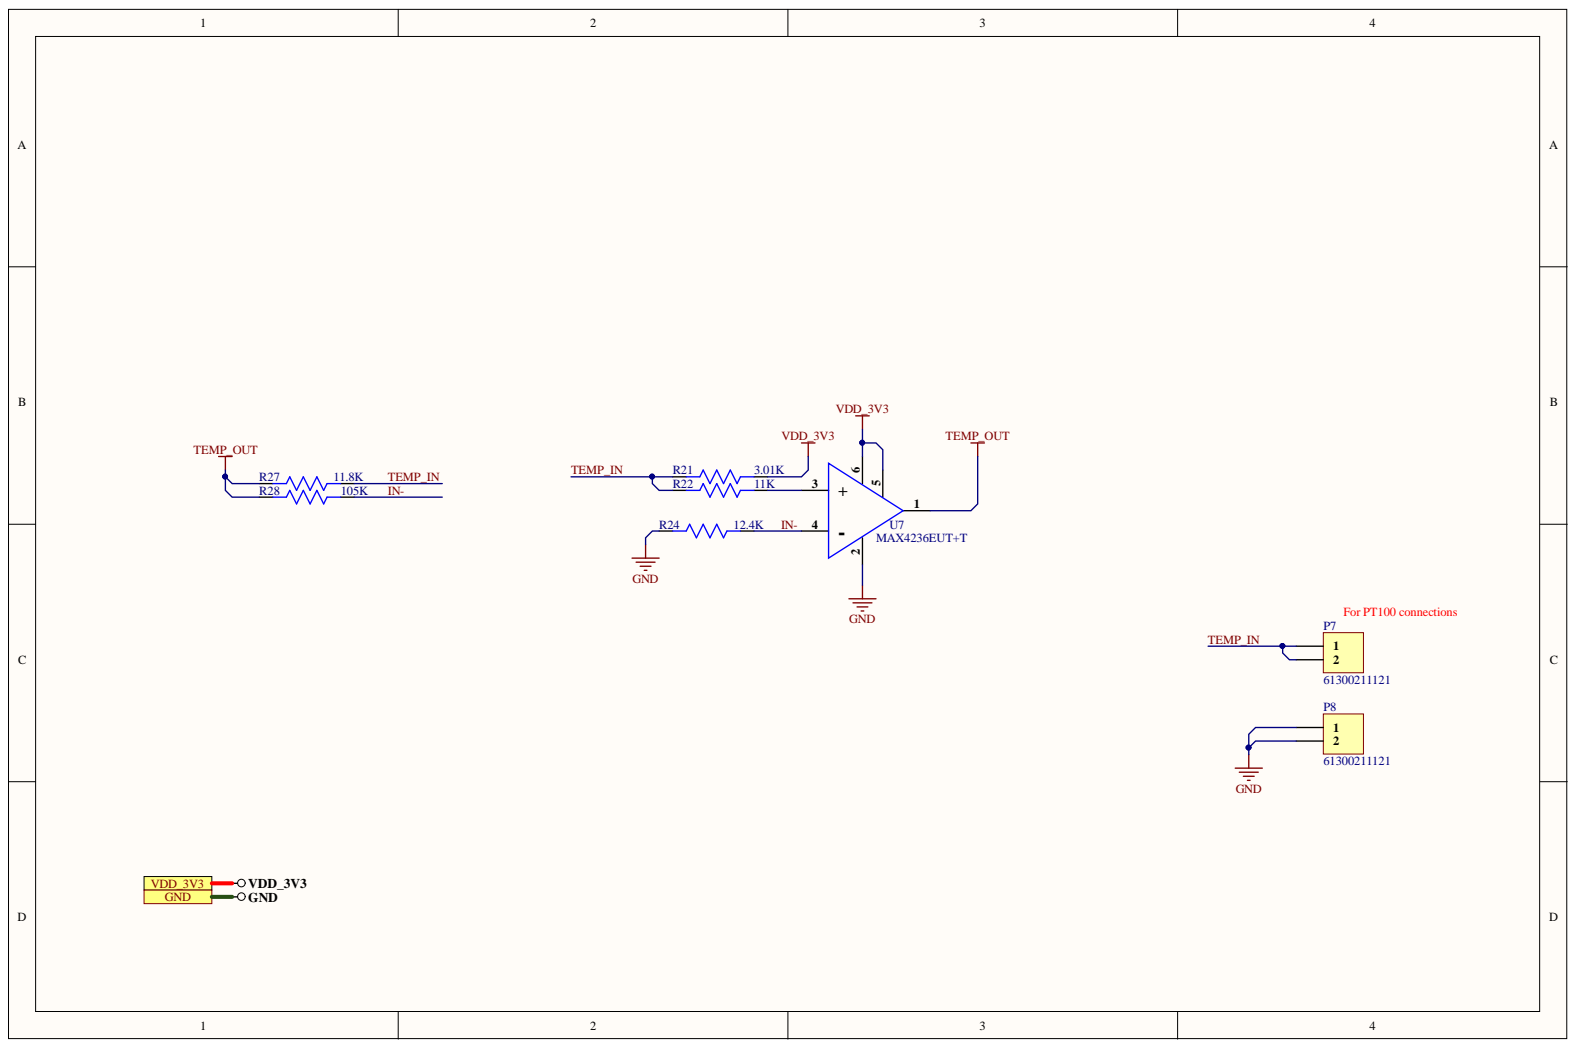
[picture p135: page 6]

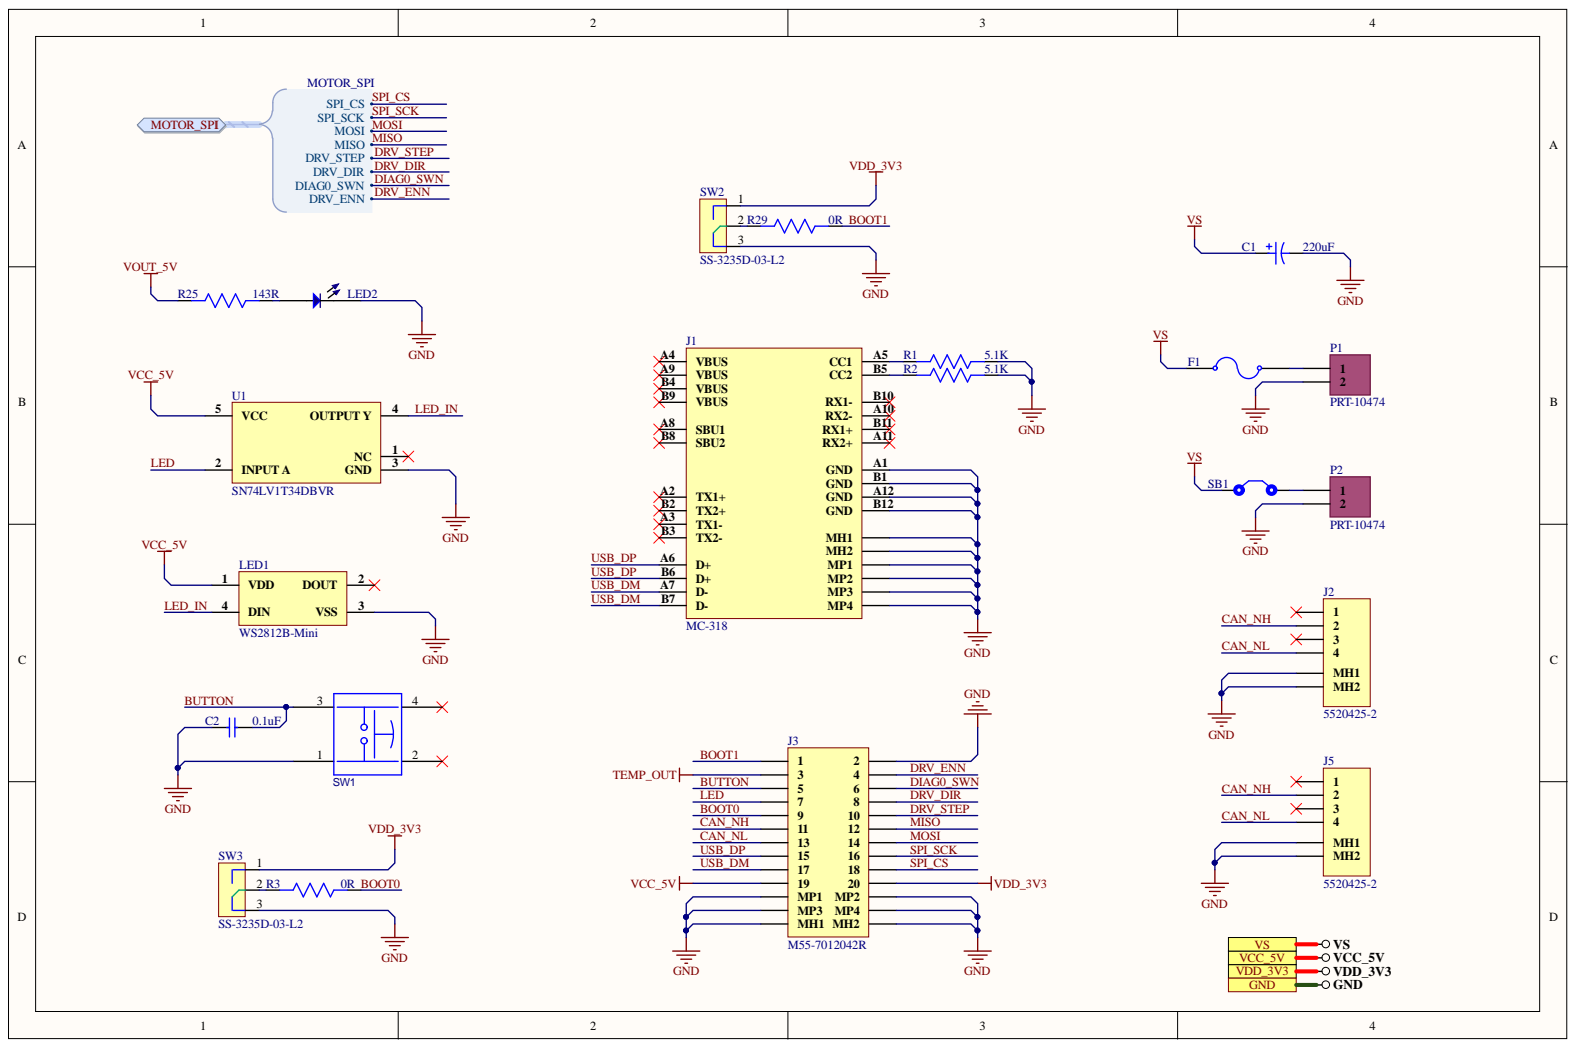
[picture p136: page 7]
