eSpark-Backup/colebenson-smartmotors/Documents/Client-Shared-Files/Review-17052021/PCB - review 2021-05-14.pdf

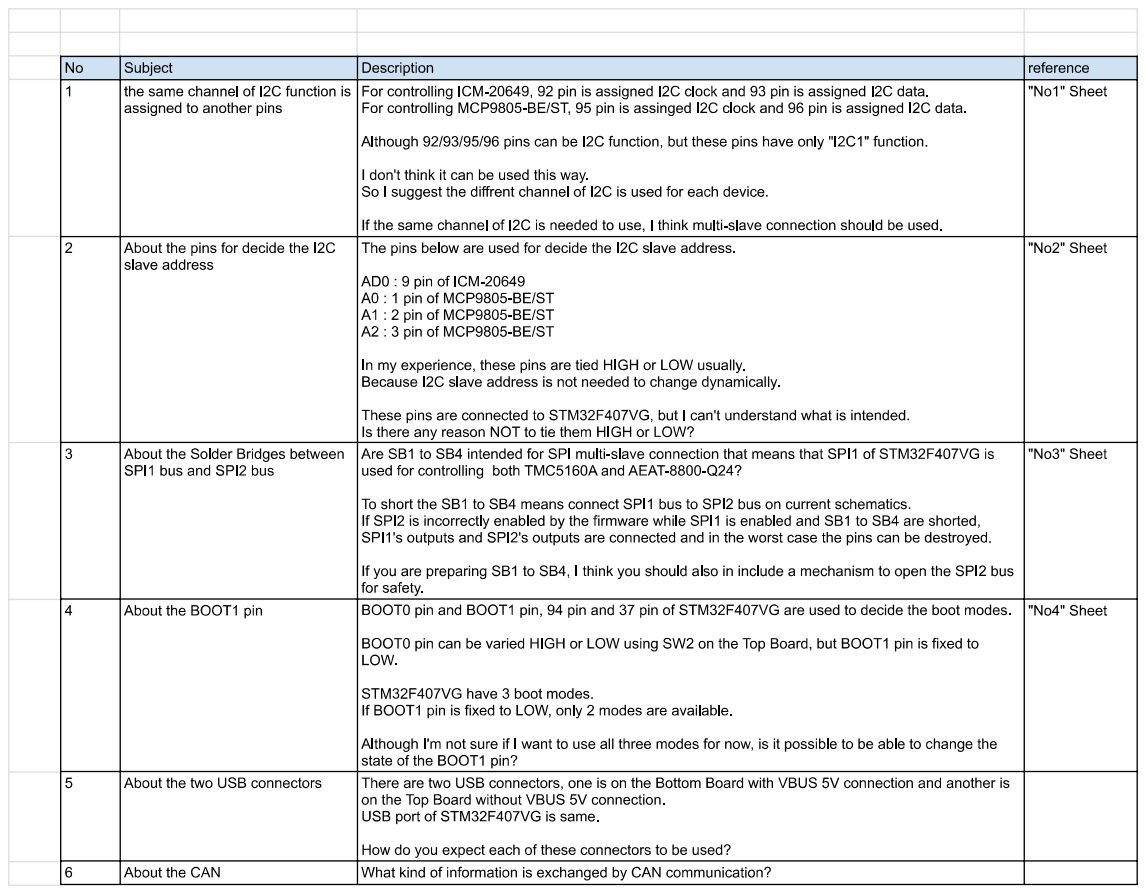
[picture p137: page 1]
