eSpark-Backup/colebenson-smartmotors/Documents/Client-Shared-Files/Sharing-04042021/JK42HS34-1334TK.pdf

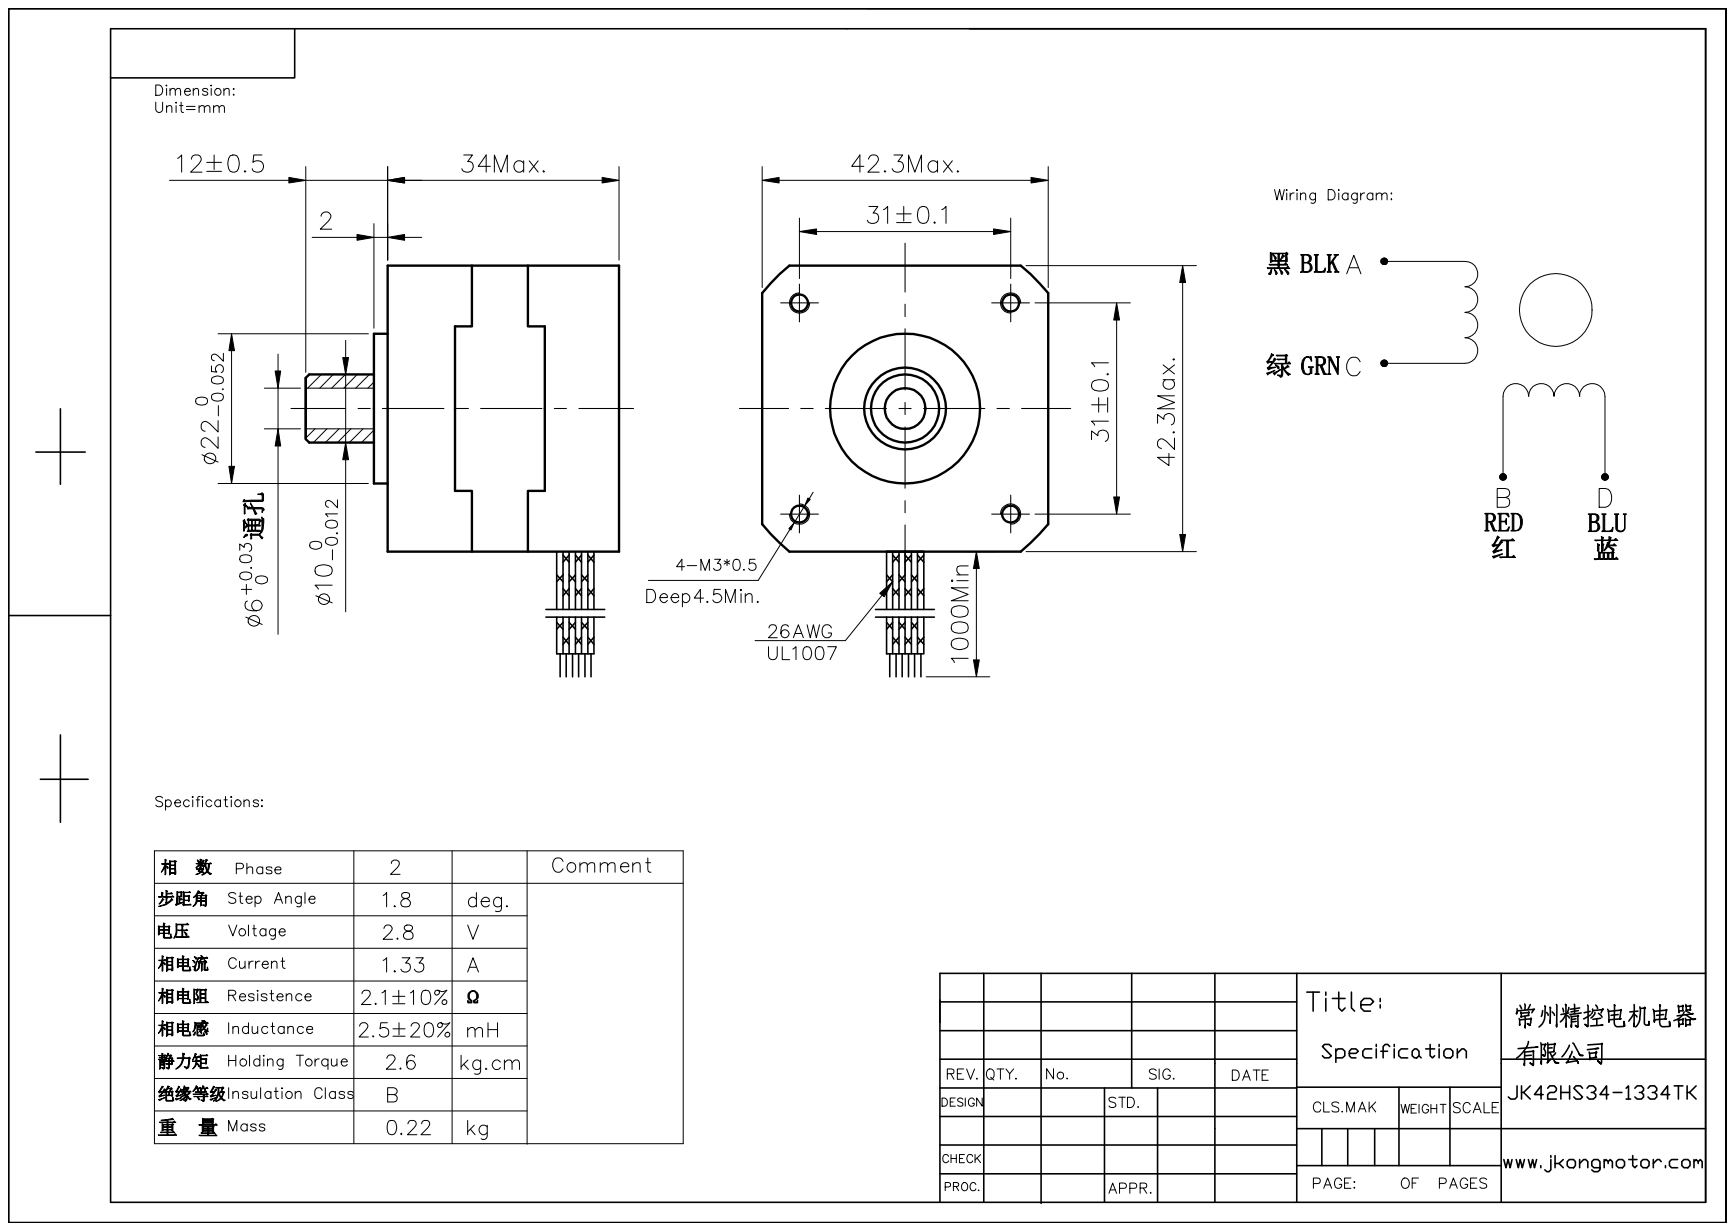
[picture p138: page 1]
