eSpark-Backup/colebenson-smartmotors/Documents/Client-Shared-Files/Sharing-04042021/JK86HS100-7004.pdf

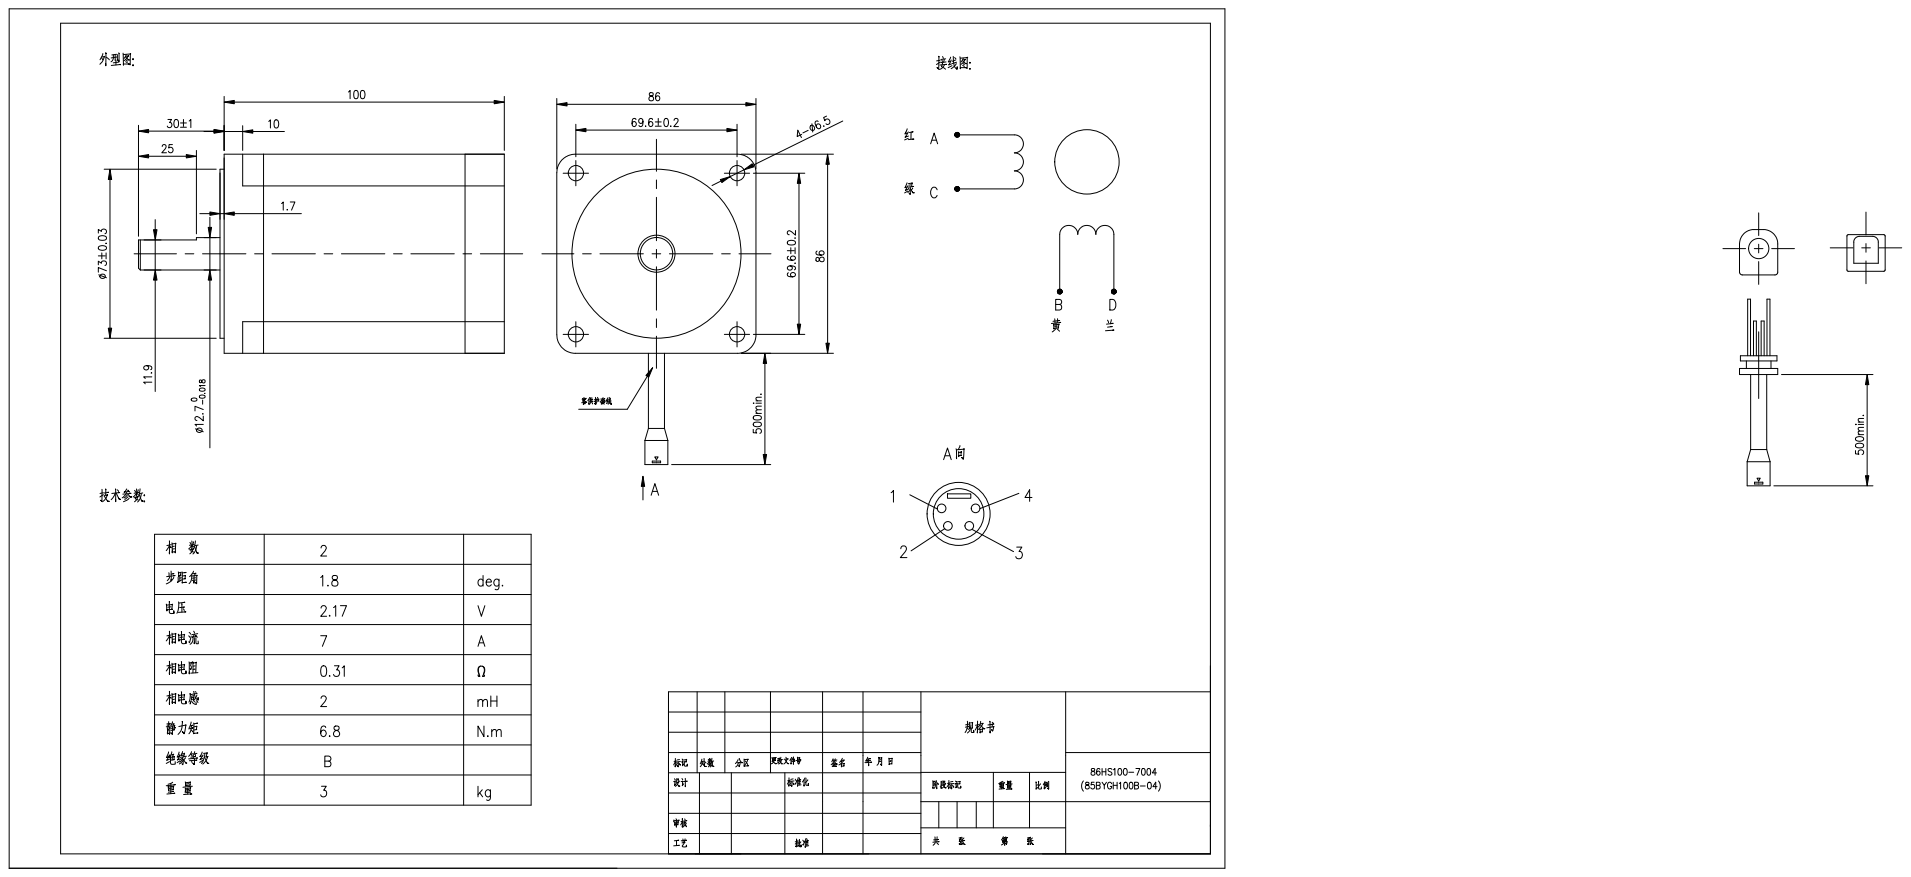
[picture p139: page 1]
