eSpark-Backup/colebenson-smartmotors/Design-Files/LSS_Bottom_Board_v3.4/Schematics/LSS_Bottom_Board_v3.4.pdf

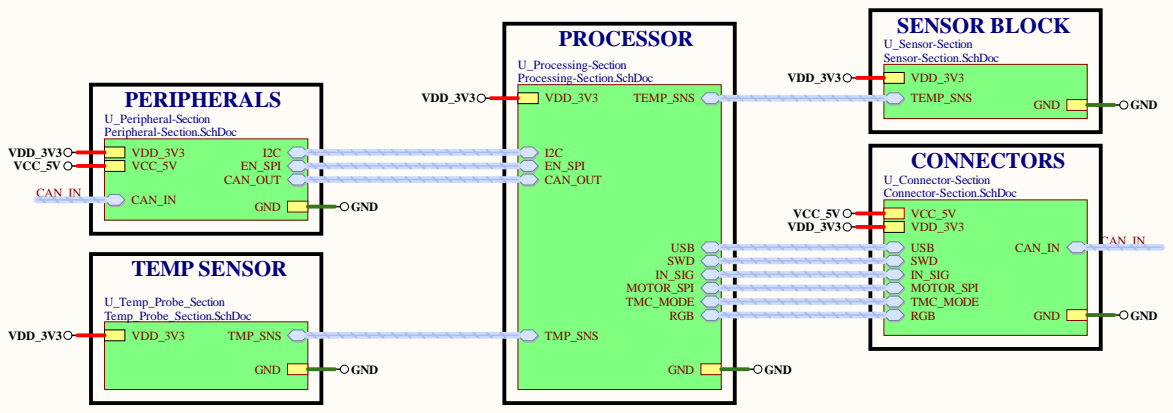
[picture p140: page 1]

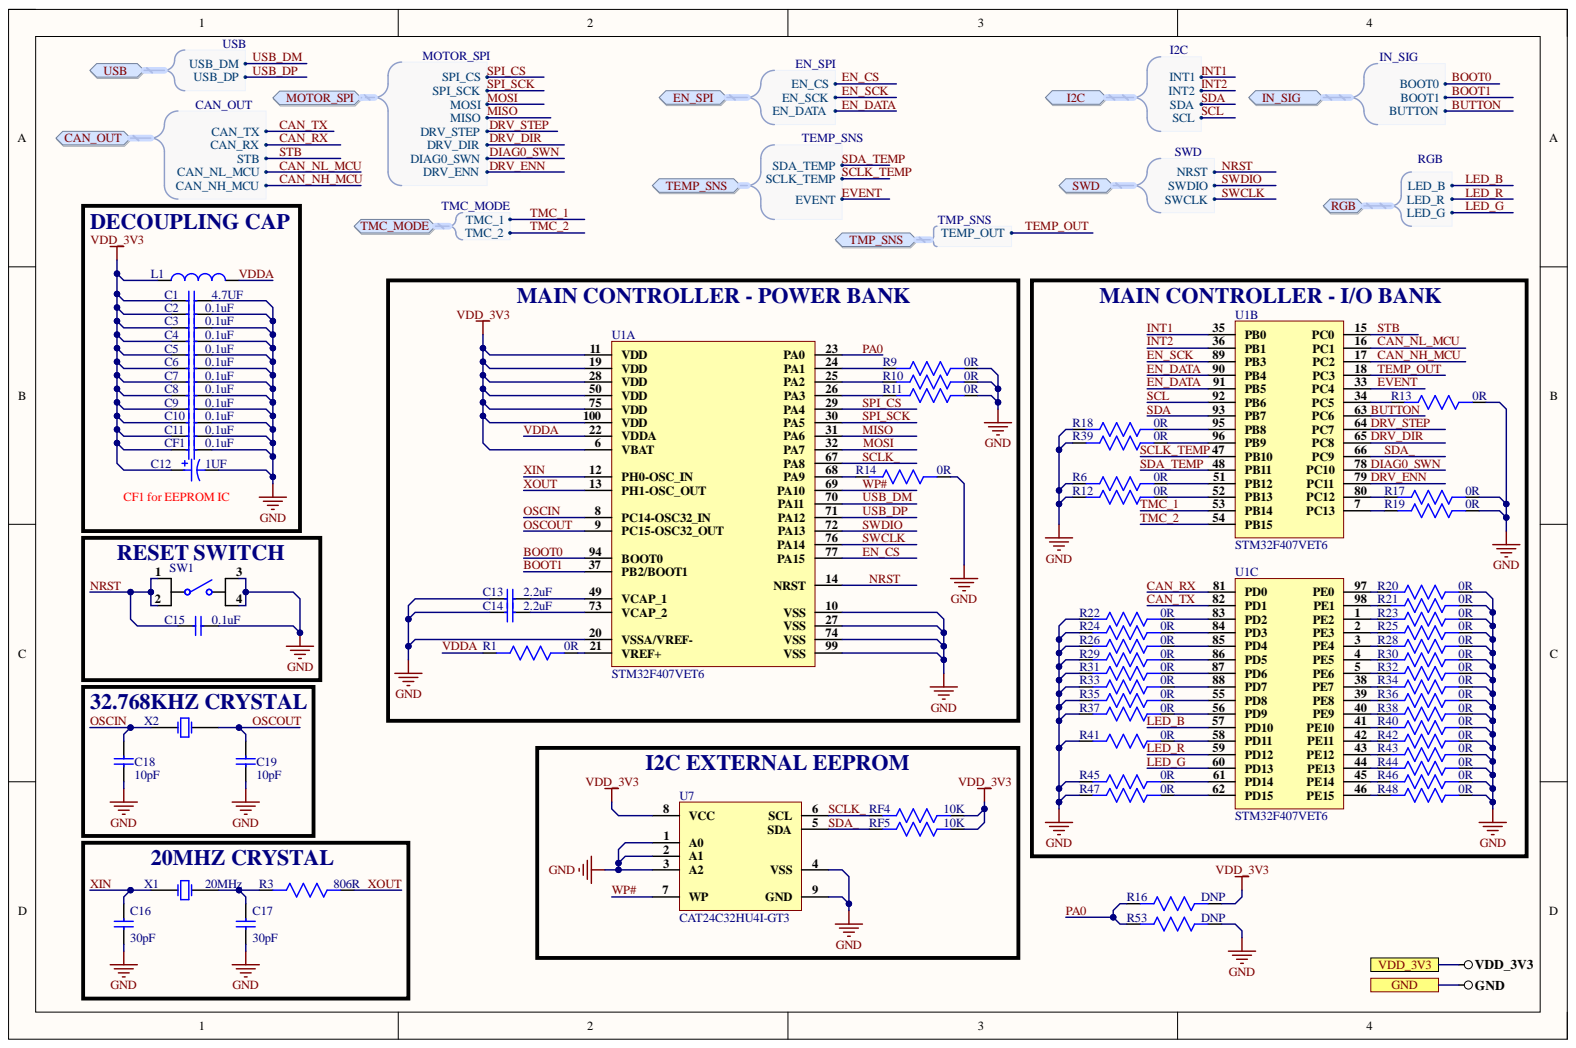
[picture p141: page 2]

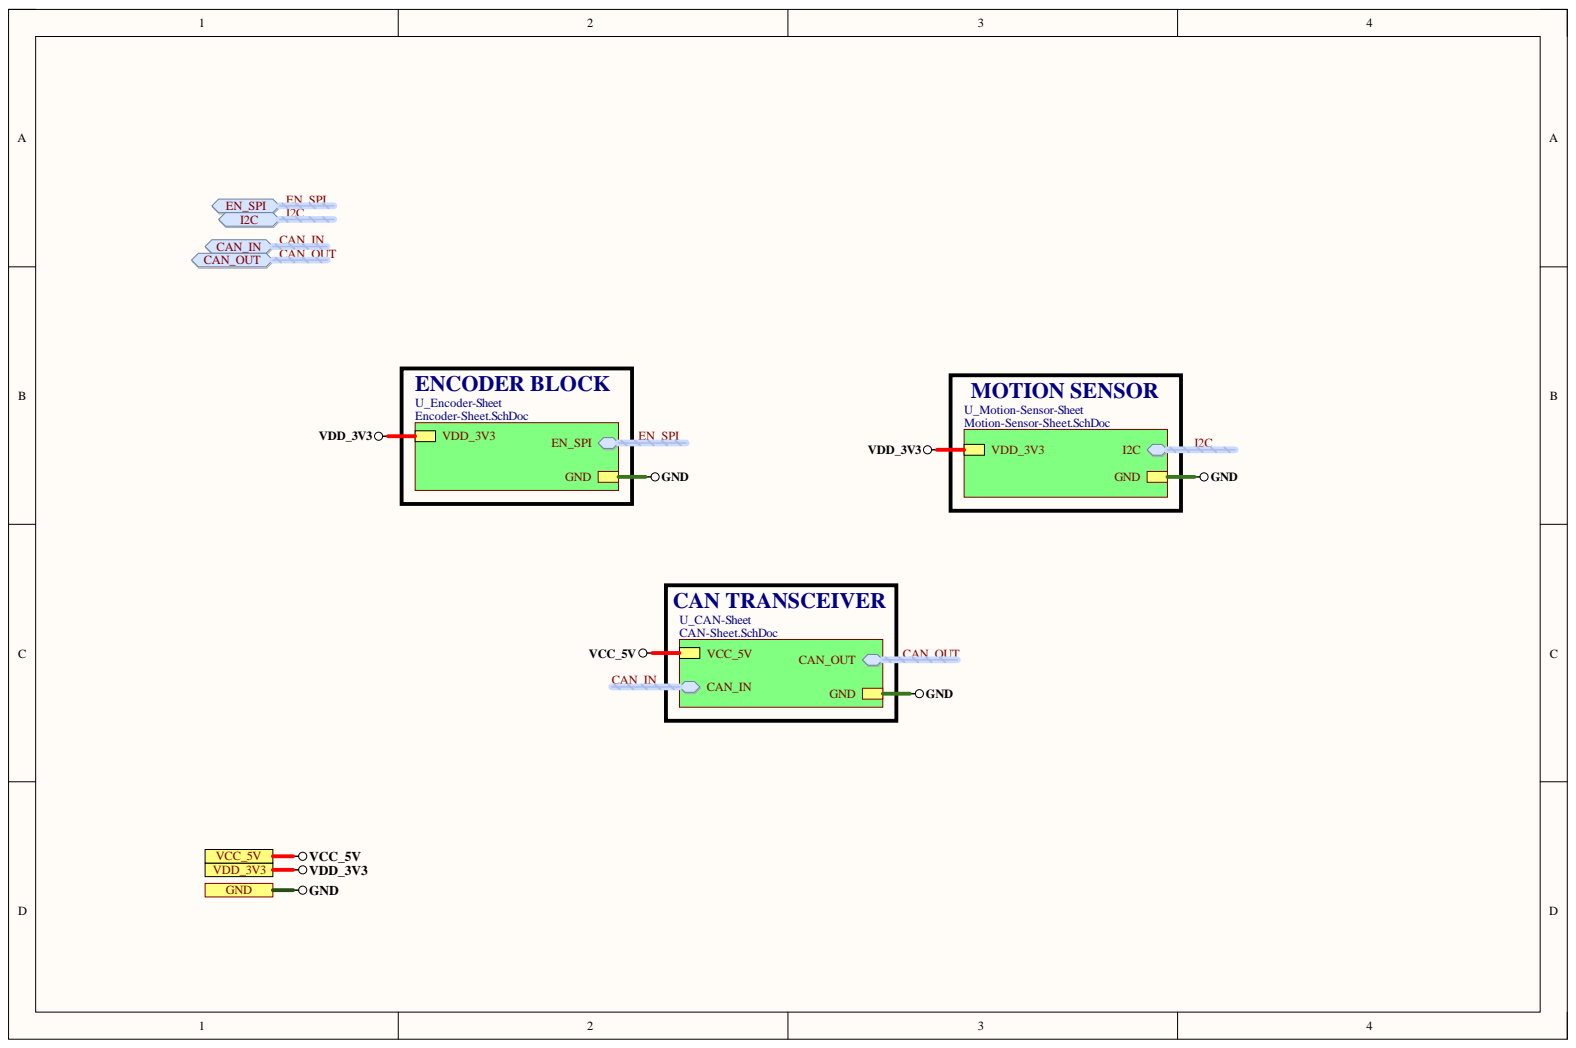
[picture p142: page 3]

U_Motion-Sensor-Sheet
Motion-Sensor-Sheet.SchDoc

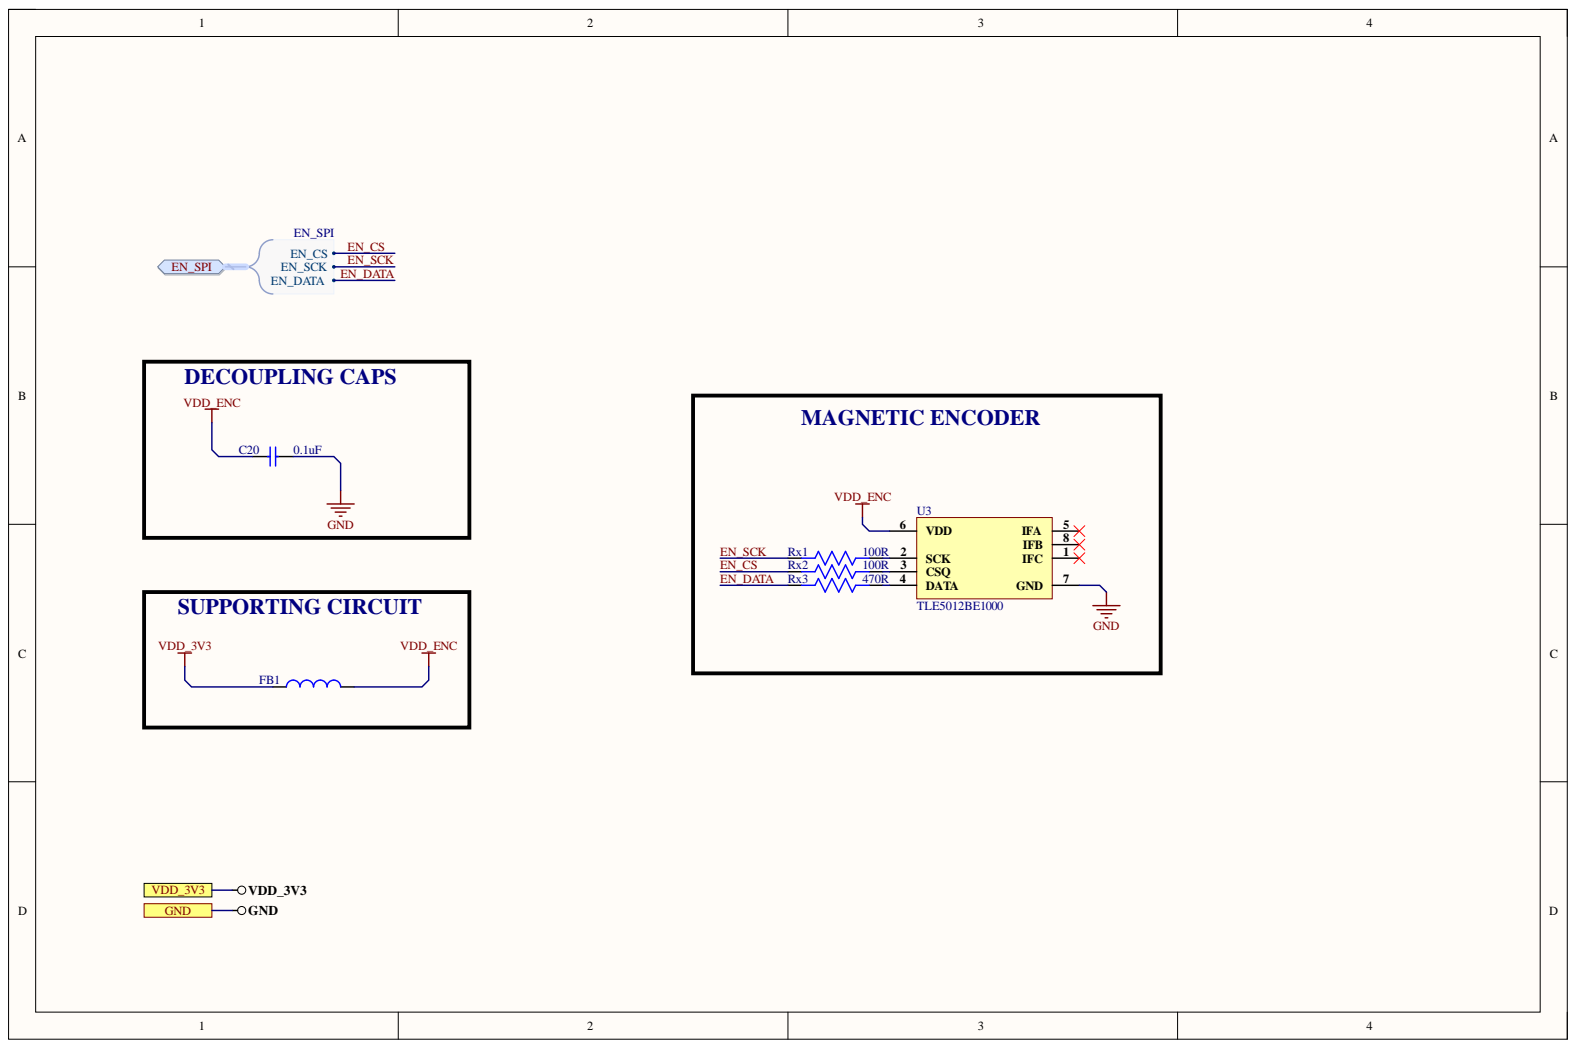
[picture p143: page 4]

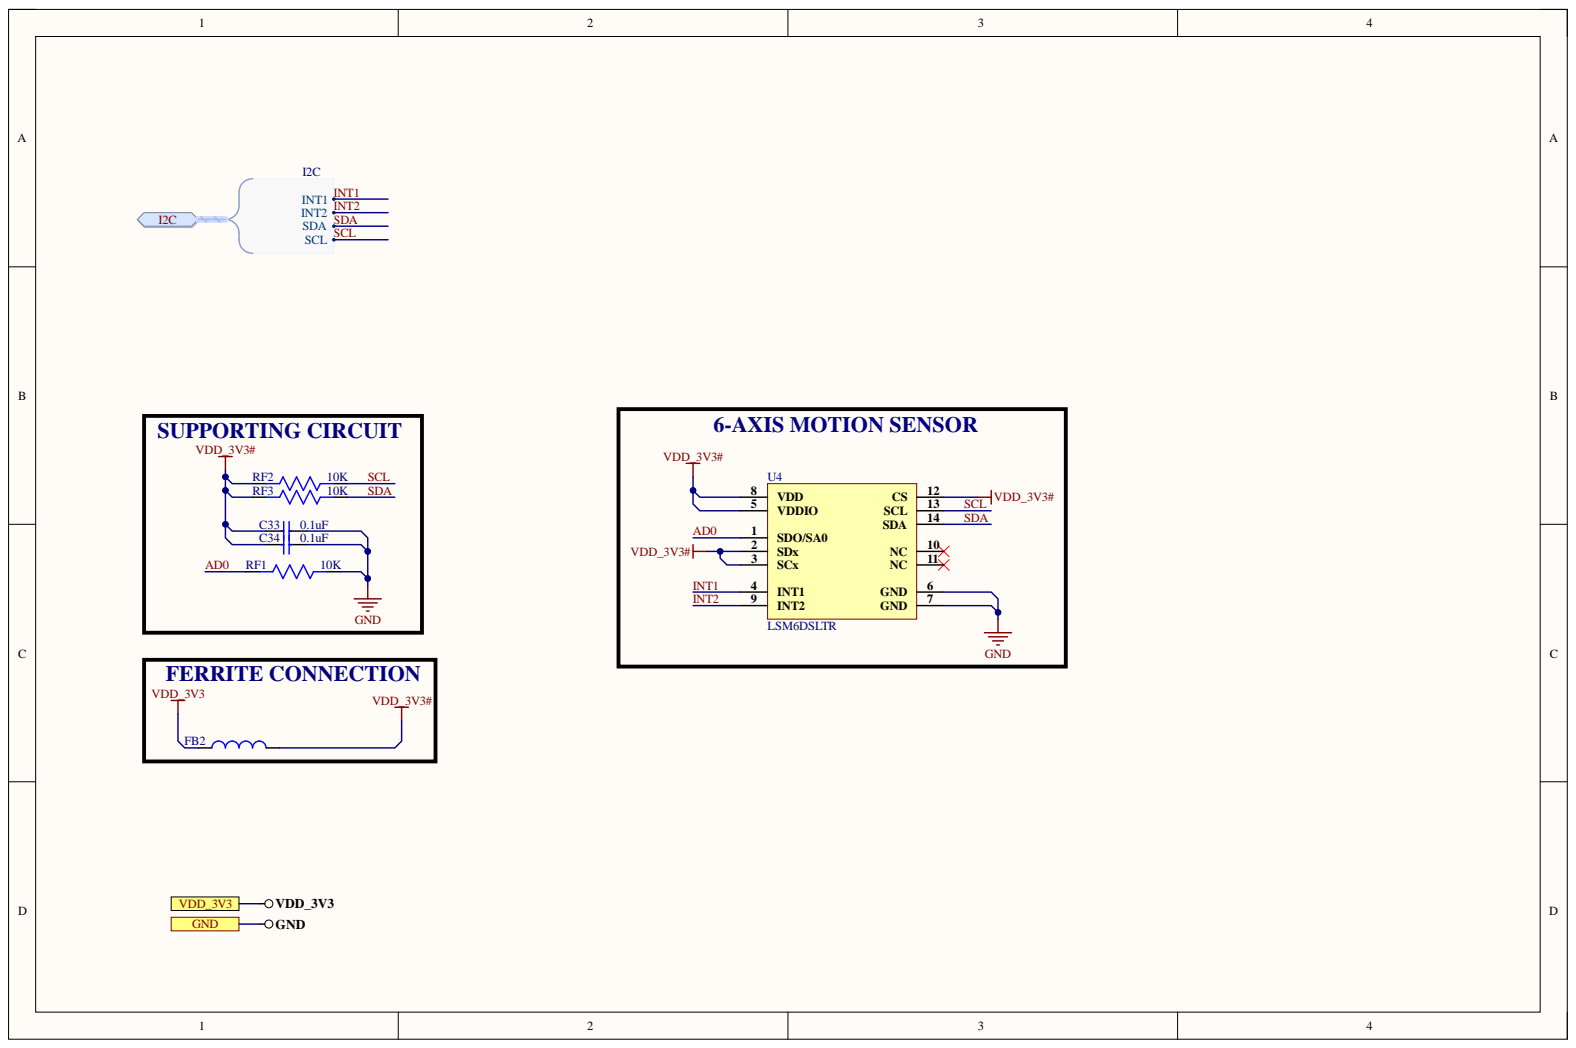
[picture p144: page 5]

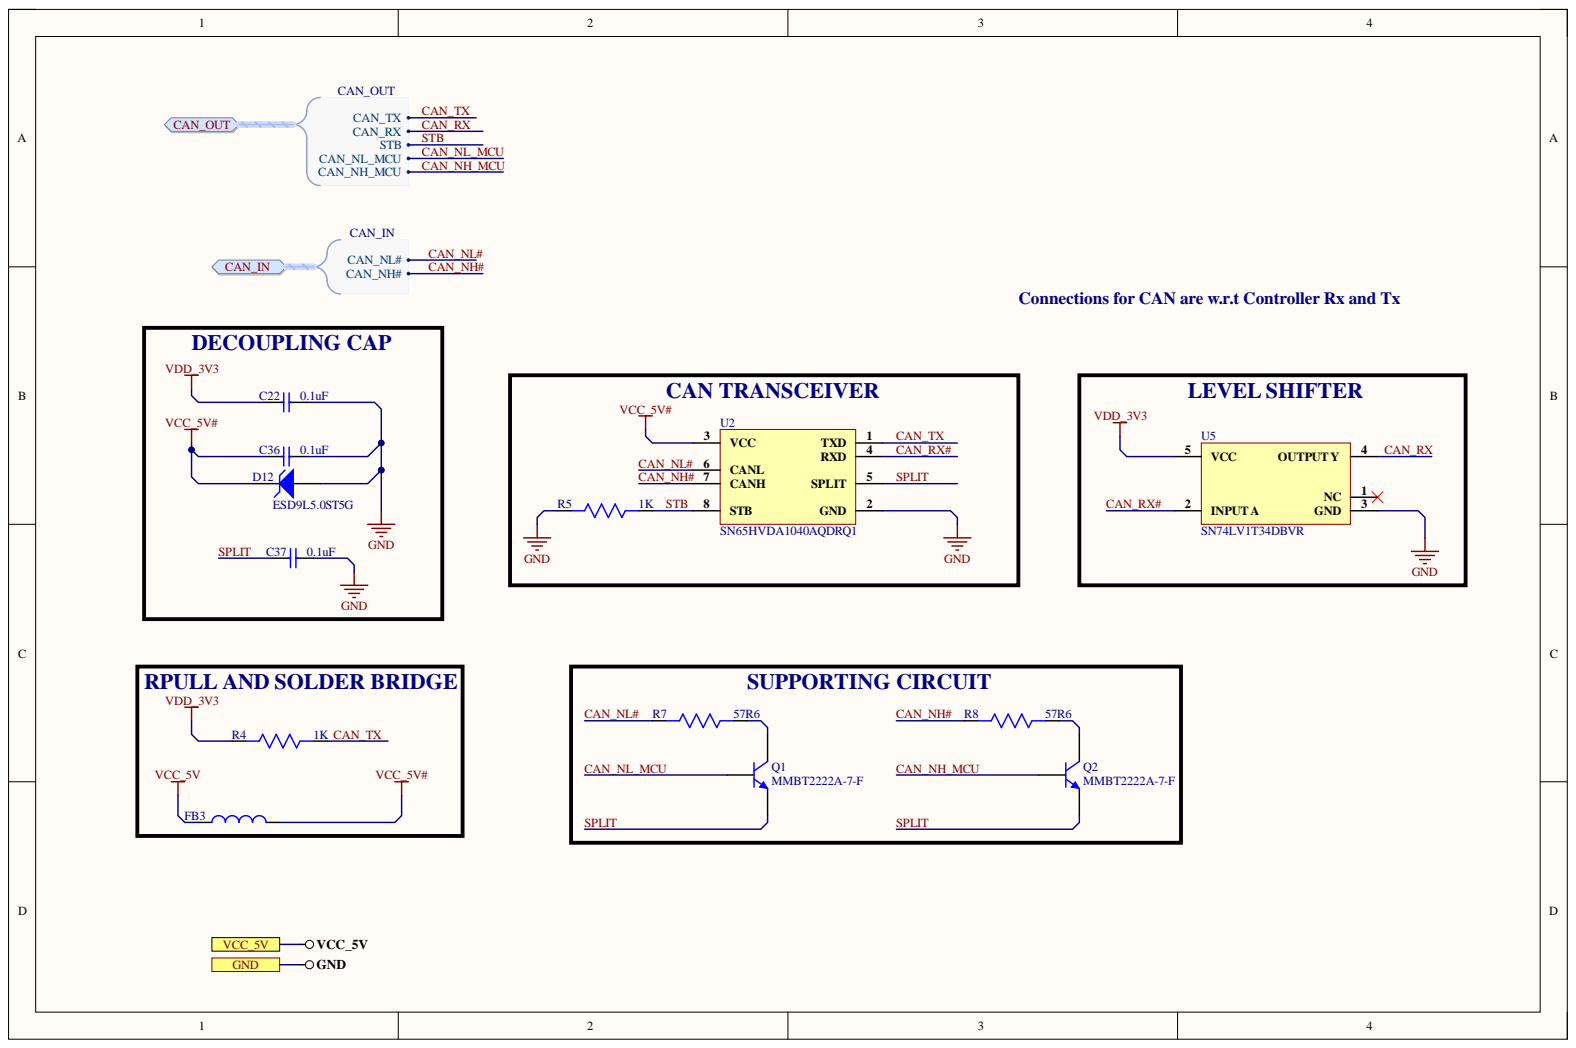
[picture p145: page 6]

Connections for CAN are w.r.t Controller Rx and Tx

RPULL AND SOLDER BRIDGE

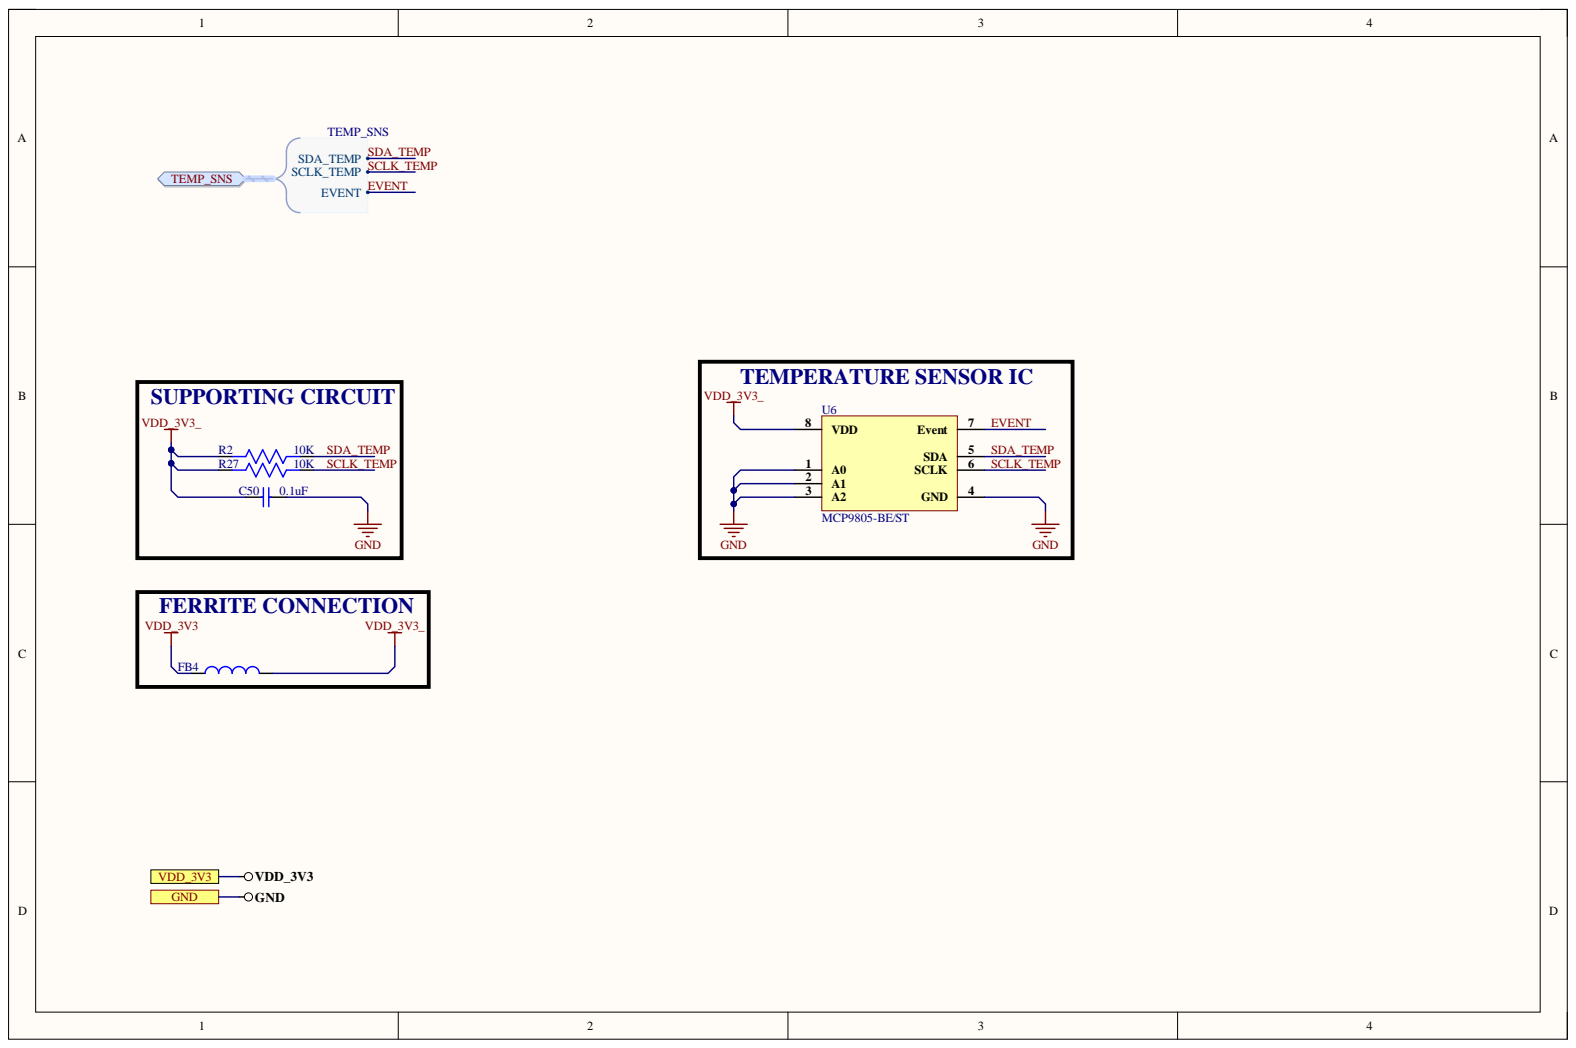
[picture p146: page 7]

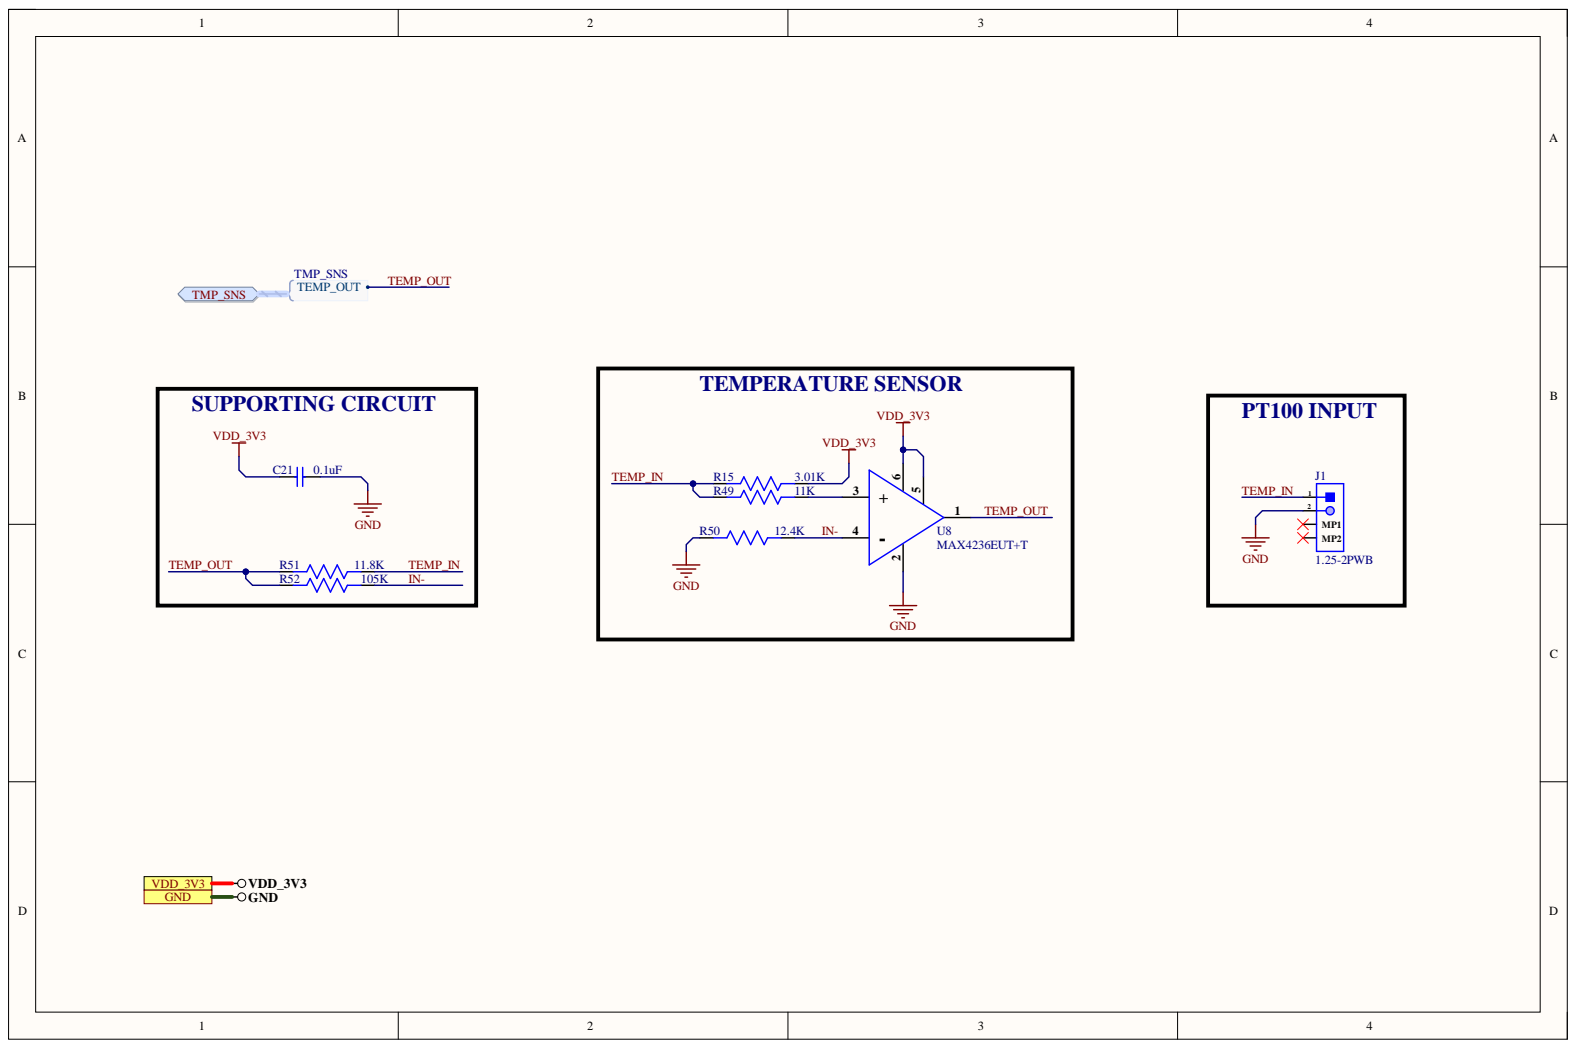
[picture p147: page 8]

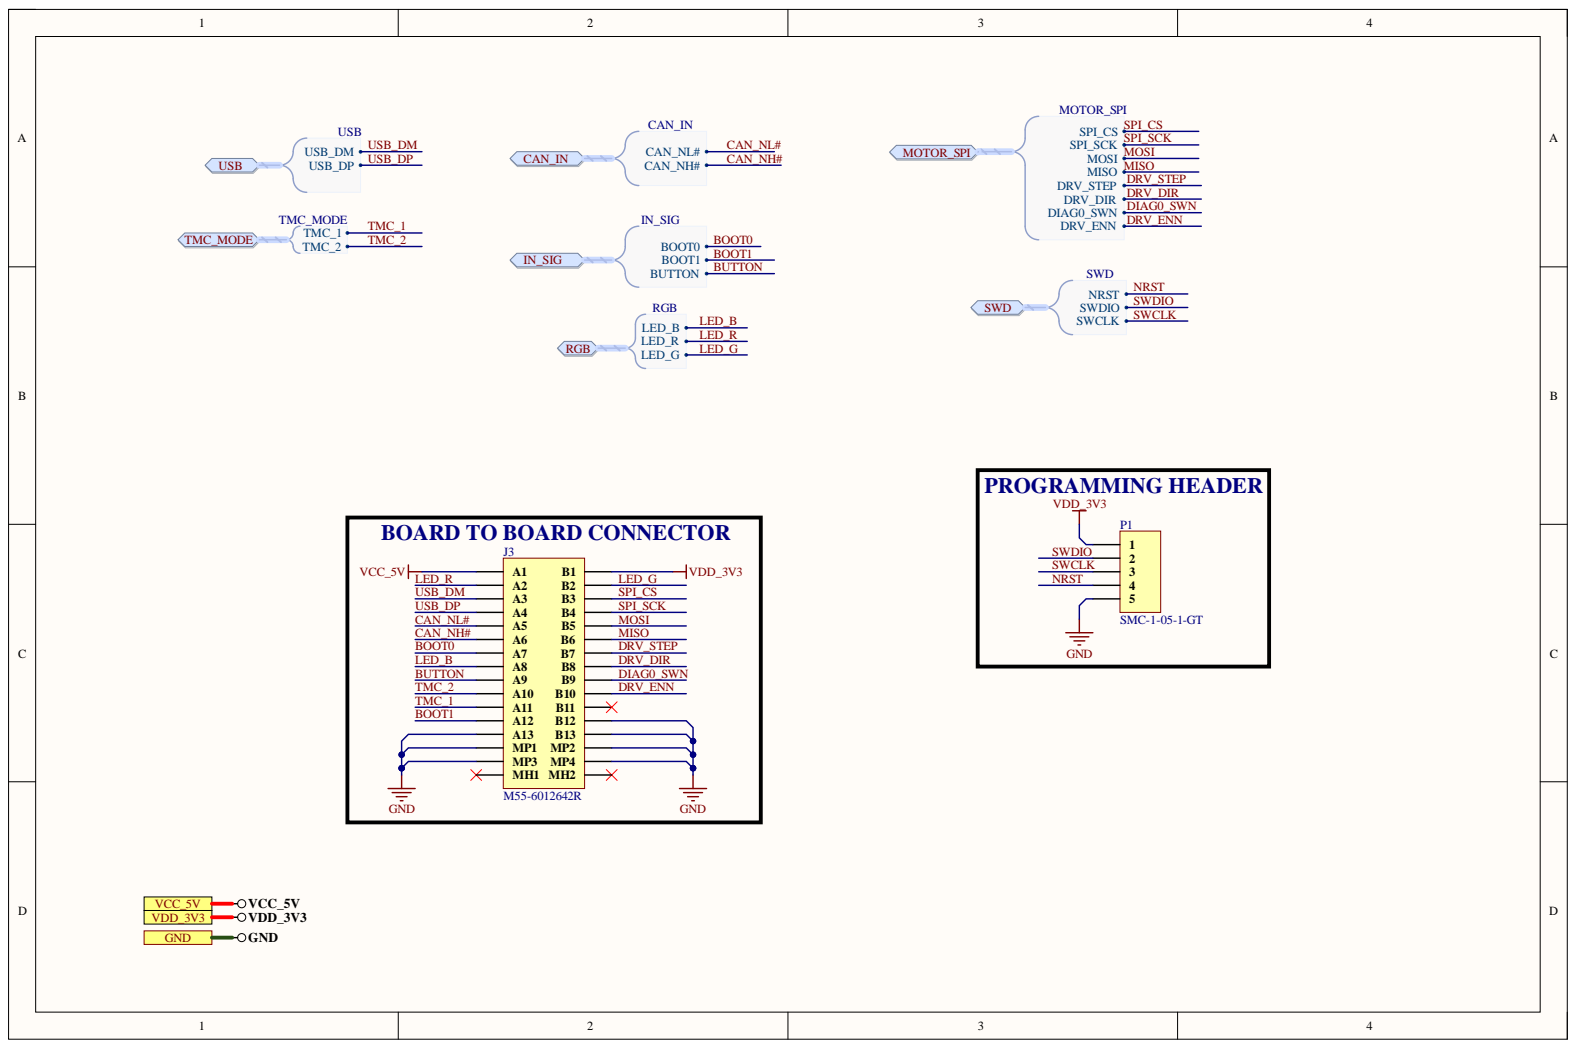
[picture p148: page 9]

BOARD TO BOARD CONNECTOR
