eSpark-Backup/colebenson-smartmotors/Design-Files/LSS_Top_Board_v3.4/Schematics/LSS_Top_Board_v3.4.pdf

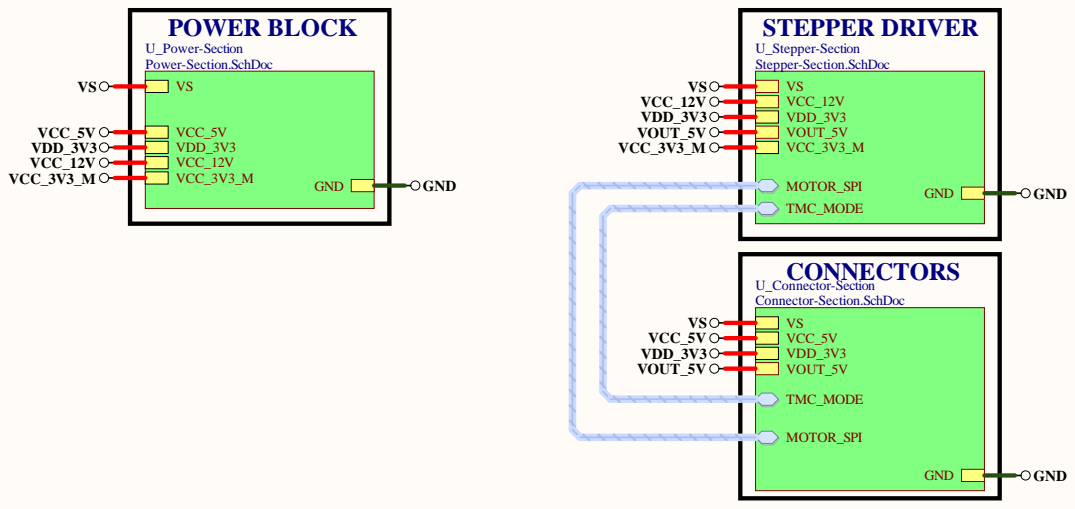
[picture p149: page 1]

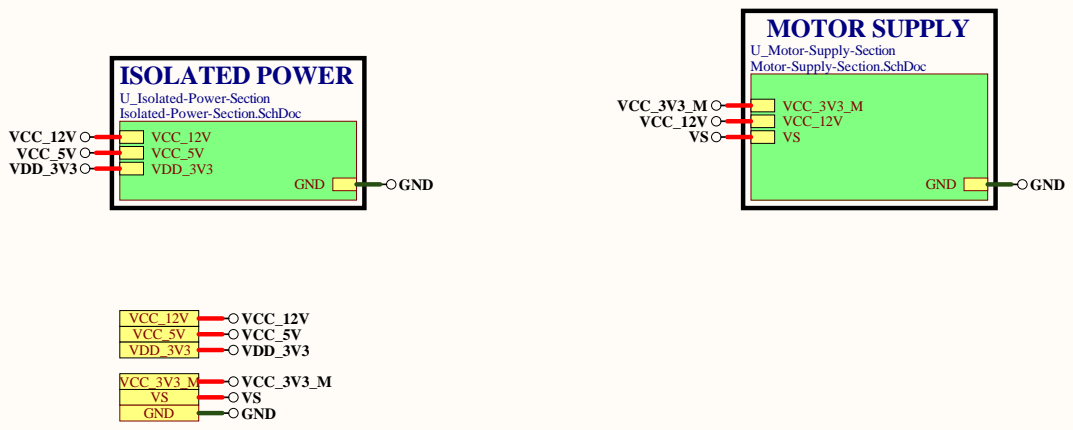
[picture p150: page 2]

U_Motor-Supply-Section
Motor-Supply-Section.SchDoc

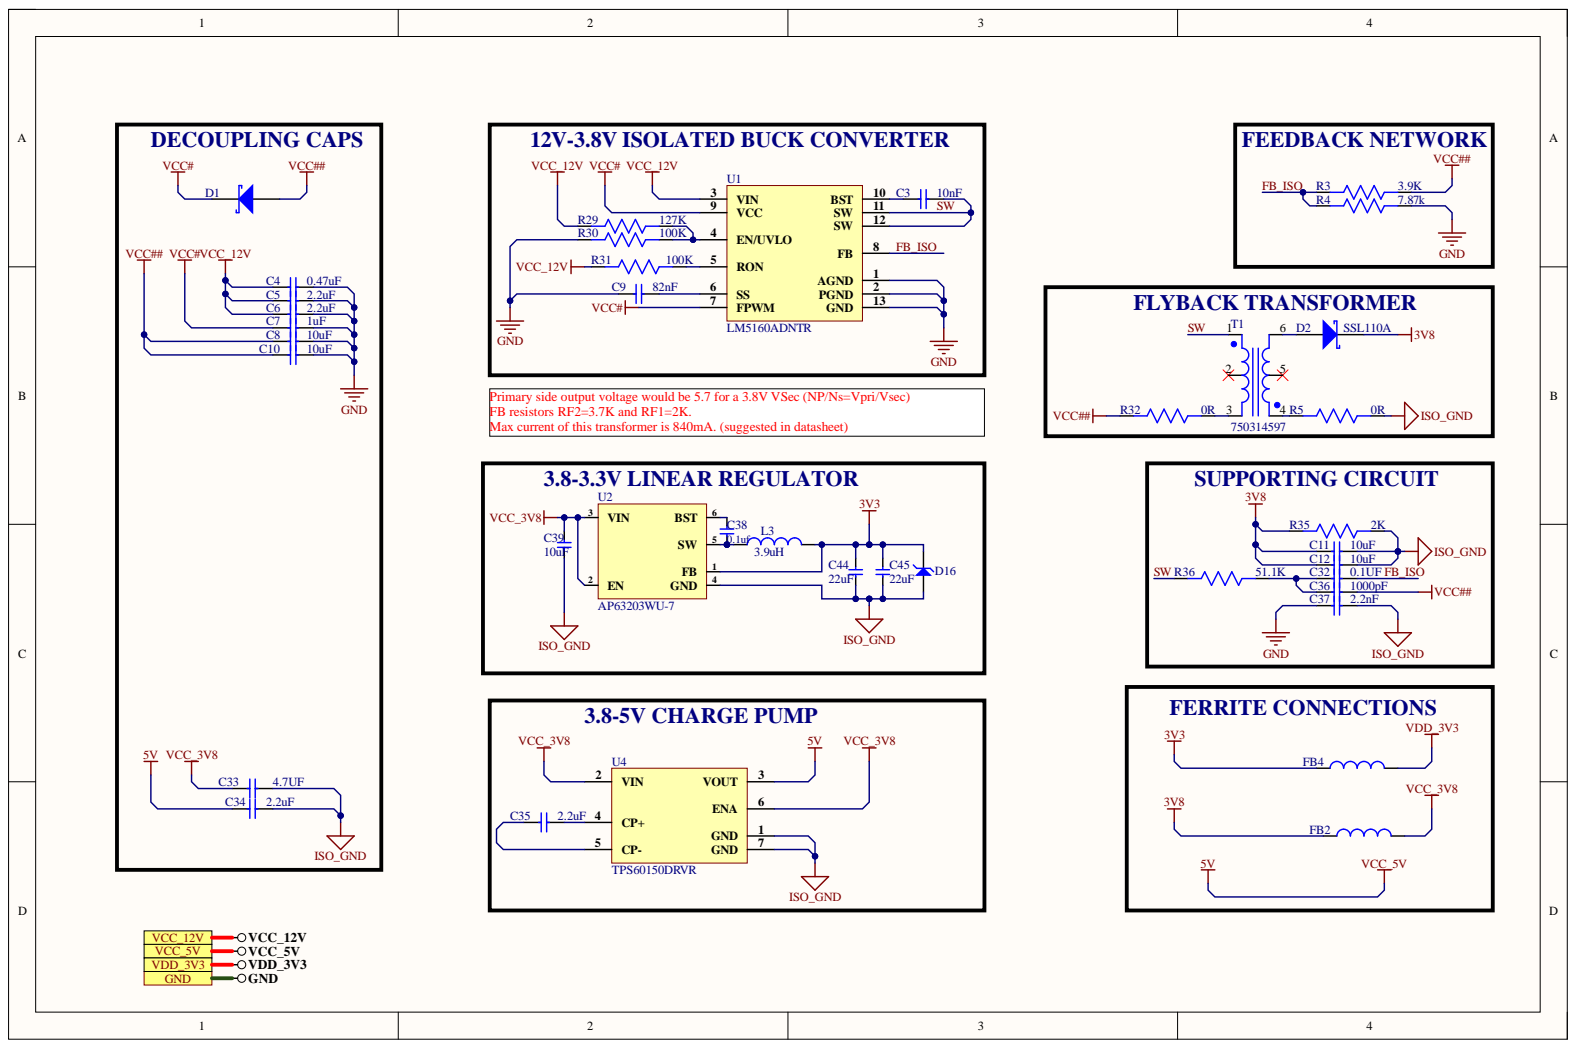
[picture p151: page 3]

Primary side output voltage would be 5.7 for a 3.8V VSec (NP/Ns=Vpri/Vsec)
FB resistors RF2=3.7K and RF1=2K.

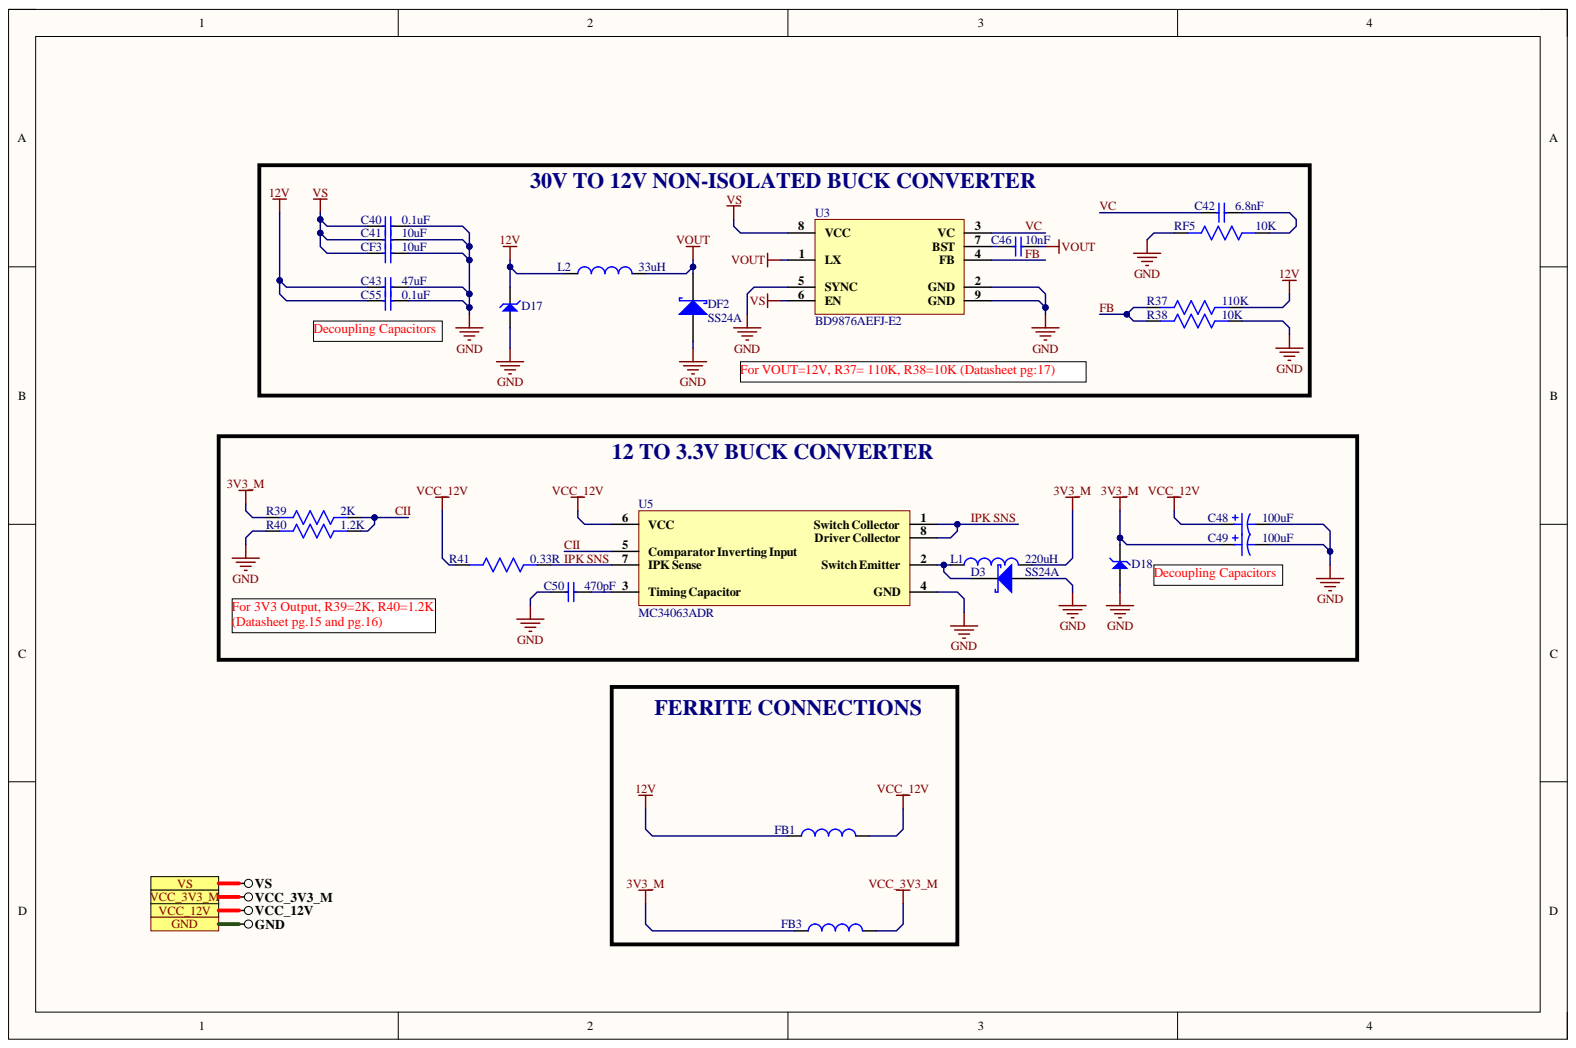
[picture p152: page 4]

30V TO 12V NON-ISOLATED BUCK CONVERTER

For VOUT=12V, R37= 110K, R38=10K (Datasheet pg:17)

For 3V3 Output, R39=2K, R40=1.2K
(Datasheet pg.15 and pg.16)

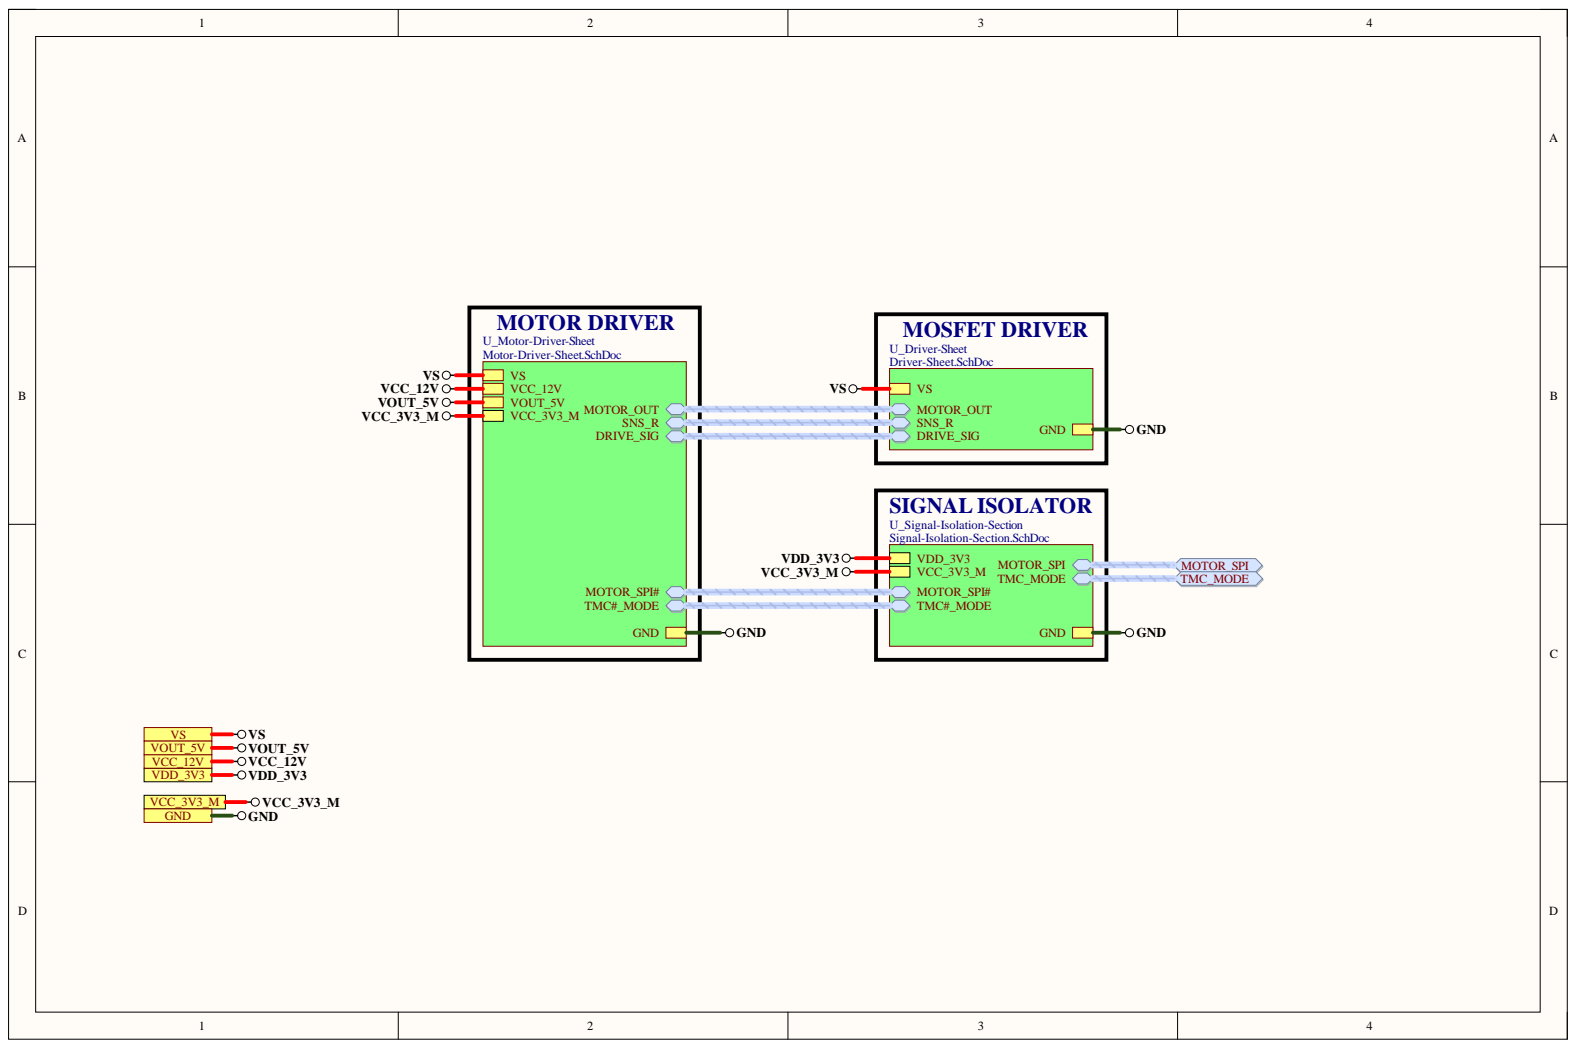
[picture p153: page 5]

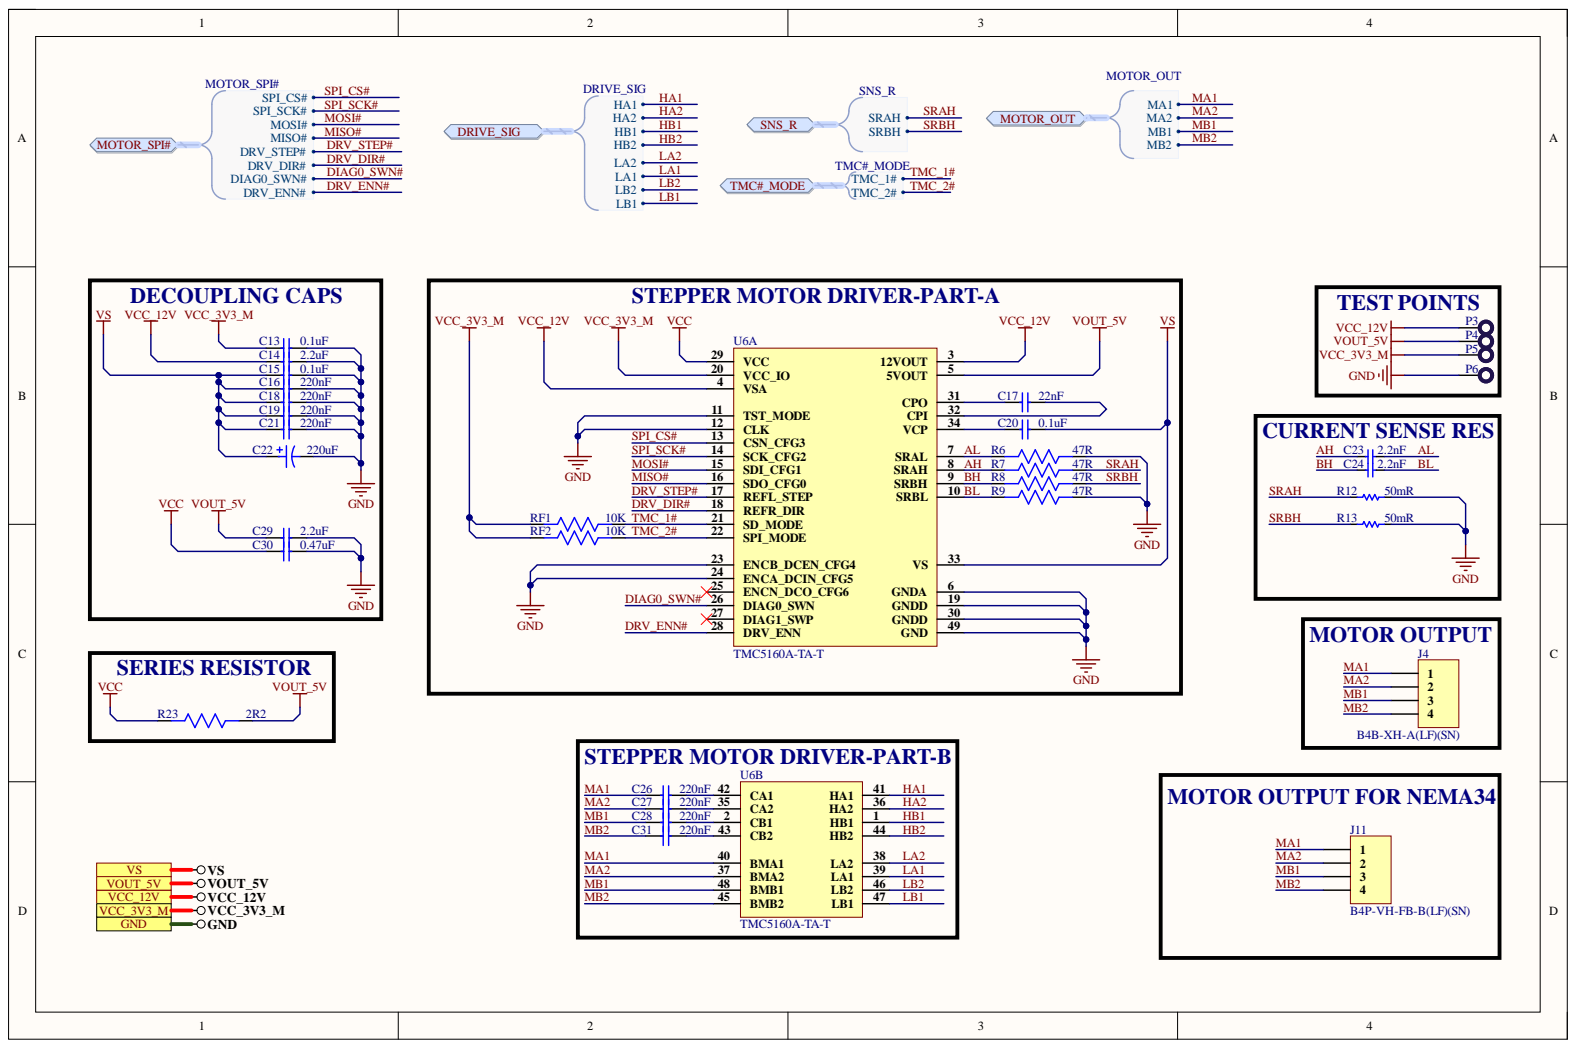
[picture p154: page 6]

MOTOR_SPI# | SPI_CS# | MOTOR_OUT DRIVE_SIG SNS_R HA1 LB1

STEPPER MOTOR DRIVER-PART-A

TEST POINTS

STEPPER MOTOR DRIVER-PART-B

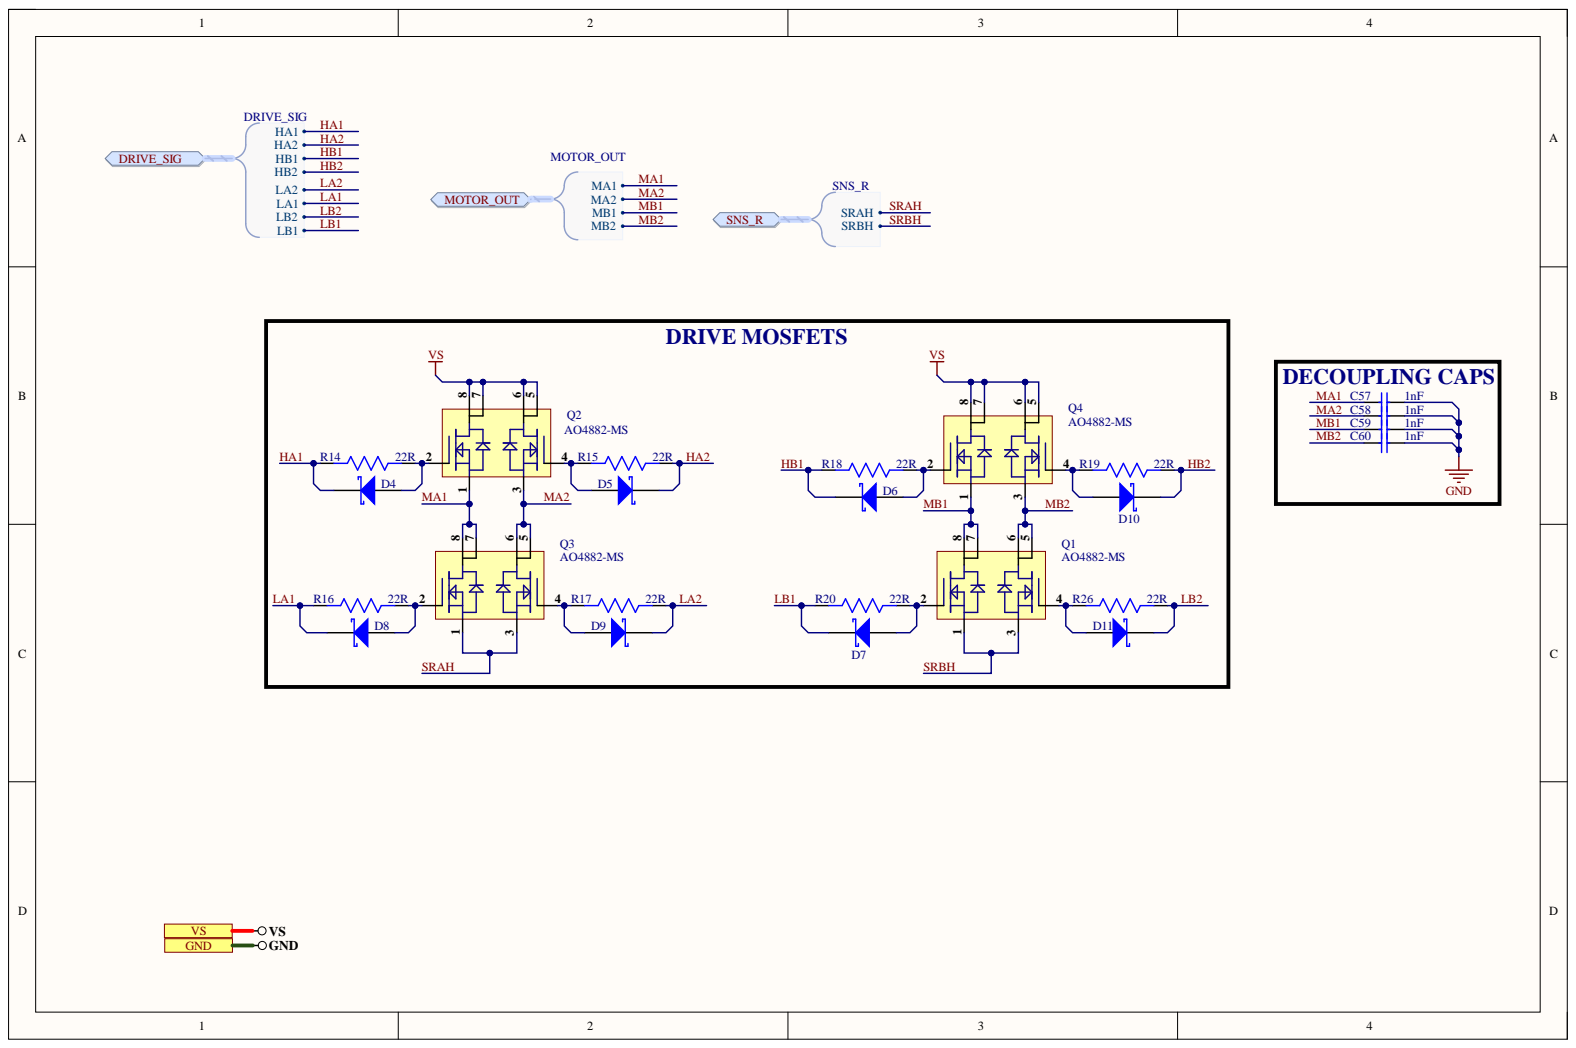
[picture p155: page 7]

DRIVE_SIG HA1 HA1 HB1 HB1 MOTOR_OUT LB1

VS | | DRIVE MOSFETS VS

DECOUPLING CAPS

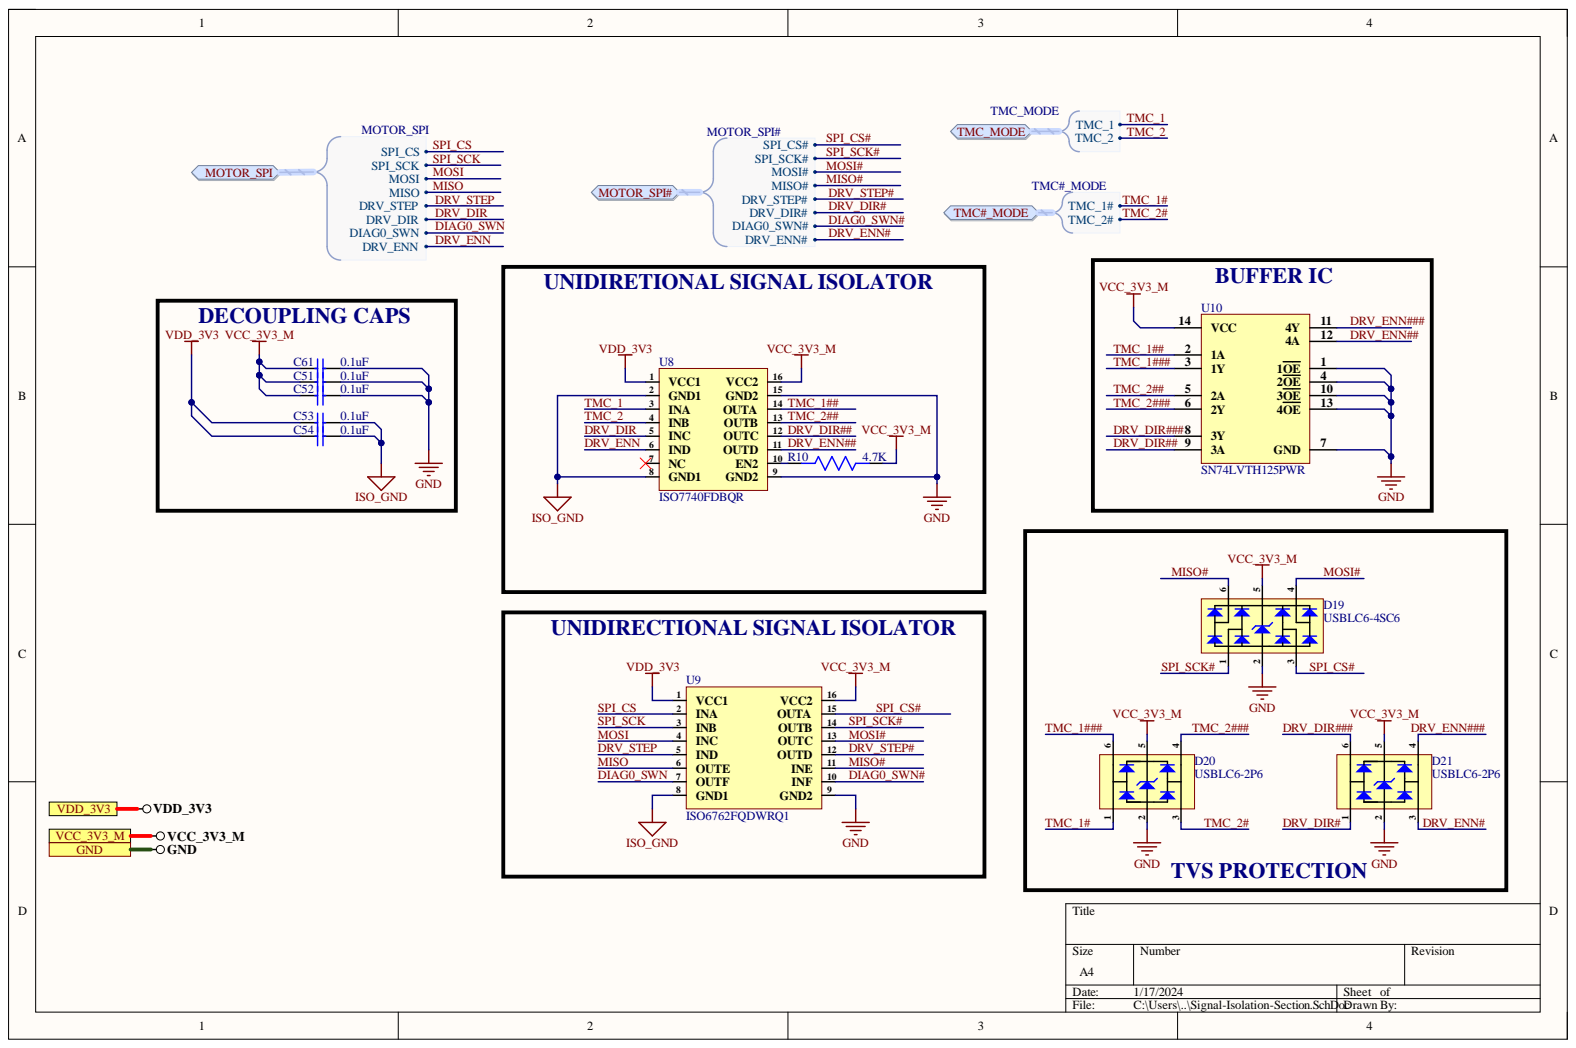
[picture p156: page 8]

Size A4 | Number | Revision

Date: 1/17/2024 | Sheet of
File: C:\Users\..\Signal-Isolation-Section.SchDoDr c awn By:

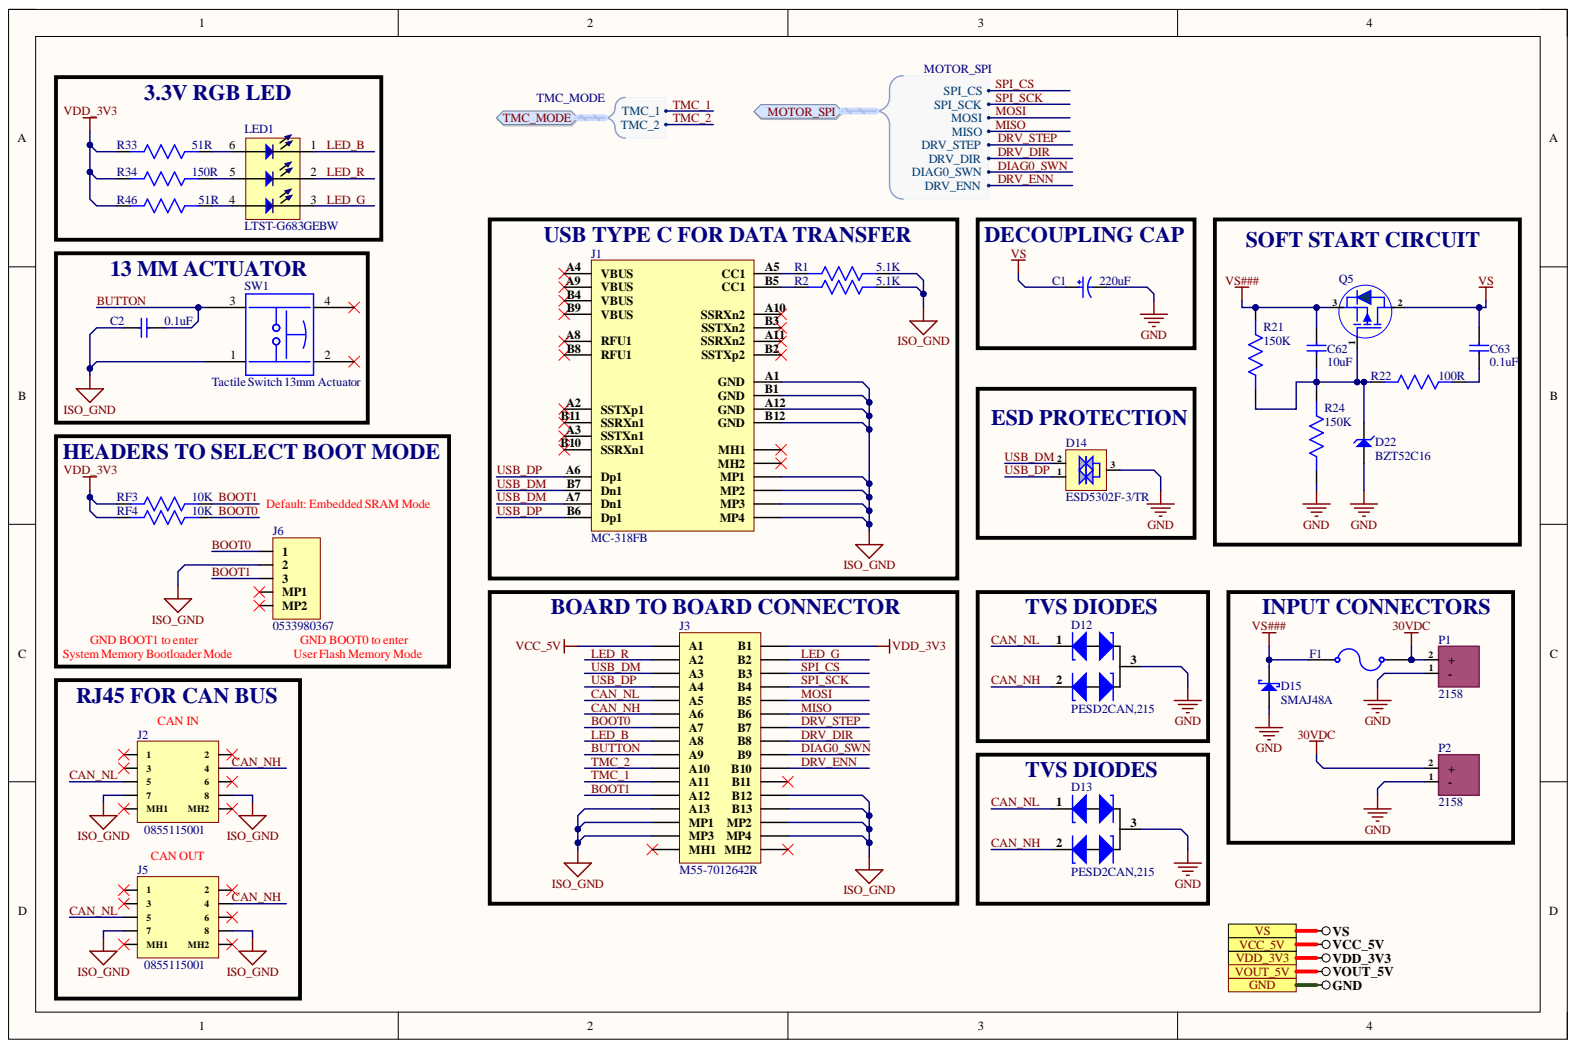
[picture p157: page 9]

USB TYPE C FOR DATA TRANSFER

HEADERS TO SELECT BOOT MODE

Default: Embedded SRAM Mode

BOARD TO BOARD CONNECTOR

GND BOOT1 to enter
System Memory Bootloader Mode
