eSpark-Backup/colebenson-smartmotors/(list of files, drawings)

Other design files:
Design-Files-v3.4/LSS_Bottom_Board_v3.4/CAN-Sheet.SchDoc
Design-Files-v3.4/LSS_Bottom_Board_v3.4/Encoder-Sheet.SchDoc
Design-Files-v3.4/LSS_Bottom_Board_v3.4/Motion-Sensor-Sheet.SchDoc
Design-Files-v3.4/LSS_Bottom_Board_v3.4/Processing-Section.SchDoc
Design-Files-v3.4/LSS_Top_Board_v3.4/Signal-Isolation-Section.SchDoc
Design-Files/LSS_Bottom_Board_v3.4/Connector-Section.SchDoc
Design-Files/LSS_Bottom_Board_v3.4/LSS-P-PCB-B v3.4.PcbDoc
Design-Files/LSS_Bottom_Board_v3.4/Peripheral-Section.SchDoc
Design-Files/LSS_Bottom_Board_v3.4/Top-Sheet.SchDoc
Design-Files/LSS_Sub_Board_v1.1/Connector-Section.SchDoc
Design-Files/LSS_Sub_Board_v1.1/LSS-P-PCB-S v1.1.PcbDoc
Design-Files/LSS_Sub_Board_v1.1/LSS_Sub_Board_v1.1.PrjPcb
Design-Files/LSS_Top_Board_v3.4/Connector-Section.SchDoc
Design-Files/LSS_Top_Board_v3.4/Driver-Sheet.SchDoc
Design-Files/SM_Bottom_Board/CAN-Sheet.SchDoc
Design-Files/SM_Bottom_Board/Connector-Section.SchDoc
Design-Files/SM_Bottom_Board/Encoder-Sheet.SchDoc
Design-Files/SM_Bottom_Board/Motion-Sensor-Sheet.SchDoc
Design-Files/SM_Bottom_Board/Peripheral-Power-Sheet.SchDoc
Design-Files/SM_Bottom_Board/Peripheral-Section.SchDoc
Design-Files/SM_Bottom_Board/Processing-Section.SchDoc
Design-Files/SM_Bottom_Board/Sensor-Section.SchDoc
Design-Files/SM_Bottom_Board/SM_Bottom_PCB.PcbDoc
Design-Files/SM_Bottom_Board/Top-Sheet.SchDoc
Design-Files/SM_Top_Board/Connector-Section.SchDoc
Design-Files/SM_Top_Board/Driver-Sheet.SchDoc
Design-Files/SM_Top_Board/Isolated-Power-Section.SchDoc
Design-Files/SM_Top_Board/Motor-Driver-Sheet.SchDoc
Design-Files/SM_Top_Board/Motor-Supply-Section.SchDoc
Design-Files/SM_Top_Board/Power-Section.SchDoc
Design-Files/SM_Top_Board/Signal-Isolation-Section.SchDoc
Design-Files/SM_Top_Board/SM_Top_Board.PrjPcb
Design-Files/SM_Top_Board/SM_Top_PCB.PcbDoc
Design-Files/SM_Top_Board/Stepper-Section.SchDoc
Design-Files/SM_Top_Board/Temp_Probe_Section.SchDoc
Design-Files/SM_Top_Board/Top-Sheet.SchDoc
Library-Files/Cole_.PcbLib
