eSpark-Backup/colebenson-smartmotors/Documents/Client-Shared-Files/Sharing-13042021/PRO-PCB-V2 - Incomplete/LSS Pro V0.2 BOTTOM.brd

## EAGLE design Documents/Client-Shared-Files/Sharing-13042021/PRO-PCB-V2 - Incomplete/LSS Pro V0.2 BOTTOM.brd (2021-07-02)

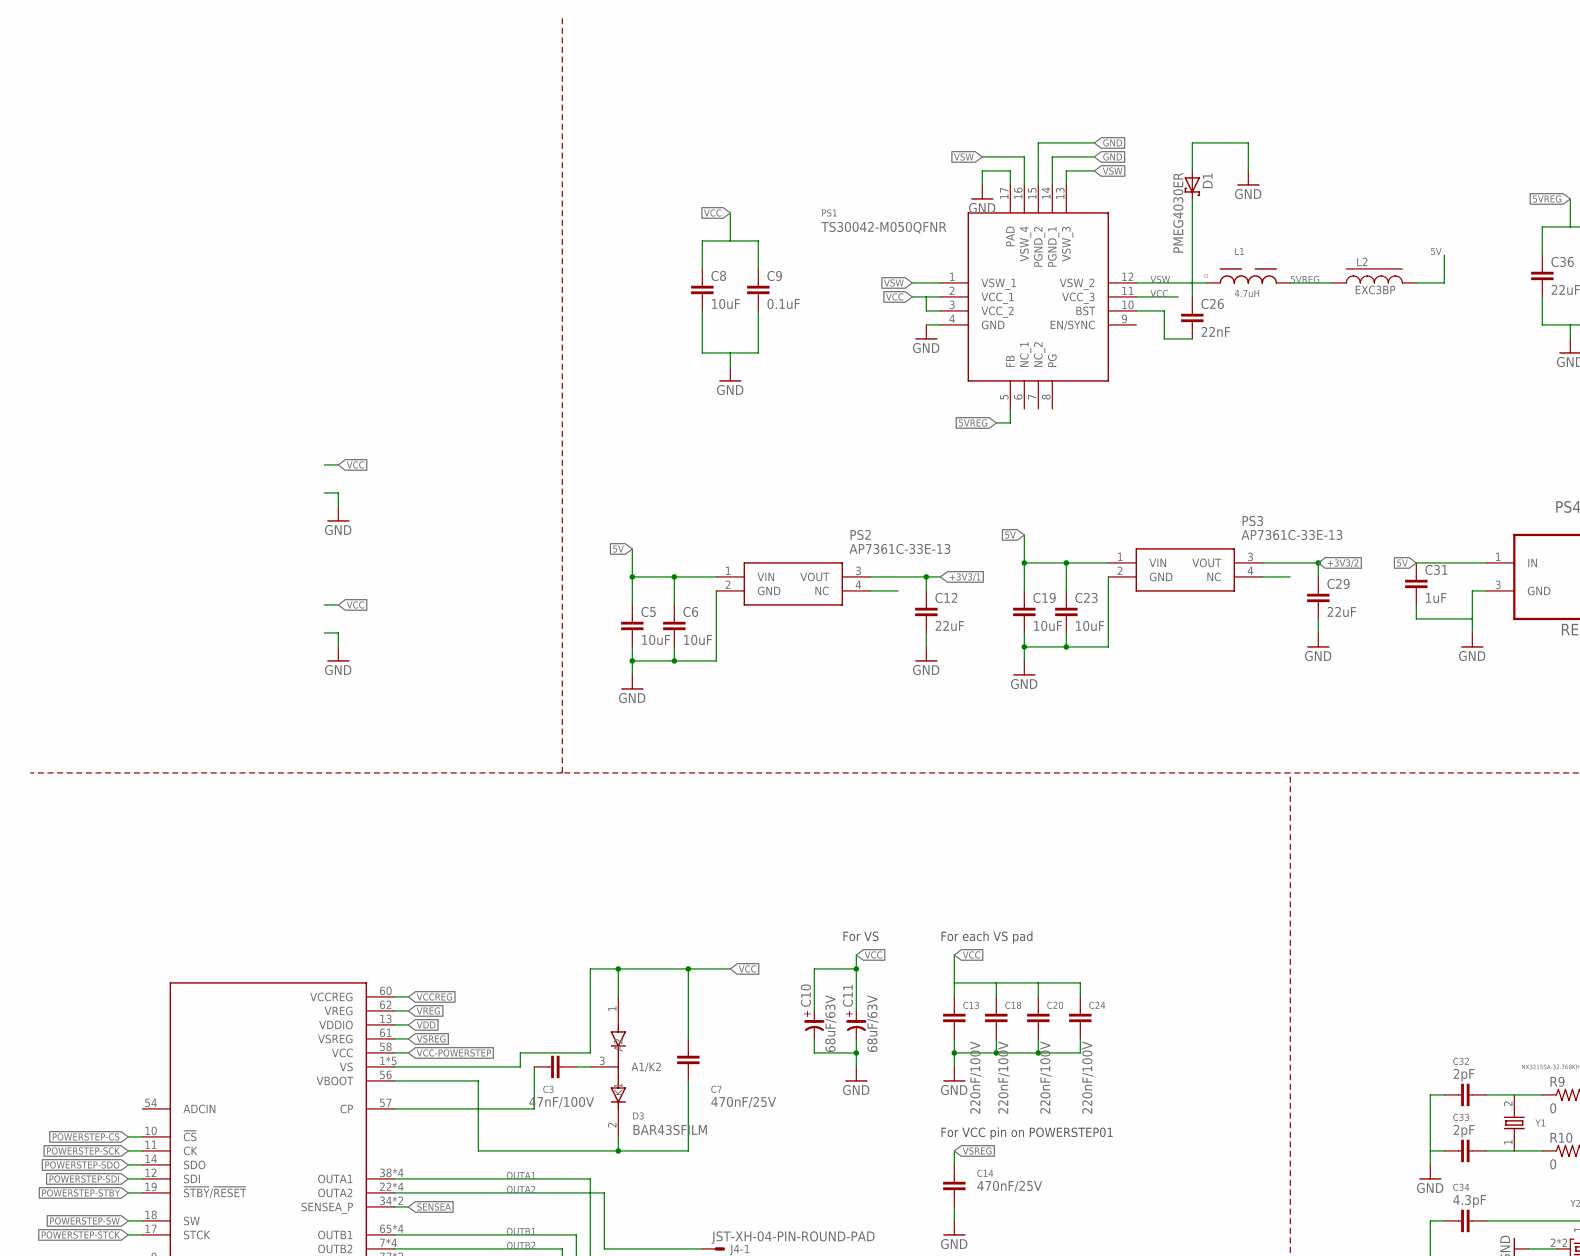
[picture p158: schematic LSS Pro V0.2 BOTTOM.sch, Pre-prototype, part in row 1, column 1]

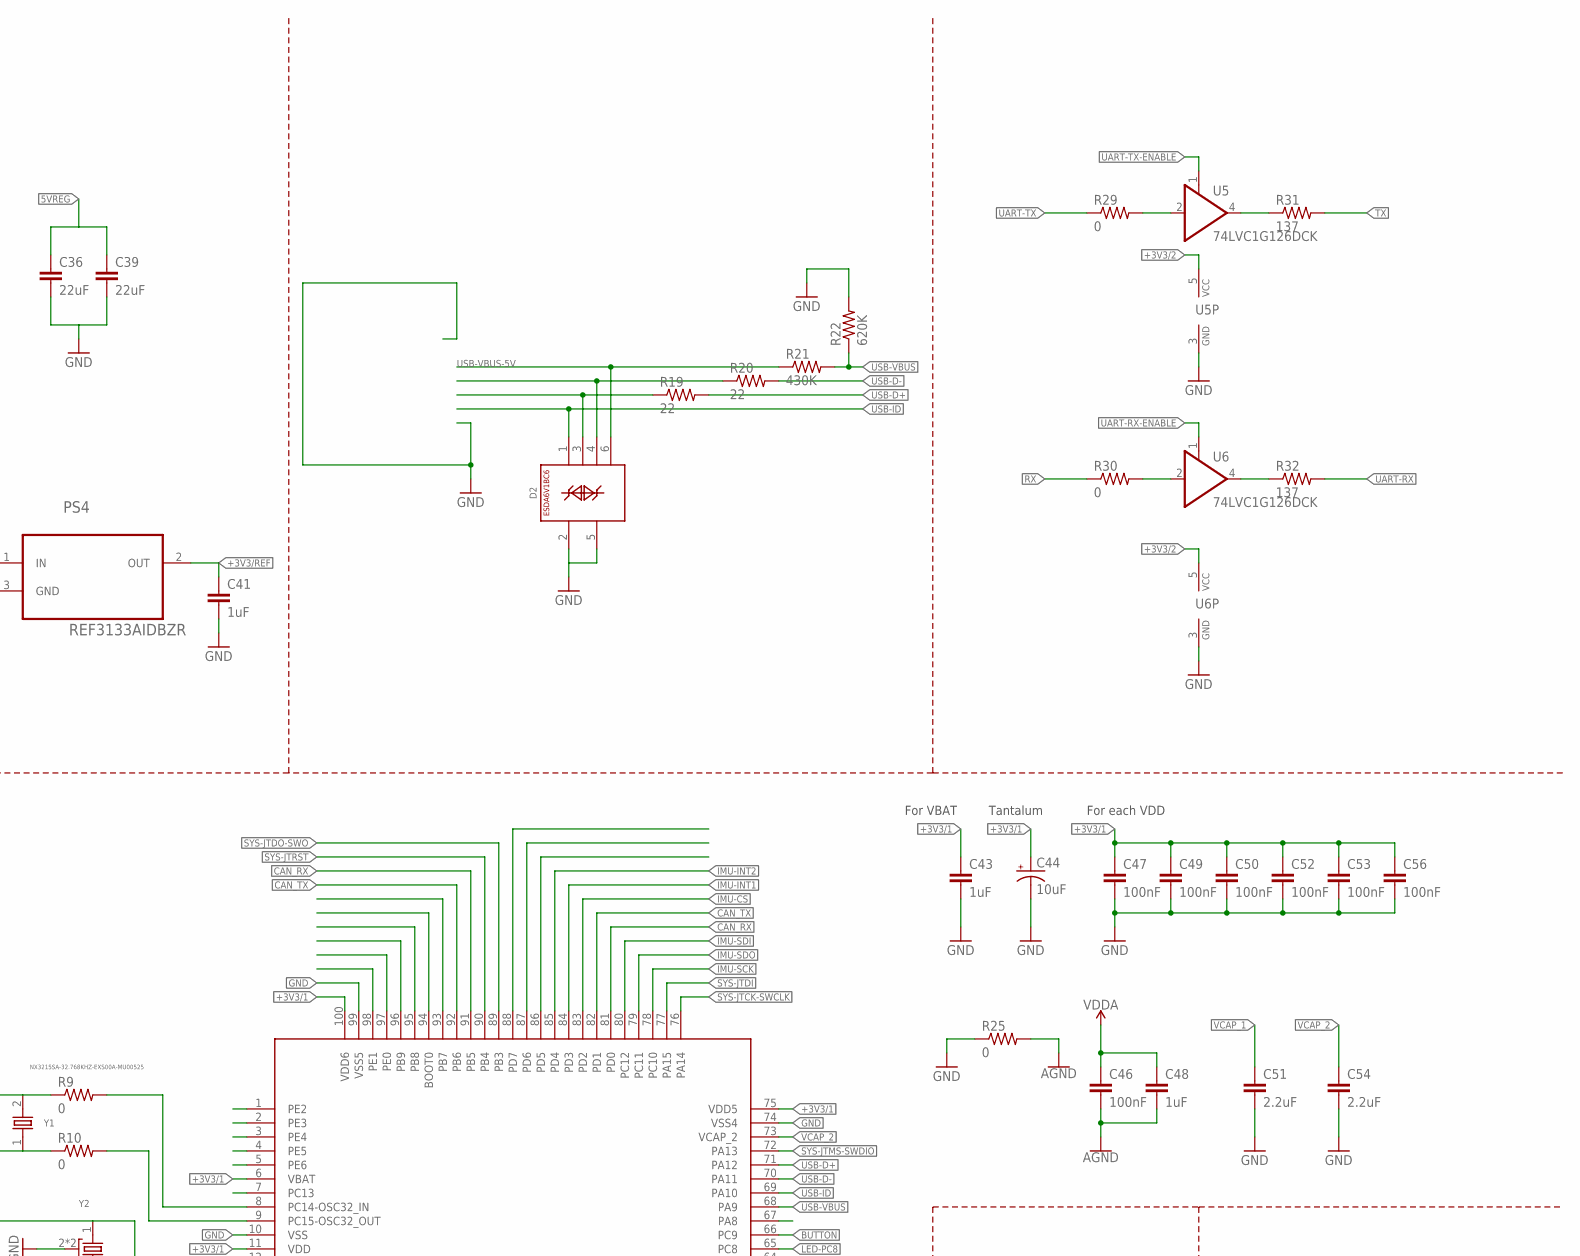
[picture p159: schematic LSS Pro V0.2 BOTTOM.sch, Pre-prototype, part in row 1, column 2]

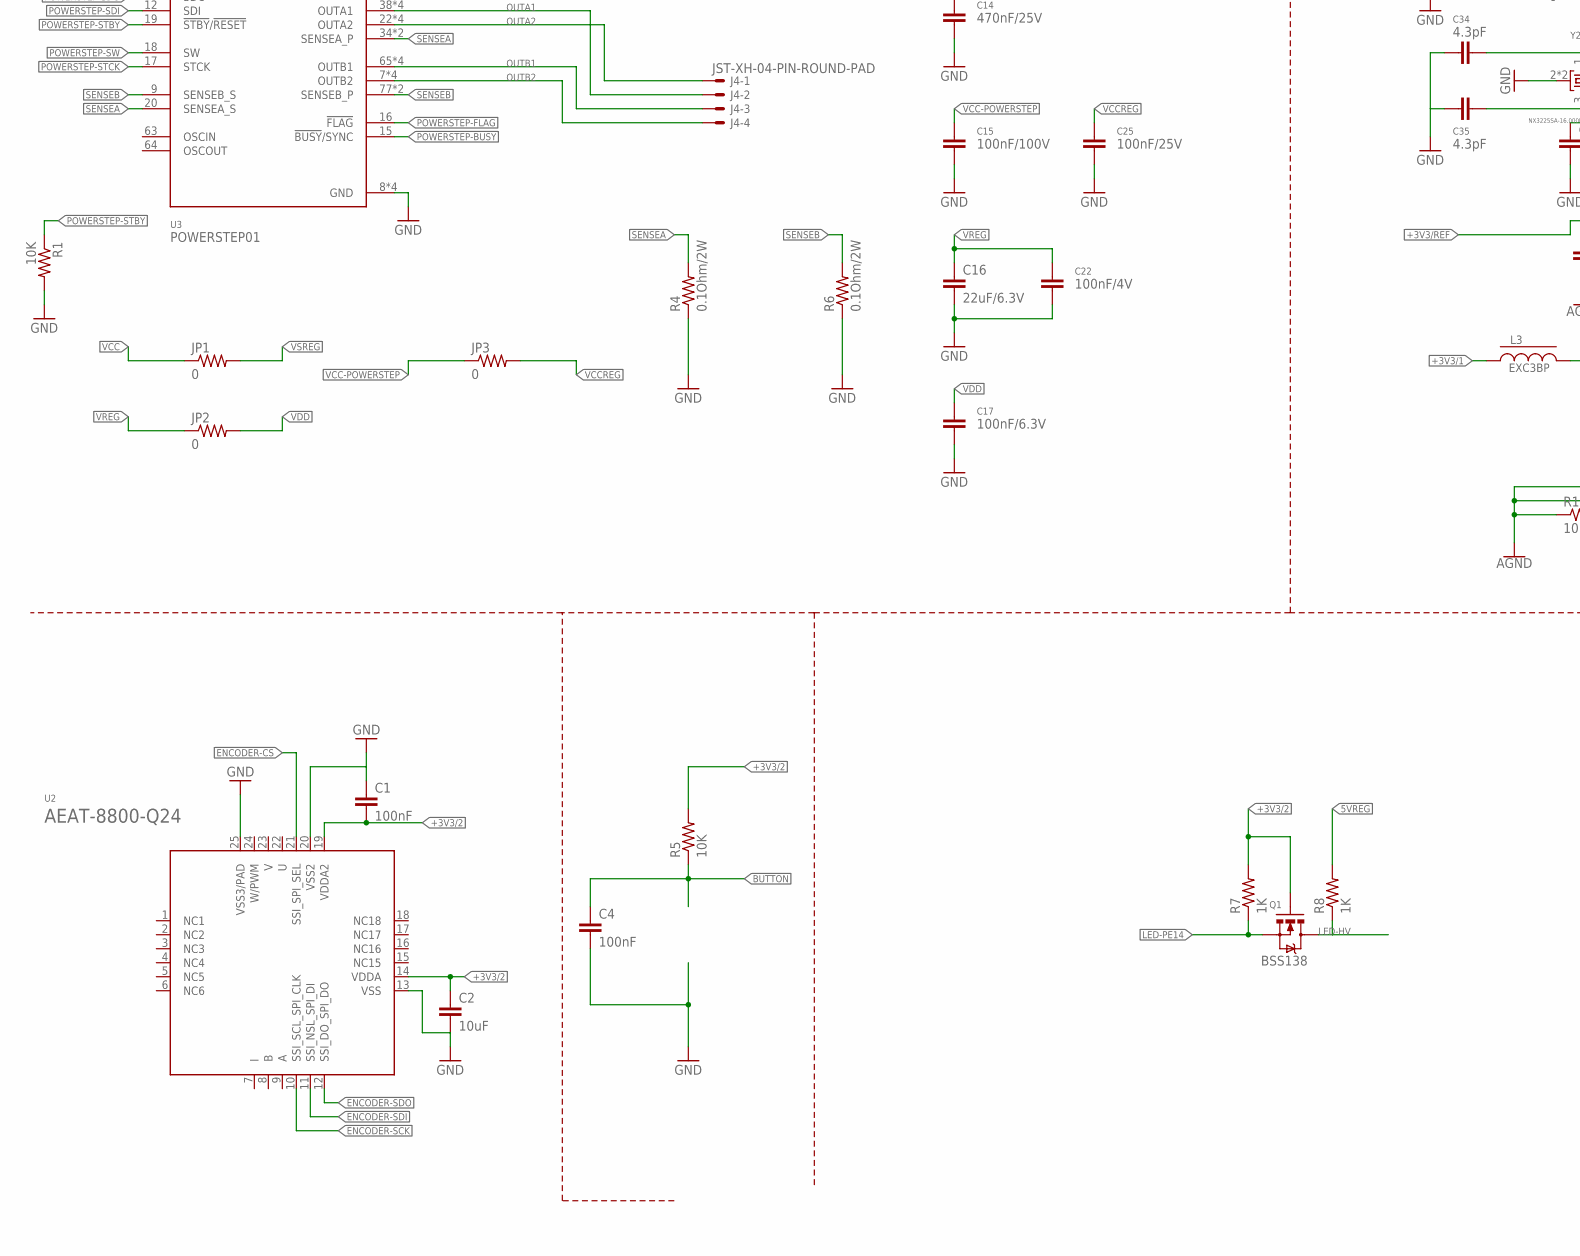
[picture p160: schematic LSS Pro V0.2 BOTTOM.sch, Pre-prototype, part in row 2, column 1]

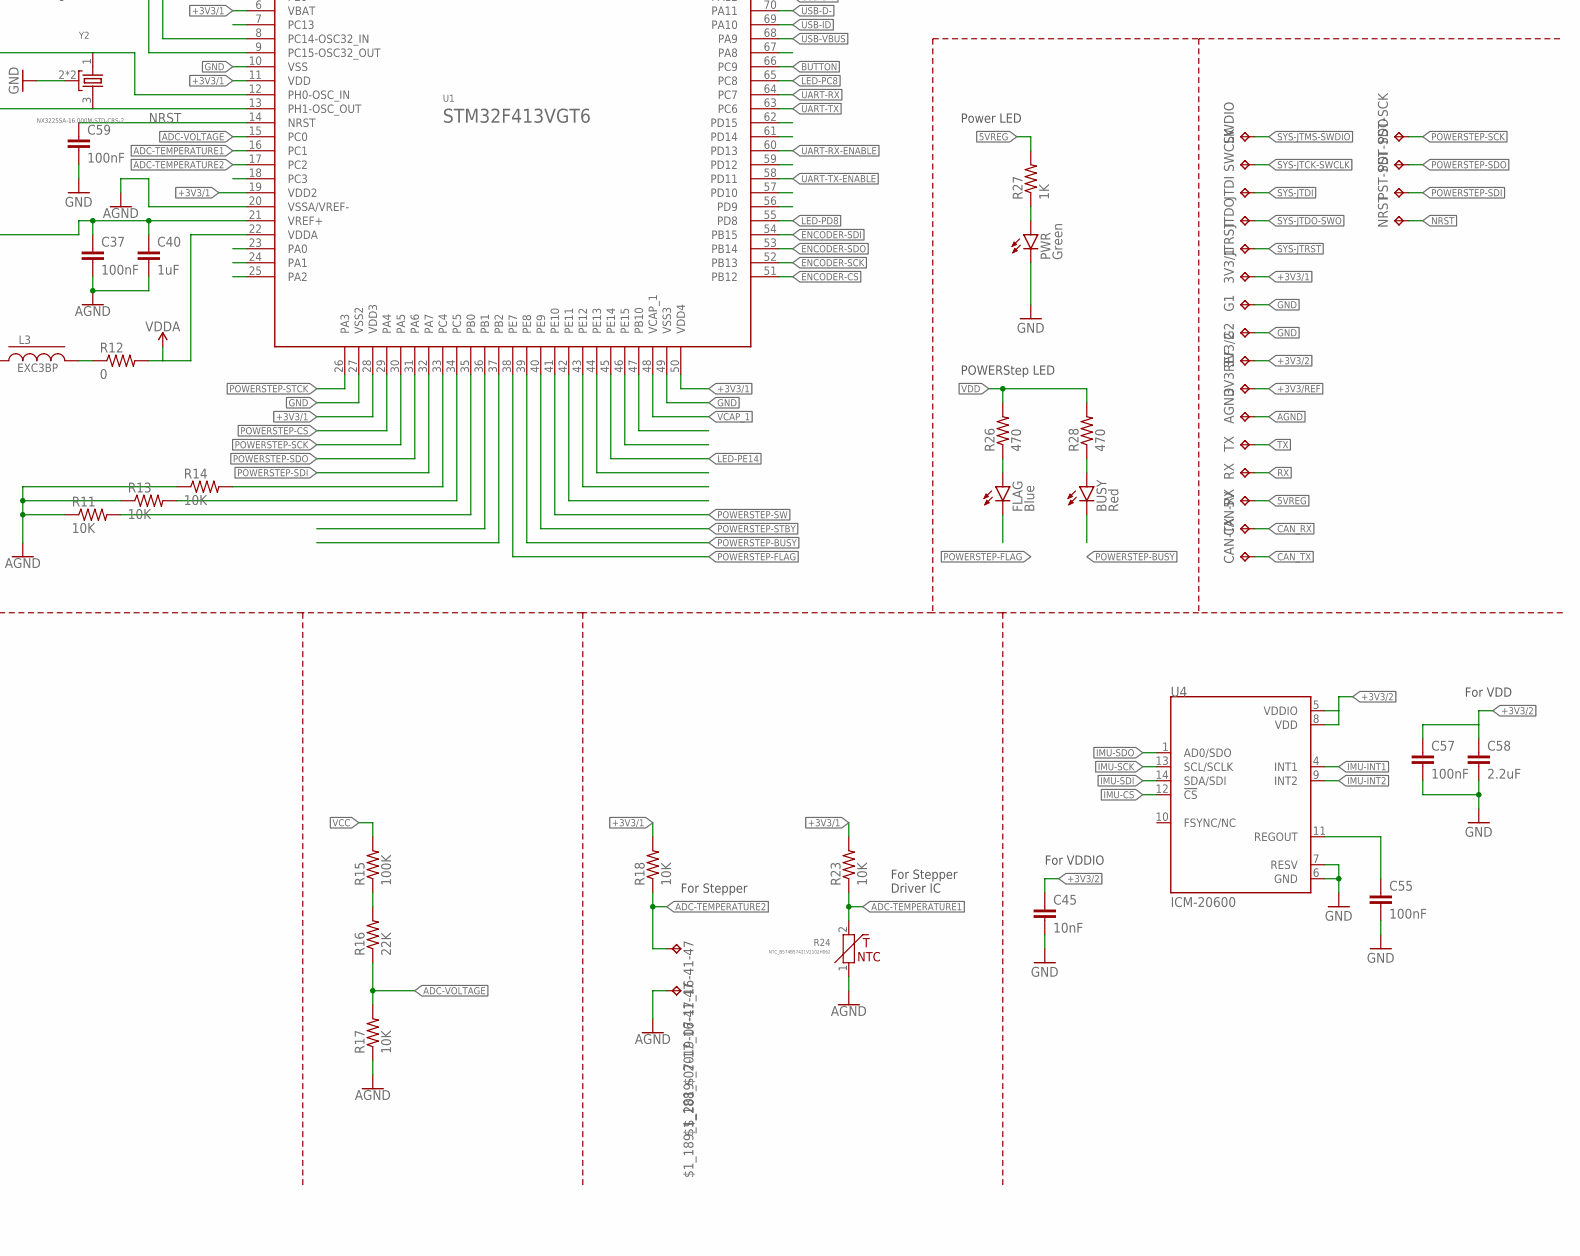
[picture p161: schematic LSS Pro V0.2 BOTTOM.sch, Pre-prototype, part in row 2, column 2]

Parts:
3V3/1, 3V3/2, 3V3REF, 5V: TPTP17R; TP17R
$1_188_$_2019-07-17_16-41-47, $1_189_$_2019-07-17_16-41-47: TP-040
AGND: TPTP17R; TP17R
BUSY: Red; LED-0603
C1, C4, C37, C46, C47, C49, C50, C52, C53, C55, C56, C57, C59: 100nF; 0603-CAP
C2: 10uF; 0603-CAP
C3: 47nF/100V; 0805
C5, C6, C19, C23: 10uF; 0805
C7, C14: 470nF/25V; 0603-CAP
C8: 10uF; 1206
C9: 0.1uF; 0603-CAP
C10, C11: 68uF/63V; CSV-E/F
C12, C29, C36, C39: 22uF; 0805
C13, C18, C20, C24: 220nF/100V; 0805
C15: 100nF/100V; 0603-CAP
C16: 22uF/6.3V; 1206
C17: 100nF/6.3V; 0603-CAP
C22: 100nF/4V; 0603-CAP
C25: 100nF/25V; 0603-CAP
C26: 22nF; 0402-CAP
C31, C41: 1uF; 0805
C32, C33: 2pF; 0603-CAP
C34, C35: 4.3pF; 0603-CAP
C40, C43, C48: 1uF; 0603-CAP
C44: 10uF; EIA3216
C45: 10nF; 0603-CAP
C51, C54, C58: 2.2uF; 1206
CAN-RX: TPTP17R; TP17R
CAN-TX: TPTP17R; TP17R
D1: PMEG4030ER; SOD123W
D2: ESDA6V1BC6; SOT-23-6L
D3: BAR43SFILM; SOT105P242X150-3N
FLAG: Blue; LED-0603
G1, G2: TPTP17R; TP17R
J4: JST-XH-04-PIN-ROUND-PAD; JST-XH-04-PACKAGE-ROUND-PAD
JP1, JP2, JP3: 0; 0603-RES
JTDI: TPTP17R; TP17R
JTDO: TPTP17R; TP17R
JTRST: TPTP17R; TP17R
L1: 4.7uH; WE-PD2_5848/5820
L2, L3: EXC3BP; L0603
NRST: TPTP17R; TP17R
PS1: TS30042-M050QFNR; QFN16
PS2, PS3: AP7361C-33E-13; SOT230P700X165-4N
PS4: REF3133AIDBZR; SOT95P237X112-3N
PST-SCK: TPTP17R; TP17R
PST-SDI: TPTP17R; TP17R
PST-SDO: TPTP17R; TP17R
PWR: Green; LED-0603
Q1: BSS138; SOT23-3
R1, R11, R13, R14: 10K; 0402-RES
R4, R6: 0.1Ohm/2W; R2512
R5, R17, R18, R23: 10K; 0603-RES
R7, R8: 1K; 0603-RES
R9, R10, R12, R25, R29, R30: 0; 0603-RES
R15: 100K; 0603-RES
R16: 22K; 0603-RES
R19, R20: 22; 0603-RES
R21: 430K; 0603-RES
R22: 620K; 0603-RES
R24: NTC_B574B57421V2102H062; R0805
R26, R28: 470; 0402-RES
R27: 1K; 0402-RES
R31, R32: 137; 0603-RES
RX: TPTP17R; TP17R
SWCLK: TPTP17R; TP17R
SWDIO: TPTP17R; TP17R
TX: TPTP17R; TP17R
U1: STM32F413VGT6; LQFP100
U2: AEAT-8800-Q24; QFN24
U3: POWERSTEP01; IC_POWERSTEP01
U4: ICM-20600; PQFN50P250X300X97-14N
U5, U6: 74LVC1G126DCK; SC70-5
Y1: NX3215SA-32.768KHZ-EXS00A-MU00525; NX3215SA
Y2: NX3225SA-16.000M-STD-CRS-2; OSCCC320X250X60N

Connections:
5V: C5.1, C6.1, C19.1, C23.1, C31.1, L2.2, PS2.1 (VIN), PS3.1 (VIN), PS4.1 (IN)
5VREG: 5V.TP, C36.1, C39.1, L1.2, L2.1, PS1.5 (FB), R8.2, R27.2
+3V3/1: 3V3/1.TP, C12.1, C43.1, C44.A (+), C47.1, C49.1, C50.1, C52.1, C53.1, C56.1, L3.1, PS2.3 (VOUT), R18.2, R23.2, U1.6 (VBAT), U1.11 (VDD), U1.19 (VDD2), U1.28 (VDD3), U1.50 (VDD4), U1.75 (VDD5), U1.100 (VDD6)
+3V3/2: 3V3/2.TP, C1.2, C2.1, C29.1, C45.1, C57.1, C58.1, PS3.3 (VOUT), Q1.1 (G), R5.2, R7.2, U2.14 (VDDA), U2.19 (VDDA2), U4.5 (VDDIO), U4.8 (VDD), U5.5 (VCC), U6.5 (VCC)
+3V3/REF: 3V3REF.TP, C37.1, C40.1, C41.1, PS4.2 (OUT), U1.21 (VREF+)
ADC-TEMPERATURE1: R23.1, R24.2, U1.16 (PC1)
ADC-TEMPERATURE2: $1_188_$_2019-07-17_16-41-47.1, R18.1, U1.17 (PC2)
ADC-VOLTAGE: R16.1, R17.2, U1.15 (PC0)
AGND: $1_189_$_2019-07-17_16-41-47.1, AGND.TP, C37.2, C40.2, C46.2, C48.2, R11.1, R13.1, R14.1, R17.1, R24.1, R25.2, U1.20 (VSSA/VREF-)
BUTTON: C4.1, R5.1, U1.66 (PC9)
CAN_RX: CAN-RX.TP, U1.81 (PD0), U1.91 (PB5)
CAN_TX: CAN-TX.TP, U1.82 (PD1), U1.92 (PB6)
ENCODER-CS: U1.51 (PB12), U2.21 (SSI_SPI_SEL)
ENCODER-SCK: U1.52 (PB13), U2.10 (SSI_SCL_SPI_CLK)
ENCODER-SDI: U1.54 (PB15), U2.11 (SSI_NSL_SPI_DI)
ENCODER-SDO: U1.53 (PB14), U2.12 (SSI_DO_SPI_DO)
GND: C1.1, C2.2, C4.2, C5.2, C6.2, C8.2, C9.2, C10.-, C11.-, C12.2, C13.2, C14.2, C15.2, C16.2, C17.2, C18.2, C19.2, C20.2, C22.2, C23.2, C24.2, C25.2, C29.2, C31.2, C32.2, C33.2, C34.2, C35.2, C36.2, C39.2, C41.2, C43.2, C44.C (-), C45.2, C47.2, C49.2, C50.2, C51.2, C52.2, C53.2, C54.2, C55.2, C56.2, C57.2, C58.2, C59.2, D1.2 (A), D2.2, D2.5, G1.TP, G2.TP, PS1.4 (GND), PS1.14 (PGND_1), PS1.15 (PGND_2), PS1.17 (PAD), PS2.2 (GND), PS3.2 (GND), PS4.3 (GND), PWR.C, R1.2, R4.1, R6.1, R22.2, R25.1, U1.10 (VSS), U1.27 (VSS2), U1.49 (VSS3), U1.74 (VSS4), U1.99 (VSS5), U2.13 (VSS), U2.20 (VSS2), U2.25 (VSS3/PAD), U3.8 (GND), U3.21 (GND), U3.59 (GND), U3.EPAD9 (GND), U4.6 (GND), U4.7 (RESV), U5.3 (GND), U6.3 (GND), Y2.2 (GND), Y2.4 (GND)
IMU-CS: U1.83 (PD2), U4.12 (!CS)
IMU-INT1: U1.84 (PD3), U4.4 (INT1)
IMU-INT2: U1.85 (PD4), U4.9 (INT2)
IMU-SCK: U1.78 (PC10), U4.13 (SCL/SCLK)
IMU-SDI: U1.80 (PC12), U4.14 (SDA/SDI)
IMU-SDO: U1.79 (PC11), U4.1 (AD0/SDO)
LED-HV: Q1.3 (D), R8.1
LED-PC8: U1.65 (PC8)
LED-PD8: U1.55 (PD8)
LED-PE14: Q1.2 (S), R7.1, U1.45 (PE14)
unnamed: R30.2, U6.2 (I)
unnamed: R9.2, U1.8 (PC14-OSC32_IN)
unnamed: R10.2, U1.9 (PC15-OSC32_OUT)
unnamed: L3.2, R12.1
unnamed: R32.1, U6.4 (O)
unnamed: C34.1, U1.12 (PH0-OSC_IN), Y2.1
unnamed: C35.1, U1.13 (PH1-OSC_OUT), Y2.3
unnamed: PWR.A, R27.1
unnamed: R29.2, U5.2 (I)
unnamed: R31.1, U5.4 (O)
unnamed: C32.1, R9.1, Y1.2
unnamed: C33.1, R10.1, Y1.1
unnamed: FLAG.A, R26.1
unnamed: C3.1, U3.57 (CP)
unnamed: R15.1, R16.2
unnamed: C55.1, U4.11 (REGOUT)
unnamed: BUSY.A, R28.1
unnamed: D2.4, R20.1
unnamed: D2.3, R19.1
unnamed: C3.2, D3.3 (A1/K2)
unnamed: R14.2, U1.33 (PC4)
unnamed: R13.2, U1.34 (PC5)
unnamed: R11.2, U1.35 (PB0)
unnamed: C7.2, D3.2 (K1), U3.56 (VBOOT)
unnamed: C26.2, PS1.10 (BST)
NRST: C59.1, NRST.TP, U1.14 (NRST)
OUTA1: J4.2, U3.38 (OUTA1), U3.42 (OUTA1), U3.53 (OUTA1), U3.EPAD4 (OUTA1)
OUTA2: J4.1, U3.22 (OUTA2), U3.33 (OUTA2), U3.37 (OUTA2), U3.EPAD3 (OUTA2)
OUTB1: J4.3, U3.65 (OUTB1), U3.76 (OUTB1), U3.80 (OUTB1), U3.EPAD7 (OUTB1)
OUTB2: J4.4, U3.7 (OUTB2), U3.81 (OUTB2), U3.85 (OUTB2), U3.EPAD8 (OUTB2)
POWERSTEP-BUSY: BUSY.C, U1.39 (PE8), U3.15 (!BUSY!/SYNC)
POWERSTEP-CS: U1.29 (PA4), U3.10 (!CS)
POWERSTEP-FLAG: FLAG.C, U1.38 (PE7), U3.16 (!FLAG)
POWERSTEP-SCK: PST-SCK.TP, U1.30 (PA5), U3.11 (CK)
POWERSTEP-SDI: PST-SDI.TP, U1.32 (PA7), U3.12 (SDI)
POWERSTEP-SDO: PST-SDO.TP, U1.31 (PA6), U3.14 (SDO)
POWERSTEP-STBY: R1.1, U1.40 (PE9), U3.19 (!STBY!/!RESET)
POWERSTEP-STCK: U1.26 (PA3), U3.17 (STCK)
POWERSTEP-SW: U1.41 (PE10), U3.18 (SW)
RX: R30.1, RX.TP
SENSEA: R4.2, U3.20 (SENSEA_S), U3.34 (SENSEA_P), U3.39 (SENSEA_P)
SENSEB: R6.2, U3.9 (SENSEB_S), U3.77 (SENSEB_P), U3.82 (SENSEB_P)
SYS-JTCK-SWCLK: SWCLK.TP, U1.76 (PA14)
SYS-JTDI: JTDI.TP, U1.77 (PA15)
SYS-JTDO-SWO: JTDO.TP, U1.89 (PB3)
SYS-JTMS-SWDIO: SWDIO.TP, U1.72 (PA13)
SYS-JTRST: JTRST.TP, U1.90 (PB4)
TX: R31.2, TX.TP
UART-RX: R32.2, U1.64 (PC7)
UART-RX-ENABLE: U1.60 (PD13), U6.1 (OE)
UART-TX: R29.1, U1.63 (PC6)
UART-TX-ENABLE: U1.58 (PD11), U5.1 (OE)
USB-D+: R19.2, U1.71 (PA12)
USB-D-: R20.2, U1.70 (PA11)
USB-ID: D2.1, U1.69 (PA10)
USB-VBUS: R21.2, R22.1, U1.68 (PA9)
USB-VBUS-5V: D2.6, R21.1
VCAP_1: C51.1, U1.48 (VCAP_1)
VCAP_2: C54.1, U1.73 (VCAP_2)
VCC: C7.1, C8.1, C9.1, C10.+, C11.+, C13.1, C18.1, C20.1, C24.1, D3.1 (A2), JP1.1, PS1.2 (VCC_1), PS1.3 (VCC_2), PS1.11 (VCC_3), R15.2, U3.1 (VS), U3.23 (VS), U3.43 (VS), U3.55 (VS), U3.66 (VS)
VCC-POWERSTEP: C15.1, JP3.1, U3.58 (VCC)
VCCREG: C25.1, JP3.2, U3.60 (VCCREG)
VDD: C17.1, JP2.2, R26.2, R28.2, U3.13 (VDDIO)
VDDA: C46.1, C48.1, R12.2, U1.22 (VDDA)
VREG: C16.1, C22.1, JP2.1, U3.62 (VREG)
VSREG: C14.1, JP1.2, U3.61 (VSREG)
VSW: C26.1, D1.1 (K), L1.1, PS1.1 (VSW_1), PS1.12 (VSW_2), PS1.13 (VSW_3), PS1.16 (VSW_4)

Notes on the sheet:
For VBAT
Tantalum
For each VDD
For VS
For each VS pad
For VCC pin on POWERSTEP01
For VDD
For VDDIO
For Stepper Driver IC
Power LED
POWERStep LED
For Stepper

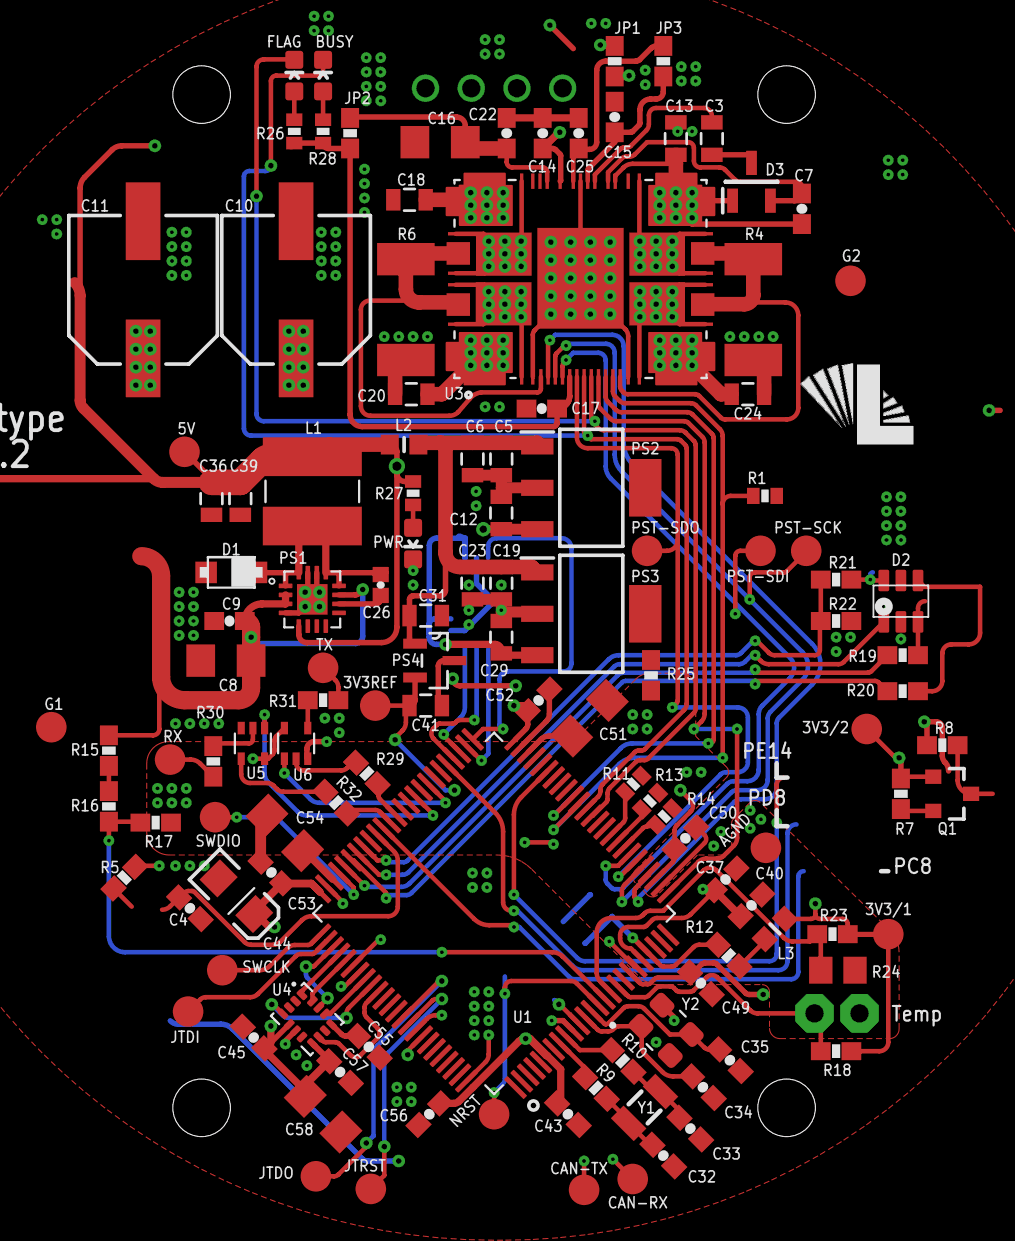
[picture p162: board LSS Pro V0.2 BOTTOM.brd from above]

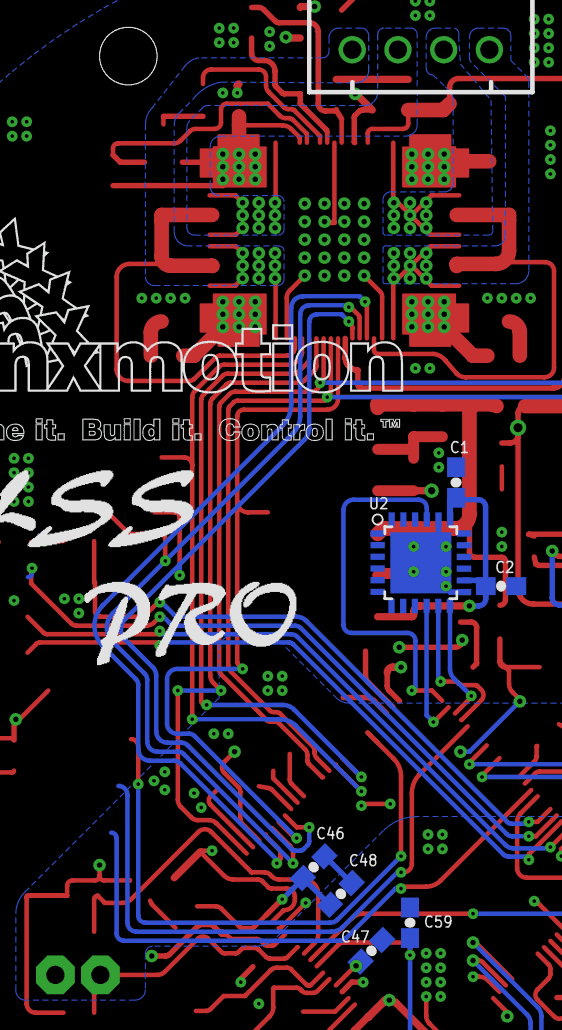
[picture p163: board LSS Pro V0.2 BOTTOM.brd from below]

Board: 4 copper layers, 131 parts (8 on the bottom side), 92 nets.
