eSpark-Backup/colebenson-smartmotors/Documents/Client-Shared-Files/Sharing-13042021/PRO-PCB-V2 - Incomplete/LSS Pro V0.2 TOP.brd

## EAGLE design Documents/Client-Shared-Files/Sharing-13042021/PRO-PCB-V2 - Incomplete/LSS Pro V0.2 TOP.brd (2021-07-02)

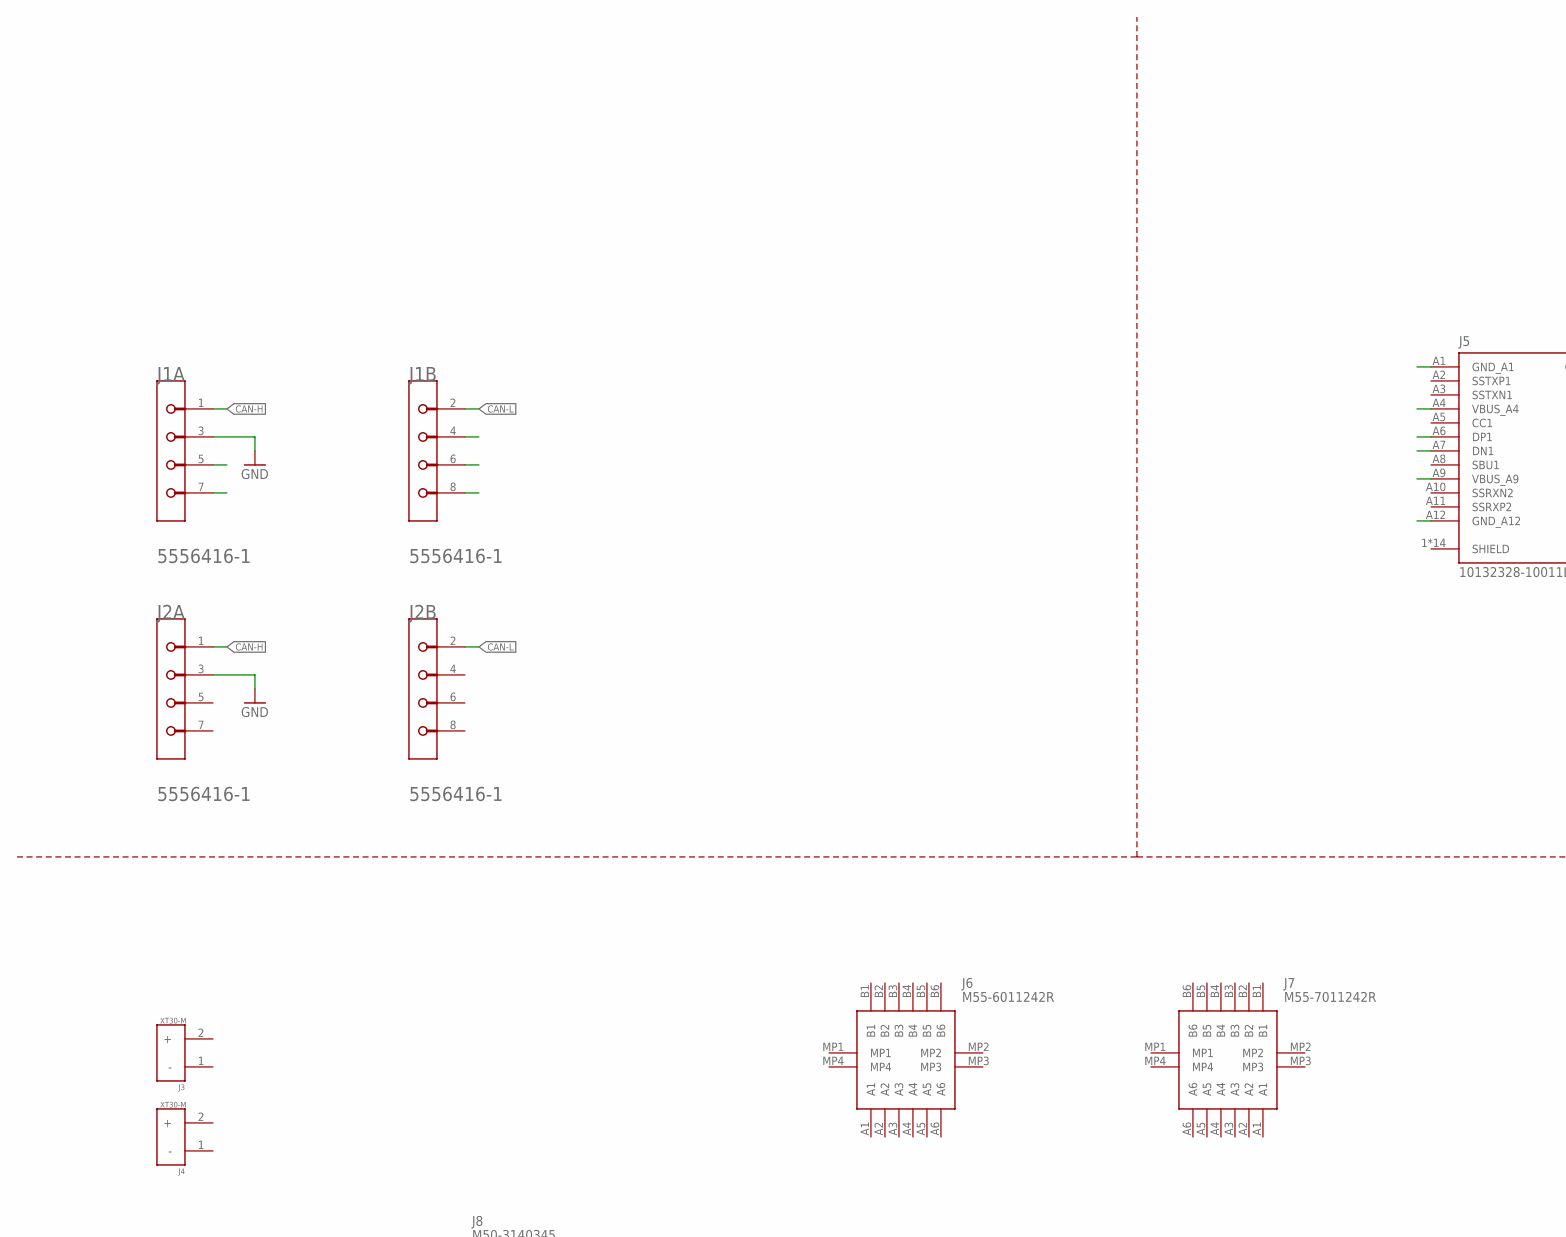
[picture p164: schematic LSS Pro V0.2 TOP.sch, Pre-prototype, part in row 1, column 1]

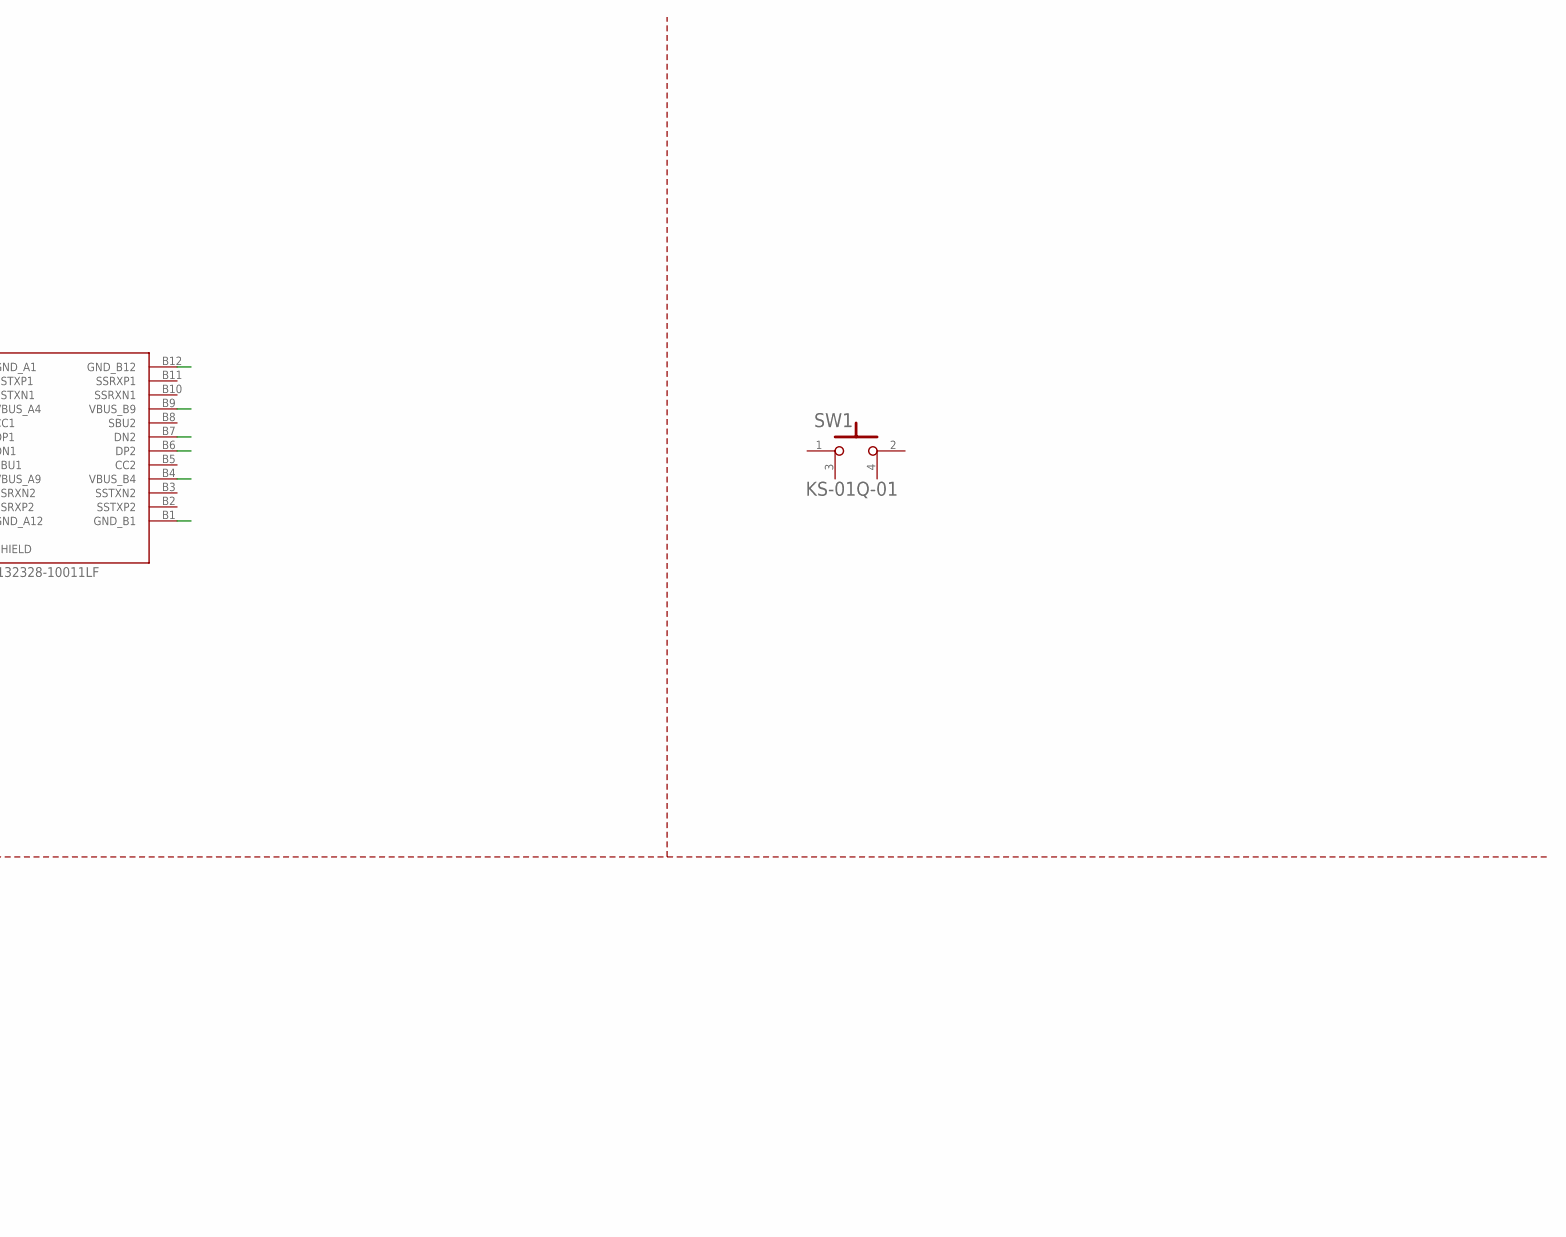
[picture p165: schematic LSS Pro V0.2 TOP.sch, Pre-prototype, part in row 1, column 2]

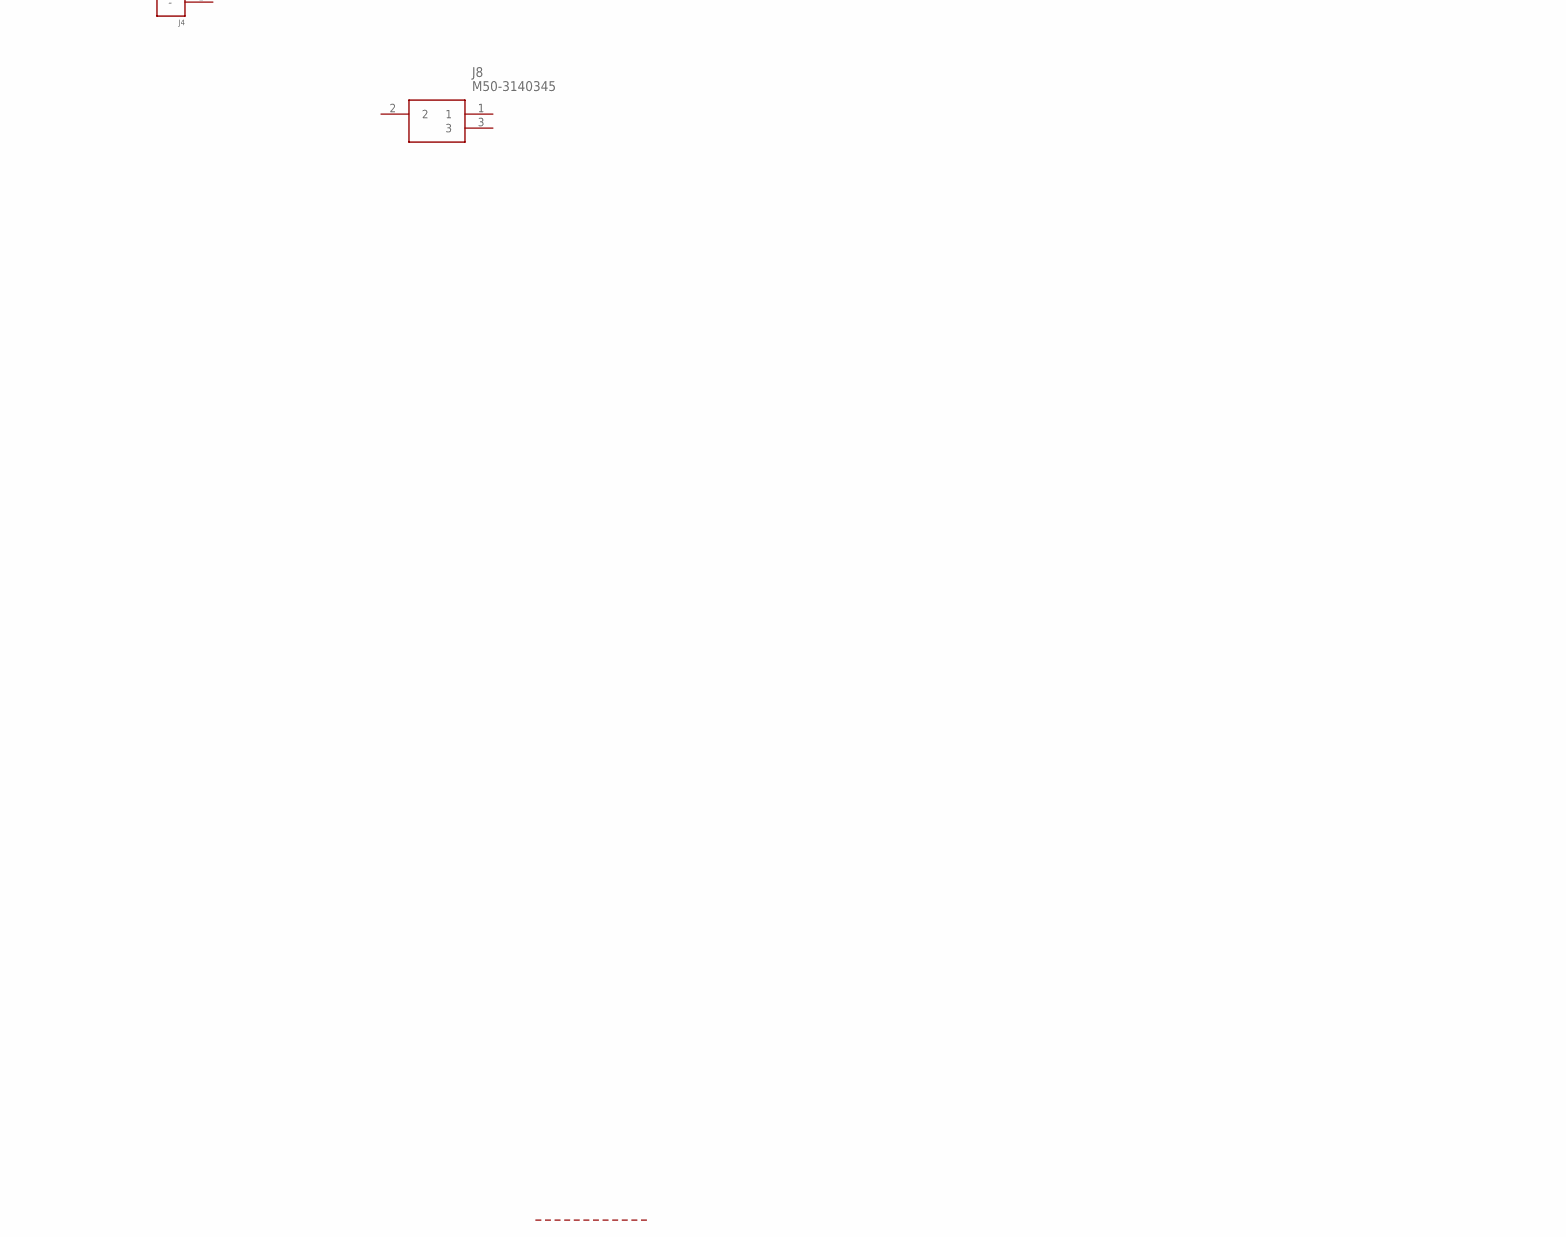
[picture p166: schematic LSS Pro V0.2 TOP.sch, Pre-prototype, part in row 2, column 1]

Parts:
J1, J2: TE_5556416-1TE_5556416-1_0_0; TE_5556416-1_0
J3, J4: XT30-M
J5: 10132328-10011LF; AMPHENOL_10132328-10011LF
J6: M55-6011242R; M556011242R
J7: M55-7011242R; M557011242R
J8: M50-3140345; M503140345
SW1: E-SWITCH_KS-01Q-01E-SWITCH_KS-01Q-01_0_0; E-SWITCH_KS-01Q-01_0

Connections:
CAN-H: J1.1, J2.1
CAN-L: J1.2, J2.2
GND: J1.3, J2.3

Board: 4 copper layers, 9 parts (0 on the bottom side), 3 nets, no tracks yet.
