eSpark-Backup/colebenson-smartmotors/Documents/Client-Shared-Files/Sharing-13042021/PRO-PCB-V2 - Incomplete/PRO Voltage Regulation/5V-3.3V Regulators (Pre-prototype V2).brd

## EAGLE design Documents/Client-Shared-Files/Sharing-13042021/PRO-PCB-V2 - Incomplete/PRO Voltage Regulation/5V-3.3V Regulators (Pre-prototype V2).brd (2021-07-02)

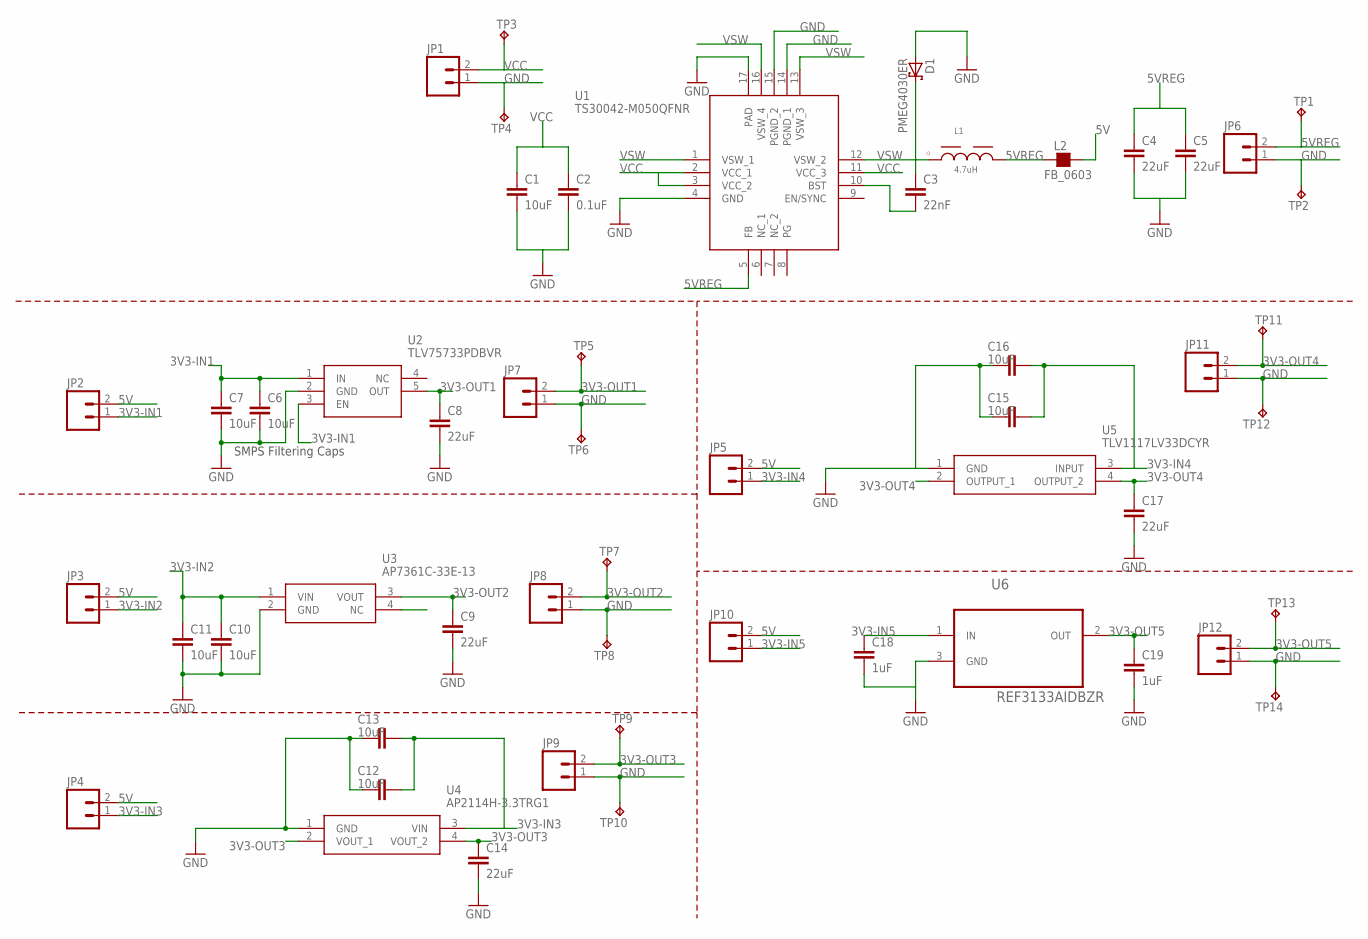
[picture p167: schematic 5V-3.3V Regulators (Pre-prototype V2).sch]

Parts:
C1: 10uF; 1206
C2: 0.1uF; 0603-CAP
C3: 22nF; 0402-CAP
C4, C5, C8, C9, C14, C17: 22uF; 0805
C6, C7, C10, C11, C12, C13, C15, C16: 10uF; 0805
C18, C19: 1uF; 0805
D1: PMEG4030ER; SOD123W
JP1, JP2, JP3, JP4, JP5, JP6, JP7, JP8, JP9, JP10, JP11, JP12: M02PTH; 1X02
L1: 4.7uH; WE-PD2_5848/5820
L2: FB_0603; L0603
TP1, TP2, TP3, TP4, TP5, TP6, TP7, TP8, TP9, TP10, TP11, TP12, TP13, TP14: TP-040
U1: TS30042-M050QFNR; QFN16
U2: TLV75733PDBVR; SOT95P280X145-5N
U3: AP7361C-33E-13; SOT230P700X165-4N
U4: AP2114H-3.3TRG1; SOT230P700X180-4N
U5: TLV1117LV33DCYR; SOT230P700X180-4N
U6: REF3133AIDBZR; SOT95P237X112-3N

Connections:
3V3-IN1: C6.1, C7.1, JP2.1, U2.1 (IN), U2.3 (EN)
3V3-IN2: C10.1, C11.1, JP3.1, U3.1 (VIN)
3V3-IN3: C12.1, C13.1, JP4.1, U4.3 (VIN)
3V3-IN4: C15.1, C16.1, JP5.1, U5.3 (INPUT)
3V3-IN5: C18.1, JP10.1, U6.1 (IN)
3V3-OUT1: C8.1, JP7.2, TP5.1, U2.5 (OUT)
3V3-OUT2: C9.1, JP8.2, TP7.1, U3.3 (VOUT)
3V3-OUT3: C14.1, JP9.2, TP9.1, U4.2 (VOUT_1), U4.4 (VOUT_2)
3V3-OUT4: C17.1, JP11.2, TP11.1, U5.2 (OUTPUT_1), U5.4 (OUTPUT_2)
3V3-OUT5: C19.1, JP12.2, TP13.1, U6.2 (OUT)
5V: JP2.2, JP3.2, JP4.2, JP5.2, JP10.2, L2.2
5VREG: C4.1, C5.1, JP6.2, L1.2, L2.1, TP1.1, U1.5 (FB)
GND: C1.2, C2.2, C4.2, C5.2, C6.2, C7.2, C8.2, C9.2, C10.2, C11.2, C12.2, C13.2, C14.2, C15.2, C16.2, C17.2, C18.2, C19.2, D1.2 (A), JP1.1, JP6.1, JP7.1, JP8.1, JP9.1, JP11.1, JP12.1, TP2.1, TP4.1, TP6.1, TP8.1, TP10.1, TP12.1, TP14.1, U1.4 (GND), U1.14 (PGND_1), U1.15 (PGND_2), U1.17 (PAD), U2.2 (GND), U3.2 (GND), U4.1 (GND), U5.1 (GND), U6.3 (GND)
unnamed: C3.2, U1.10 (BST)
VCC: C1.1, C2.1, JP1.2, TP3.1, U1.2 (VCC_1), U1.3 (VCC_2), U1.11 (VCC_3)
VSW: C3.1, D1.1 (K), L1.1, U1.1 (VSW_1), U1.12 (VSW_2), U1.13 (VSW_3), U1.16 (VSW_4)

Notes on the sheet:
SMPS Filtering Caps
