eSpark-Backup/colebenson-smartmotors/Documents/Client-Shared-Files/Sharing-13042021/PRO-PCB-V2 - Incomplete/PRO Voltage Regulation/5V-3.3V Regulators (Pre-prototype V2).brd

## EAGLE design Documents/Client-Shared-Files/Sharing-13042021/PRO-PCB-V2 - Incomplete/PRO Voltage Regulation/5V-3.3V Regulators (Pre-prototype V2).brd (continued)

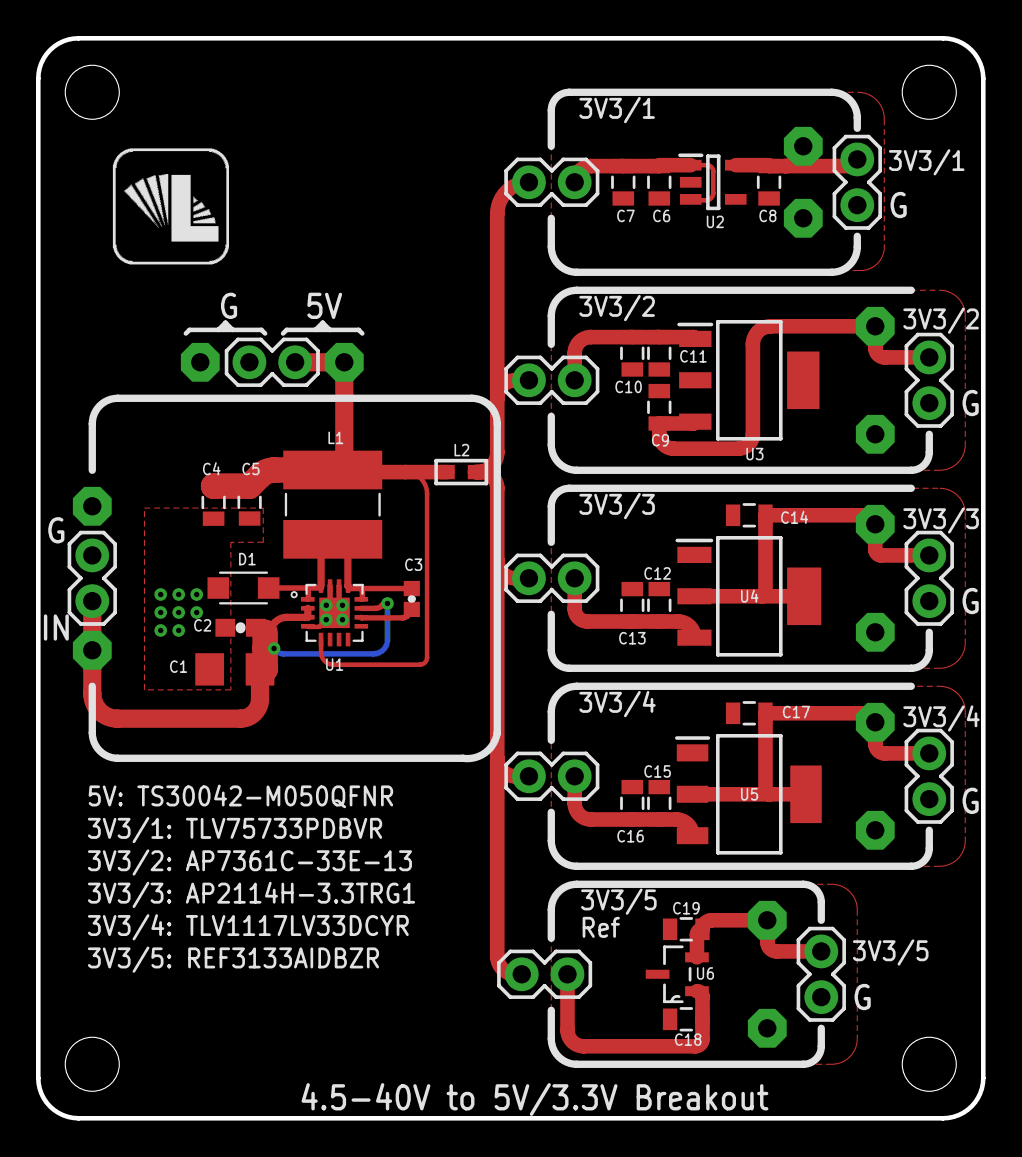
[picture p168: board 5V-3.3V Regulators (Pre-prototype V2).brd from above]

Board: 2 copper layers, 52.5 x 60.0 mm, 54 parts (0 on the bottom side), 16 nets.
