eSpark-Backup/colebenson-smartmotors/(commit log)

2021-07-02 Added EEPROM Circuitry in Schematic Design
2021-07-02 Changes in PCB Design for EEPROM.
2021-07-06 Changes made in CAN circuit
2021-07-06 CAN circuitry updated.
2021-07-07 CAN Changes in PCB.
2021-07-08 Corrected some errors in schematic; Some are left open in Issues section of the Repo
2021-07-09 Top Board DigiKey BOM added.
2021-07-10 CAN changes implemented in PCB. All production files created.
2021-07-13 Top board LCSC BOM added
2021-07-13 Library Review
    2 Parts footprint addition
    - VT1H471MI135000CE0
    -MAX4236EUT+T
2021-07-13 Both footprints changed and New Gerber, NC Drill and Pick n Place file created for Top PCB.
2021-07-15 Bottom LCSC BOM updated
2021-07-21 Changed RGB LED Signal Pin on Controller
2021-07-24 Latest Digikey BOM
    TOP PCB and Bottom PCB
2021-07-26 CAN circuitry updated and I2C pins changed.
2021-07-26 Generated Updated PDFs for Bottom and Top PCB
2021-07-28 Bottom PCB BOMs updated according to the recent schematic changes.
2021-07-28 Parts and connections updated on bottom board PCB.
2021-07-29 design and PCB modified by Electron Ali. Deliverables also created.
2021-07-29 CAN connections swapped; Changes updated to PCB; Extra folders added to .gitignore
2021-07-29 Generated PDFs for Top and Bottom Boards
2021-07-29 Top Board extra files added to .gitignore
2021-07-29 Cottom board deliverables and Design files updated according to the recent CAN Netlabel changes.
2021-08-02 Latest Digikey BOM
    Top or Bottom Both.
2021-08-03 C15 and C20 changed to 0.1uF/100V (CC0603KRX7R0BB104). Schematic, lib, PCB and BOM updated.
2021-08-06 Latest Files>>>> TOP Board JST Connector J4 Changes completed Schematic ,Library ,and PCB. @Electronali @mars-virgo Please review the changes in PCB.
2021-08-06 Changes in Top PCB Done. All Production and Necessary files are created.
2021-08-06 Connector J4 changed in BOM as listed in issue #14
2021-10-07 J3, P2, P2 and C1 updated in PCB and schematic
2021-11-16 #15 26 in Connector add kr dia ha
2021-11-25 Schematic Additions in Board-Board Connector and EEPROM IC; Power Section Hardware Designed
2021-11-25 Saving Design Files as per schematic changes
2021-11-26 12V & 5V regulators changed. adjustable regulator updated.
2021-11-27 Schematic changes indicated in Issue #18, #19 and #20 (Closed)
2021-11-27 Schematic Compiled
2021-11-27 U4 input changed to 12V
2021-11-27 Header added in Bottom board for external OTP programming issue #22
2021-11-27 2 pin header added added in library
2021-11-27 2 Pin header added
2021-11-27 Header replaced and solder bridges added acc to issue #22 and #23
2021-11-27 Power nets changed and PCB updated. Fresh PDF created.
2021-11-28 Minor changes in Bottom Board; unused netlabel VUSB_5V changed to VCC_5V
2021-11-29 Routing of Top and Bottom board(bottom board incomplete)
2021-11-30 Routing of top board completed
2021-11-30 Header ,Tantalum Cap ,Regulator footprint review ho gaya ha
2021-11-30 Top Board PCB Review and minor corrections done.
2021-12-01 Reviewed Parts of Library updated in schematic and pcb as well
2021-12-02 BOM Changes Completed Client BOM Bana dia ha TOP ,BOttom PCB ka
2021-12-13 SB changes updated in PCB
2021-12-14 Client and LCSC BOM updated issue #28
2021-12-14 SB Connections updated in TOP PCB.
2021-12-14 Changes in Routing of Top and Bottom PCB of Cole.
2022-01-08 All changes in #35. PCB updated.
2022-01-10 Routing in Top PCB.
2022-01-28 Power section updated #39
2022-01-28 #38 (VEJ102M1ETR-1316) capacitor 3d Model add in library
2022-01-29 Power section changed in top board #41. PDF creataed.
2022-01-31 Power section completed #41. Fresh PDF generated.
2022-02-01 3.3V LED added. Fresh PDF generated. Refer to #45 for details
    All required connections updated.
2022-02-01 22uH inductor replaced in Power section #44
2022-02-05 Encoder Noise Charts uploaded
2022-02-07 Ferrite beads added in schematic and library issue #48
2022-02-07 Bottom board FB connections corrected #48
2022-02-10 unused MCU pins pulled down. TI regulator circuit added but incomplete (Decision pending) issue #52 #50
2022-02-15 All parts replaced in schematic #54
2022-02-16 J3 replaced in both boards
2022-02-16 isolated buck converter added, issue #47
2022-02-17 Regulator outputs updated, isolated coverter completed, gnds separated in all sheets.
2022-02-17 MCU and Motor signals Isolated.
2022-02-22 GNDs isolated, signals corrected and errors removed #47
2022-02-22 PCB Routing acc #62 (not completed)
2022-02-22 Generated step files of Top board
2022-02-23 Routing of SM_Top_V2 acc #62 some route of Power remaining
2022-02-24 Replaced switches with headers Issue #64
2022-02-24 PCB Routing done(errors remaining)
2022-02-24 PCB Routing completed #62 (errors and Warning remains)
2022-02-25 PCB routing completed acc #62
2022-02-26 Minor changes in PCB. Refer to #70
2022-02-28 Minor changes in SM_Bottom_PCB after review. Refer to #73 PCB Designing -Review of routing of SM_Bottom_PCB #73
2022-03-01 Both schematics formatted. C45 & C47 added. PCB updated. #75 #76
2022-03-03 Minor Changes in PCB after Review. Refer to #70 for progress.
2022-03-03 Design PDFs generated (both boards)
2022-03-05 Changes in Bottom PCB due to Review. Refer to #78
2022-03-05 History and Preview folders deleted after Review of Both PCB's.
2022-03-08 Pick and Place Files generated for both top and bottom board #79 (Step file remaining for bottom board
2022-03-11 Top Board Schematic Review (Pending)
2022-03-12 minor changes done in bottom board issue #73 done
2022-03-15 J1 replaced #83 PCB updated.
2022-03-19 #90 completed.PCB updated.
2022-03-24 #93 Top board Completed #92 bottom board incomplete
2022-03-29 Alternate added for ESD diodes and X2 #95
2022-03-30 #97 resolved. PCB updated.
2022-03-31 PCB Updated acc to #98 and deliverables generated (#85) for top board
2022-04-01 Revert "Schematic review"
2022-04-01 #100 completed. Top PCB updated.
2022-04-01 Fresh Deliverables generated for both Top and Bottom Boards. Changes done acc to #103 and #99
2022-04-02 U4 changed in bottom board. #103
2022-04-06 @channel Extra BOM Move to OLD BOM Folder
2022-04-06 Fresh Deliverables generated for bottom board and PDF generated for both board #106
2022-04-06 18ebcbc7 - Fresh DXF, DWG, 3D PDF and Step file for both Top and Bottom Boards generated.file.
2022-04-07 @faizi968 @UroojNav Latest Step file Generate kr di ha
2022-04-07 Fresh deliverables created for both Top and Bottom Boards after removing client's mechanical queries.
2022-04-27 Latest Deliverables generated for both Top and Bottom Boards.
2022-04-29 NC_Drill and Gerber Files Generated for Both both board
2022-07-22 Top and Bottom board parts updated
2022-08-05 Minor changes in Client BOM
2022-08-12 Fresh Deliverables of Top board after changes #133
2022-08-12 BOM Economization #135
2022-08-14 BOM Econozmiation (In progress) #135
2022-08-15 @faizi968 TOP BOM Updated.
2022-08-15 BOM Economization (Complete) #135
2022-08-17 30-12V Buck Converter Design changes
2022-08-18 BOM and schematic changes #135
2022-08-19 Library - Ref BOM - Schematic Changes #135 #137
2022-08-19 Bottom Board BOM Economization Format
2022-08-20 Top board BOM review (in progress)
2022-08-21 220nF capacitor part number merged
2022-08-21 Top Board BOM review (Complete);
2022-08-21 Top Board BOM finalized
2022-08-21 L3 Inductor footprint missing issue resolved
2022-08-21 Minor BOM formatting
2022-08-21 Bottom Board BOM Economization #135 (in progress)
2022-08-21 Bottom board BOM Economization #135 (Complete)
2022-08-24 Routing completed of top board #138
2022-08-24 BOM Economization for Bottom Board #135
2022-08-24 Schematic changes for Bottom Board #135
2022-08-24 BOM changes after schematic redesign
2022-08-24 Top board 0.1uF caps added in BOM
2022-08-24 LED Glass pipe link added
2022-08-24 MCU variants added in Bottom Board BOM
2022-08-24 Minor BOM correction
2022-08-25 Bottom board completed #141
2022-08-25 LED Glass pipe link corrected #143
2022-08-31 Updated top board and deliverables.
2022-09-06 Generated fresh deliverables for both Top and Bottom Boards #150
2022-09-07 J11 added to Top board BOM
2022-09-21 Supplier BOM (20_TopBoards) complete
2022-09-21 Supplier BOM (20_BottomBoards) complete
2022-09-21 Supplier BOM preparation
2022-09-21 BOM formatting
2022-09-21 Supplier BOM top board formatting
2022-09-22 LSM6DSL added to schematic #151
2022-09-22 BOM changes done (supplier and eSpark) #151
2022-09-22 Changes in PCB done #151 for details.
2022-11-11 #152 Capacitor C1 Updated In PCB and Deliverables Generated.
2023-01-04 corrections in supplier BOM
2023-01-27 #158 changes updated in bottom board
2023-01-30 #158 Deliverables generated for Bottom Board
2023-01-30 #159 Bottom Board BOM Updated
2023-02-15 #158 Fresh deliverables generated for Top Board
2023-02-15 Some Routes updated in Top board
2023-05-05 filter caps changed #160
2023-05-05 sense resistor value changed #160
2023-05-07 #160 In-progress: Connectors adjusted: Routing in process.
2023-05-08 #160 Completed: PCB Review done.
2023-05-10 #160 2.2nf Cap and 50mR resistor added in BOM
2023-05-10 #160 Supplier BOM Edit
2023-05-29 step files of PCB #161
2023-05-30 #160 Done: Alignment of Connectors resolved.
2023-05-30 Gerber's, Pick n Place and BOM folders moved to Design Files from Deliverables folder.
2023-06-12 Connectors J2, J5 changed in schematic: #160 In-Progress.
2023-06-20 XT60 connector added
2023-06-21 #160 Ethernet connector - Solder Bridges removed - Motor Connector changed - Boot header changed
2023-06-23 #160 In-progress: Changes for FB3 and FB4 in Bottom Board.
2023-06-23 #160 Changes in Bottom and Top Board PCB for Stepper Connector.
2023-06-26 #160 Changes in Bottom Board for SB1 and U6.
2023-06-28 #160 Done for Bottom Board: U4, U6 and Connector Cutout updated.
2023-07-03 @MarsVirgo XT60 connector Pitch Corrected
2023-07-03 #160 Changes in Top and Bottom Board PCB for P1, P2, J2 and J5.
2023-07-05 #160 In-progress: Changes in Top Board for Diodes D4, D5, D7, D10 and R14, R16.
2023-07-06 #18 CRS01(TE85L,Q,M) Diode footprint edited
2023-07-06 #18 J3 Bottom Board J1 Top Board Keepout area remove in library
2023-07-06 #18 in eSpark Hardware Switches Added
2023-07-06 #160 Changes for connectors and Diodes in both Top and Bottom PCB.
2023-07-06 #160 Changes in Bottom Board finalized.
2023-07-06 #160 Done: SW1 and 5V LED moved to new location.
2023-07-07 #160 Corrections in Routing done in Bottom Board: MH's and Connector location also verified.
2023-07-07 #160 Done: Corrections in Routing of Top Board done: Old Gerbsers and Pick n Place files deleted for Top and Bottom Board.
2023-07-16 #160 Changes in PCB for P1 and P2 done: For J4 and J11 Remaining.
2023-07-16 #160 Corrections for Stepper and XT60 connectors done: Corrections for Boot Header remaining.
2023-07-17 #18 JST Connector added
2023-07-17 #160 J6 Updated in both schematic and PCB.
2023-07-17 #160 Footprint updated in Top Board PCB after 3D body update
2023-07-18 #162 U10 Footprint Edited
2023-07-19 Schematic changes (summary in #160)
2023-07-20 changes updated in PCB as mention in #160 for top board And D1 removed from PCB in Bottom Board
2023-07-20 #160 Minor corrections in Routing: Un-tented Via's are tented now in Bottom Board PCB.
2023-07-21 #160 Designators and Text size edited and Fills added for GND.
2023-07-21 #160 BOM Update completed
2023-07-21 #160 J6 Adjusted: Mechanical 3 layer deleted from Top Board PCB.
2023-07-21 #160 Latest 3D Renderings and Step file of both Top and Bottom Boards created.
2023-07-27 #67 Switch and JST added
2023-07-27 #163 Sub Board Schematics
2023-07-27 Schematic doc added and renamed #163
2023-07-28 #163 PCB File added for Sub_Boardv3.3.
2023-07-31 #163 PCB Design Sub_Board
    PCB Design Sub_Board
2023-08-02 #163 PCB reviewed and changes done accordingly, Deliverables generated
2023-08-02 #163 Changes in Sub Board PCB done: Fresh Gerbers and Pick n Place remaining.
2023-08-02 #163 BOM Completed.
2023-08-02 #160 Fresh Deliverables of Top and Bottom Board generated and updated on Github.
2023-08-03 #163 Fresh Deliverables of Sub Board created: Folders name corrected.
2023-08-03 Bottom Board BOM updated #160
2023-08-04 #163 Fresh Deliverables generated for Sub Board.
2023-09-21 #164 JST and Capacitor added
2023-09-21 #164 JST Connector 3d Model Added
2023-09-22 Top BOard BOM CHanges Completed.
2023-11-16 Button schematic pin corrected.
2023-11-16 #163 Fresh Deliverables done: Corrections in schematic symbol of PCM12SMTR
2023-11-22 #167 Rotary Encoder IC's symbol added "AEAT-9955"
2023-11-22 #167 Pin 33 added for AEAT-9955
2023-11-23 #167 New Regulator and Encoder ICs Added
2023-11-23 #167 AEAT-9955-102 IC footprint updated
2023-11-24 #167 Changes in Bottom PCB done: Fresh Deliverables generated.
2023-11-24 #167 In-progress for Top Board PCB.
2023-11-27 #167 Resistor , cap and Inductor added
2023-11-28 Newest Regulator IC added
2023-11-28 #167 Newest Regulator IC added
2023-11-28 #167 Routing Done and Fresh Deliverables generated for Top Board.
2023-11-29 #167 Modifications in Routing: Fresh Deliverables generated for Top-Board-v3.4.
2023-11-29 #167 Modification in routing: Fresh Deliverables generated for Bottom-Board-v3.4.
2023-12-08 #167 Changes in Split planes on Top Board-v3.4.
2023-12-14 #167 Unidirectional Isolators changed. TVS/ESD added on power lines, SPI, Driver step direction enable pins
2023-12-20 #168 Bottom Board eSpark BOM for 20 Boards Updated.
2023-12-21 #168 Top Board eSpark BOM updated
2023-12-21 #168 D20,D21 Schematic Symbol Updated.
2023-12-21 #168 U4 Footprint Edited Bottom Board
2023-12-21 #167 Changes in Top and Bottom Board.
2023-12-22 #167 top board Routing completed and Deliverables generated for bottom Board
2023-12-22 #167 Minor corrections in routing of Top Board and Layer Stackup changed for both Top and Bottom Board-v3.4.
2023-12-24 #167 Updated Gerbers.
2023-12-24 #167 Updated files with Latest Renderings for Top Board-v3.4.
2023-12-26 #169 IC And resistor added
2023-12-26 #167 MAX31865 PT100 temperature sensor IC added
2023-12-27 #169 Mosfet Added
2023-12-27 #167 Soft Start Circuit added
2023-12-27 #167 Routing and placement in-progress in Top Board-v3.4.
2023-12-29 #167 Changes in Routing of both Top and Bottom Boards-v3.4.:
2024-01-03 #167 Routing completed: Finishing remaining for Top Board-v3.4.
2024-01-04 #167 Routing updated in Bottom Board-v3.4.
2024-01-05 #167 Top Board BOM Updated
2024-01-05 #167 Changes in Bottom Board-v3.4 Routing.
2024-01-05 #167 TOP and Bottom Board eSpark BOM Updated.
2024-01-09 Changes in schematic and PCB for TLE5012BE1000 Encoder: Changes in Routing in-progress.
2024-01-10 #167 Changes in Schematics done and changes in PCB remaining for Encoder and PT100 Sensor:
2024-01-11 #167 Routing done for PT100 Sensor: Finishing and DRC Errors Remaining.
2024-01-12 #169 Connector overlay edited.
2024-01-13 #167 Header footprint updated: Cutout removed in Bottom Board PCB-v3.4.
2024-01-15 #167 Changes in Schematic and PCB of Bottom Board PCB.
2024-01-15 #167 Fresh Step file added in relevant folders for both Top and Bottom Board PCB-v3.4.
2024-01-15 #167 Modifications in Routing of Top Board-v3.4.
2024-01-15 Bottom board LED1 removed #167
2024-01-16 #167 Corrections in Top and Bottom Board PCBs: Old Deliverables deleted.
2024-01-16 #167 Fresh Deliverables of Sub Board after modifications in Text.
2024-01-16 #167 Fresh Renderings and step files of all three boards generated.
2024-01-16 #167 Gerbers, Pick n Place and Assembly Drawings generated for Sub Board. for Top and Bottom Board PCB's.
2024-01-16 #167 Gerbers, Pick n Place and Assembly Drawings generated for Bottom Board.
2024-01-16 #167 BOM, Gerbers, Pick n Place and Assembly Drawings generated for Top Board-v3.4.
2024-01-17 #167 Fresh Deliverables of Bottom Board generated.
2024-01-17 #167 Fresh Deliverable generated for Top Board.
2024-01-17 #169 Diode added
2024-01-17 #167 Diode for reverse polarity protection added
2024-01-17 Revert "#167 Diode for reverse polarity protection added"
    This reverts commit 96902cf09be724120534b2d72a66501fe64f0aa7.
2024-01-17 #167 Updated Deliverables of Top Board deletion of Notes from PCB.
2024-01-22 #167 Encoder connections changed to SPI3 on schematic
2024-01-22 #167 Changes in Bottom Board-v3.4 PCB against Encoder connections: Fresh Deliverables including Client BOM is generated and updated on Github.
2024-01-23 #167 Top Board Client BOM missing Part no Added
2024-01-23 #167 Sub Board Client BOM edited.
2024-01-23 #167 Bottom Board Client BOM PT100 added
2024-01-26 #167 Fresh Gerbers and NC Drill File generated for Bottom Board-v3.4 after layer stackup adjustments.
2024-01-26 #167 Fresh Gerbers and NC Drill File generated for Top Board-v3.4 after modification in Layer stackup.
2024-01-29 #167 Latest step files of Top and Bottom Boards-v3.4 created.
