eSpark-Backup/colebenson-smartmotors/(notices)

Notices in the files:
parts and their libraries:
SparkFun-Capacitors: Licensing: Creative Commons ShareAlike 4.0 International - https://creativecommons.org/licenses/by-sa/4.0
EMCComponents: Copyright: Würth Elektronik
FaBo-Supply: Released under the Creative Commons Attribution-ShareAlike 4.0 License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
rc-master-smd: Copyright (C) 2007, Bob Starr
